DocteurPCB/SDAES/hardware/aes_connector.csv

# Connecteur de cartouche AES. Signaux d'après le wiki neogeodev (page « AES cartridge pinout »)
# numérotation officielle A/B recoupée avec les cartes AES de jwestfall69 (neogeo-diag-aes-prog
# neogeo-diag-aes-cha | fabriquées et testées ; domaine public) : face « dessus » = côté composants
# = contacts A1..A50 | face « dessous » = B1..B50 ; vu côté composants | contacts vers le bas | A1 et
# B1 sont à droite | l'un derrière l'autre (sérigraphie « A1 » des cartes SNK NEO-AEG).
# Signaux actifs à 0 sans le préfixe /.
carte | face | position | signal
PROG | dessus | 1 | GND
PROG | dessus | 2 | GND
PROG | dessus | 3 | D0
PROG | dessus | 4 | D1
PROG | dessus | 5 | D2
PROG | dessus | 6 | D3
PROG | dessus | 7 | D4
PROG | dessus | 8 | D5
PROG | dessus | 9 | D6
PROG | dessus | 10 | D7
PROG | dessus | 11 | D8
PROG | dessus | 12 | D9
PROG | dessus | 13 | D10
PROG | dessus | 14 | D11
PROG | dessus | 15 | D12
PROG | dessus | 16 | D13
PROG | dessus | 17 | D14
PROG | dessus | 18 | D15
PROG | dessus | 19 | R/W
PROG | dessus | 20 | AS
PROG | dessus | 21 | ROMOEU
PROG | dessus | 22 | ROMOEL
PROG | dessus | 23 | L_OUT
PROG | dessus | 24 | L_IN
PROG | dessus | 25 | VCC
PROG | dessus | 26 | VCC
PROG | dessus | 27 | VCC
PROG | dessus | 28 | PORTOEU
PROG | dessus | 29 | PORTOEL
PROG | dessus | 30 | PORTWEU
PROG | dessus | 31 | PORTWEL
PROG | dessus | 32 | 68KCLKB
PROG | dessus | 33 | RESET
PROG | dessus | 34 | SDPAD0
PROG | dessus | 35 | SDPAD1
PROG | dessus | 36 | SDPAD2
PROG | dessus | 37 | SDPAD3
PROG | dessus | 38 | SDPAD4
PROG | dessus | 39 | SDPAD5
PROG | dessus | 40 | SDPAD6
PROG | dessus | 41 | SDPAD7
PROG | dessus | 42 | SDPA8
PROG | dessus | 43 | SDPA9
PROG | dessus | 44 | SDPA10
PROG | dessus | 45 | SDPA11
PROG | dessus | 46 | SDPMPX
PROG | dessus | 47 | SDPOE
PROG | dessus | 48 | PORTADRS
PROG | dessus | 49 | GND
PROG | dessus | 50 | GND
PROG | dessous | 1 | GND
PROG | dessous | 2 | GND
PROG | dessous | 3 | A1
PROG | dessous | 4 | A2
PROG | dessous | 5 | A3
PROG | dessous | 6 | A4
PROG | dessous | 7 | A5
PROG | dessous | 8 | A6
PROG | dessous | 9 | A7
PROG | dessous | 10 | A8
PROG | dessous | 11 | A9
PROG | dessous | 12 | A10
PROG | dessous | 13 | A11
PROG | dessous | 14 | A12
PROG | dessous | 15 | A13
PROG | dessous | 16 | A14
PROG | dessous | 17 | A15
PROG | dessous | 18 | A16
PROG | dessous | 19 | A17
PROG | dessous | 20 | A18
PROG | dessous | 21 | A19
PROG | dessous | 22 | ROMOE
PROG | dessous | 23 | R_OUT
PROG | dessous | 24 | R_IN
PROG | dessous | 25 | VCC
PROG | dessous | 26 | VCC
PROG | dessous | 27 | VCC
PROG | dessous | 28 | ROMWAIT
PROG | dessous | 29 | PDTACK
PROG | dessous | 30 | PWAIT0
PROG | dessous | 31 | PWAIT1
PROG | dessous | 32 | SDRAD0
PROG | dessous | 33 | SDRAD1
PROG | dessous | 34 | SDRAD2
PROG | dessous | 35 | SDRAD3
PROG | dessous | 36 | SDRAD4
PROG | dessous | 37 | SDRAD5
PROG | dessous | 38 | SDRAD6
PROG | dessous | 39 | SDRAD7
PROG | dessous | 40 | SDRA8
PROG | dessous | 41 | SDRA9
PROG | dessous | 42 | SDRA20
PROG | dessous | 43 | SDRA21
PROG | dessous | 44 | SDRA22
PROG | dessous | 45 | SDRA23
PROG | dessous | 46 | SDRMPX
PROG | dessous | 47 | SDROE
PROG | dessous | 48 | 4MB
PROG | dessous | 49 | GND
PROG | dessous | 50 | GND
CHA | dessus | 1 | GND
CHA | dessus | 2 | GND
CHA | dessus | 3 | PCK1B
CHA | dessus | 4 | PCK2B
CHA | dessus | 5 | 12M
CHA | dessus | 6 | 2H1
CHA | dessus | 7 | EVEN
CHA | dessus | 8 | H
CHA | dessus | 9 | LOAD
CHA | dessus | 10 | CA4
CHA | dessus | 11 | P0
CHA | dessus | 12 | P2
CHA | dessus | 13 | P4
CHA | dessus | 14 | P6
CHA | dessus | 15 | P8
CHA | dessus | 16 | P10
CHA | dessus | 17 | P12
CHA | dessus | 18 | P14
CHA | dessus | 19 | P16
CHA | dessus | 20 | P18
CHA | dessus | 21 | P20
CHA | dessus | 22 | P22
CHA | dessus | 23 | L_OUT
CHA | dessus | 24 | L_IN
CHA | dessus | 25 | VCC
CHA | dessus | 26 | VCC
CHA | dessus | 27 | VCC
CHA | dessus | 28 | SDRD0
CHA | dessus | 29 | SDRD1
CHA | dessus | 30 | SDA0
CHA | dessus | 31 | SDA1
CHA | dessus | 32 | SDA2
CHA | dessus | 33 | SDA3
CHA | dessus | 34 | SDA4
CHA | dessus | 35 | SDA5
CHA | dessus | 36 | SDA6
CHA | dessus | 37 | SDA7
CHA | dessus | 38 | SDA8
CHA | dessus | 39 | SDA9
CHA | dessus | 40 | SDA10
CHA | dessus | 41 | SDA11
CHA | dessus | 42 | SDA12
CHA | dessus | 43 | SDA13
CHA | dessus | 44 | SDA14
CHA | dessus | 45 | SDA15
CHA | dessus | 46 | SDMRD
CHA | dessus | 47 | SDROM
CHA | dessus | 48 | 24M
CHA | dessus | 49 | GND
CHA | dessus | 50 | GND
CHA | dessous | 1 | GND
CHA | dessous | 2 | GND
CHA | dessous | 3 | FIXD0
CHA | dessous | 4 | FIXD1
CHA | dessous | 5 | FIXD2
CHA | dessous | 6 | FIXD3
CHA | dessous | 7 | FIXD4
CHA | dessous | 8 | FIXD5
CHA | dessous | 9 | FIXD6
CHA | dessous | 10 | FIXD7
CHA | dessous | 11 | P1
CHA | dessous | 12 | P3
CHA | dessous | 13 | P5
CHA | dessous | 14 | P7
CHA | dessous | 15 | P9
CHA | dessous | 16 | P11
CHA | dessous | 17 | P13
CHA | dessous | 18 | P15
CHA | dessous | 19 | P17
CHA | dessous | 20 | P19
CHA | dessous | 21 | P21
CHA | dessous | 22 | P23
CHA | dessous | 23 | R_OUT
CHA | dessous | 24 | R_IN
CHA | dessous | 25 | VCC
CHA | dessous | 26 | VCC
CHA | dessous | 27 | VCC
CHA | dessous | 28 | NC
CHA | dessous | 29 | NC
CHA | dessous | 30 | DOTA
CHA | dessous | 31 | DOTB
CHA | dessous | 32 | GAD0
CHA | dessous | 33 | GAD1
CHA | dessous | 34 | GAD2
CHA | dessous | 35 | GAD3
CHA | dessous | 36 | GBD0
CHA | dessous | 37 | GBD1
CHA | dessous | 38 | GBD2
CHA | dessous | 39 | GBD3
CHA | dessous | 40 | SDD0
CHA | dessous | 41 | SDD1
CHA | dessous | 42 | SDD2
CHA | dessous | 43 | SDD3
CHA | dessous | 44 | SDD4
CHA | dessous | 45 | SDD5
CHA | dessous | 46 | SDD6
CHA | dessous | 47 | SDD7
CHA | dessous | 48 | 8M
CHA | dessous | 49 | GND
CHA | dessous | 50 | GND
