DocteurPCB/SDAES/hardware/kicad/sdaes_cha.pdf

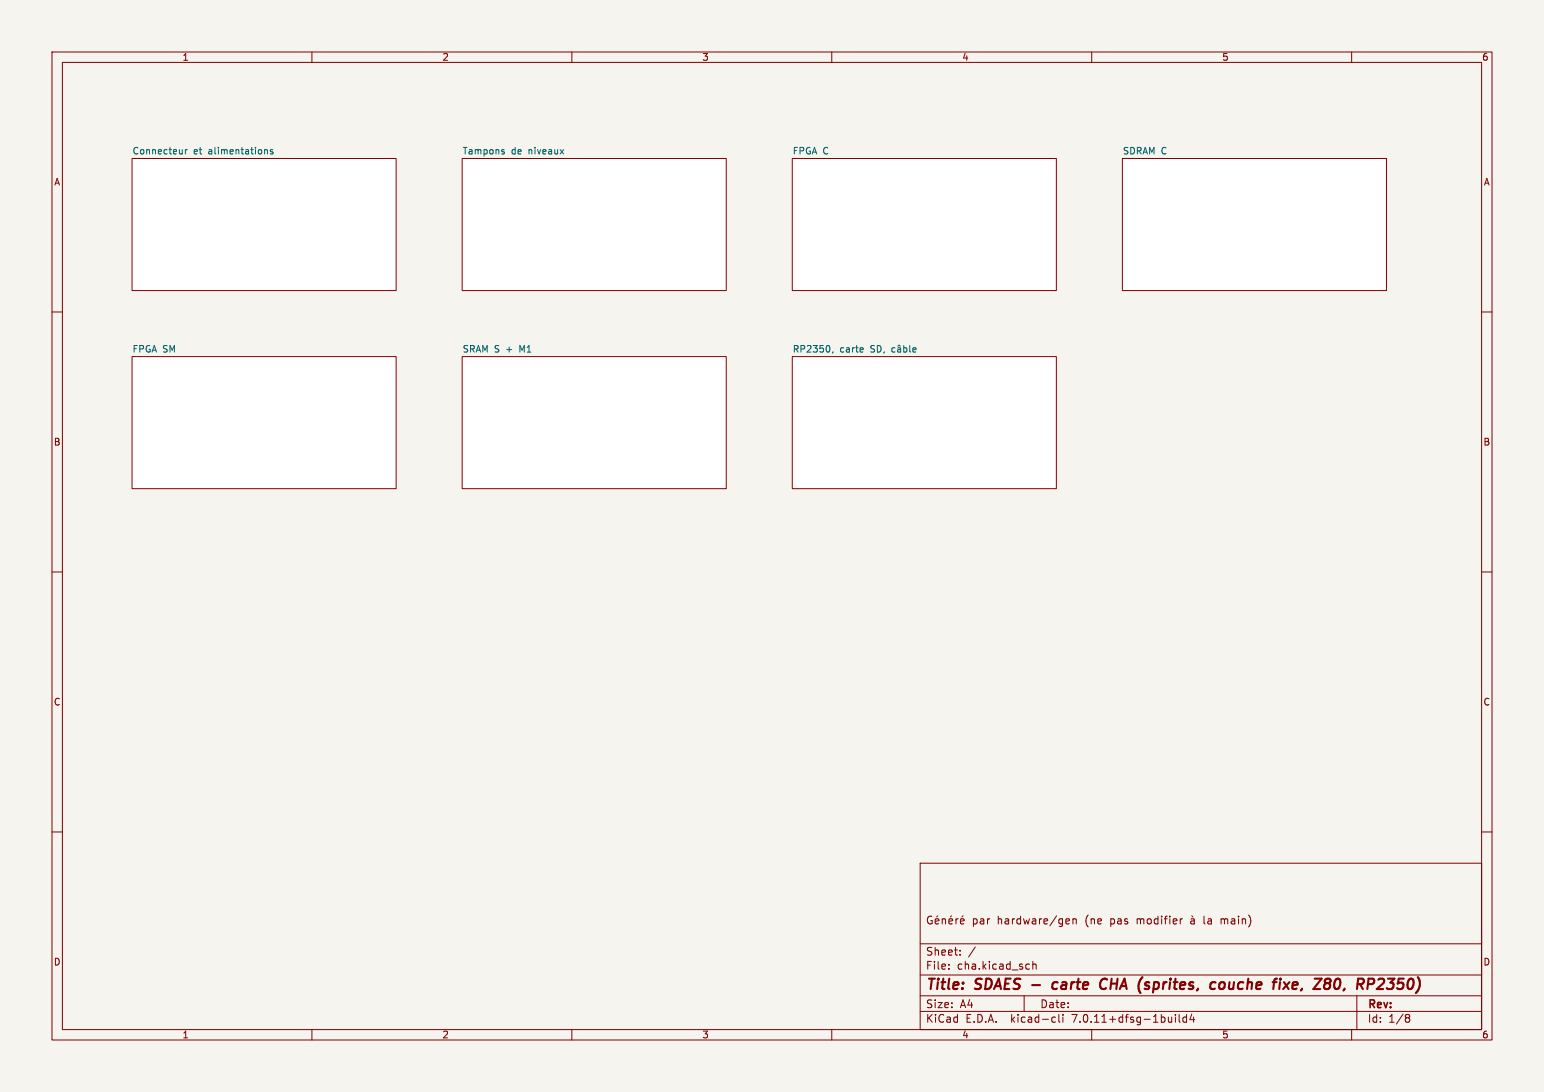
[picture p1: page 1]

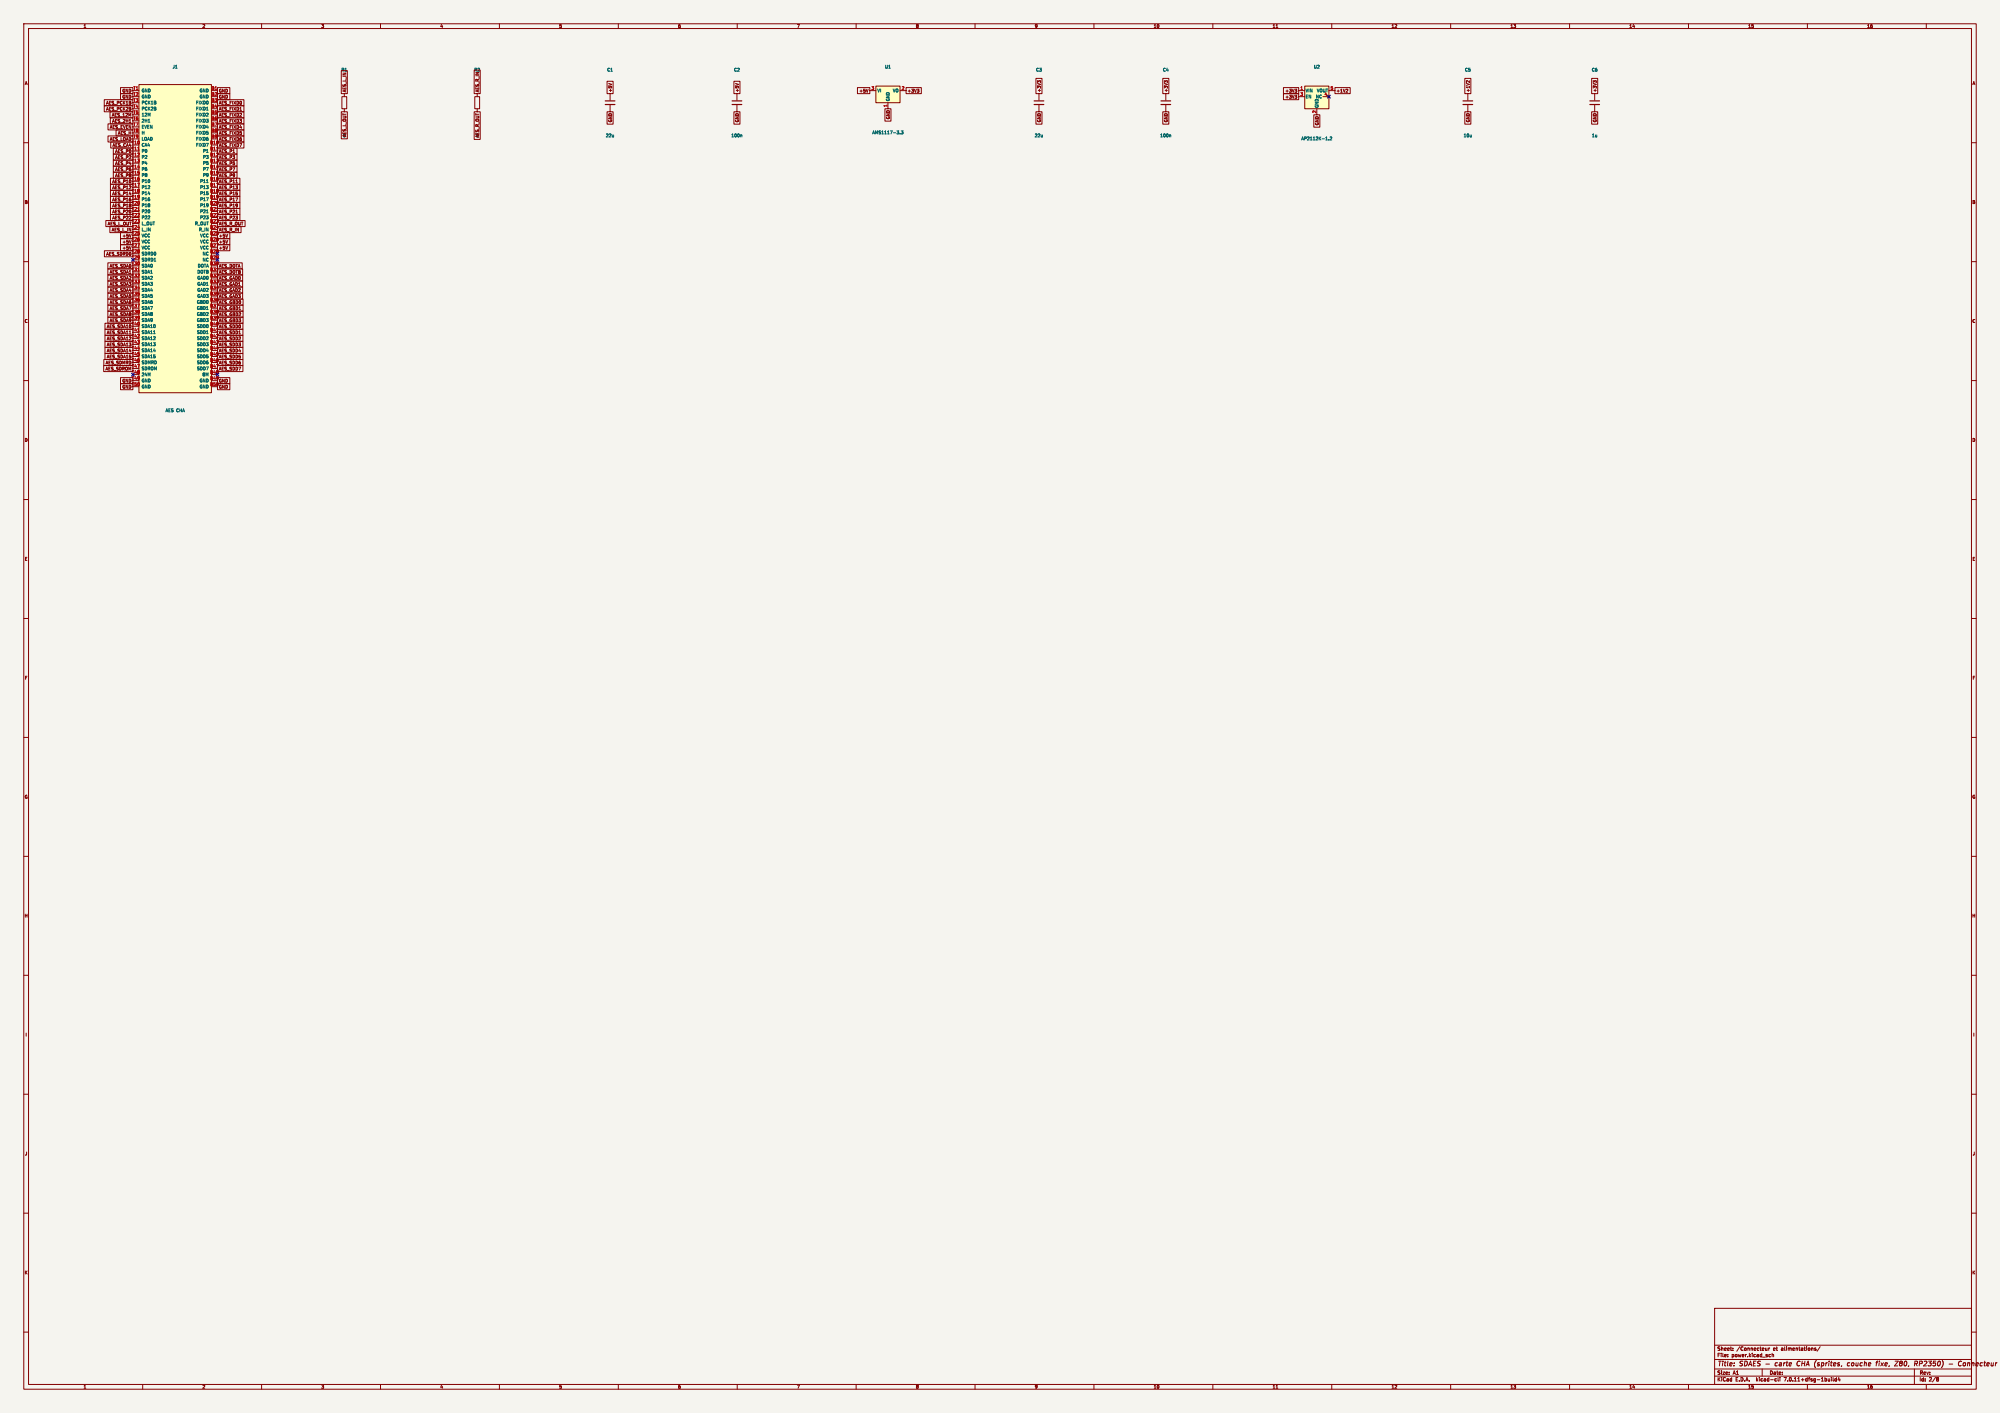
[picture p2: page 2]

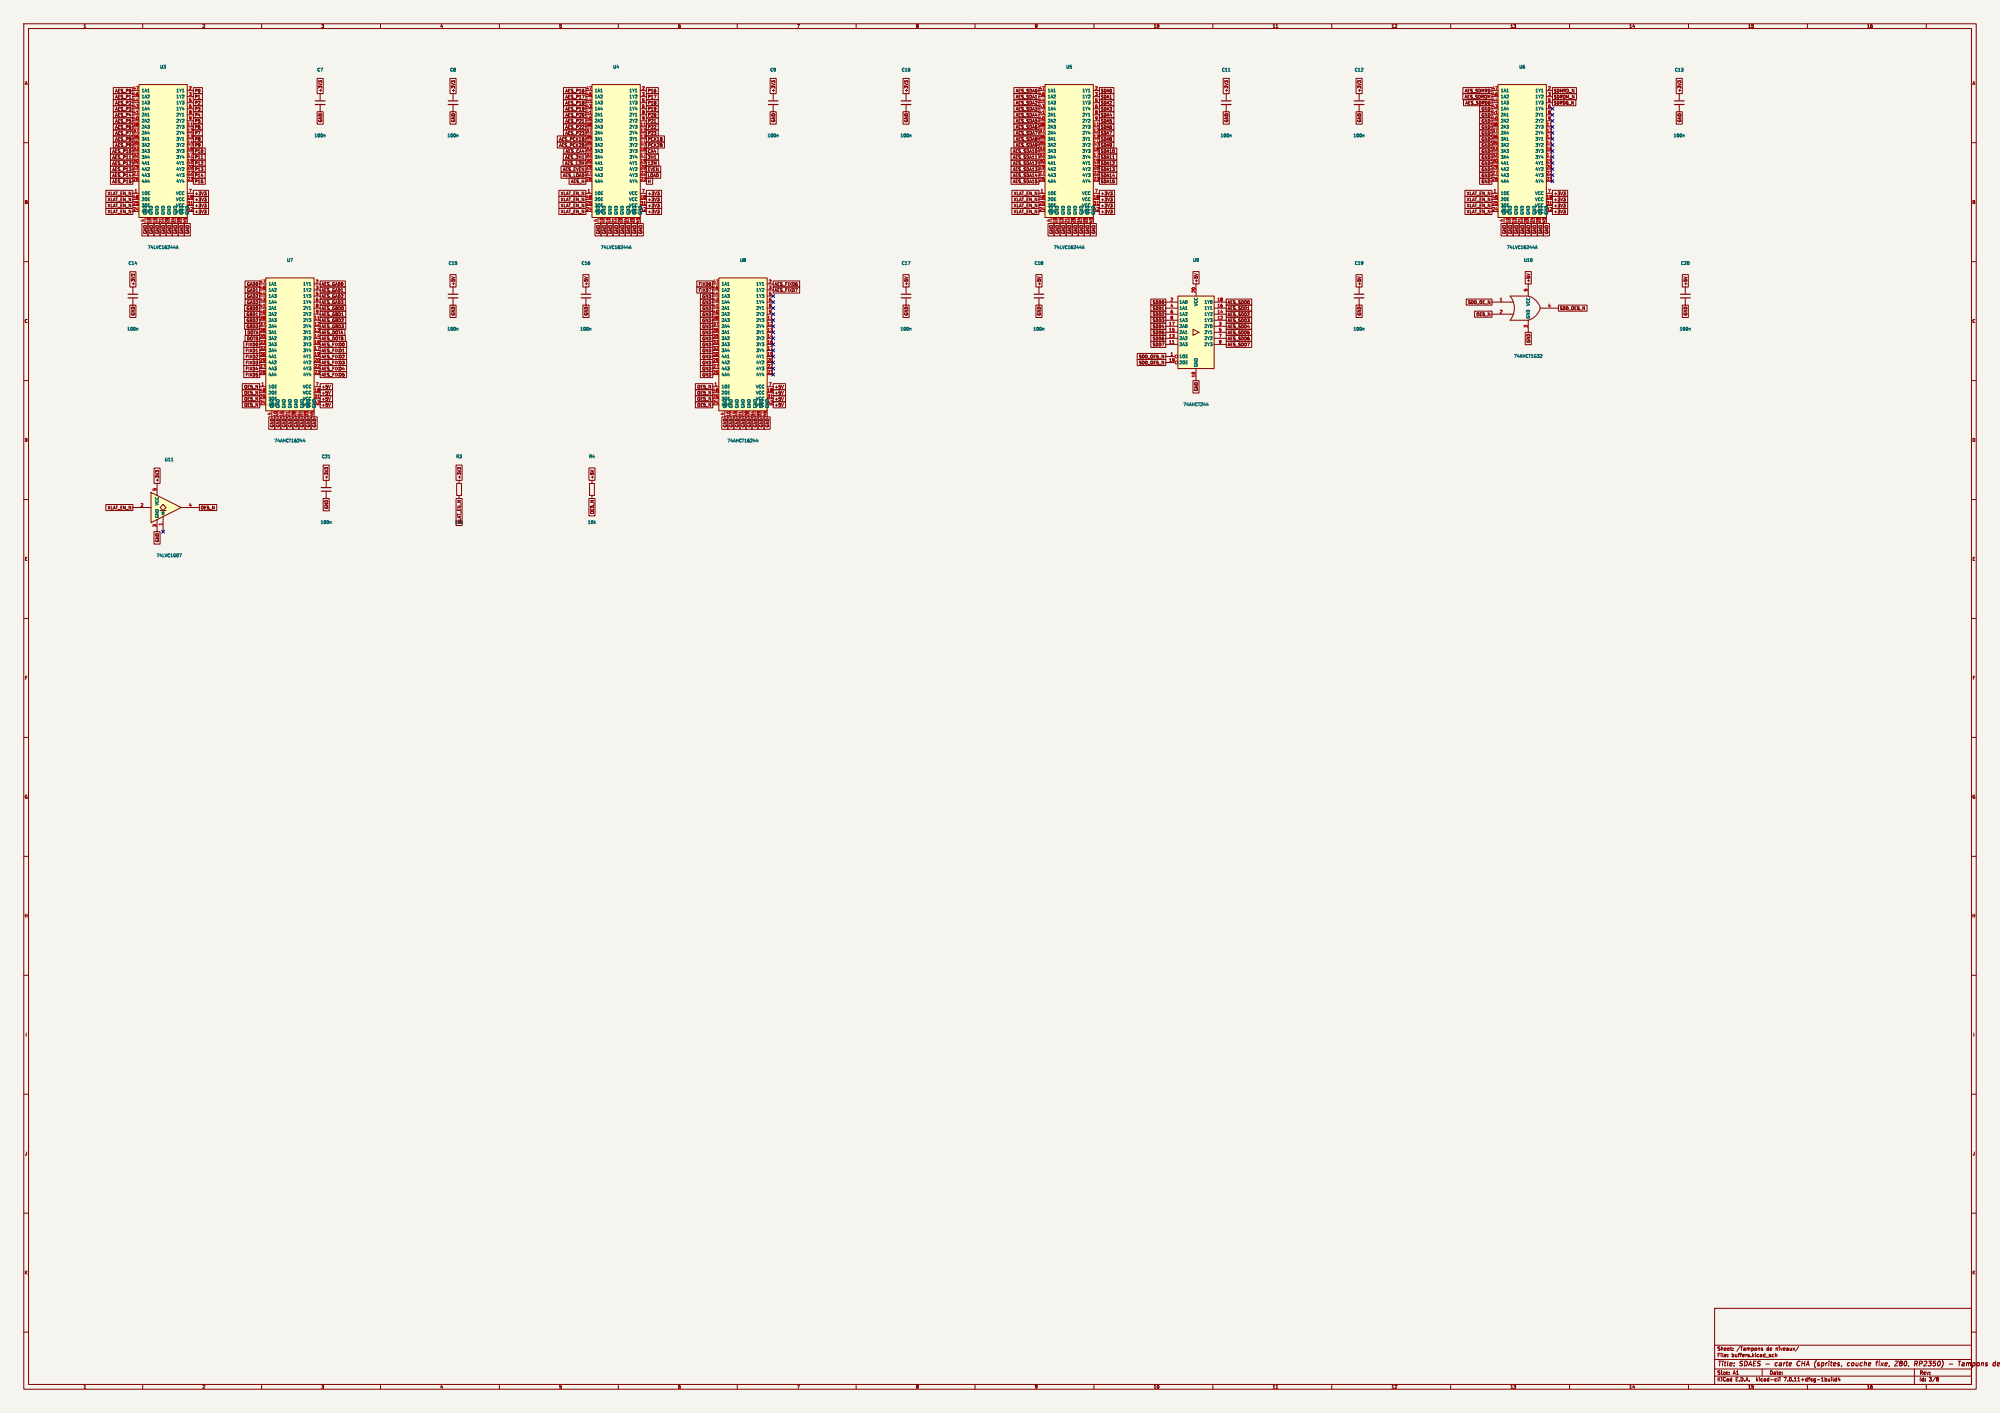
[picture p3: page 3]

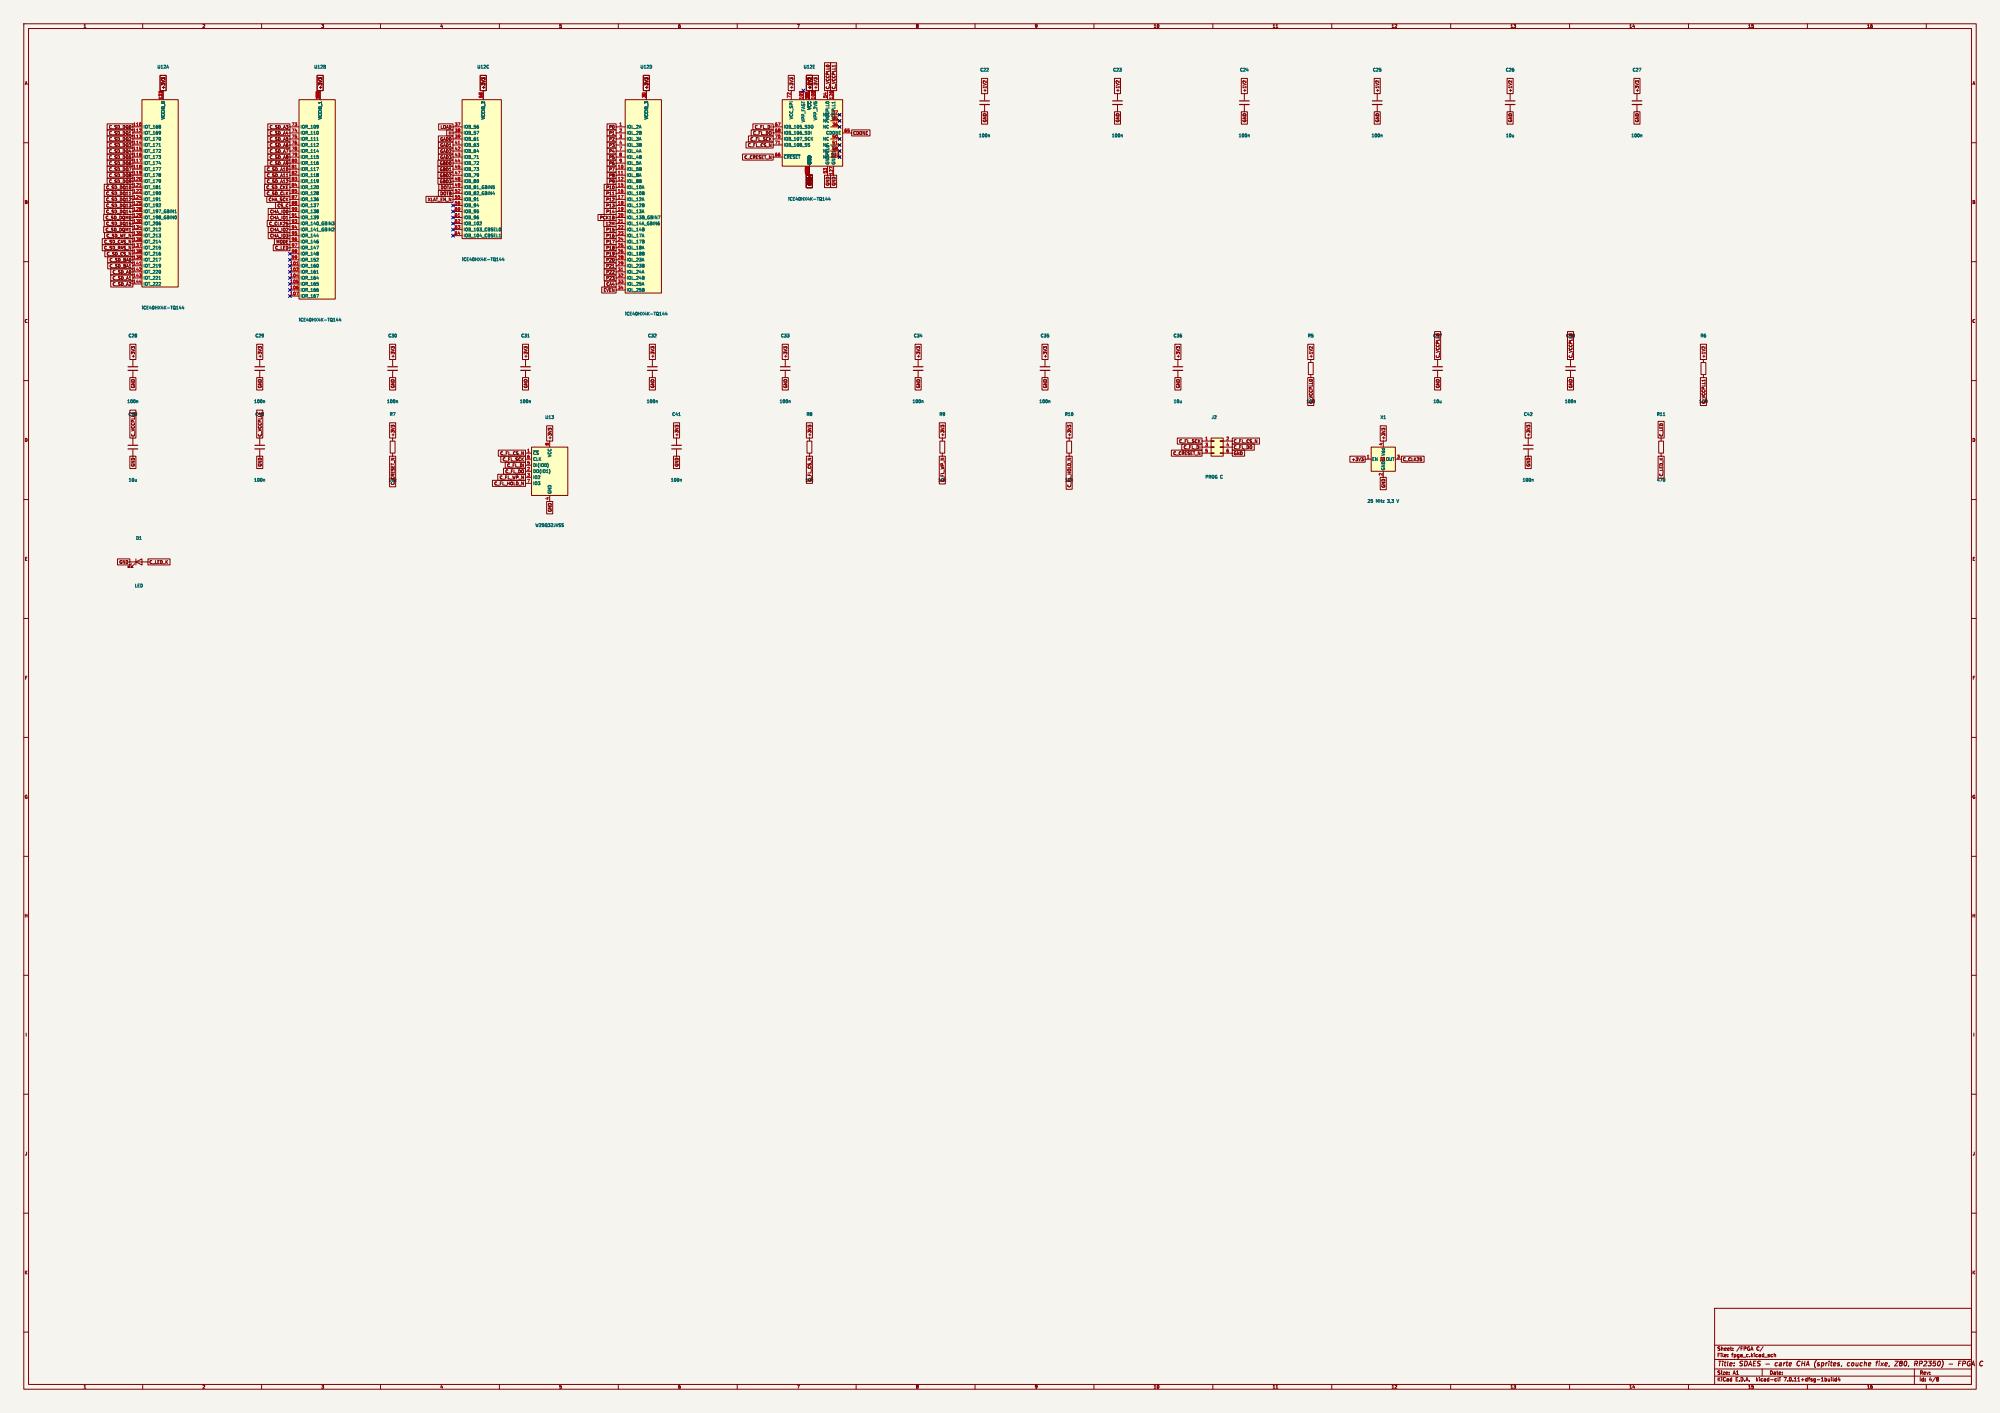
[picture p4: page 4]

8 U13 W25Q32JVSS GND 103 VPP_2V5 108 VPP_FAST 109 VCC 111 VCCPLL1 126 GNDPLL1 127 GND 13 132 NC 133 14 140 VCC 27 NC 35 NC 36 VCC 40 GND

5 NC 50 NC 51 GNDPLL0 53 VCCPLL0 54 NC 58 GND 59 CDONE

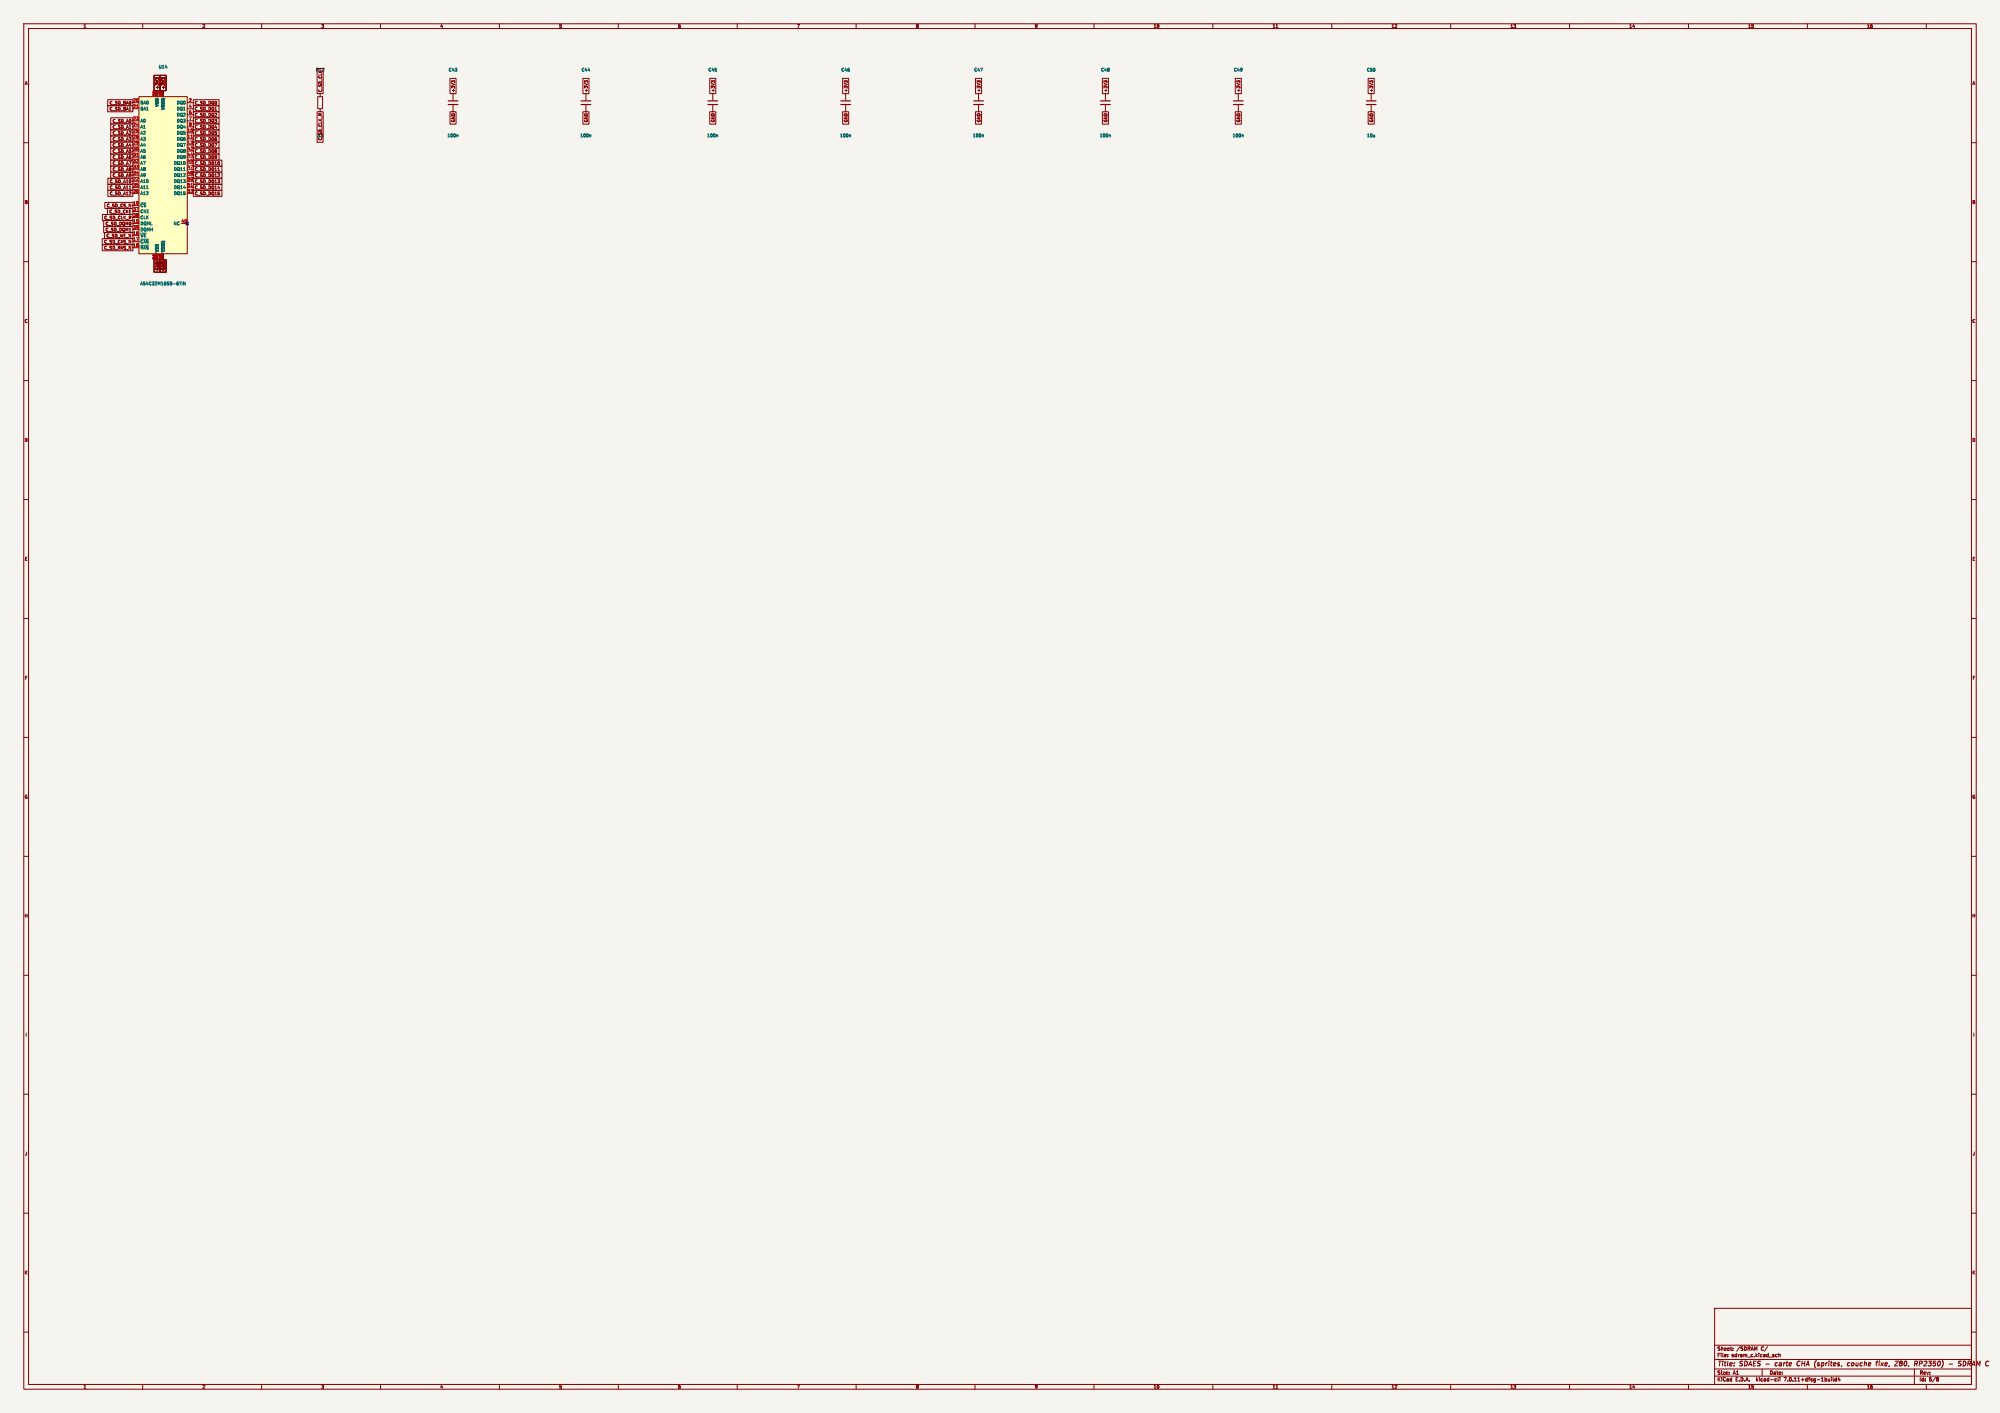
[picture p5: page 5]

1 DQ5 10 DQ6 11 VSSQ 12 DQ7 13 VDD 14 DQML 15 ~{WE} 16 ~{CAS} 17 ~{RAS} 18 ~{CS} 19 DQ0 2 BA0 20 BA1 21 A10 22 A0 23 A1 24 A2 25 A3 26 VDD 27 VSS 28 A4 29 VDDQ

3 A5 30 A6 31 A7 32 A8 33 A9 34 A11 35 A12 36 CKE 37 CLK 38 DQMH 39 DQ1 4 NC 40 VSS 41 DQ8 42 VDDQ 43 DQ9 44 DQ10 45 VSSQ 46 DQ11 47 DQ12 48 VDDQ 49 DQ2 5 DQ13 50 DQ14 51 VSSQ 52 DQ15 53 VSS 54 VSSQ

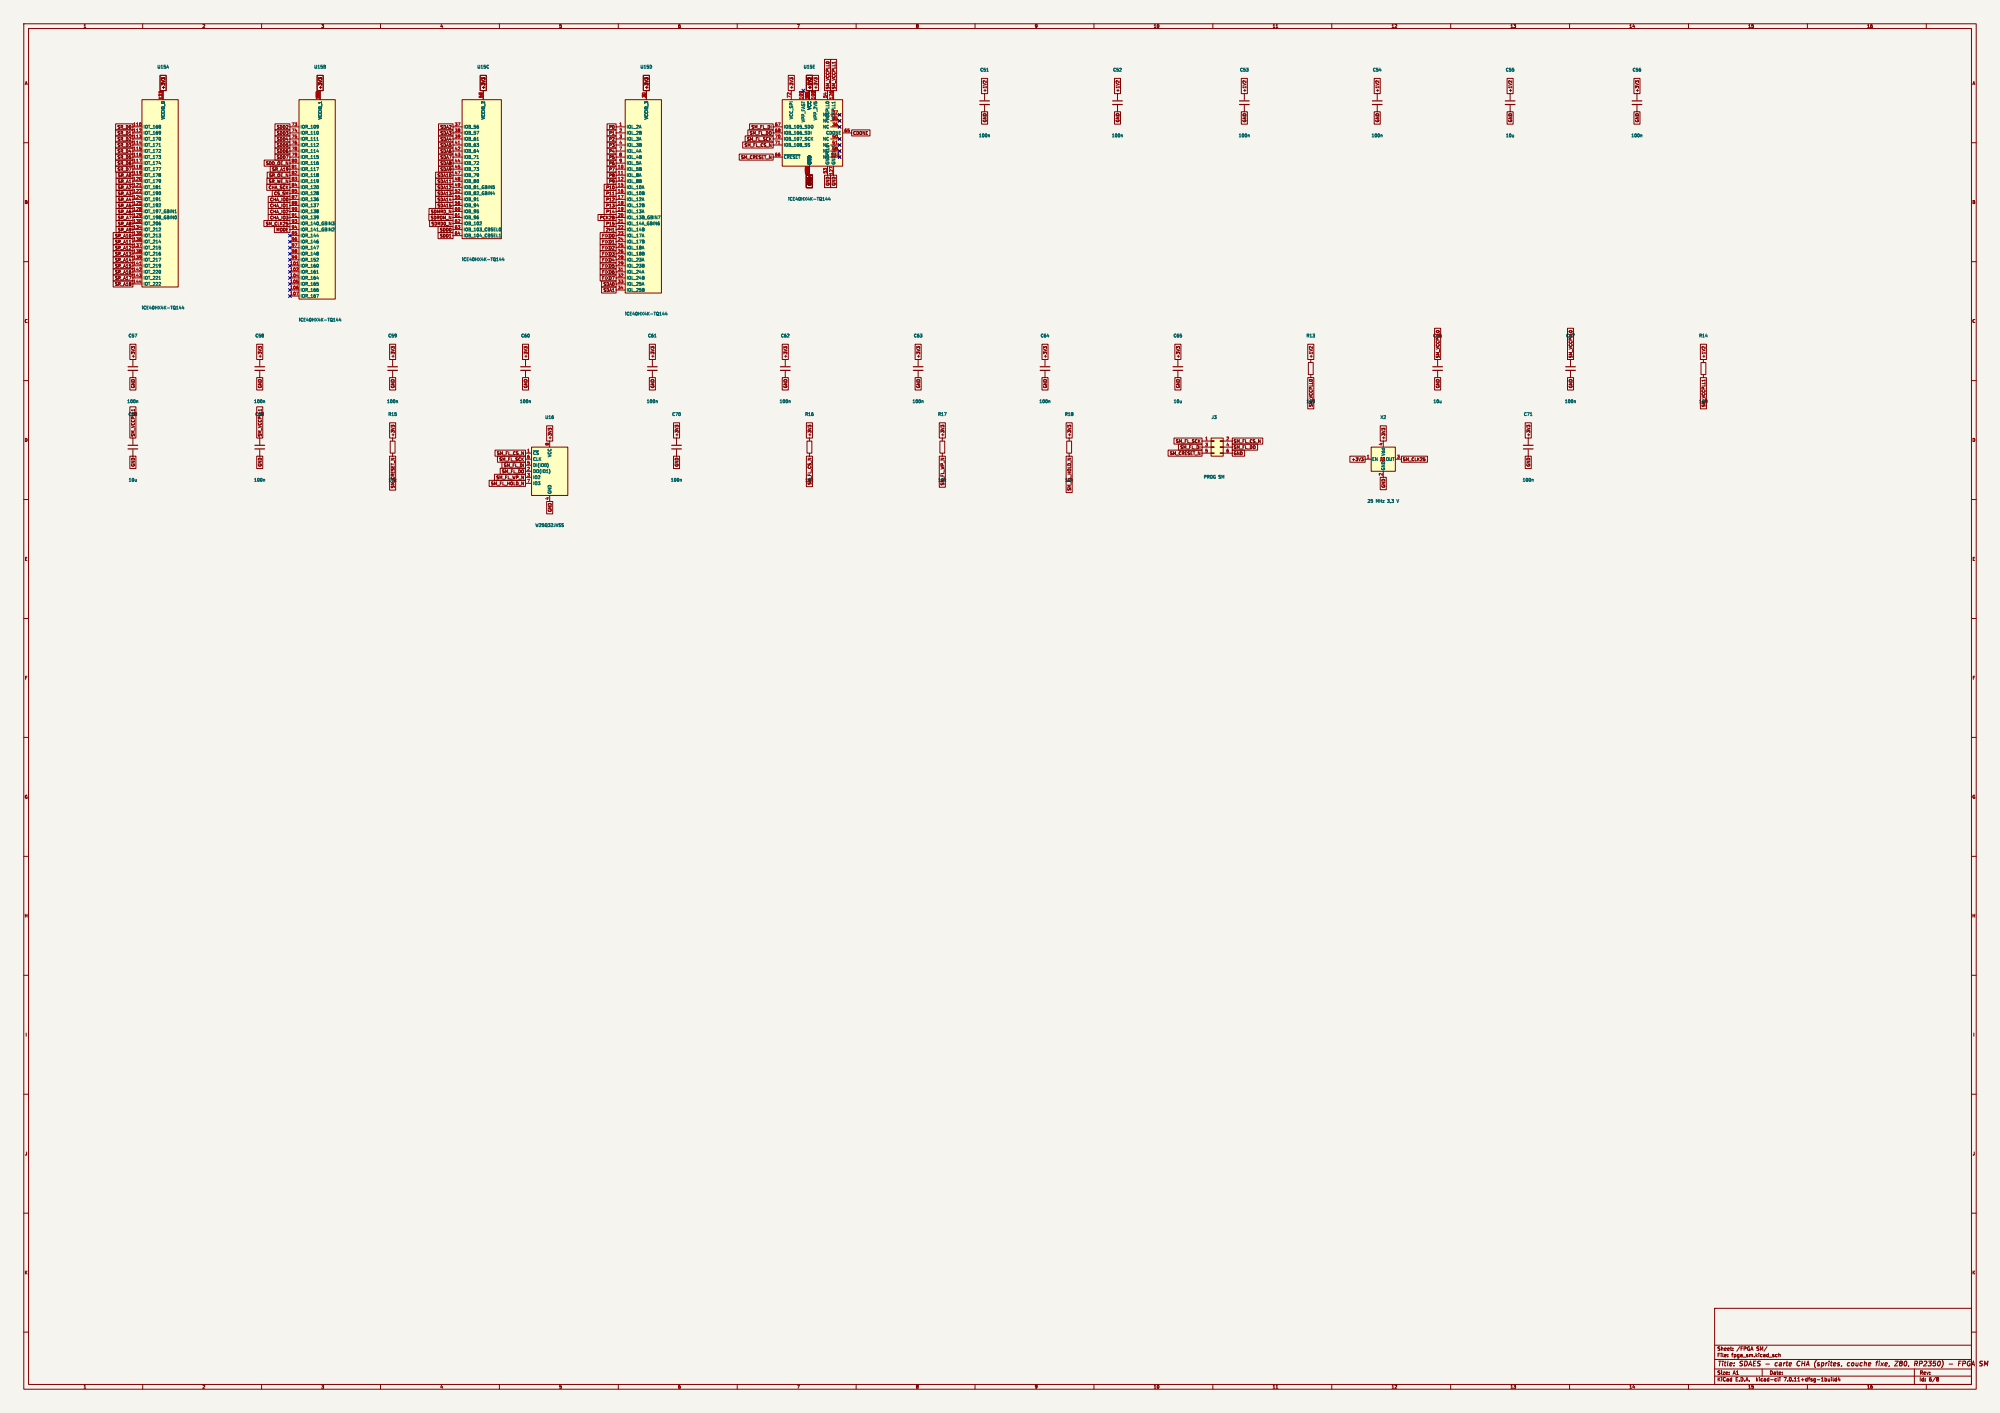
[picture p6: page 6]

5 NC 50 NC 51 GNDPLL0 53 VCCPLL0 54 NC 58 GND 59 CDONE

File: fpga_sm.kicad_sch Sheet: /FPGA SM/

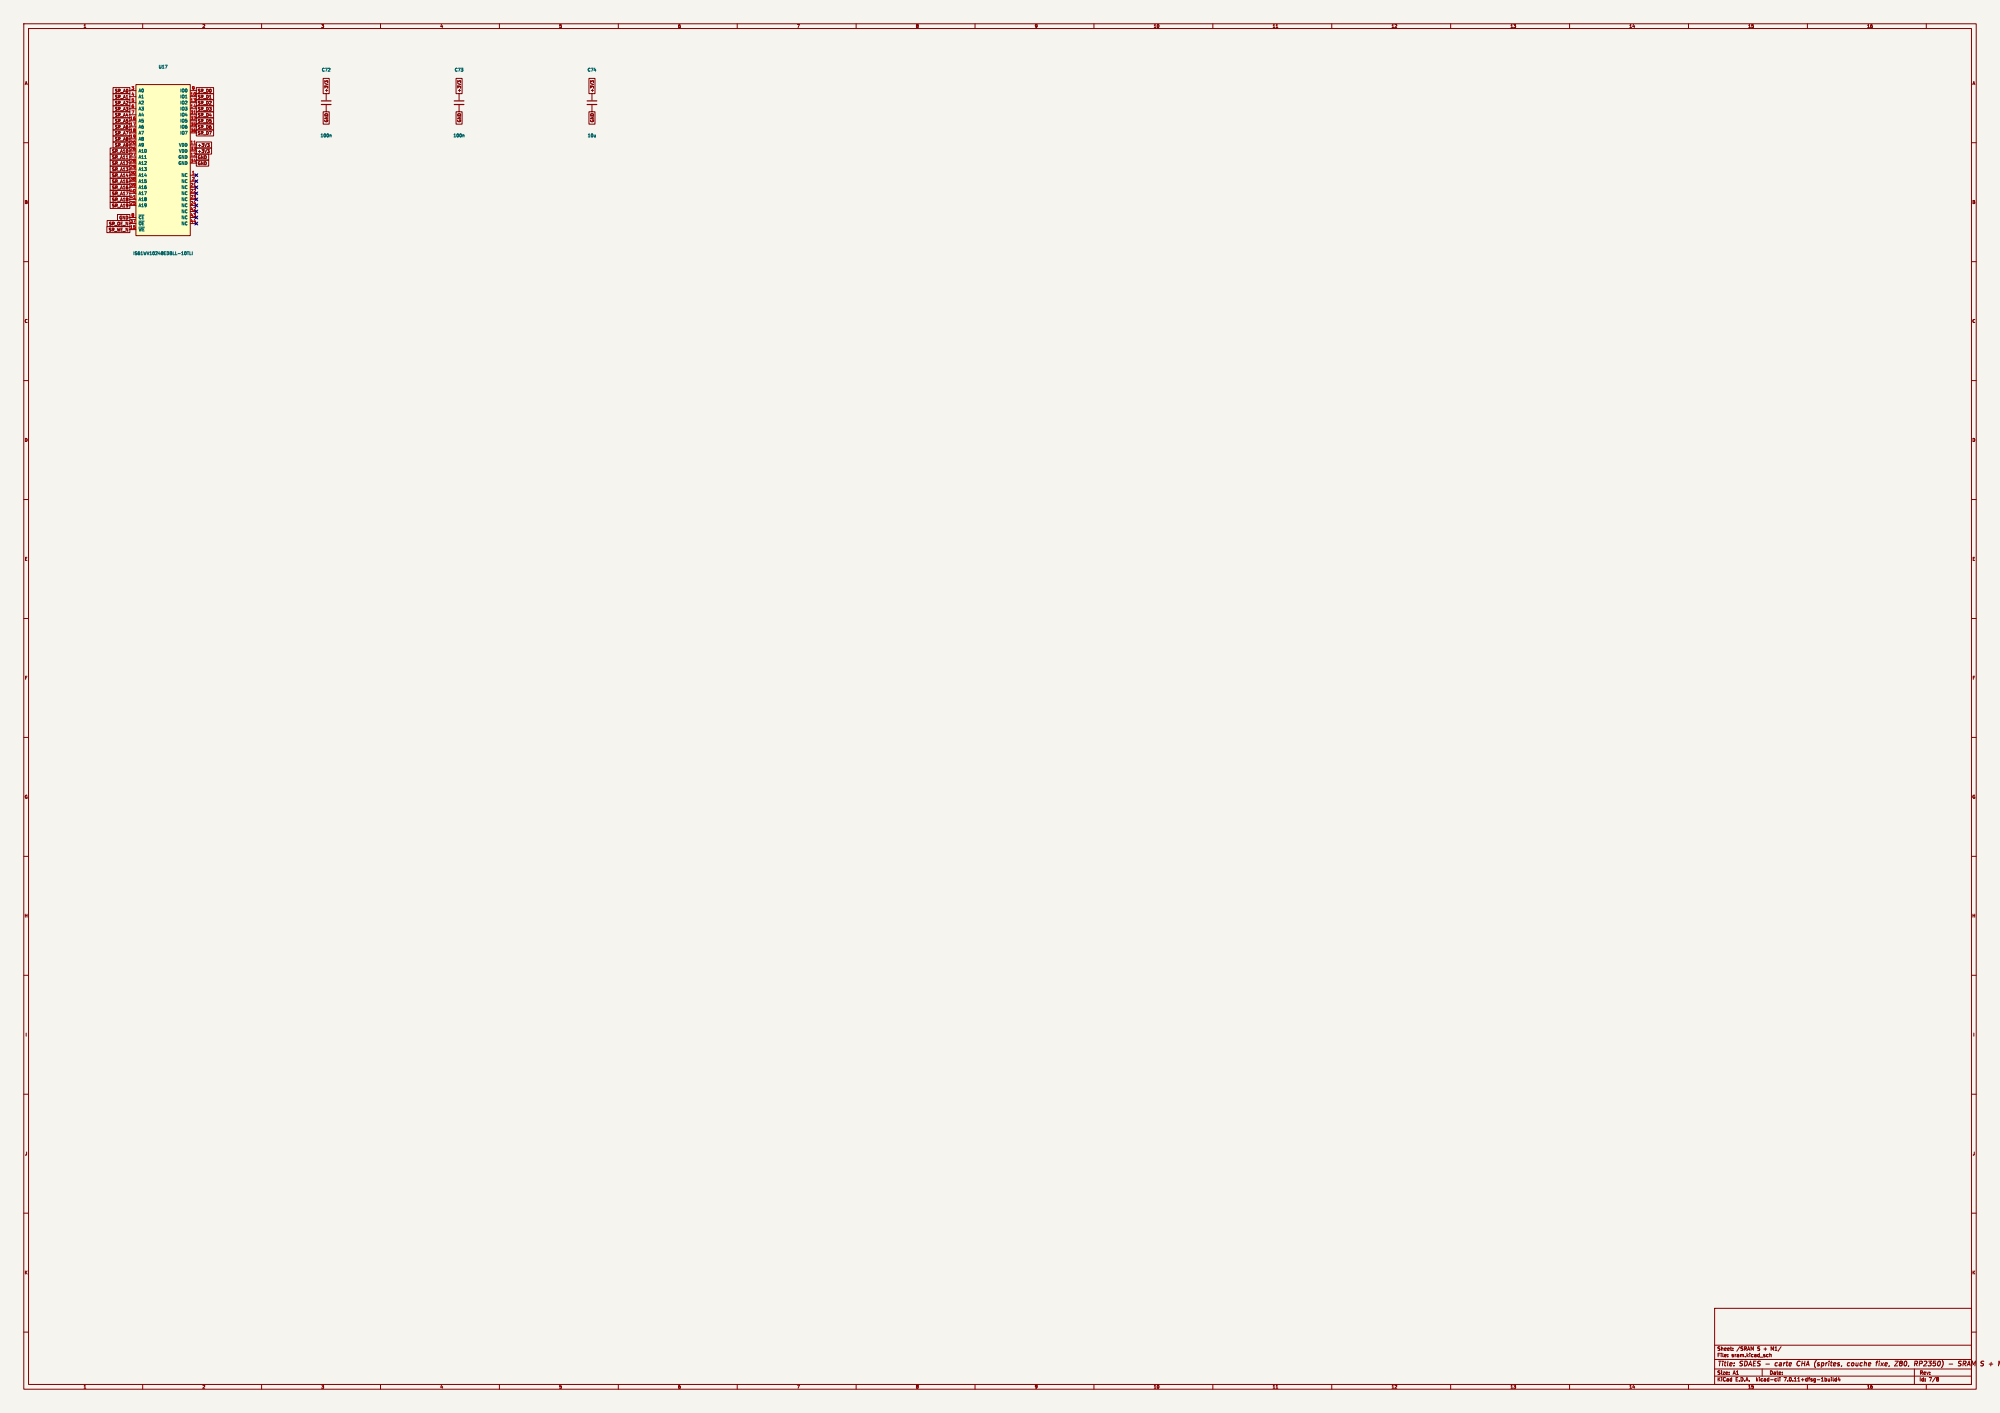
[picture p7: page 7]

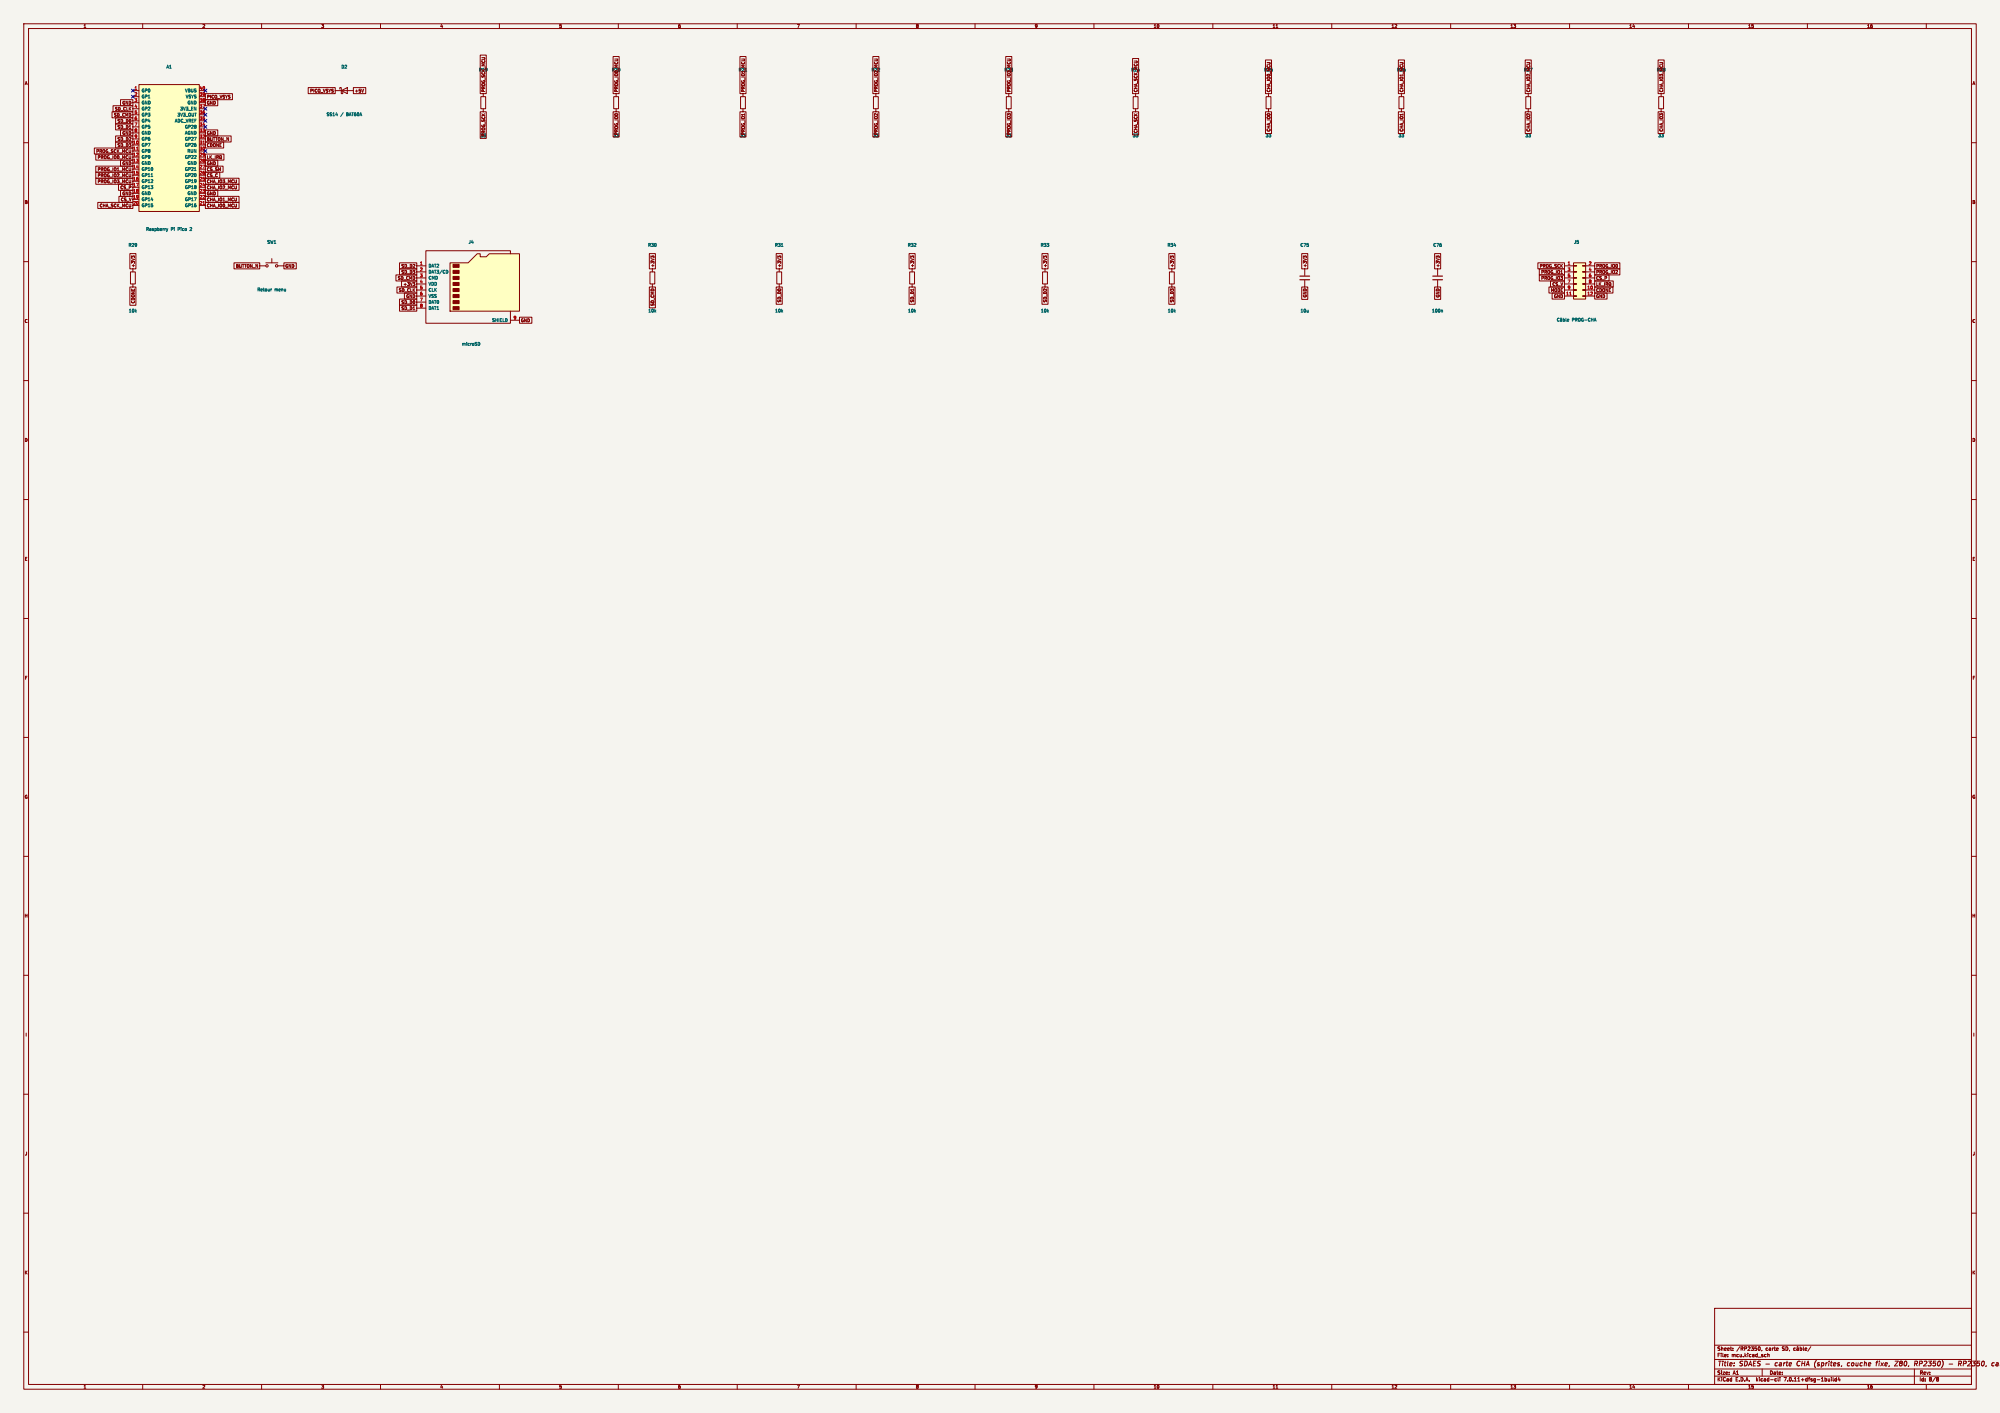
[picture p8: page 8]

SD_CLK GND GND GND GND
