DocteurPCB/SDAES/hardware/kicad/sdaes_prog.pdf

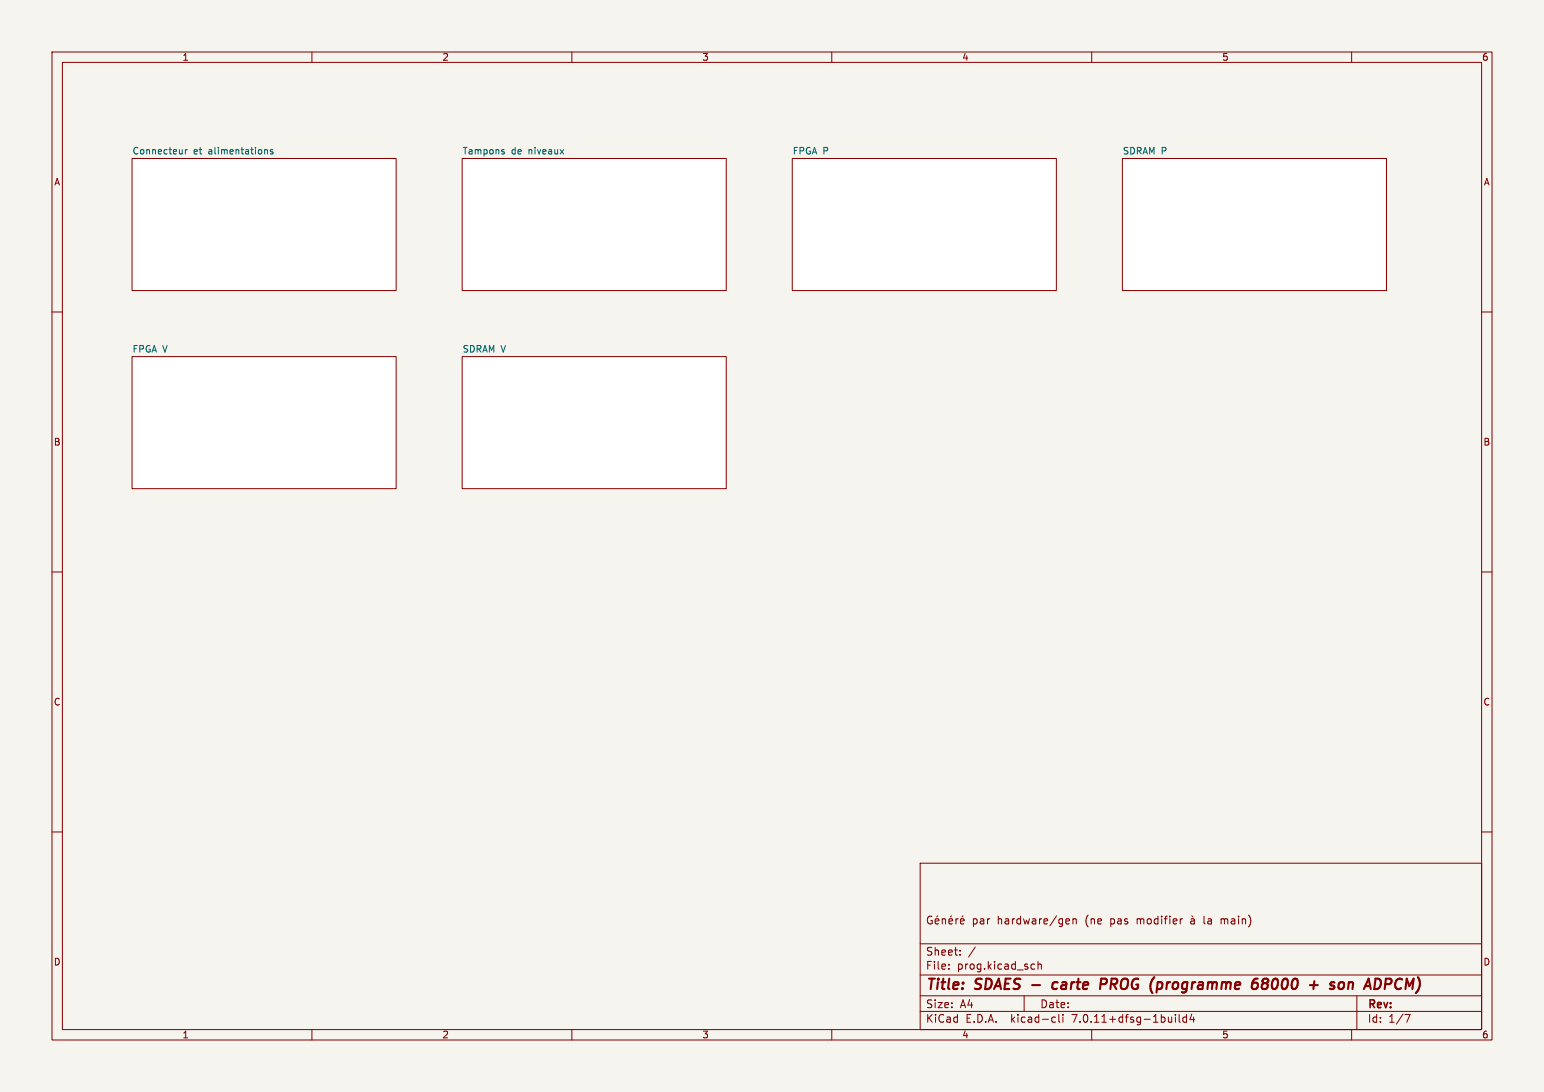
[picture p9: page 1]

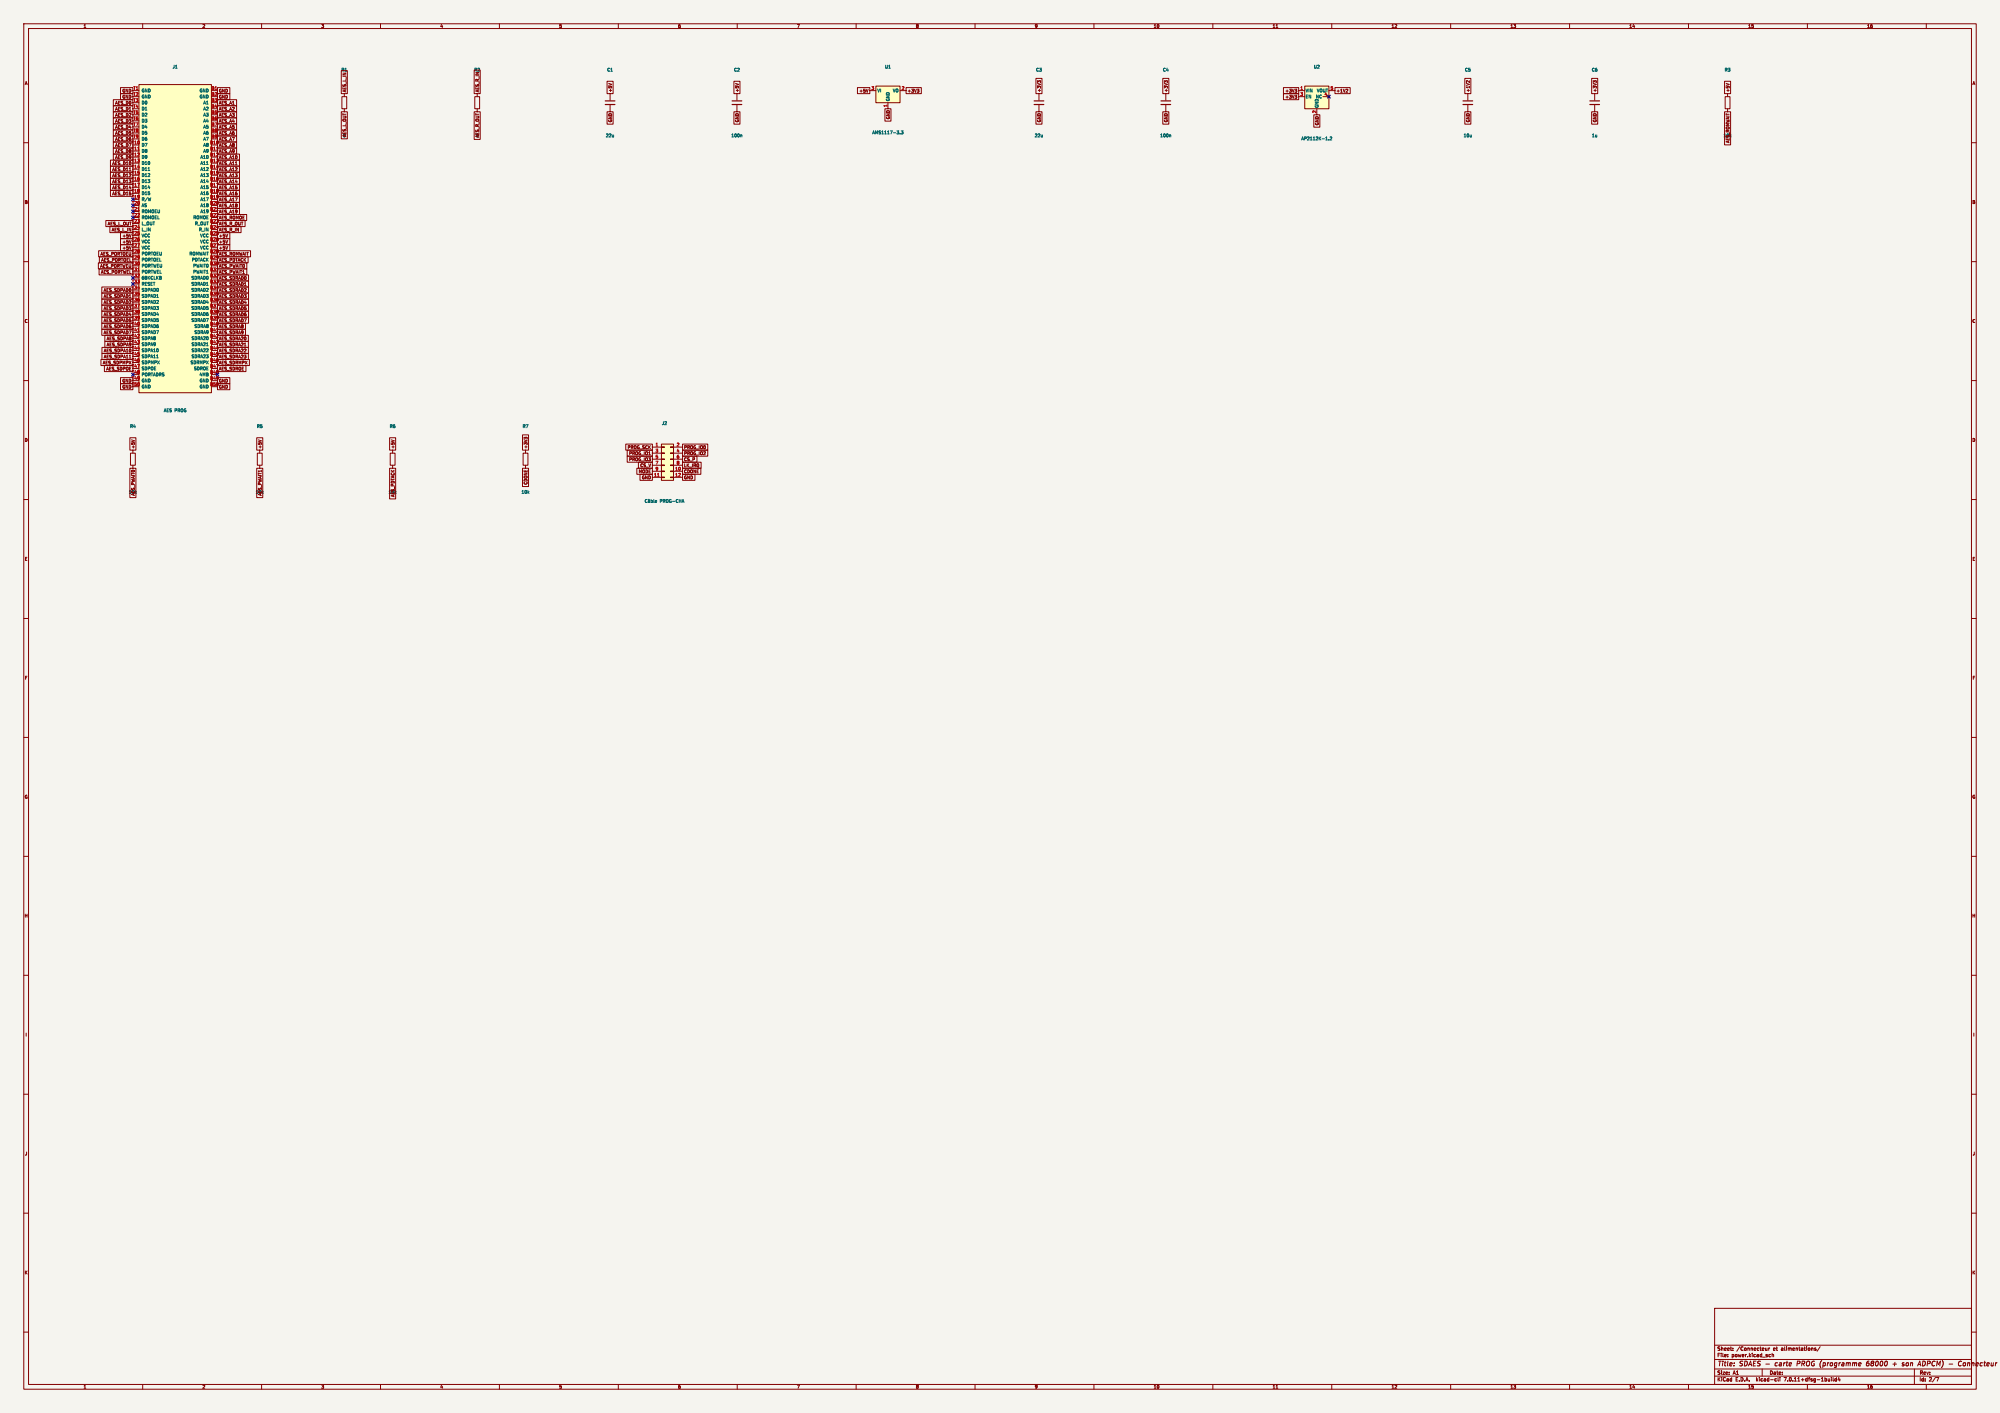
[picture p10: page 2]

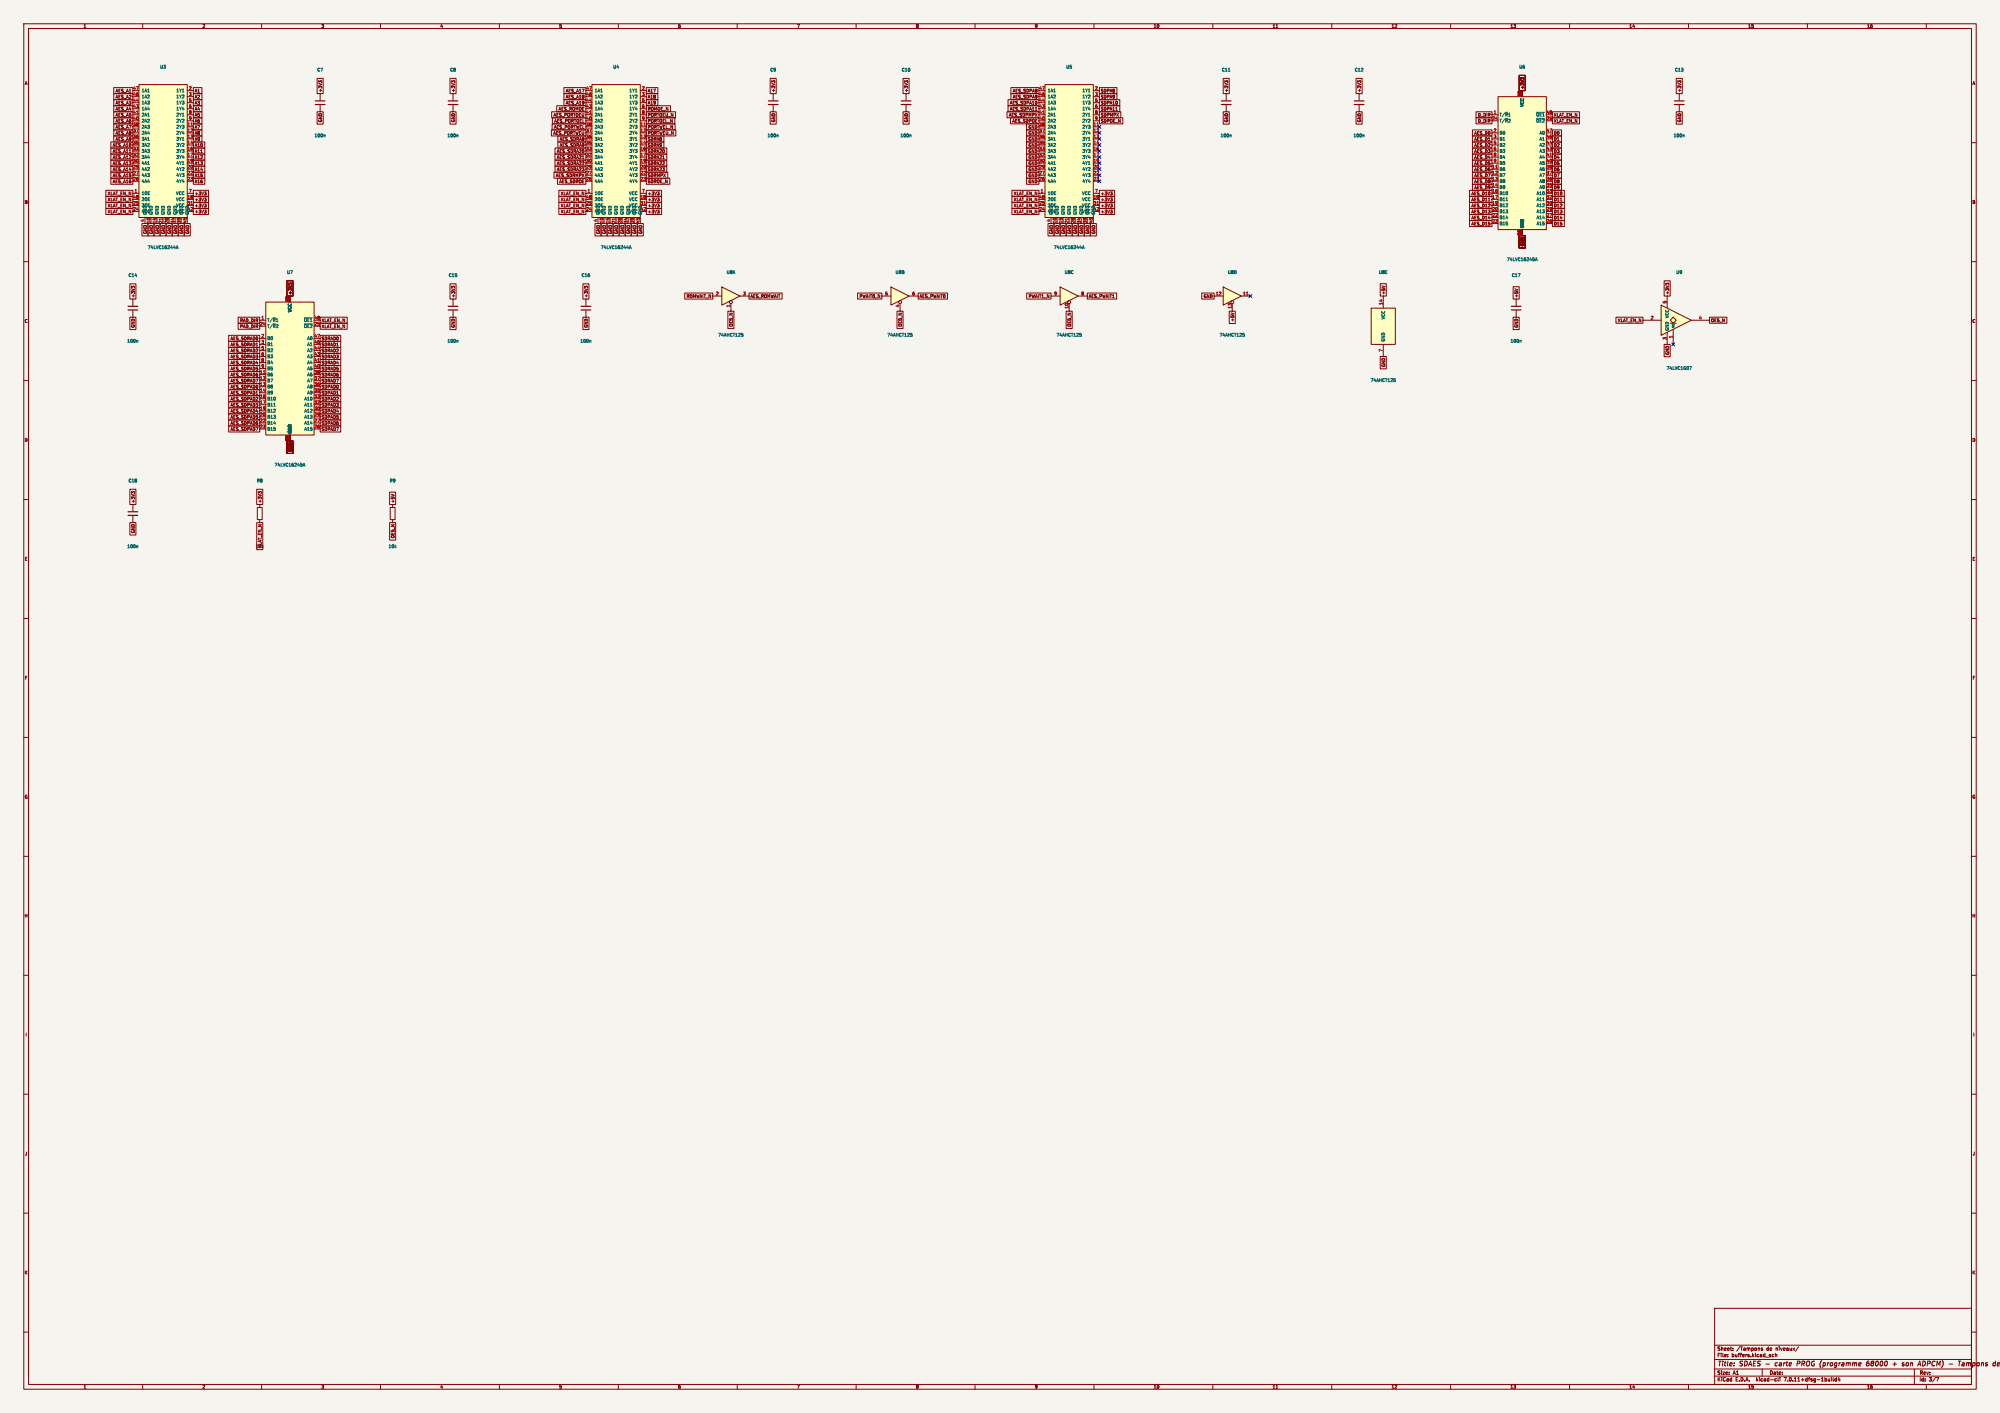
[picture p11: page 3]

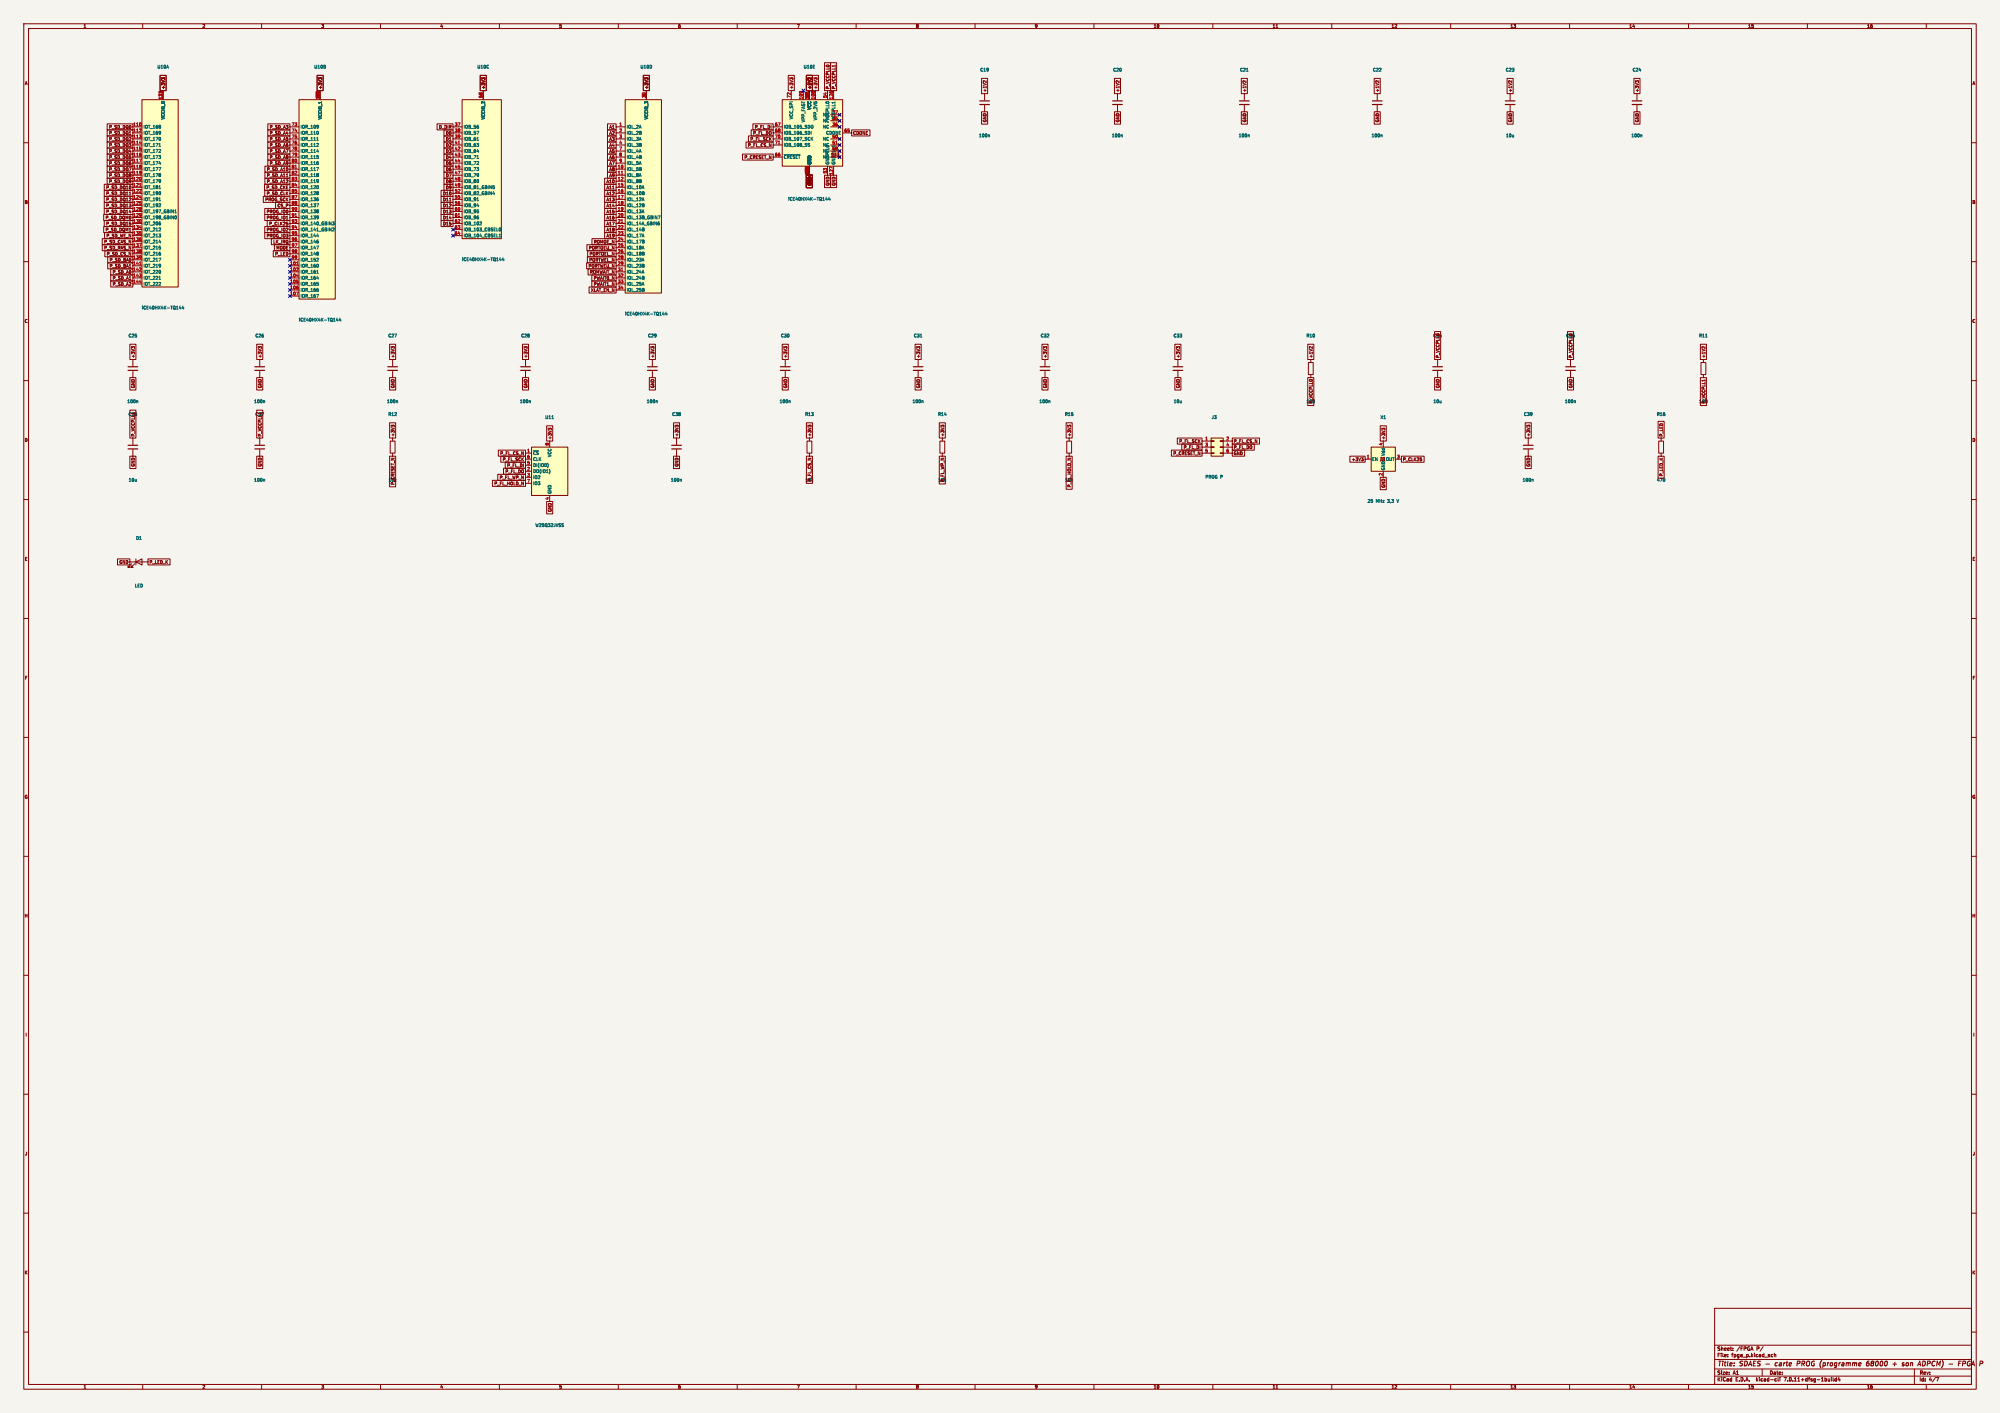
[picture p12: page 4]

5 NC 50 NC 51 GNDPLL0 53 VCCPLL0 54 NC 58 GND 59 CDONE

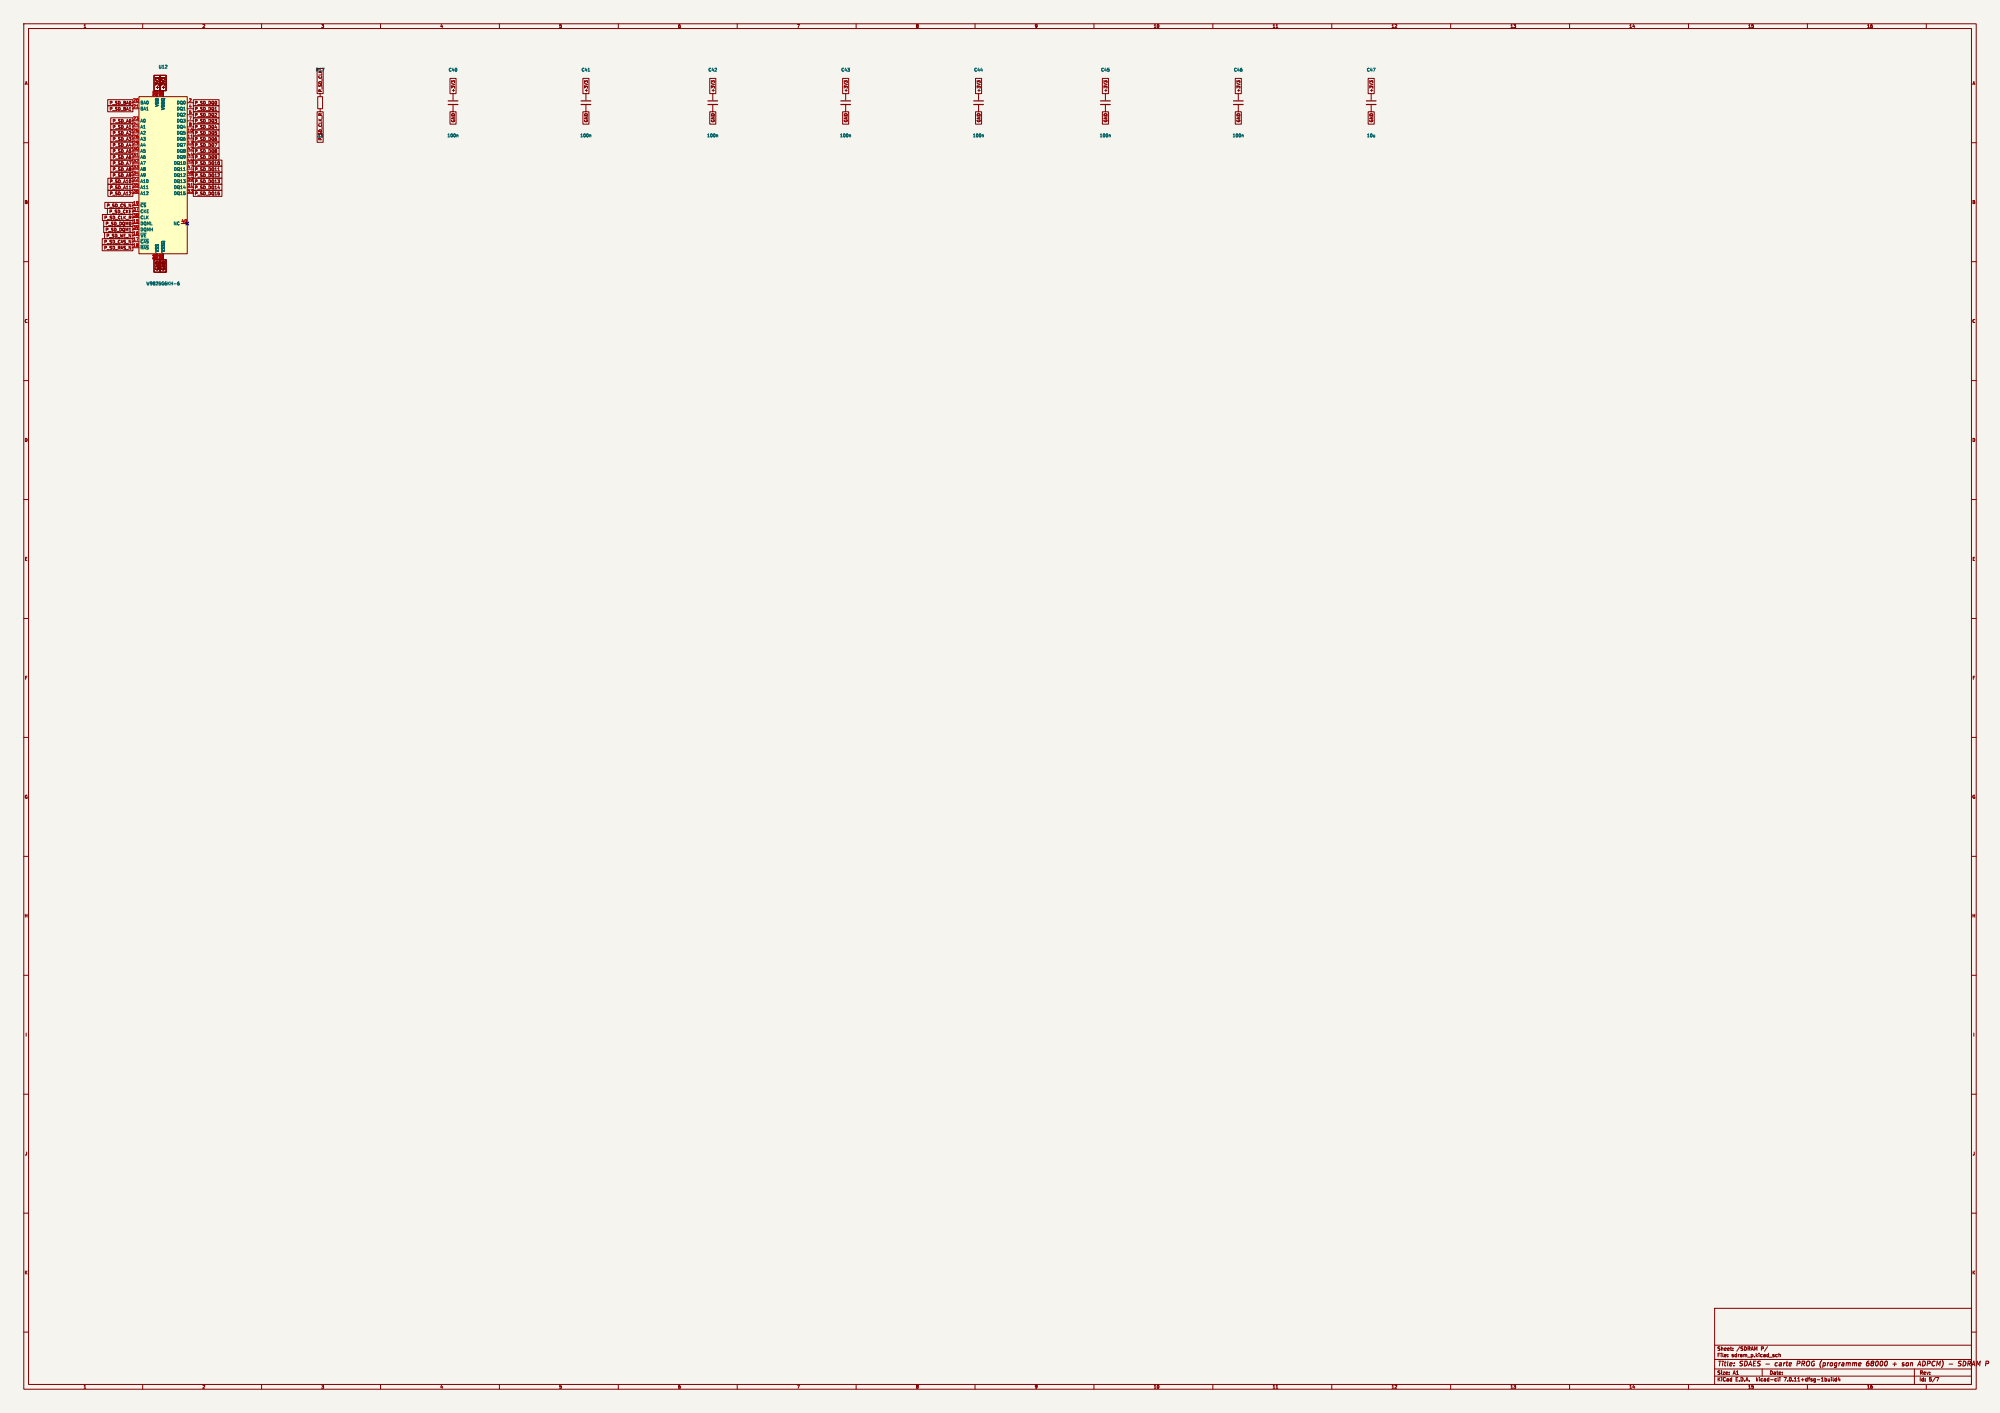
[picture p13: page 5]

1 DQ5 10 DQ6 11 VSSQ 12 DQ7 13 VDD 14 DQML 15 ~{WE} 16 ~{CAS} 17 ~{RAS} 18 ~{CS} 19 DQ0 2 BA0 20 BA1 21 A10 22 A0 23 A1 24 A2 25 A3 26 VDD 27 VSS 28 A4 29 VDDQ

3 A5 30 A6 31 A7 32 A8 33 A9 34 A11 35 A12 36 CKE 37 CLK 38 DQMH 39 DQ1 4 NC 40 VSS 41 DQ8 42 VDDQ 43 DQ9 44 DQ10 45 VSSQ 46 DQ11 47 DQ12 48 VDDQ 49 DQ2 5 DQ13 50 DQ14 51 VSSQ 52 DQ15 53 VSS 54 VSSQ

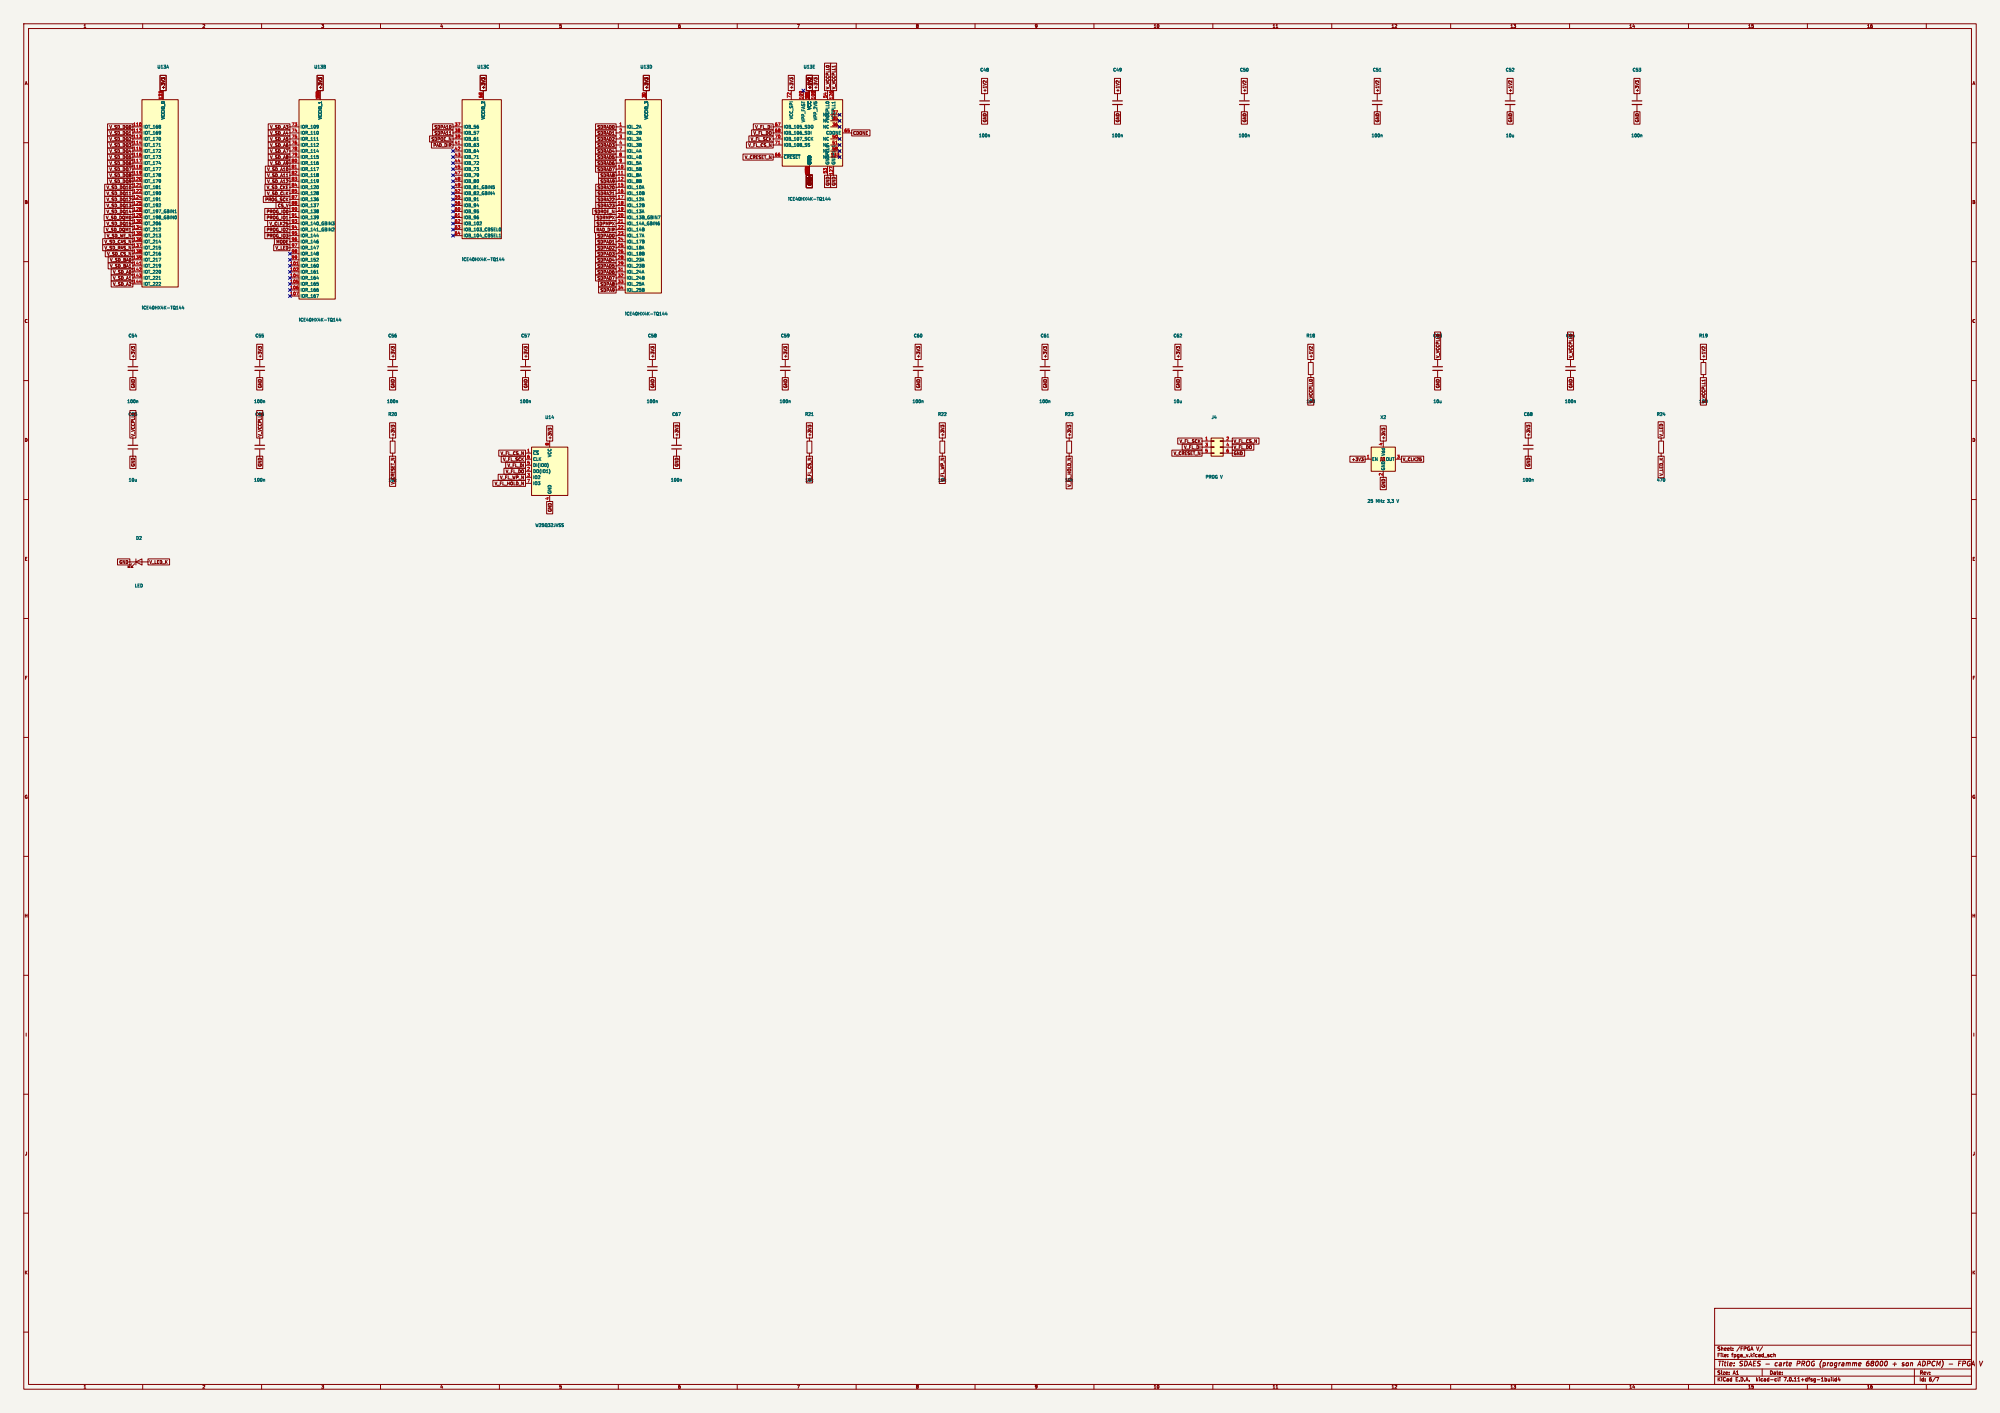
[picture p14: page 6]

5 NC 50 NC 51 GNDPLL0 53 VCCPLL0 54 NC 58 GND 59 CDONE

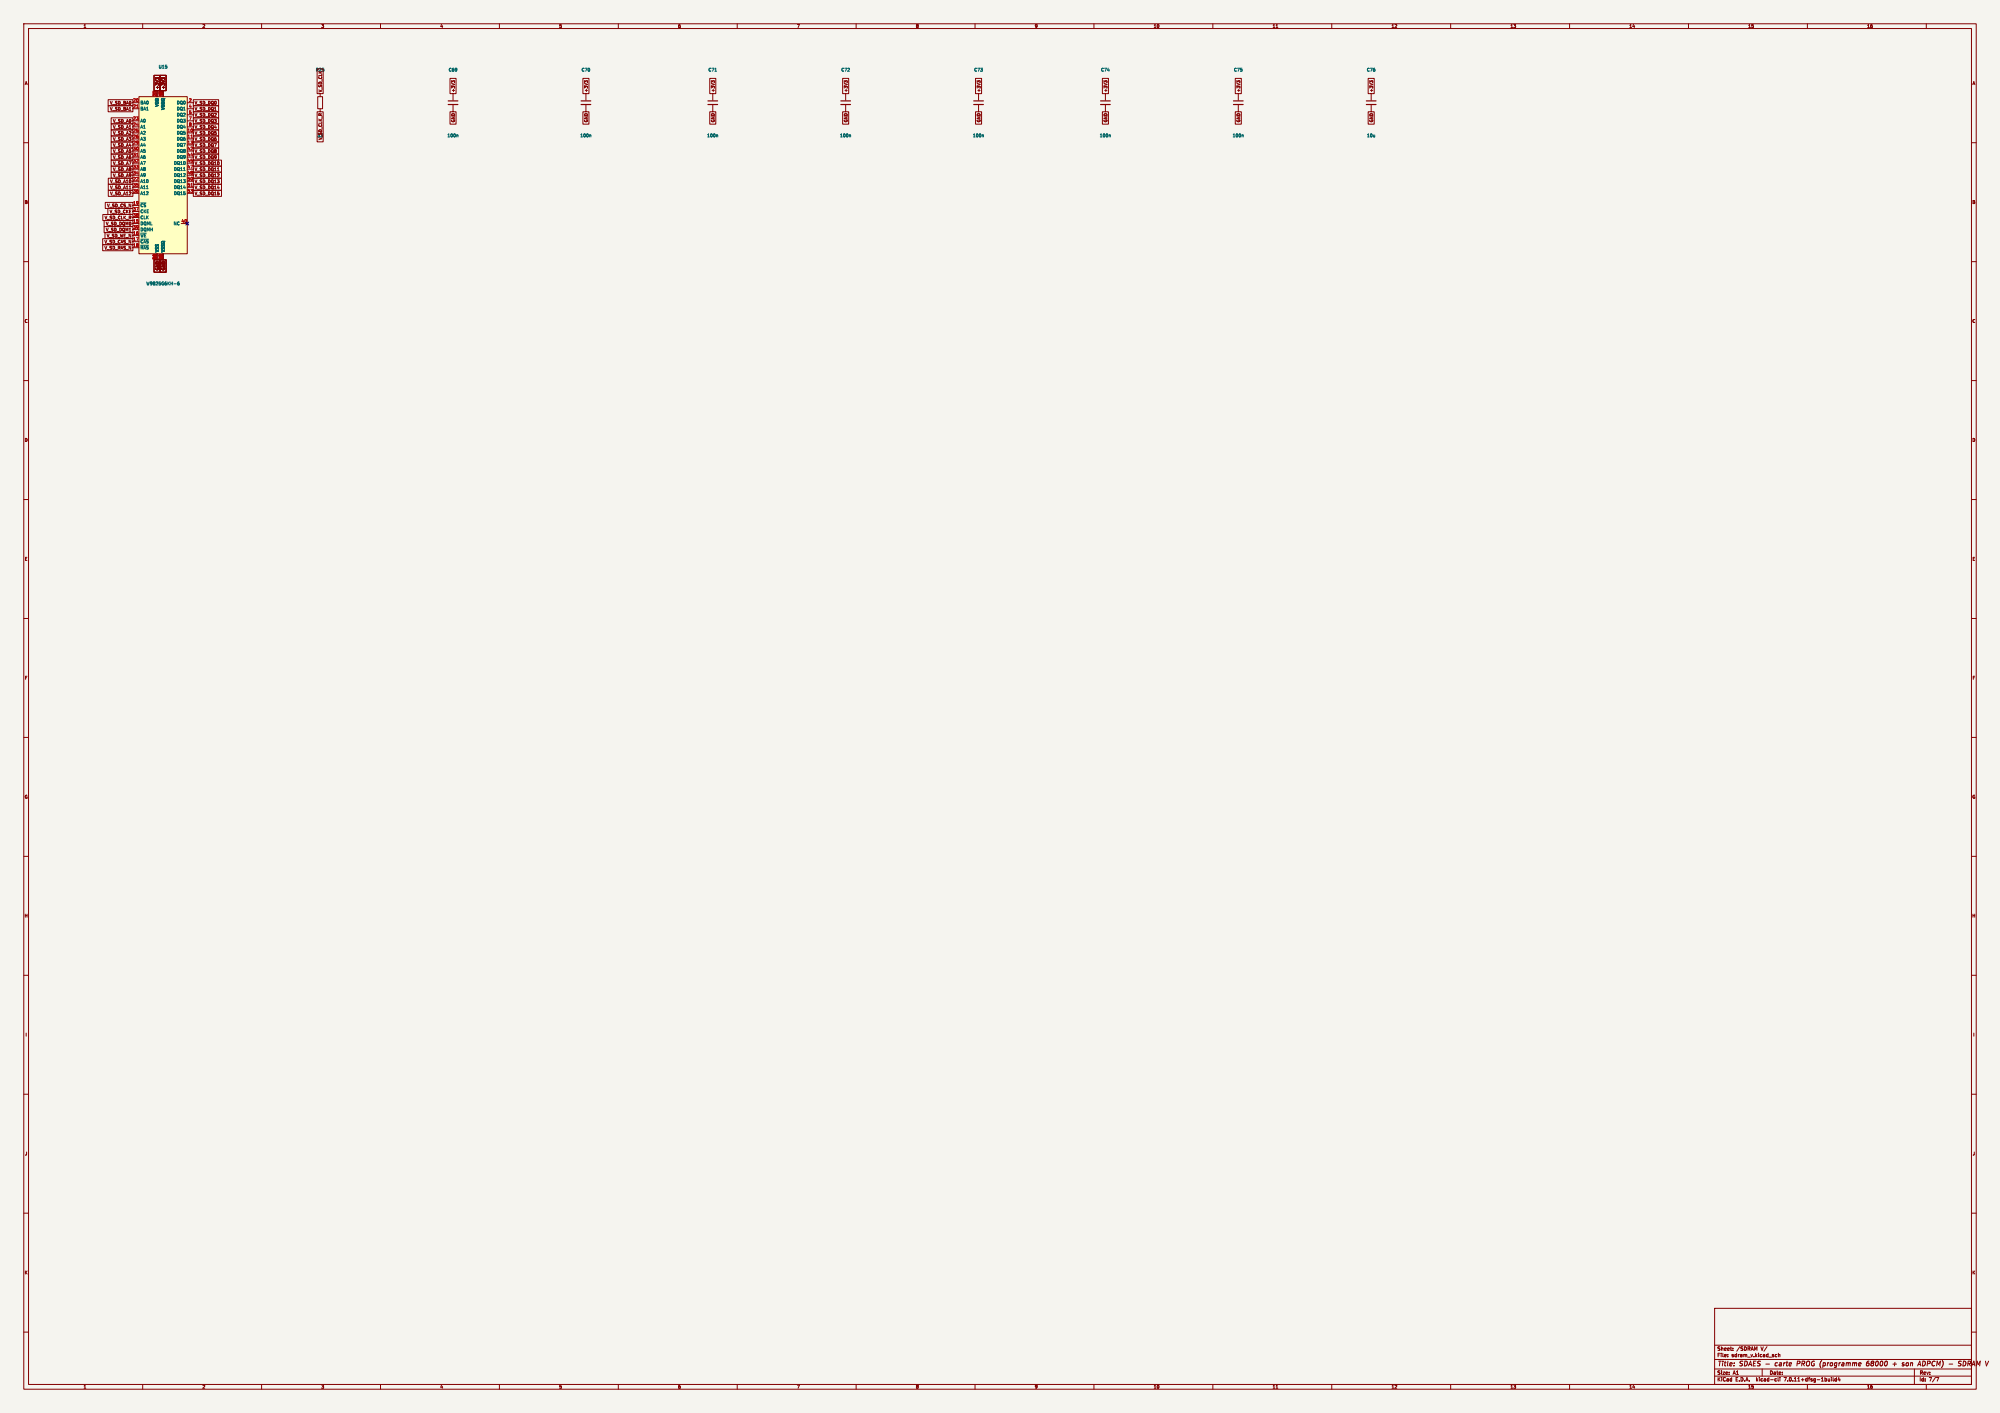
[picture p15: page 7]
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
