DocteurPCB/SDAES/hardware/kicad/cha/cha.kicad_pcb

## KiCad design hardware/kicad/cha/cha.kicad_pcb (2026-10-16)

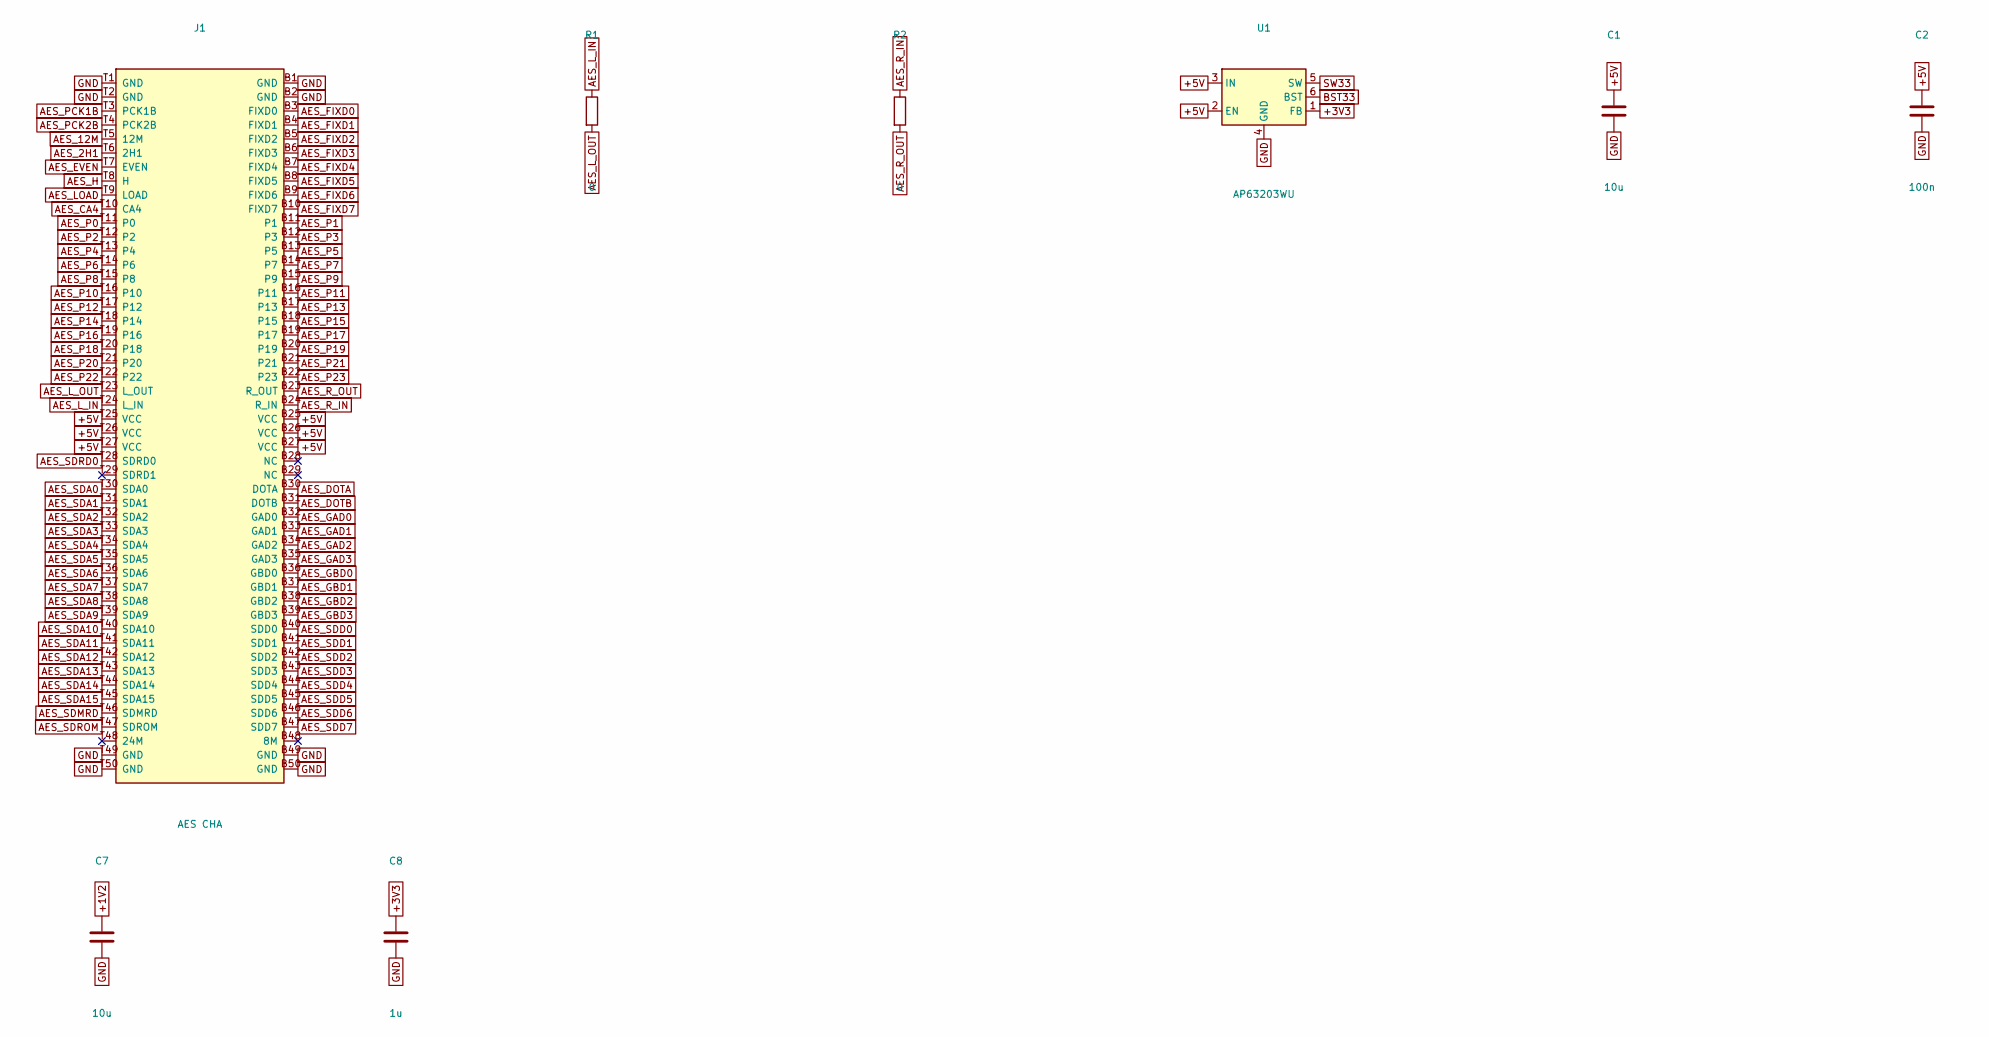
[picture p16: schematic power.kicad_sch, SDAES - carte CHA (sprites, couche fixe, Z80, RP2350) - Con…, part in row 1, column 1]

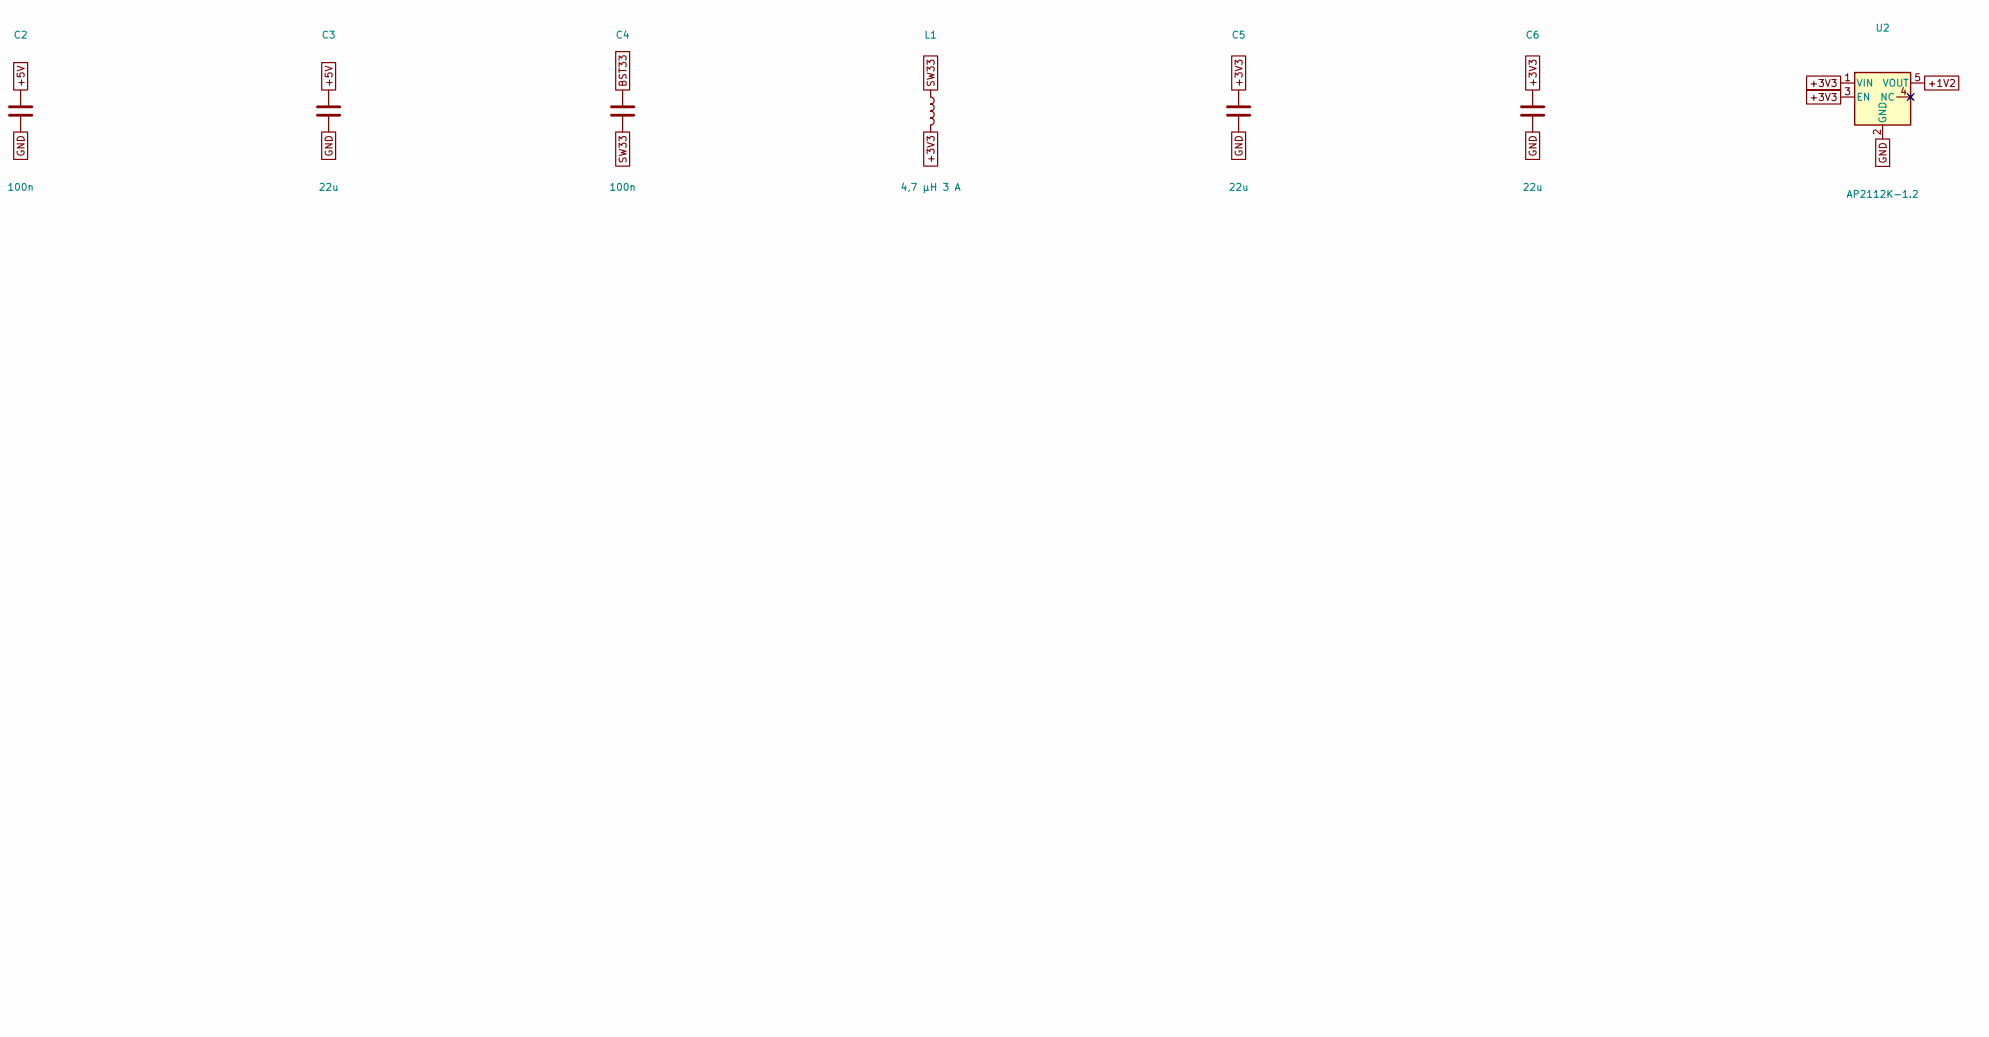
[picture p17: schematic power.kicad_sch, SDAES - carte CHA (sprites, couche fixe, Z80, RP2350) - Con…, part in row 1, column 2]

Parts:
C1, C7: 10u; C_0805_2012Metric
C2, C4: 100n; C_0603_1608Metric
C3, C5, C6: 22u; C_1206_3216Metric
C8: 1u; C_0603_1608Metric
J1: AES CHA; AES_Edge_2x50_P2.54mm
L1: 4,7 µH 3 A; L_Bourns_SRP5030T
R1, R2: 0; R_0603_1608Metric
U1: AP63203WU; TSOT-23-6
U2: AP2112K-1.2; SOT-23-5

Connections:
+1V2: C7.1, U2.5 (VOUT); also elsewhere on the board
+3V3: C5.1, C6.1, C8.1, L1.2, U1.1 (FB), U2.1 (VIN), U2.3 (EN); also elsewhere on the board
+5V: C1.1, C2.1, C3.1, J1.B25 (VCC), J1.B26 (VCC), J1.B27 (VCC), J1.T25 (VCC), J1.T26 (VCC), J1.T27 (VCC), U1.2 (EN), U1.3 (IN); also elsewhere on the board
AES_2H1: J1.T6 (2H1); also elsewhere on the board
AES_12M: J1.T5 (12M); also elsewhere on the board
AES_CA4: J1.T10 (CA4); also elsewhere on the board
AES_DOTA: J1.B30 (DOTA); also elsewhere on the board
AES_DOTB: J1.B31 (DOTB); also elsewhere on the board
AES_EVEN: J1.T7 (EVEN); also elsewhere on the board
AES_FIXD0: J1.B3 (FIXD0); also elsewhere on the board
AES_FIXD1: J1.B4 (FIXD1); also elsewhere on the board
AES_FIXD2: J1.B5 (FIXD2); also elsewhere on the board
AES_FIXD3: J1.B6 (FIXD3); also elsewhere on the board
AES_FIXD4: J1.B7 (FIXD4); also elsewhere on the board
AES_FIXD5: J1.B8 (FIXD5); also elsewhere on the board
AES_FIXD6: J1.B9 (FIXD6); also elsewhere on the board
AES_FIXD7: J1.B10 (FIXD7); also elsewhere on the board
AES_GAD0: J1.B32 (GAD0); also elsewhere on the board
AES_GAD1: J1.B33 (GAD1); also elsewhere on the board
AES_GAD2: J1.B34 (GAD2); also elsewhere on the board
AES_GAD3: J1.B35 (GAD3); also elsewhere on the board
AES_GBD0: J1.B36 (GBD0); also elsewhere on the board
AES_GBD1: J1.B37 (GBD1); also elsewhere on the board
AES_GBD2: J1.B38 (GBD2); also elsewhere on the board
AES_GBD3: J1.B39 (GBD3); also elsewhere on the board
AES_H: J1.T8 (H); also elsewhere on the board
AES_LOAD: J1.T9 (LOAD); also elsewhere on the board
AES_L_IN: J1.T24 (L_IN), R1.1
AES_L_OUT: J1.T23 (L_OUT), R1.2
AES_P0: J1.T11 (P0); also elsewhere on the board
AES_P1: J1.B11 (P1); also elsewhere on the board
AES_P2: J1.T12 (P2); also elsewhere on the board
AES_P3: J1.B12 (P3); also elsewhere on the board
AES_P4: J1.T13 (P4); also elsewhere on the board
AES_P5: J1.B13 (P5); also elsewhere on the board
AES_P6: J1.T14 (P6); also elsewhere on the board
AES_P7: J1.B14 (P7); also elsewhere on the board
AES_P8: J1.T15 (P8); also elsewhere on the board
AES_P9: J1.B15 (P9); also elsewhere on the board
AES_P10: J1.T16 (P10); also elsewhere on the board
AES_P11: J1.B16 (P11); also elsewhere on the board
AES_P12: J1.T17 (P12); also elsewhere on the board
AES_P13: J1.B17 (P13); also elsewhere on the board
AES_P14: J1.T18 (P14); also elsewhere on the board
AES_P15: J1.B18 (P15); also elsewhere on the board
AES_P16: J1.T19 (P16); also elsewhere on the board
AES_P17: J1.B19 (P17); also elsewhere on the board
AES_P18: J1.T20 (P18); also elsewhere on the board
AES_P19: J1.B20 (P19); also elsewhere on the board
AES_P20: J1.T21 (P20); also elsewhere on the board
AES_P21: J1.B21 (P21); also elsewhere on the board
AES_P22: J1.T22 (P22); also elsewhere on the board
AES_P23: J1.B22 (P23); also elsewhere on the board
AES_PCK1B: J1.T3 (PCK1B); also elsewhere on the board
AES_PCK2B: J1.T4 (PCK2B); also elsewhere on the board
AES_R_IN: J1.B24 (R_IN), R2.1
AES_R_OUT: J1.B23 (R_OUT), R2.2
AES_SDA0: J1.T30 (SDA0); also elsewhere on the board
AES_SDA1: J1.T31 (SDA1); also elsewhere on the board
AES_SDA2: J1.T32 (SDA2); also elsewhere on the board
AES_SDA3: J1.T33 (SDA3); also elsewhere on the board
AES_SDA4: J1.T34 (SDA4); also elsewhere on the board
AES_SDA5: J1.T35 (SDA5); also elsewhere on the board
AES_SDA6: J1.T36 (SDA6); also elsewhere on the board
AES_SDA7: J1.T37 (SDA7); also elsewhere on the board
AES_SDA8: J1.T38 (SDA8); also elsewhere on the board
AES_SDA9: J1.T39 (SDA9); also elsewhere on the board
AES_SDA10: J1.T40 (SDA10); also elsewhere on the board
AES_SDA11: J1.T41 (SDA11); also elsewhere on the board
AES_SDA12: J1.T42 (SDA12); also elsewhere on the board
AES_SDA13: J1.T43 (SDA13); also elsewhere on the board
AES_SDA14: J1.T44 (SDA14); also elsewhere on the board
AES_SDA15: J1.T45 (SDA15); also elsewhere on the board
AES_SDD0: J1.B40 (SDD0); also elsewhere on the board
AES_SDD1: J1.B41 (SDD1); also elsewhere on the board
AES_SDD2: J1.B42 (SDD2); also elsewhere on the board
AES_SDD3: J1.B43 (SDD3); also elsewhere on the board
AES_SDD4: J1.B44 (SDD4); also elsewhere on the board
AES_SDD5: J1.B45 (SDD5); also elsewhere on the board
AES_SDD6: J1.B46 (SDD6); also elsewhere on the board
AES_SDD7: J1.B47 (SDD7); also elsewhere on the board
AES_SDMRD: J1.T46 (SDMRD); also elsewhere on the board
AES_SDRD0: J1.T28 (SDRD0); also elsewhere on the board
AES_SDROM: J1.T47 (SDROM); also elsewhere on the board
BST33: C4.1, U1.6 (BST)
GND: C1.2, C2.2, C3.2, C5.2, C6.2, C7.2, C8.2, J1.B1 (GND), J1.B2 (GND), J1.B49 (GND), J1.B50 (GND), J1.T1 (GND), J1.T2 (GND), J1.T49 (GND), J1.T50 (GND), U1.4 (GND), U2.2 (GND); also elsewhere on the board
SW33: C4.2, L1.1, U1.5 (SW)

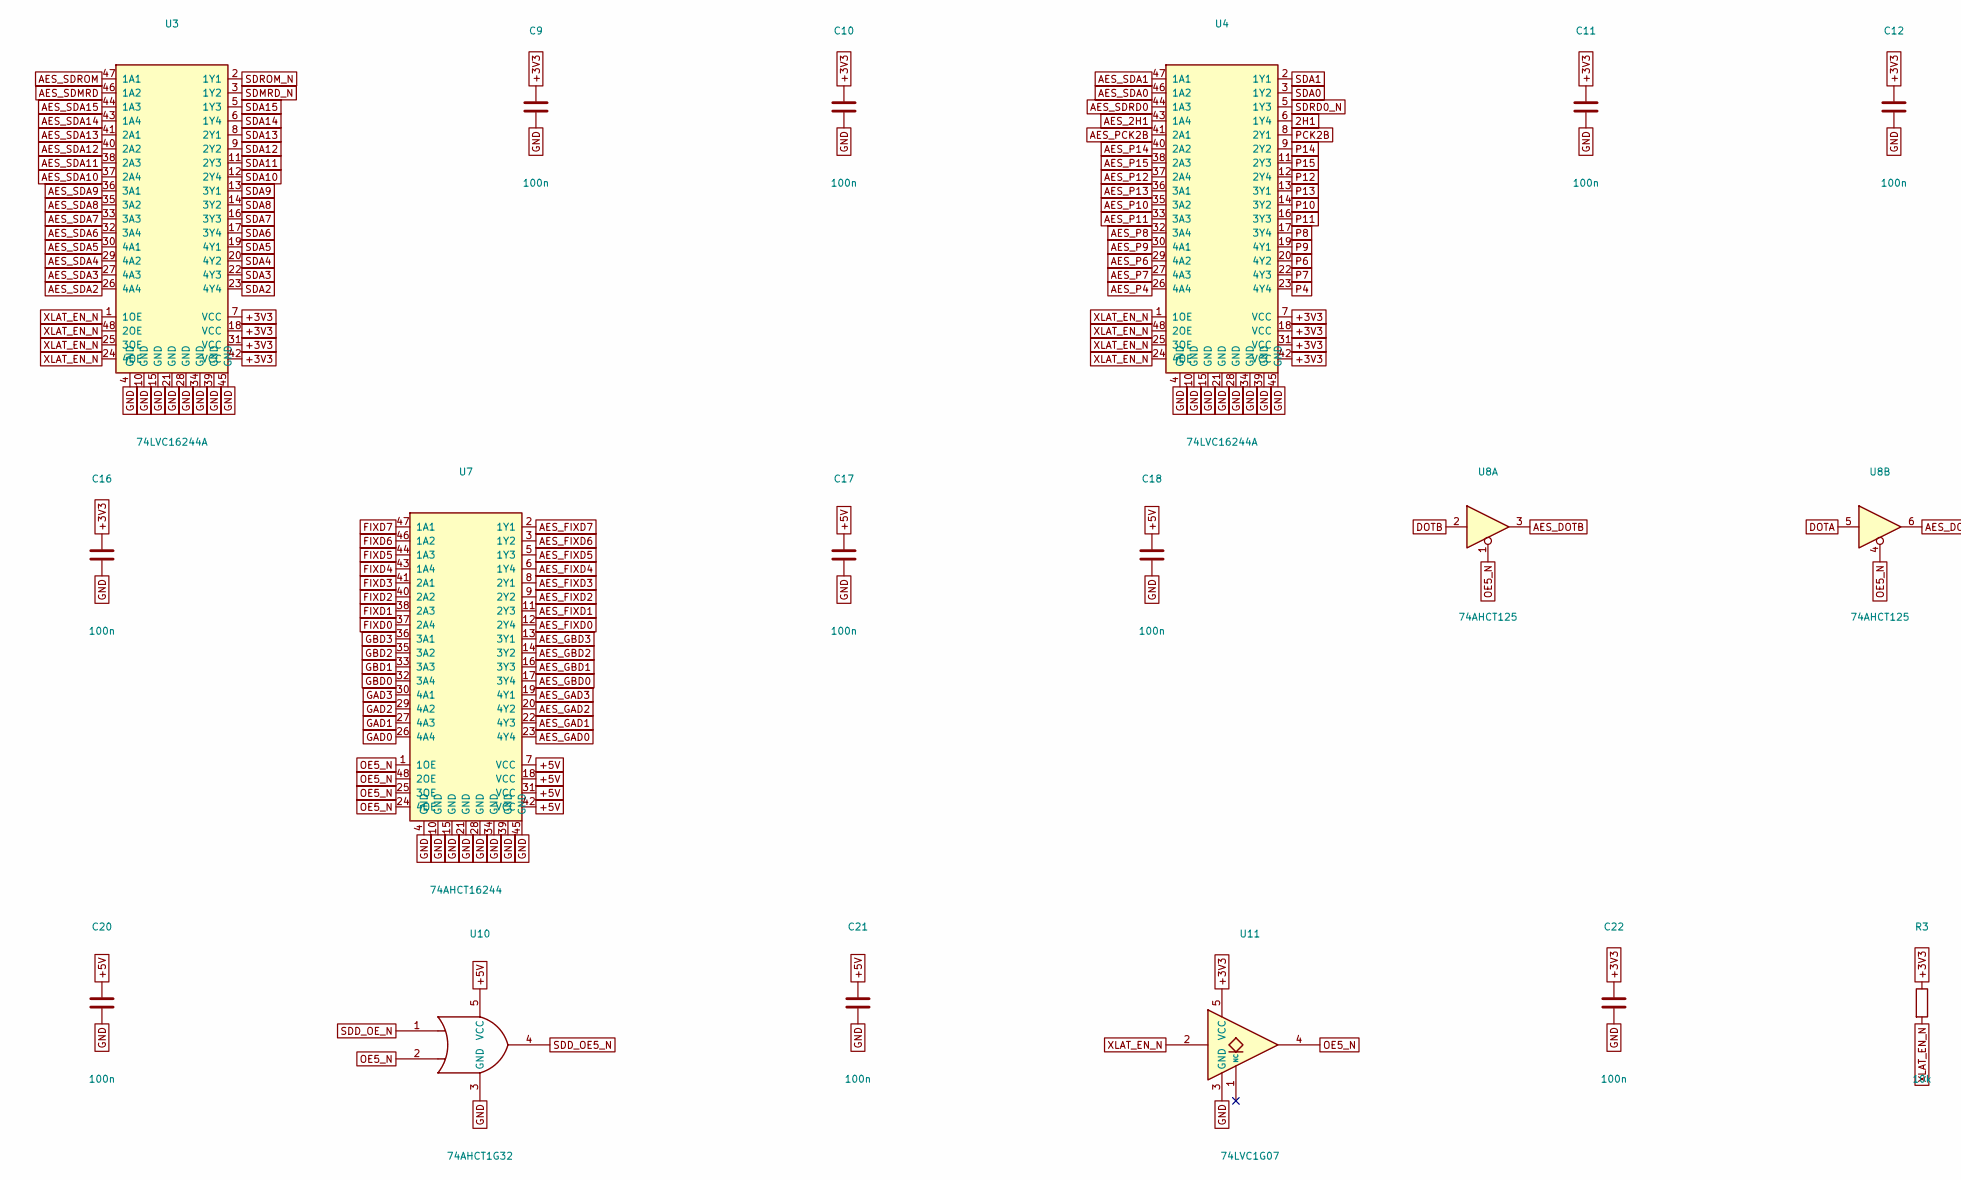
[picture p18: schematic buffers.kicad_sch, SDAES - carte CHA (sprites, couche fixe, Z80, RP2350) - Tam…, part in row 1, column 1]

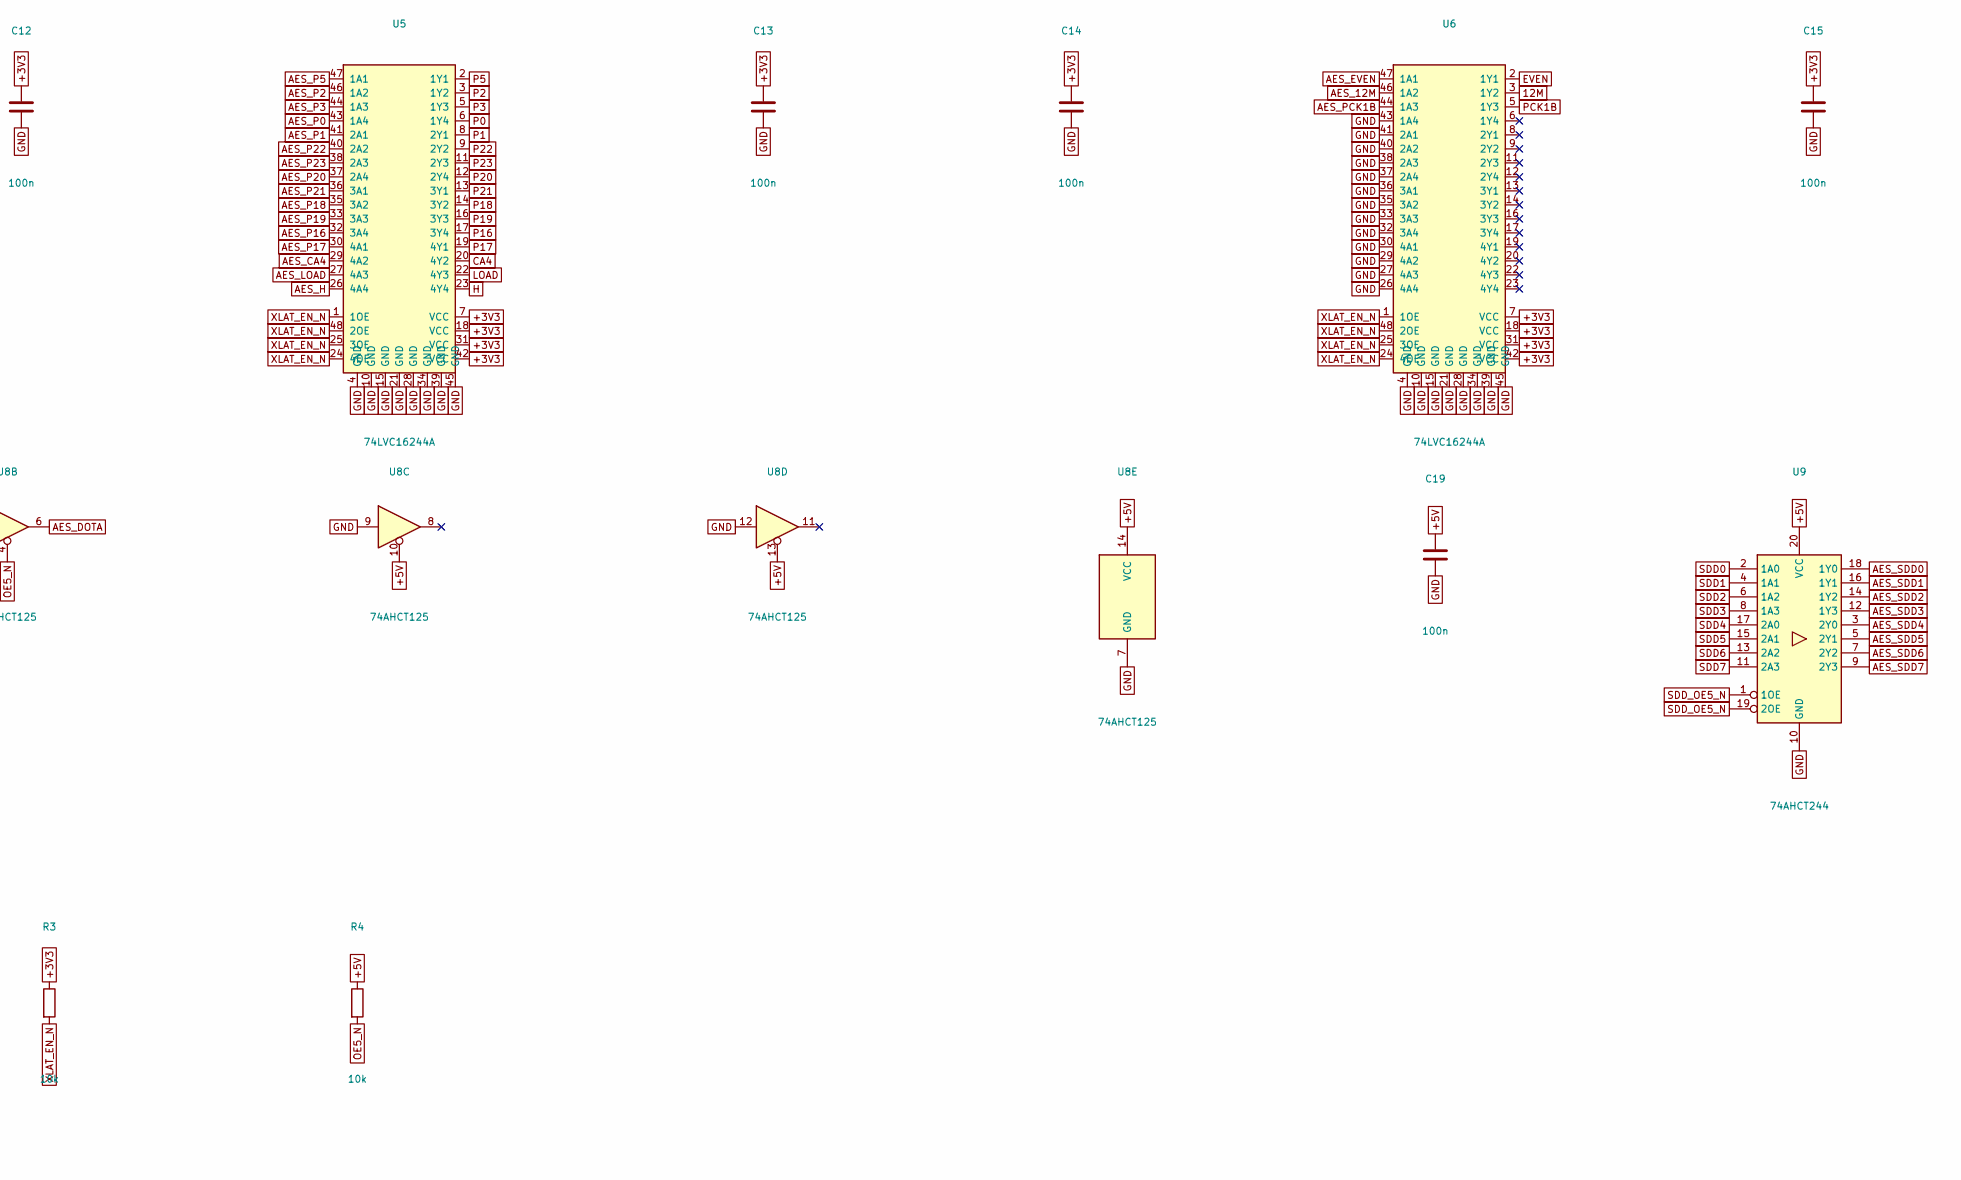
[picture p19: schematic buffers.kicad_sch, SDAES - carte CHA (sprites, couche fixe, Z80, RP2350) - Tam…, part in row 1, column 2]

Parts:
C9, C10, C11, C12, C13, C14, C15, C16, C17, C18, C19, C20, C21, C22: 100n; C_0603_1608Metric
R3, R4: 10k; R_0603_1608Metric
U3, U4, U5, U6: 74LVC16244A; TSSOP-48_6.1x12.5mm_P0.5mm
U7: 74AHCT16244; TSSOP-48_6.1x12.5mm_P0.5mm
U8: 74AHCT125; TSSOP-14_4.4x5mm_P0.65mm
U9: 74AHCT244; TSSOP-20_4.4x6.5mm_P0.65mm
U10: 74AHCT1G32; SOT-23-5
U11: 74LVC1G07; SOT-23-5

Connections:
2H1: U4.6 (1Y4); also elsewhere on the board
12M: U6.3 (1Y2); also elsewhere on the board
+3V3: C9.1, C10.1, C11.1, C12.1, C13.1, C14.1, C15.1, C16.1, C22.1, R3.1, U3.7 (VCC), U3.18 (VCC), U3.31 (VCC), U3.42 (VCC), U4.7 (VCC), U4.18 (VCC), U4.31 (VCC), U4.42 (VCC), U5.7 (VCC), U5.18 (VCC), U5.31 (VCC), U5.42 (VCC), U6.7 (VCC), U6.18 (VCC), U6.31 (VCC), U6.42 (VCC), U11.5 (VCC); also elsewhere on the board
+5V: C17.1, C18.1, C19.1, C20.1, C21.1, R4.1, U7.7 (VCC), U7.18 (VCC), U7.31 (VCC), U7.42 (VCC), U8.10, U8.13, U8.14 (VCC), U9.20 (VCC), U10.5 (VCC); also elsewhere on the board
AES_2H1: U4.43 (1A4); also elsewhere on the board
AES_12M: U6.46 (1A2); also elsewhere on the board
AES_CA4: U5.29 (4A2); also elsewhere on the board
AES_DOTA: U8.6; also elsewhere on the board
AES_DOTB: U8.3; also elsewhere on the board
AES_EVEN: U6.47 (1A1); also elsewhere on the board
AES_FIXD0: U7.12 (2Y4); also elsewhere on the board
AES_FIXD1: U7.11 (2Y3); also elsewhere on the board
AES_FIXD2: U7.9 (2Y2); also elsewhere on the board
AES_FIXD3: U7.8 (2Y1); also elsewhere on the board
AES_FIXD4: U7.6 (1Y4); also elsewhere on the board
AES_FIXD5: U7.5 (1Y3); also elsewhere on the board
AES_FIXD6: U7.3 (1Y2); also elsewhere on the board
AES_FIXD7: U7.2 (1Y1); also elsewhere on the board
AES_GAD0: U7.23 (4Y4); also elsewhere on the board
AES_GAD1: U7.22 (4Y3); also elsewhere on the board
AES_GAD2: U7.20 (4Y2); also elsewhere on the board
AES_GAD3: U7.19 (4Y1); also elsewhere on the board
AES_GBD0: U7.17 (3Y4); also elsewhere on the board
AES_GBD1: U7.16 (3Y3); also elsewhere on the board
AES_GBD2: U7.14 (3Y2); also elsewhere on the board
AES_GBD3: U7.13 (3Y1); also elsewhere on the board
AES_H: U5.26 (4A4); also elsewhere on the board
AES_LOAD: U5.27 (4A3); also elsewhere on the board
AES_P0: U5.43 (1A4); also elsewhere on the board
AES_P1: U5.41 (2A1); also elsewhere on the board
AES_P2: U5.46 (1A2); also elsewhere on the board
AES_P3: U5.44 (1A3); also elsewhere on the board
AES_P4: U4.26 (4A4); also elsewhere on the board
AES_P5: U5.47 (1A1); also elsewhere on the board
AES_P6: U4.29 (4A2); also elsewhere on the board
AES_P7: U4.27 (4A3); also elsewhere on the board
AES_P8: U4.32 (3A4); also elsewhere on the board
AES_P9: U4.30 (4A1); also elsewhere on the board
AES_P10: U4.35 (3A2); also elsewhere on the board
AES_P11: U4.33 (3A3); also elsewhere on the board
AES_P12: U4.37 (2A4); also elsewhere on the board
AES_P13: U4.36 (3A1); also elsewhere on the board
AES_P14: U4.40 (2A2); also elsewhere on the board
AES_P15: U4.38 (2A3); also elsewhere on the board
AES_P16: U5.32 (3A4); also elsewhere on the board
AES_P17: U5.30 (4A1); also elsewhere on the board
AES_P18: U5.35 (3A2); also elsewhere on the board
AES_P19: U5.33 (3A3); also elsewhere on the board
AES_P20: U5.37 (2A4); also elsewhere on the board
AES_P21: U5.36 (3A1); also elsewhere on the board
AES_P22: U5.40 (2A2); also elsewhere on the board
AES_P23: U5.38 (2A3); also elsewhere on the board
AES_PCK1B: U6.44 (1A3); also elsewhere on the board
AES_PCK2B: U4.41 (2A1); also elsewhere on the board
AES_SDA0: U4.46 (1A2); also elsewhere on the board
AES_SDA1: U4.47 (1A1); also elsewhere on the board
AES_SDA2: U3.26 (4A4); also elsewhere on the board
AES_SDA3: U3.27 (4A3); also elsewhere on the board
AES_SDA4: U3.29 (4A2); also elsewhere on the board
AES_SDA5: U3.30 (4A1); also elsewhere on the board
AES_SDA6: U3.32 (3A4); also elsewhere on the board
AES_SDA7: U3.33 (3A3); also elsewhere on the board
AES_SDA8: U3.35 (3A2); also elsewhere on the board
AES_SDA9: U3.36 (3A1); also elsewhere on the board
AES_SDA10: U3.37 (2A4); also elsewhere on the board
AES_SDA11: U3.38 (2A3); also elsewhere on the board
AES_SDA12: U3.40 (2A2); also elsewhere on the board
AES_SDA13: U3.41 (2A1); also elsewhere on the board
AES_SDA14: U3.43 (1A4); also elsewhere on the board
AES_SDA15: U3.44 (1A3); also elsewhere on the board
AES_SDD0: U9.18 (1Y0); also elsewhere on the board
AES_SDD1: U9.16 (1Y1); also elsewhere on the board
AES_SDD2: U9.14 (1Y2); also elsewhere on the board
AES_SDD3: U9.12 (1Y3); also elsewhere on the board
AES_SDD4: U9.3 (2Y0); also elsewhere on the board
AES_SDD5: U9.5 (2Y1); also elsewhere on the board
AES_SDD6: U9.7 (2Y2); also elsewhere on the board
AES_SDD7: U9.9 (2Y3); also elsewhere on the board
AES_SDMRD: U3.46 (1A2); also elsewhere on the board
AES_SDRD0: U4.44 (1A3); also elsewhere on the board
AES_SDROM: U3.47 (1A1); also elsewhere on the board
CA4: U5.20 (4Y2); also elsewhere on the board
DOTA: U8.5; also elsewhere on the board
DOTB: U8.2; also elsewhere on the board
EVEN: U6.2 (1Y1); also elsewhere on the board
FIXD0: U7.37 (2A4); also elsewhere on the board
FIXD1: U7.38 (2A3); also elsewhere on the board
FIXD2: U7.40 (2A2); also elsewhere on the board
FIXD3: U7.41 (2A1); also elsewhere on the board
FIXD4: U7.43 (1A4); also elsewhere on the board
FIXD5: U7.44 (1A3); also elsewhere on the board
FIXD6: U7.46 (1A2); also elsewhere on the board
FIXD7: U7.47 (1A1); also elsewhere on the board
GAD0: U7.26 (4A4); also elsewhere on the board
GAD1: U7.27 (4A3); also elsewhere on the board
GAD2: U7.29 (4A2); also elsewhere on the board
GAD3: U7.30 (4A1); also elsewhere on the board
GBD0: U7.32 (3A4); also elsewhere on the board
GBD1: U7.33 (3A3); also elsewhere on the board
GBD2: U7.35 (3A2); also elsewhere on the board
GBD3: U7.36 (3A1); also elsewhere on the board
GND: C9.2, C10.2, C11.2, C12.2, C13.2, C14.2, C15.2, C16.2, C17.2, C18.2, C19.2, C20.2, C21.2, C22.2, U3.4 (GND), U3.10 (GND), U3.15 (GND), U3.21 (GND), U3.28 (GND), U3.34 (GND), U3.39 (GND), U3.45 (GND), U4.4 (GND), U4.10 (GND), U4.15 (GND), U4.21 (GND), U4.28 (GND), U4.34 (GND), U4.39 (GND), U4.45 (GND), U5.4 (GND), U5.10 (GND), U5.15 (GND), U5.21 (GND), U5.28 (GND), U5.34 (GND), U5.39 (GND), U5.45 (GND), U6.4 (GND), U6.10 (GND), U6.15 (GND), U6.21 (GND), U6.26 (4A4), U6.27 (4A3), U6.28 (GND), U6.29 (4A2), U6.30 (4A1), U6.32 (3A4), U6.33 (3A3), U6.34 (GND), U6.35 (3A2), U6.36 (3A1), U6.37 (2A4), U6.38 (2A3), U6.39 (GND), U6.40 (2A2), U6.41 (2A1), U6.43 (1A4), U6.45 (GND), U7.4 (GND), U7.10 (GND), U7.15 (GND), U7.21 (GND), U7.28 (GND), U7.34 (GND), U7.39 (GND), U7.45 (GND), U8.7 (GND), U8.9, U8.12, U9.10 (GND), U10.3 (GND), U11.3 (GND); also elsewhere on the board
H: U5.23 (4Y4); also elsewhere on the board
LOAD: U5.22 (4Y3); also elsewhere on the board
OE5_N: R4.2, U7.1 (1OE), U7.24 (4OE), U7.25 (3OE), U7.48 (2OE), U8.1, U8.4, U10.2, U11.4
P0: U5.6 (1Y4); also elsewhere on the board
P1: U5.8 (2Y1); also elsewhere on the board
P2: U5.3 (1Y2); also elsewhere on the board
P3: U5.5 (1Y3); also elsewhere on the board
P4: U4.23 (4Y4); also elsewhere on the board
P5: U5.2 (1Y1); also elsewhere on the board
P6: U4.20 (4Y2); also elsewhere on the board
P7: U4.22 (4Y3); also elsewhere on the board
P8: U4.17 (3Y4); also elsewhere on the board
P9: U4.19 (4Y1); also elsewhere on the board
P10: U4.14 (3Y2); also elsewhere on the board
P11: U4.16 (3Y3); also elsewhere on the board
P12: U4.12 (2Y4); also elsewhere on the board
P13: U4.13 (3Y1); also elsewhere on the board
P14: U4.9 (2Y2); also elsewhere on the board
P15: U4.11 (2Y3); also elsewhere on the board
P16: U5.17 (3Y4); also elsewhere on the board
P17: U5.19 (4Y1); also elsewhere on the board
P18: U5.14 (3Y2); also elsewhere on the board
P19: U5.16 (3Y3); also elsewhere on the board
P20: U5.12 (2Y4); also elsewhere on the board
P21: U5.13 (3Y1); also elsewhere on the board
P22: U5.9 (2Y2); also elsewhere on the board
P23: U5.11 (2Y3); also elsewhere on the board
PCK1B: U6.5 (1Y3); also elsewhere on the board
PCK2B: U4.8 (2Y1); also elsewhere on the board
SDA0: U4.3 (1Y2); also elsewhere on the board
SDA1: U4.2 (1Y1); also elsewhere on the board
SDA2: U3.23 (4Y4); also elsewhere on the board
SDA3: U3.22 (4Y3); also elsewhere on the board
SDA4: U3.20 (4Y2); also elsewhere on the board
SDA5: U3.19 (4Y1); also elsewhere on the board
SDA6: U3.17 (3Y4); also elsewhere on the board
SDA7: U3.16 (3Y3); also elsewhere on the board
SDA8: U3.14 (3Y2); also elsewhere on the board
SDA9: U3.13 (3Y1); also elsewhere on the board
SDA10: U3.12 (2Y4); also elsewhere on the board
SDA11: U3.11 (2Y3); also elsewhere on the board
SDA12: U3.9 (2Y2); also elsewhere on the board
SDA13: U3.8 (2Y1); also elsewhere on the board
SDA14: U3.6 (1Y4); also elsewhere on the board
SDA15: U3.5 (1Y3); also elsewhere on the board
SDD0: U9.2 (1A0); also elsewhere on the board
SDD1: U9.4 (1A1); also elsewhere on the board
SDD2: U9.6 (1A2); also elsewhere on the board
SDD3: U9.8 (1A3); also elsewhere on the board
SDD4: U9.17 (2A0); also elsewhere on the board
SDD5: U9.15 (2A1); also elsewhere on the board
SDD6: U9.13 (2A2); also elsewhere on the board
SDD7: U9.11 (2A3); also elsewhere on the board
SDD_OE5_N: U9.1 (1OE), U9.19 (2OE), U10.4
SDD_OE_N: U10.1; also elsewhere on the board
SDMRD_N: U3.3 (1Y2); also elsewhere on the board
SDRD0_N: U4.5 (1Y3); also elsewhere on the board
SDROM_N: U3.2 (1Y1); also elsewhere on the board
XLAT_EN_N: R3.2, U3.1 (1OE), U3.24 (4OE), U3.25 (3OE), U3.48 (2OE), U4.1 (1OE), U4.24 (4OE), U4.25 (3OE), U4.48 (2OE), U5.1 (1OE), U5.24 (4OE), U5.25 (3OE), U5.48 (2OE), U6.1 (1OE), U6.24 (4OE), U6.25 (3OE), U6.48 (2OE), U11.2; also elsewhere on the board
