DocteurPCB/SDAES/hardware/kicad/cha/cha.kicad_pcb

## KiCad design hardware/kicad/cha/cha.kicad_pcb (continued)

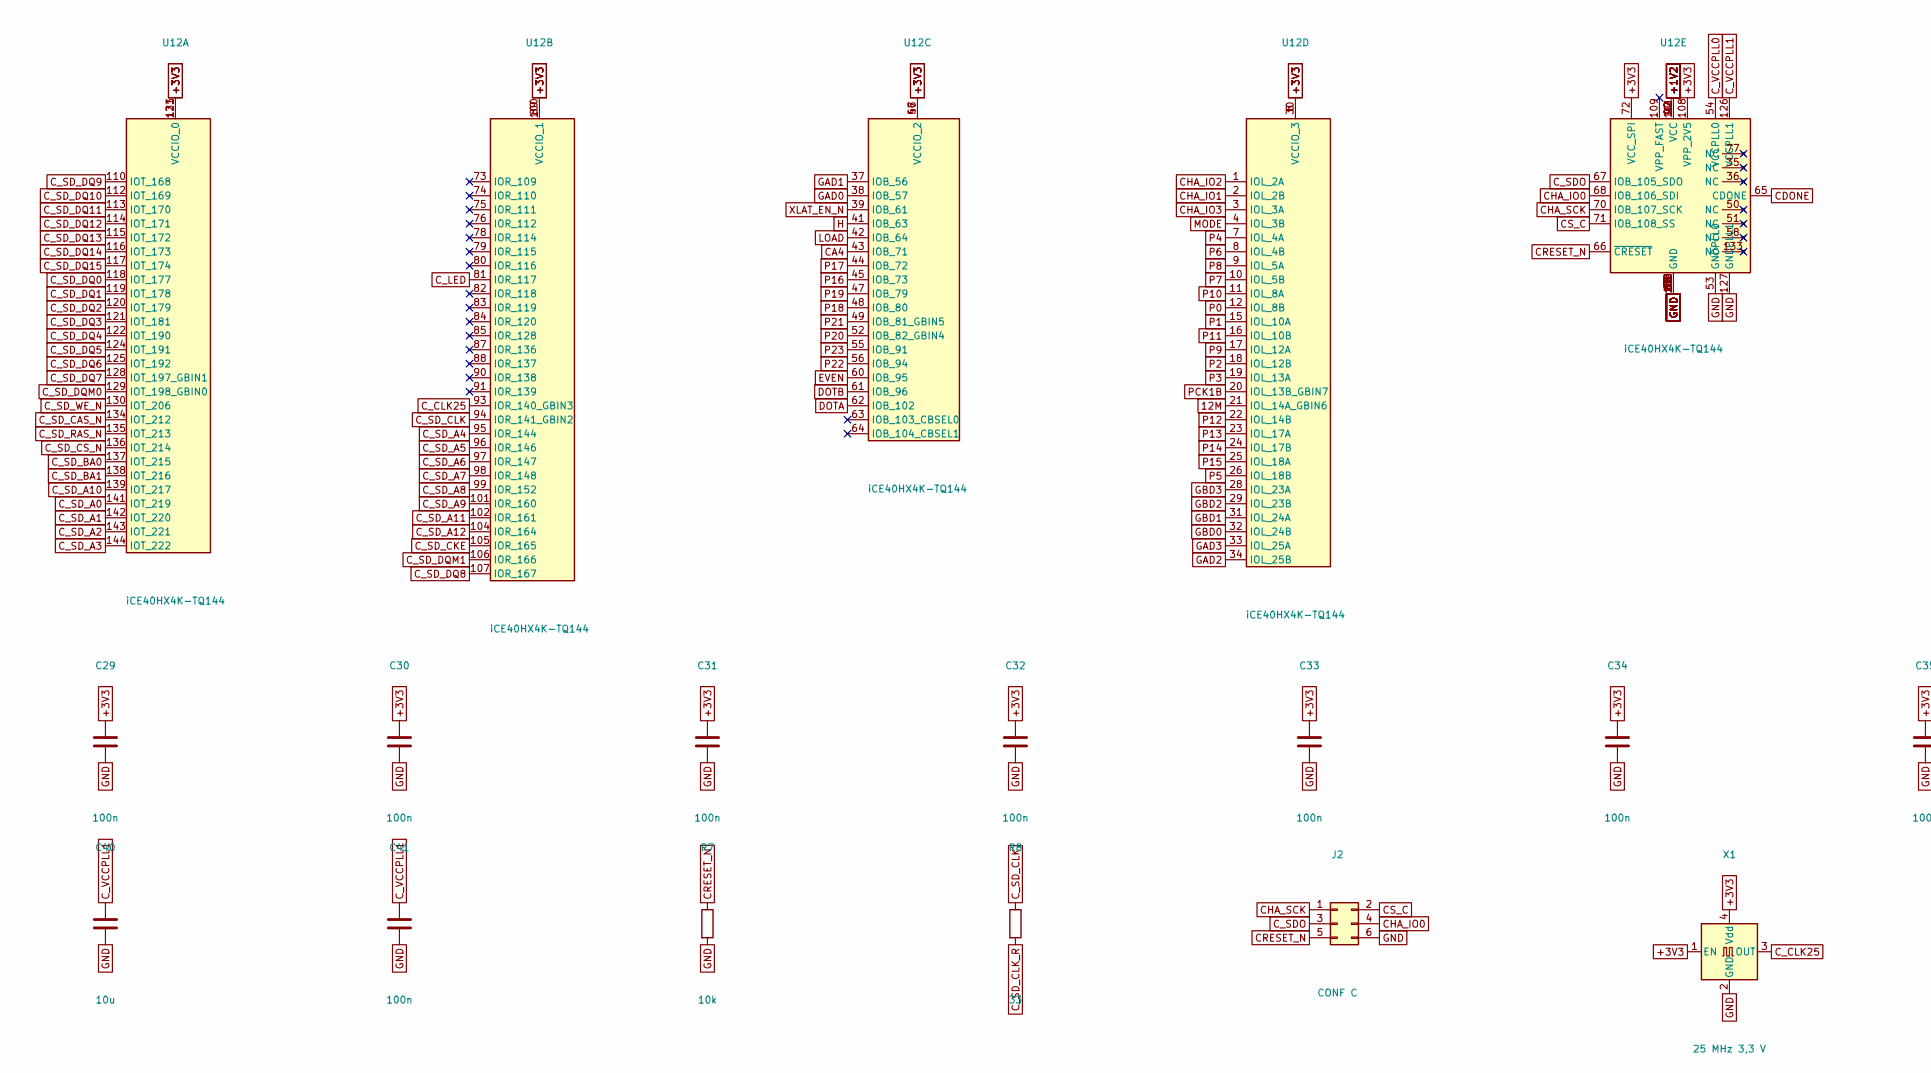
[picture p20: schematic fpga_c.kicad_sch, SDAES - carte CHA (sprites, couche fixe, Z80, RP2350) - FPG…, part in row 1, column 1]

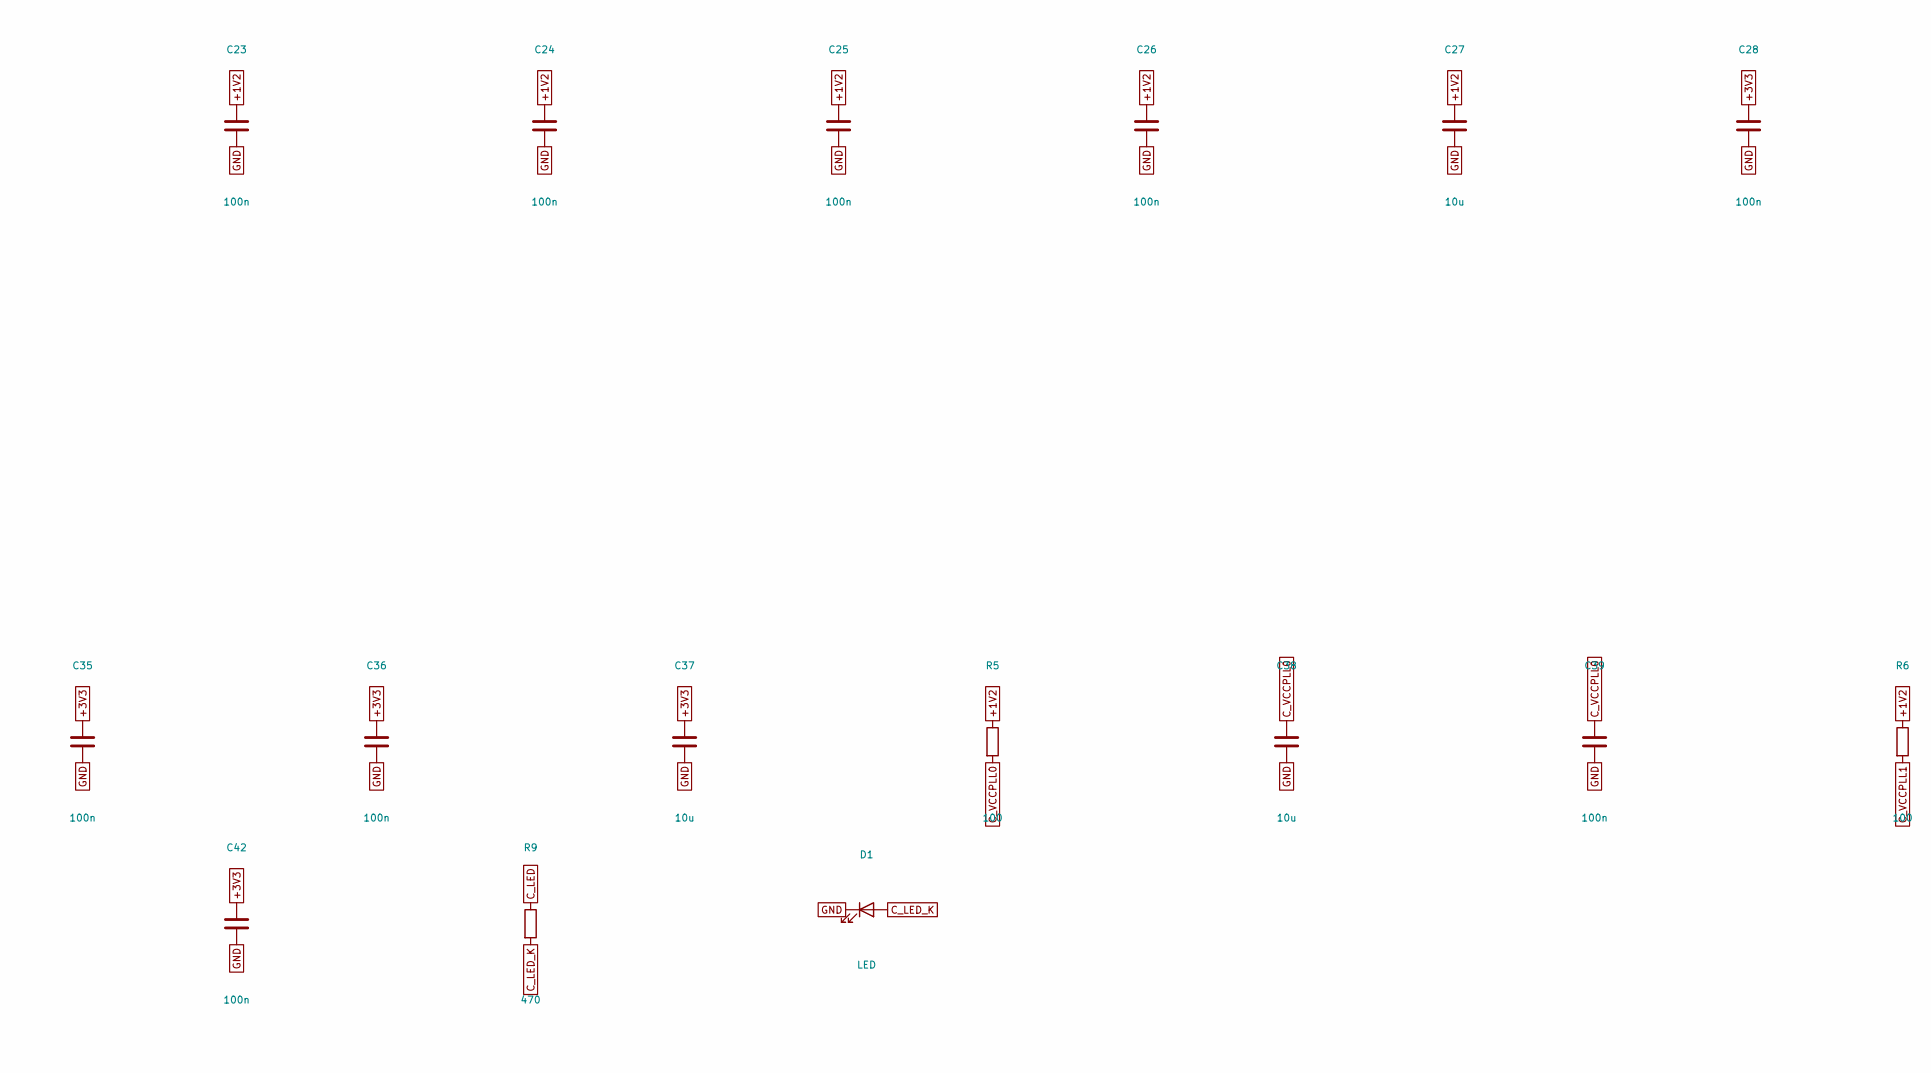
[picture p21: schematic fpga_c.kicad_sch, SDAES - carte CHA (sprites, couche fixe, Z80, RP2350) - FPG…, part in row 1, column 2]

Parts:
C23, C24, C25, C26, C28, C29, C30, C31, C32, C33, C34, C35, C36, C39, C41, C42: 100n; C_0603_1608Metric
C27, C37, C38, C40: 10u; C_0805_2012Metric
D1: LED; LED_0603_1608Metric
J2: CONF C; PinHeader_2x03_P2.54mm_Vertical
R5, R6: 100; R_0603_1608Metric
R7: 10k; R_0603_1608Metric
R8: 33; R_0603_1608Metric
R9: 470; R_0603_1608Metric
U12: iCE40HX4K-TQ144; TQFP-144_20x20mm_P0.5mm
X1: 25 MHz 3,3 V; Oscillator_SMD_Abracon_ASE-4Pin_3.2x2.5mm_HandSoldering

Connections:
12M: U12.21 (IOL_14A_GBIN6); also elsewhere on the board
+1V2: C23.1, C24.1, C25.1, C26.1, C27.1, R5.1, R6.1, U12.27 (VCC), U12.40 (VCC), U12.92 (VCC), U12.111 (VCC); also elsewhere on the board
+3V3: C28.1, C29.1, C30.1, C31.1, C32.1, C33.1, C34.1, C35.1, C36.1, C37.1, C42.1, U12.6 (VCCIO_3), U12.30 (VCCIO_3), U12.46 (VCCIO_2), U12.57 (VCCIO_2), U12.72 (VCC_SPI), U12.89 (VCCIO_1), U12.100 (VCCIO_1), U12.108 (VPP_2V5), U12.123 (VCCIO_0), U12.131 (VCCIO_0), X1.1 (EN), X1.4 (Vdd); also elsewhere on the board
CA4: U12.43 (IOB_71); also elsewhere on the board
CDONE: U12.65 (CDONE); also elsewhere on the board
CHA_IO0: J2.4, U12.68 (IOB_106_SDI); also elsewhere on the board
CHA_IO1: U12.2 (IOL_2B); also elsewhere on the board
CHA_IO2: U12.1 (IOL_2A); also elsewhere on the board
CHA_IO3: U12.3 (IOL_3A); also elsewhere on the board
CHA_SCK: J2.1, U12.70 (IOB_107_SCK); also elsewhere on the board
CRESET_N: J2.5, R7.1, U12.66 (~CRESET); also elsewhere on the board
CS_C: J2.2, U12.71 (IOB_108_SS); also elsewhere on the board
C_CLK25: U12.93 (IOR_140_GBIN3), X1.3 (OUT)
C_LED: R9.1, U12.81 (IOR_117)
C_LED_K: D1.2 (A), R9.2
C_SDO: J2.3, U12.67 (IOB_105_SDO)
C_SD_A0: U12.141 (IOT_219); also elsewhere on the board
C_SD_A1: U12.142 (IOT_220); also elsewhere on the board
C_SD_A2: U12.143 (IOT_221); also elsewhere on the board
C_SD_A3: U12.144 (IOT_222); also elsewhere on the board
C_SD_A4: U12.95 (IOR_144); also elsewhere on the board
C_SD_A5: U12.96 (IOR_146); also elsewhere on the board
C_SD_A6: U12.97 (IOR_147); also elsewhere on the board
C_SD_A7: U12.98 (IOR_148); also elsewhere on the board
C_SD_A8: U12.99 (IOR_152); also elsewhere on the board
C_SD_A9: U12.101 (IOR_160); also elsewhere on the board
C_SD_A10: U12.139 (IOT_217); also elsewhere on the board
C_SD_A11: U12.102 (IOR_161); also elsewhere on the board
C_SD_A12: U12.104 (IOR_164); also elsewhere on the board
C_SD_BA0: U12.137 (IOT_215); also elsewhere on the board
C_SD_BA1: U12.138 (IOT_216); also elsewhere on the board
C_SD_CAS_N: U12.134 (IOT_212); also elsewhere on the board
C_SD_CKE: U12.105 (IOR_165); also elsewhere on the board
C_SD_CLK: R8.1, U12.94 (IOR_141_GBIN2)
C_SD_CLK_R: R8.2; also elsewhere on the board
C_SD_CS_N: U12.136 (IOT_214); also elsewhere on the board
C_SD_DQ0: U12.118 (IOT_177); also elsewhere on the board
C_SD_DQ1: U12.119 (IOT_178); also elsewhere on the board
C_SD_DQ2: U12.120 (IOT_179); also elsewhere on the board
C_SD_DQ3: U12.121 (IOT_181); also elsewhere on the board
C_SD_DQ4: U12.122 (IOT_190); also elsewhere on the board
C_SD_DQ5: U12.124 (IOT_191); also elsewhere on the board
C_SD_DQ6: U12.125 (IOT_192); also elsewhere on the board
C_SD_DQ7: U12.128 (IOT_197_GBIN1); also elsewhere on the board
C_SD_DQ8: U12.107 (IOR_167); also elsewhere on the board
C_SD_DQ9: U12.110 (IOT_168); also elsewhere on the board
C_SD_DQ10: U12.112 (IOT_169); also elsewhere on the board
C_SD_DQ11: U12.113 (IOT_170); also elsewhere on the board
C_SD_DQ12: U12.114 (IOT_171); also elsewhere on the board
C_SD_DQ13: U12.115 (IOT_172); also elsewhere on the board
C_SD_DQ14: U12.116 (IOT_173); also elsewhere on the board
C_SD_DQ15: U12.117 (IOT_174); also elsewhere on the board
C_SD_DQM0: U12.129 (IOT_198_GBIN0); also elsewhere on the board
C_SD_DQM1: U12.106 (IOR_166); also elsewhere on the board
C_SD_RAS_N: U12.135 (IOT_213); also elsewhere on the board
C_SD_WE_N: U12.130 (IOT_206); also elsewhere on the board
C_VCCPLL0: C38.1, C39.1, R5.2, U12.54 (VCCPLL0)
C_VCCPLL1: C40.1, C41.1, R6.2, U12.126 (VCCPLL1)
DOTA: U12.62 (IOB_102); also elsewhere on the board
DOTB: U12.61 (IOB_96); also elsewhere on the board
EVEN: U12.60 (IOB_95); also elsewhere on the board
GAD0: U12.38 (IOB_57); also elsewhere on the board
GAD1: U12.37 (IOB_56); also elsewhere on the board
GAD2: U12.34 (IOL_25B); also elsewhere on the board
GAD3: U12.33 (IOL_25A); also elsewhere on the board
GBD0: U12.32 (IOL_24B); also elsewhere on the board
GBD1: U12.31 (IOL_24A); also elsewhere on the board
GBD2: U12.29 (IOL_23B); also elsewhere on the board
GBD3: U12.28 (IOL_23A); also elsewhere on the board
GND: C23.2, C24.2, C25.2, C26.2, C27.2, C28.2, C29.2, C30.2, C31.2, C32.2, C33.2, C34.2, C35.2, C36.2, C37.2, C38.2, C39.2, C40.2, C41.2, C42.2, D1.1 (K), J2.6, R7.2, U12.5 (GND), U12.13 (GND), U12.14 (GND), U12.53 (GNDPLL0), U12.59 (GND), U12.69 (GND), U12.86 (GND), U12.103 (GND), U12.127 (GNDPLL1), U12.132 (GND), U12.140 (GND), X1.2 (GND); also elsewhere on the board
H: U12.41 (IOB_63); also elsewhere on the board
LOAD: U12.42 (IOB_64); also elsewhere on the board
MODE: U12.4 (IOL_3B); also elsewhere on the board
P0: U12.12 (IOL_8B); also elsewhere on the board
P1: U12.15 (IOL_10A); also elsewhere on the board
P2: U12.18 (IOL_12B); also elsewhere on the board
P3: U12.19 (IOL_13A); also elsewhere on the board
P4: U12.7 (IOL_4A); also elsewhere on the board
P5: U12.26 (IOL_18B); also elsewhere on the board
P6: U12.8 (IOL_4B); also elsewhere on the board
P7: U12.10 (IOL_5B); also elsewhere on the board
P8: U12.9 (IOL_5A); also elsewhere on the board
P9: U12.17 (IOL_12A); also elsewhere on the board
P10: U12.11 (IOL_8A); also elsewhere on the board
P11: U12.16 (IOL_10B); also elsewhere on the board
P12: U12.22 (IOL_14B); also elsewhere on the board
P13: U12.23 (IOL_17A); also elsewhere on the board
P14: U12.24 (IOL_17B); also elsewhere on the board
P15: U12.25 (IOL_18A); also elsewhere on the board
P16: U12.45 (IOB_73); also elsewhere on the board
P17: U12.44 (IOB_72); also elsewhere on the board
P18: U12.48 (IOB_80); also elsewhere on the board
P19: U12.47 (IOB_79); also elsewhere on the board
P20: U12.52 (IOB_82_GBIN4); also elsewhere on the board
P21: U12.49 (IOB_81_GBIN5); also elsewhere on the board
P22: U12.56 (IOB_94); also elsewhere on the board
P23: U12.55 (IOB_91); also elsewhere on the board
PCK1B: U12.20 (IOL_13B_GBIN7); also elsewhere on the board
XLAT_EN_N: U12.39 (IOB_61); also elsewhere on the board

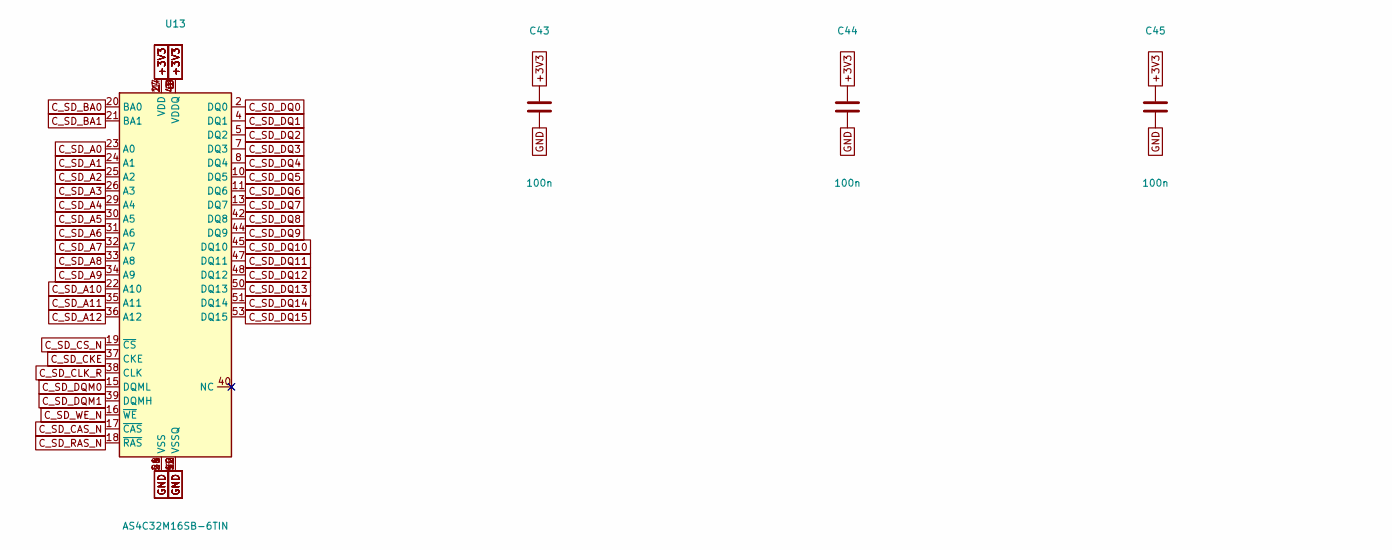
[picture p22: schematic sdram_c.kicad_sch, SDAES - carte CHA (sprites, couche fixe, Z80, RP2350) - SDR…, part in row 1, column 1]

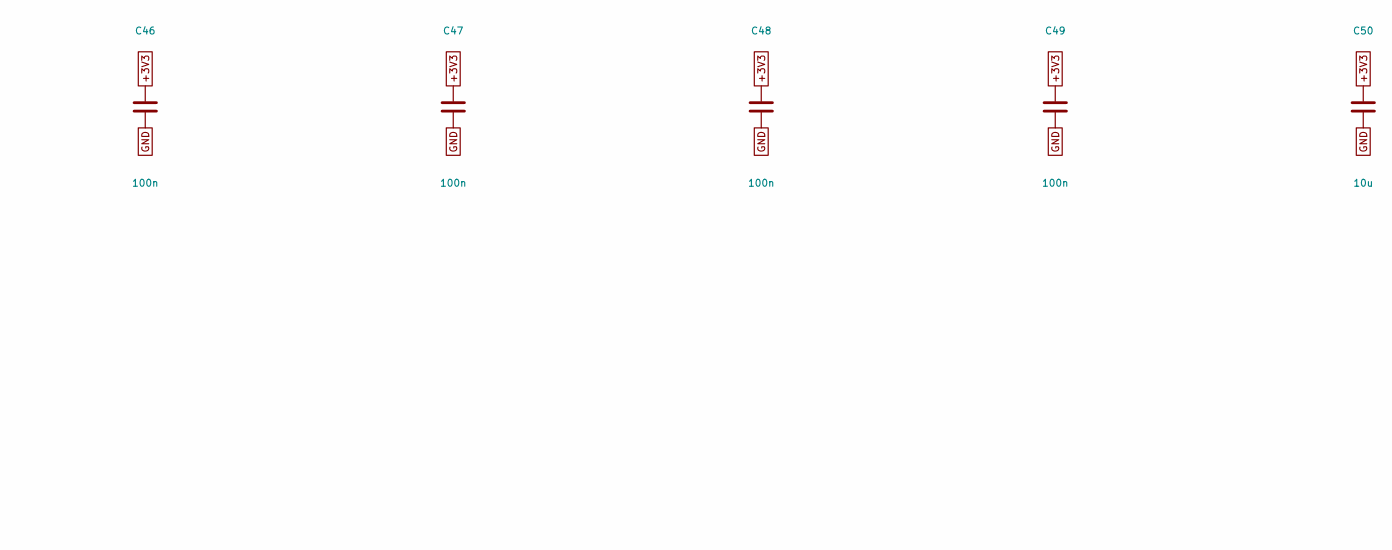
[picture p23: schematic sdram_c.kicad_sch, SDAES - carte CHA (sprites, couche fixe, Z80, RP2350) - SDR…, part in row 1, column 2]

Parts:
C43, C44, C45, C46, C47, C48, C49: 100n; C_0603_1608Metric
C50: 10u; C_0805_2012Metric
U13: AS4C32M16SB-6TIN; TSOP-II-54_22.2x10.16mm_P0.8mm

Connections:
+3V3: C43.1, C44.1, C45.1, C46.1, C47.1, C48.1, C49.1, C50.1, U13.1 (VDD), U13.3 (VDDQ), U13.9 (VDDQ), U13.14 (VDD), U13.27 (VDD), U13.43 (VDDQ), U13.49 (VDDQ); also elsewhere on the board
C_SD_A0: U13.23 (A0); also elsewhere on the board
C_SD_A1: U13.24 (A1); also elsewhere on the board
C_SD_A2: U13.25 (A2); also elsewhere on the board
C_SD_A3: U13.26 (A3); also elsewhere on the board
C_SD_A4: U13.29 (A4); also elsewhere on the board
C_SD_A5: U13.30 (A5); also elsewhere on the board
C_SD_A6: U13.31 (A6); also elsewhere on the board
C_SD_A7: U13.32 (A7); also elsewhere on the board
C_SD_A8: U13.33 (A8); also elsewhere on the board
C_SD_A9: U13.34 (A9); also elsewhere on the board
C_SD_A10: U13.22 (A10); also elsewhere on the board
C_SD_A11: U13.35 (A11); also elsewhere on the board
C_SD_A12: U13.36 (A12); also elsewhere on the board
C_SD_BA0: U13.20 (BA0); also elsewhere on the board
C_SD_BA1: U13.21 (BA1); also elsewhere on the board
C_SD_CAS_N: U13.17 (~CAS); also elsewhere on the board
C_SD_CKE: U13.37 (CKE); also elsewhere on the board
C_SD_CLK_R: U13.38 (CLK); also elsewhere on the board
C_SD_CS_N: U13.19 (~CS); also elsewhere on the board
C_SD_DQ0: U13.2 (DQ0); also elsewhere on the board
C_SD_DQ1: U13.4 (DQ1); also elsewhere on the board
C_SD_DQ2: U13.5 (DQ2); also elsewhere on the board
C_SD_DQ3: U13.7 (DQ3); also elsewhere on the board
C_SD_DQ4: U13.8 (DQ4); also elsewhere on the board
C_SD_DQ5: U13.10 (DQ5); also elsewhere on the board
C_SD_DQ6: U13.11 (DQ6); also elsewhere on the board
C_SD_DQ7: U13.13 (DQ7); also elsewhere on the board
C_SD_DQ8: U13.42 (DQ8); also elsewhere on the board
C_SD_DQ9: U13.44 (DQ9); also elsewhere on the board
C_SD_DQ10: U13.45 (DQ10); also elsewhere on the board
C_SD_DQ11: U13.47 (DQ11); also elsewhere on the board
C_SD_DQ12: U13.48 (DQ12); also elsewhere on the board
C_SD_DQ13: U13.50 (DQ13); also elsewhere on the board
C_SD_DQ14: U13.51 (DQ14); also elsewhere on the board
C_SD_DQ15: U13.53 (DQ15); also elsewhere on the board
C_SD_DQM0: U13.15 (DQML); also elsewhere on the board
C_SD_DQM1: U13.39 (DQMH); also elsewhere on the board
C_SD_RAS_N: U13.18 (~RAS); also elsewhere on the board
C_SD_WE_N: U13.16 (~WE); also elsewhere on the board
GND: C43.2, C44.2, C45.2, C46.2, C47.2, C48.2, C49.2, C50.2, U13.6 (VSSQ), U13.12 (VSSQ), U13.28 (VSS), U13.41 (VSS), U13.46 (VSSQ), U13.52 (VSSQ), U13.54 (VSS); also elsewhere on the board

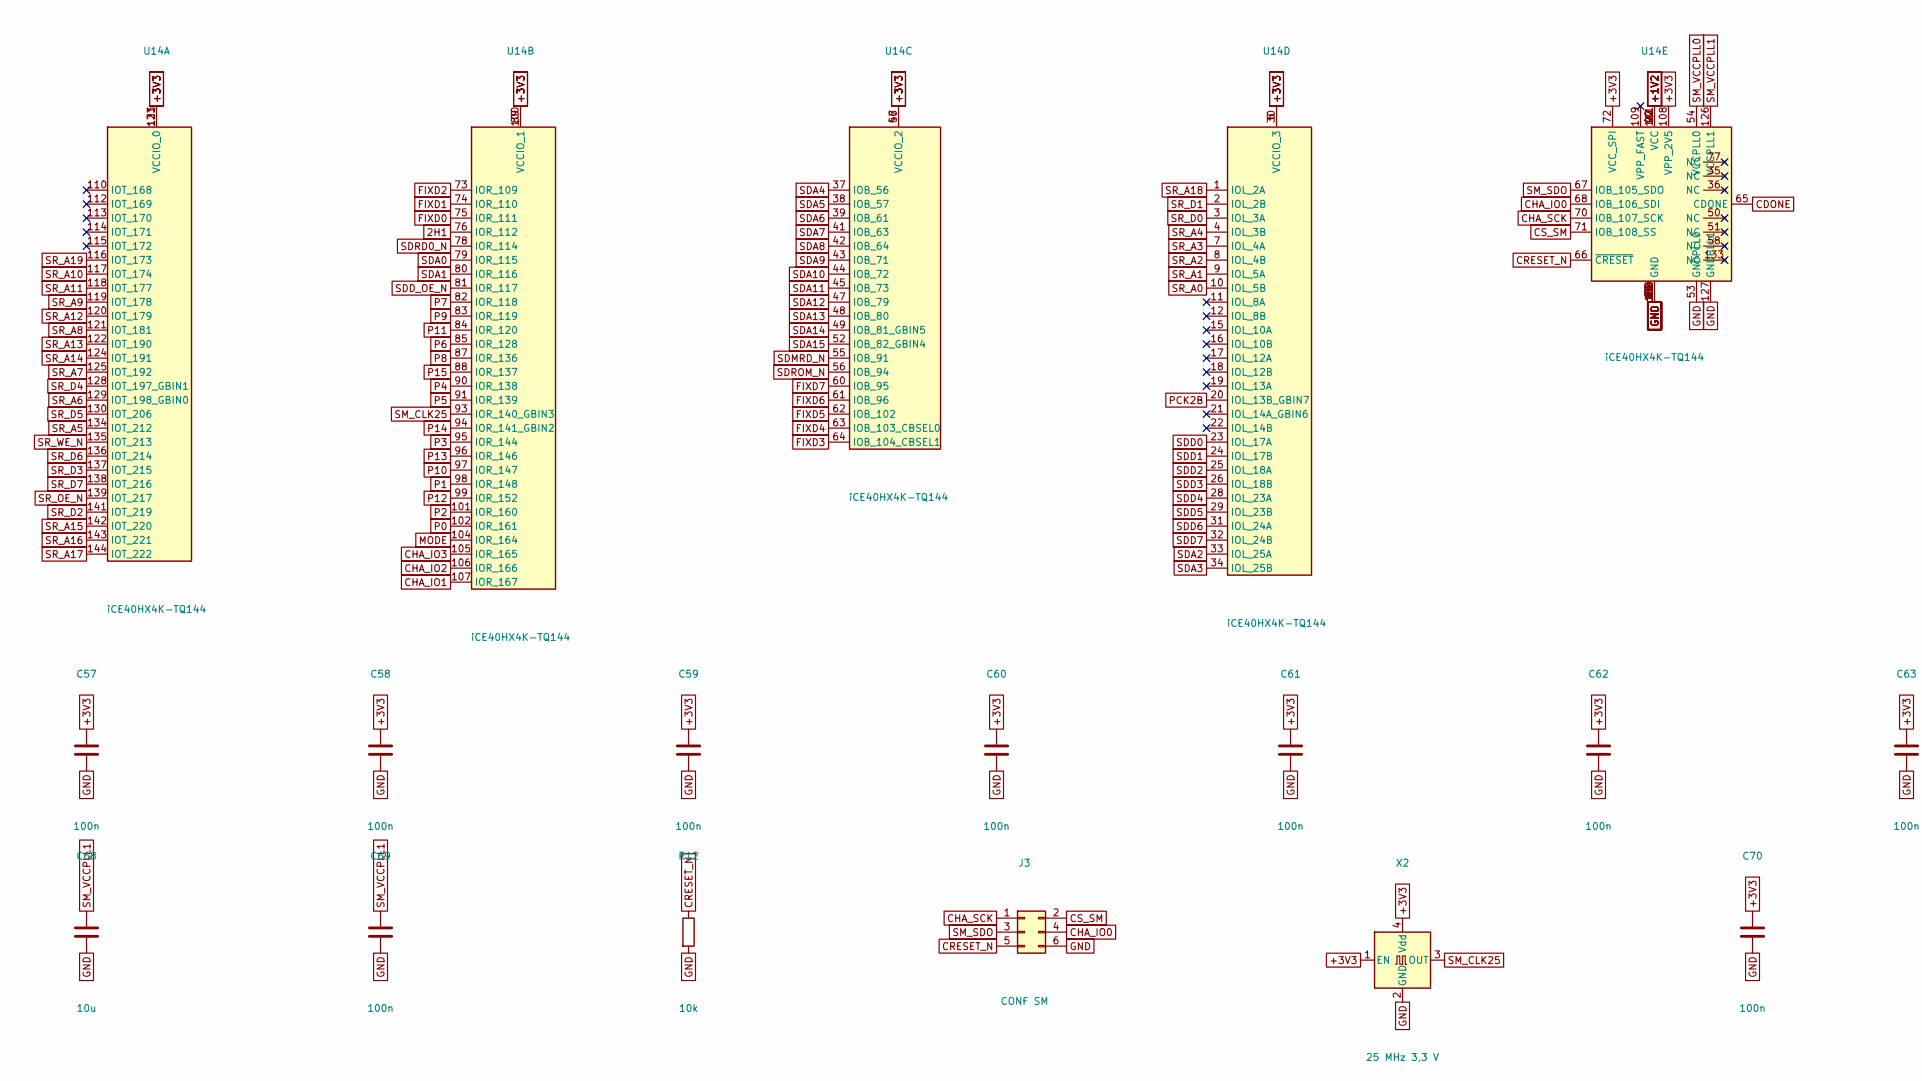
[picture p24: schematic fpga_sm.kicad_sch, SDAES - carte CHA (sprites, couche fixe, Z80, RP2350) - FPG…, part in row 1, column 1]

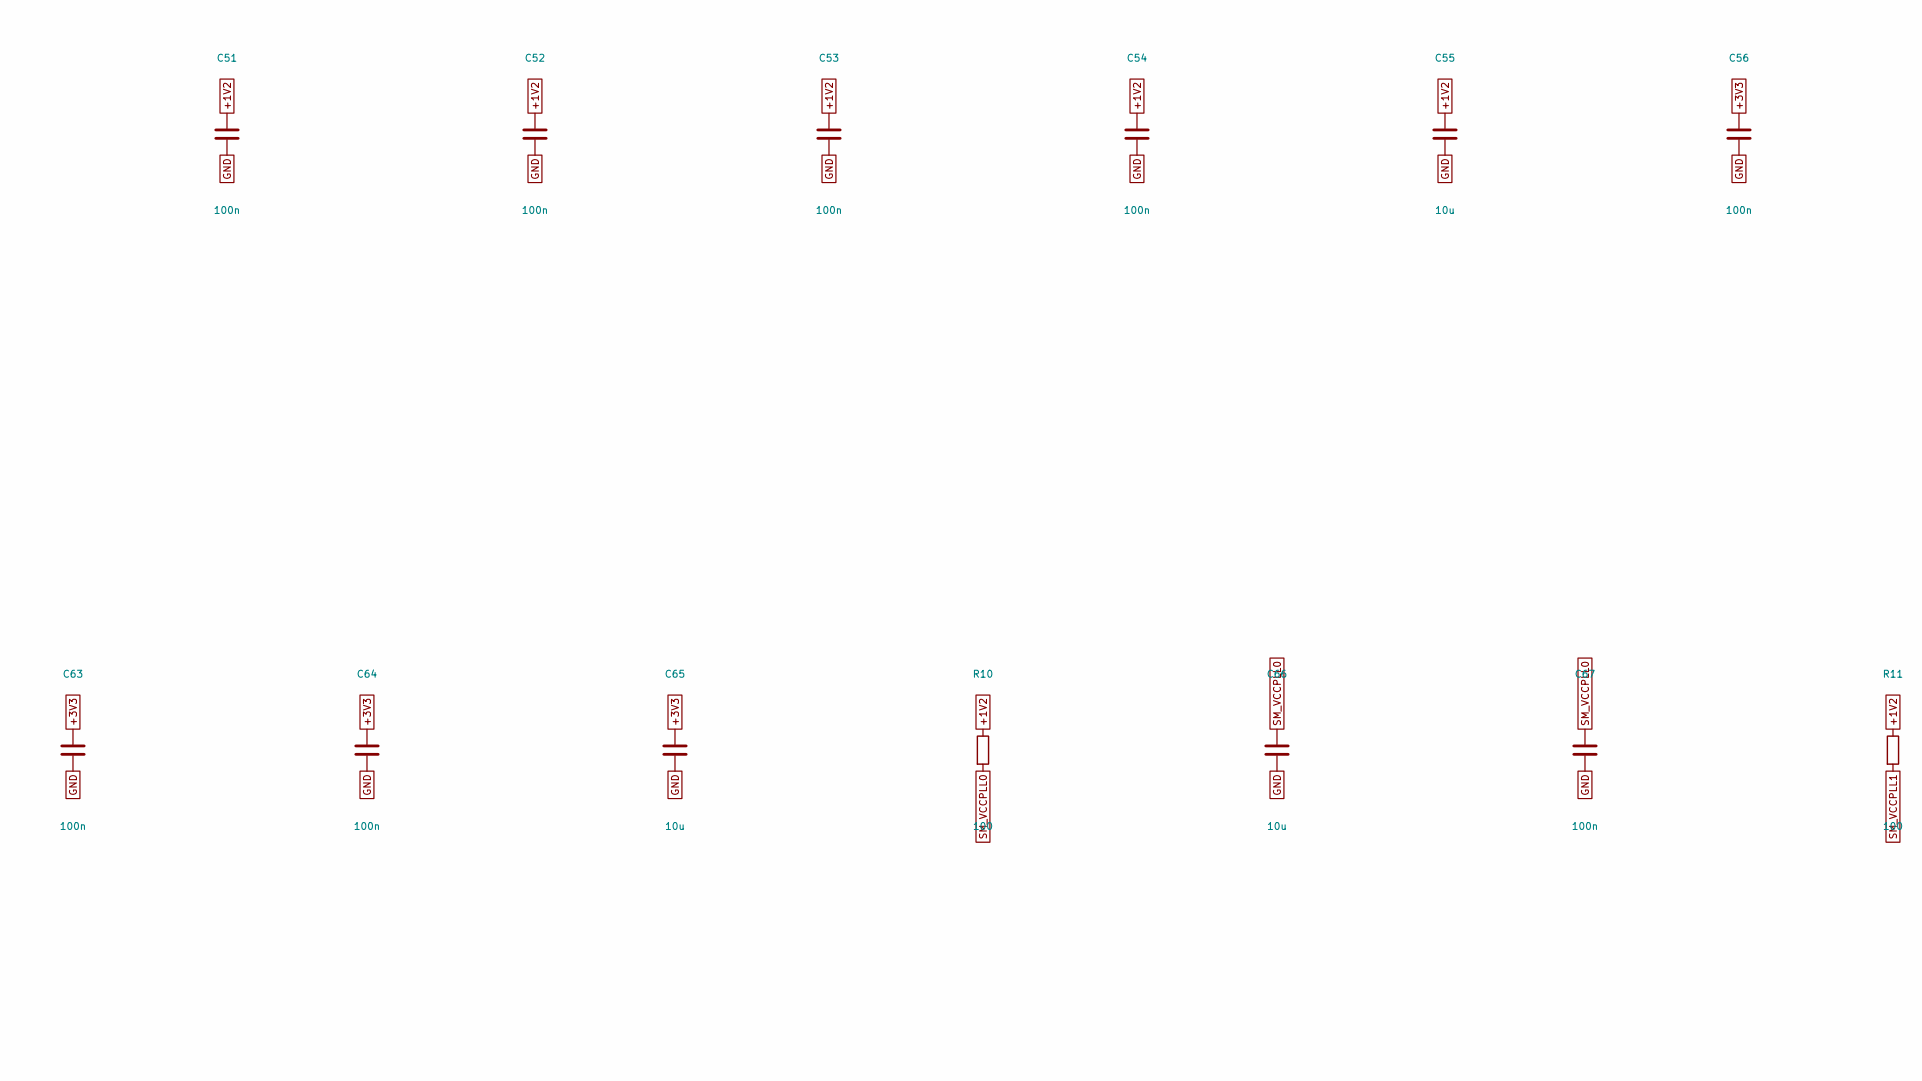
[picture p25: schematic fpga_sm.kicad_sch, SDAES - carte CHA (sprites, couche fixe, Z80, RP2350) - FPG…, part in row 1, column 2]

Parts:
C51, C52, C53, C54, C56, C57, C58, C59, C60, C61, C62, C63, C64, C67, C69, C70: 100n; C_0603_1608Metric
C55, C65, C66, C68: 10u; C_0805_2012Metric
J3: CONF SM; PinHeader_2x03_P2.54mm_Vertical
R10, R11: 100; R_0603_1608Metric
R12: 10k; R_0603_1608Metric
U14: iCE40HX4K-TQ144; TQFP-144_20x20mm_P0.5mm
X2: 25 MHz 3,3 V; Oscillator_SMD_Abracon_ASE-4Pin_3.2x2.5mm_HandSoldering

Connections:
2H1: U14.76 (IOR_112); also elsewhere on the board
+1V2: C51.1, C52.1, C53.1, C54.1, C55.1, R10.1, R11.1, U14.27 (VCC), U14.40 (VCC), U14.92 (VCC), U14.111 (VCC); also elsewhere on the board
+3V3: C56.1, C57.1, C58.1, C59.1, C60.1, C61.1, C62.1, C63.1, C64.1, C65.1, C70.1, U14.6 (VCCIO_3), U14.30 (VCCIO_3), U14.46 (VCCIO_2), U14.57 (VCCIO_2), U14.72 (VCC_SPI), U14.89 (VCCIO_1), U14.100 (VCCIO_1), U14.108 (VPP_2V5), U14.123 (VCCIO_0), U14.131 (VCCIO_0), X2.1 (EN), X2.4 (Vdd); also elsewhere on the board
CDONE: U14.65 (CDONE); also elsewhere on the board
CHA_IO0: J3.4, U14.68 (IOB_106_SDI); also elsewhere on the board
CHA_IO1: U14.107 (IOR_167); also elsewhere on the board
CHA_IO2: U14.106 (IOR_166); also elsewhere on the board
CHA_IO3: U14.105 (IOR_165); also elsewhere on the board
CHA_SCK: J3.1, U14.70 (IOB_107_SCK); also elsewhere on the board
CRESET_N: J3.5, R12.1, U14.66 (~CRESET); also elsewhere on the board
CS_SM: J3.2, U14.71 (IOB_108_SS); also elsewhere on the board
FIXD0: U14.75 (IOR_111); also elsewhere on the board
FIXD1: U14.74 (IOR_110); also elsewhere on the board
FIXD2: U14.73 (IOR_109); also elsewhere on the board
FIXD3: U14.64 (IOB_104_CBSEL1); also elsewhere on the board
FIXD4: U14.63 (IOB_103_CBSEL0); also elsewhere on the board
FIXD5: U14.62 (IOB_102); also elsewhere on the board
FIXD6: U14.61 (IOB_96); also elsewhere on the board
FIXD7: U14.60 (IOB_95); also elsewhere on the board
GND: C51.2, C52.2, C53.2, C54.2, C55.2, C56.2, C57.2, C58.2, C59.2, C60.2, C61.2, C62.2, C63.2, C64.2, C65.2, C66.2, C67.2, C68.2, C69.2, C70.2, J3.6, R12.2, U14.5 (GND), U14.13 (GND), U14.14 (GND), U14.53 (GNDPLL0), U14.59 (GND), U14.69 (GND), U14.86 (GND), U14.103 (GND), U14.127 (GNDPLL1), U14.132 (GND), U14.140 (GND), X2.2 (GND); also elsewhere on the board
MODE: U14.104 (IOR_164); also elsewhere on the board
P0: U14.102 (IOR_161); also elsewhere on the board
P1: U14.98 (IOR_148); also elsewhere on the board
P2: U14.101 (IOR_160); also elsewhere on the board
P3: U14.95 (IOR_144); also elsewhere on the board
P4: U14.90 (IOR_138); also elsewhere on the board
P5: U14.91 (IOR_139); also elsewhere on the board
P6: U14.85 (IOR_128); also elsewhere on the board
P7: U14.82 (IOR_118); also elsewhere on the board
P8: U14.87 (IOR_136); also elsewhere on the board
P9: U14.83 (IOR_119); also elsewhere on the board
P10: U14.97 (IOR_147); also elsewhere on the board
P11: U14.84 (IOR_120); also elsewhere on the board
P12: U14.99 (IOR_152); also elsewhere on the board
P13: U14.96 (IOR_146); also elsewhere on the board
P14: U14.94 (IOR_141_GBIN2); also elsewhere on the board
P15: U14.88 (IOR_137); also elsewhere on the board
PCK2B: U14.20 (IOL_13B_GBIN7); also elsewhere on the board
SDA0: U14.79 (IOR_115); also elsewhere on the board
SDA1: U14.80 (IOR_116); also elsewhere on the board
SDA2: U14.33 (IOL_25A); also elsewhere on the board
SDA3: U14.34 (IOL_25B); also elsewhere on the board
SDA4: U14.37 (IOB_56); also elsewhere on the board
SDA5: U14.38 (IOB_57); also elsewhere on the board
SDA6: U14.39 (IOB_61); also elsewhere on the board
SDA7: U14.41 (IOB_63); also elsewhere on the board
SDA8: U14.42 (IOB_64); also elsewhere on the board
SDA9: U14.43 (IOB_71); also elsewhere on the board
SDA10: U14.44 (IOB_72); also elsewhere on the board
SDA11: U14.45 (IOB_73); also elsewhere on the board
SDA12: U14.47 (IOB_79); also elsewhere on the board
SDA13: U14.48 (IOB_80); also elsewhere on the board
SDA14: U14.49 (IOB_81_GBIN5); also elsewhere on the board
SDA15: U14.52 (IOB_82_GBIN4); also elsewhere on the board
SDD0: U14.23 (IOL_17A); also elsewhere on the board
SDD1: U14.24 (IOL_17B); also elsewhere on the board
SDD2: U14.25 (IOL_18A); also elsewhere on the board
SDD3: U14.26 (IOL_18B); also elsewhere on the board
SDD4: U14.28 (IOL_23A); also elsewhere on the board
SDD5: U14.29 (IOL_23B); also elsewhere on the board
SDD6: U14.31 (IOL_24A); also elsewhere on the board
SDD7: U14.32 (IOL_24B); also elsewhere on the board
SDD_OE_N: U14.81 (IOR_117); also elsewhere on the board
SDMRD_N: U14.55 (IOB_91); also elsewhere on the board
SDRD0_N: U14.78 (IOR_114); also elsewhere on the board
SDROM_N: U14.56 (IOB_94); also elsewhere on the board
SM_CLK25: U14.93 (IOR_140_GBIN3), X2.3 (OUT)
SM_SDO: J3.3, U14.67 (IOB_105_SDO)
SM_VCCPLL0: C66.1, C67.1, R10.2, U14.54 (VCCPLL0)
SM_VCCPLL1: C68.1, C69.1, R11.2, U14.126 (VCCPLL1)
SR_A0: U14.10 (IOL_5B); also elsewhere on the board
SR_A1: U14.9 (IOL_5A); also elsewhere on the board
SR_A2: U14.8 (IOL_4B); also elsewhere on the board
SR_A3: U14.7 (IOL_4A); also elsewhere on the board
SR_A4: U14.4 (IOL_3B); also elsewhere on the board
SR_A5: U14.134 (IOT_212); also elsewhere on the board
SR_A6: U14.129 (IOT_198_GBIN0); also elsewhere on the board
SR_A7: U14.125 (IOT_192); also elsewhere on the board
SR_A8: U14.121 (IOT_181); also elsewhere on the board
SR_A9: U14.119 (IOT_178); also elsewhere on the board
SR_A10: U14.117 (IOT_174); also elsewhere on the board
SR_A11: U14.118 (IOT_177); also elsewhere on the board
SR_A12: U14.120 (IOT_179); also elsewhere on the board
SR_A13: U14.122 (IOT_190); also elsewhere on the board
SR_A14: U14.124 (IOT_191); also elsewhere on the board
SR_A15: U14.142 (IOT_220); also elsewhere on the board
SR_A16: U14.143 (IOT_221); also elsewhere on the board
SR_A17: U14.144 (IOT_222); also elsewhere on the board
SR_A18: U14.1 (IOL_2A); also elsewhere on the board
SR_A19: U14.116 (IOT_173); also elsewhere on the board
SR_D0: U14.3 (IOL_3A); also elsewhere on the board
SR_D1: U14.2 (IOL_2B); also elsewhere on the board
SR_D2: U14.141 (IOT_219); also elsewhere on the board
SR_D3: U14.137 (IOT_215); also elsewhere on the board
SR_D4: U14.128 (IOT_197_GBIN1); also elsewhere on the board
SR_D5: U14.130 (IOT_206); also elsewhere on the board
SR_D6: U14.136 (IOT_214); also elsewhere on the board
SR_D7: U14.138 (IOT_216); also elsewhere on the board
SR_OE_N: U14.139 (IOT_217); also elsewhere on the board
SR_WE_N: U14.135 (IOT_213); also elsewhere on the board

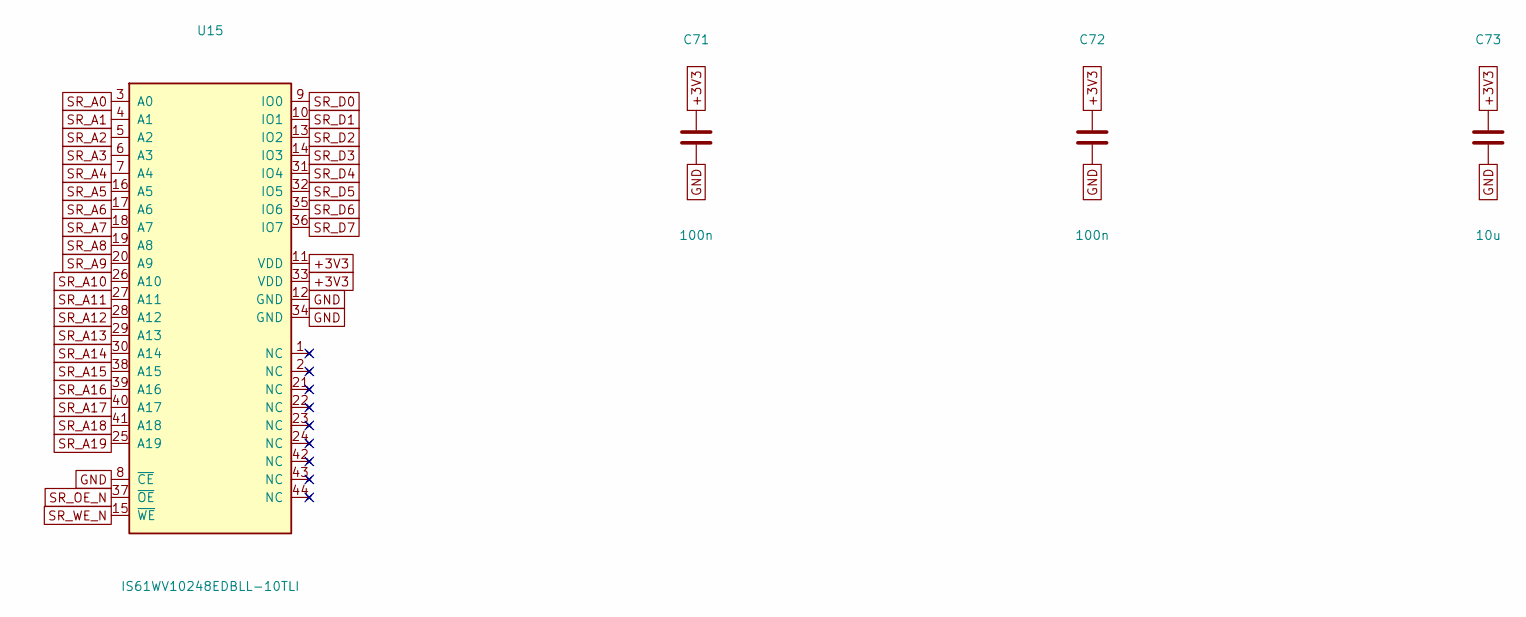
[picture p26: schematic sram.kicad_sch, SDAES - carte CHA (sprites, couche fixe, Z80, RP2350) - SRA…]

Parts:
C71, C72: 100n; C_0603_1608Metric
C73: 10u; C_0805_2012Metric
U15: IS61WV10248EDBLL-10TLI; TSOP-II-44_10.16x18.41mm_P0.8mm

Connections:
+3V3: C71.1, C72.1, C73.1, U15.11 (VDD), U15.33 (VDD); also elsewhere on the board
GND: C71.2, C72.2, C73.2, U15.8 (~CE), U15.12 (GND), U15.34 (GND); also elsewhere on the board
SR_A0: U15.3 (A0); also elsewhere on the board
SR_A1: U15.4 (A1); also elsewhere on the board
SR_A2: U15.5 (A2); also elsewhere on the board
SR_A3: U15.6 (A3); also elsewhere on the board
SR_A4: U15.7 (A4); also elsewhere on the board
SR_A5: U15.16 (A5); also elsewhere on the board
SR_A6: U15.17 (A6); also elsewhere on the board
SR_A7: U15.18 (A7); also elsewhere on the board
SR_A8: U15.19 (A8); also elsewhere on the board
SR_A9: U15.20 (A9); also elsewhere on the board
SR_A10: U15.26 (A10); also elsewhere on the board
SR_A11: U15.27 (A11); also elsewhere on the board
SR_A12: U15.28 (A12); also elsewhere on the board
SR_A13: U15.29 (A13); also elsewhere on the board
SR_A14: U15.30 (A14); also elsewhere on the board
SR_A15: U15.38 (A15); also elsewhere on the board
SR_A16: U15.39 (A16); also elsewhere on the board
SR_A17: U15.40 (A17); also elsewhere on the board
SR_A18: U15.41 (A18); also elsewhere on the board
SR_A19: U15.25 (A19); also elsewhere on the board
SR_D0: U15.9 (IO0); also elsewhere on the board
SR_D1: U15.10 (IO1); also elsewhere on the board
SR_D2: U15.13 (IO2); also elsewhere on the board
SR_D3: U15.14 (IO3); also elsewhere on the board
SR_D4: U15.31 (IO4); also elsewhere on the board
SR_D5: U15.32 (IO5); also elsewhere on the board
SR_D6: U15.35 (IO6); also elsewhere on the board
SR_D7: U15.36 (IO7); also elsewhere on the board
SR_OE_N: U15.37 (~OE); also elsewhere on the board
SR_WE_N: U15.15 (~WE); also elsewhere on the board

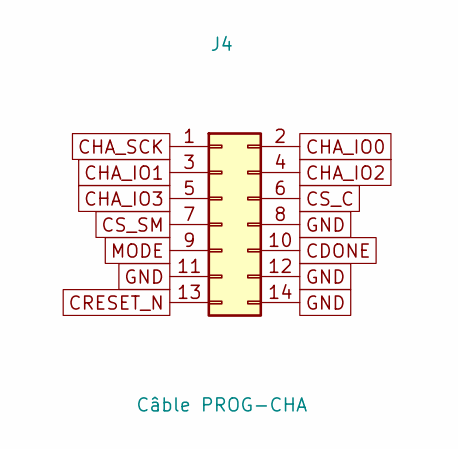
[picture p27: schematic power2.kicad_sch, SDAES - carte CHA (sprites, couche fixe, Z80, RP2350) - Con…]

Parts:
J4: Câble PROG-CHA; PinHeader_2x07_P2.54mm_Vertical

Connections:
CDONE: J4.10; also elsewhere on the board
CHA_IO0: J4.2; also elsewhere on the board
CHA_IO1: J4.3; also elsewhere on the board
CHA_IO2: J4.4; also elsewhere on the board
CHA_IO3: J4.5; also elsewhere on the board
CHA_SCK: J4.1; also elsewhere on the board
CRESET_N: J4.13; also elsewhere on the board
CS_C: J4.6; also elsewhere on the board
CS_SM: J4.7; also elsewhere on the board
GND: J4.8, J4.11, J4.12, J4.14; also elsewhere on the board
MODE: J4.9; also elsewhere on the board
