DocteurPCB/SDAES/hardware/kicad/cha/cha.kicad_pcb

## KiCad design hardware/kicad/cha/cha.kicad_pcb (continued)

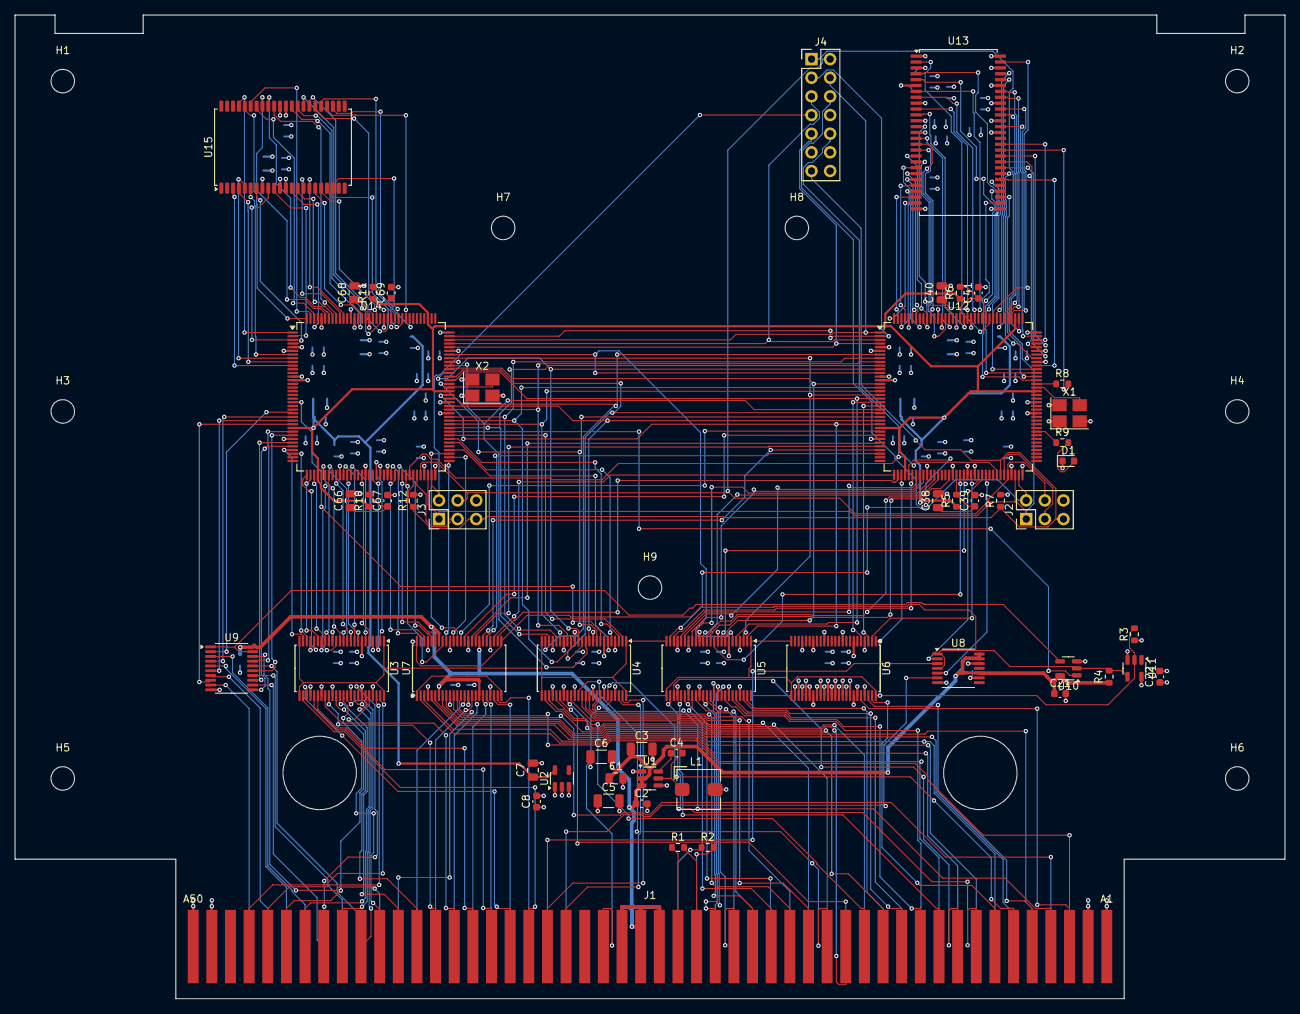
[picture p28: board cha.kicad_pcb from above]

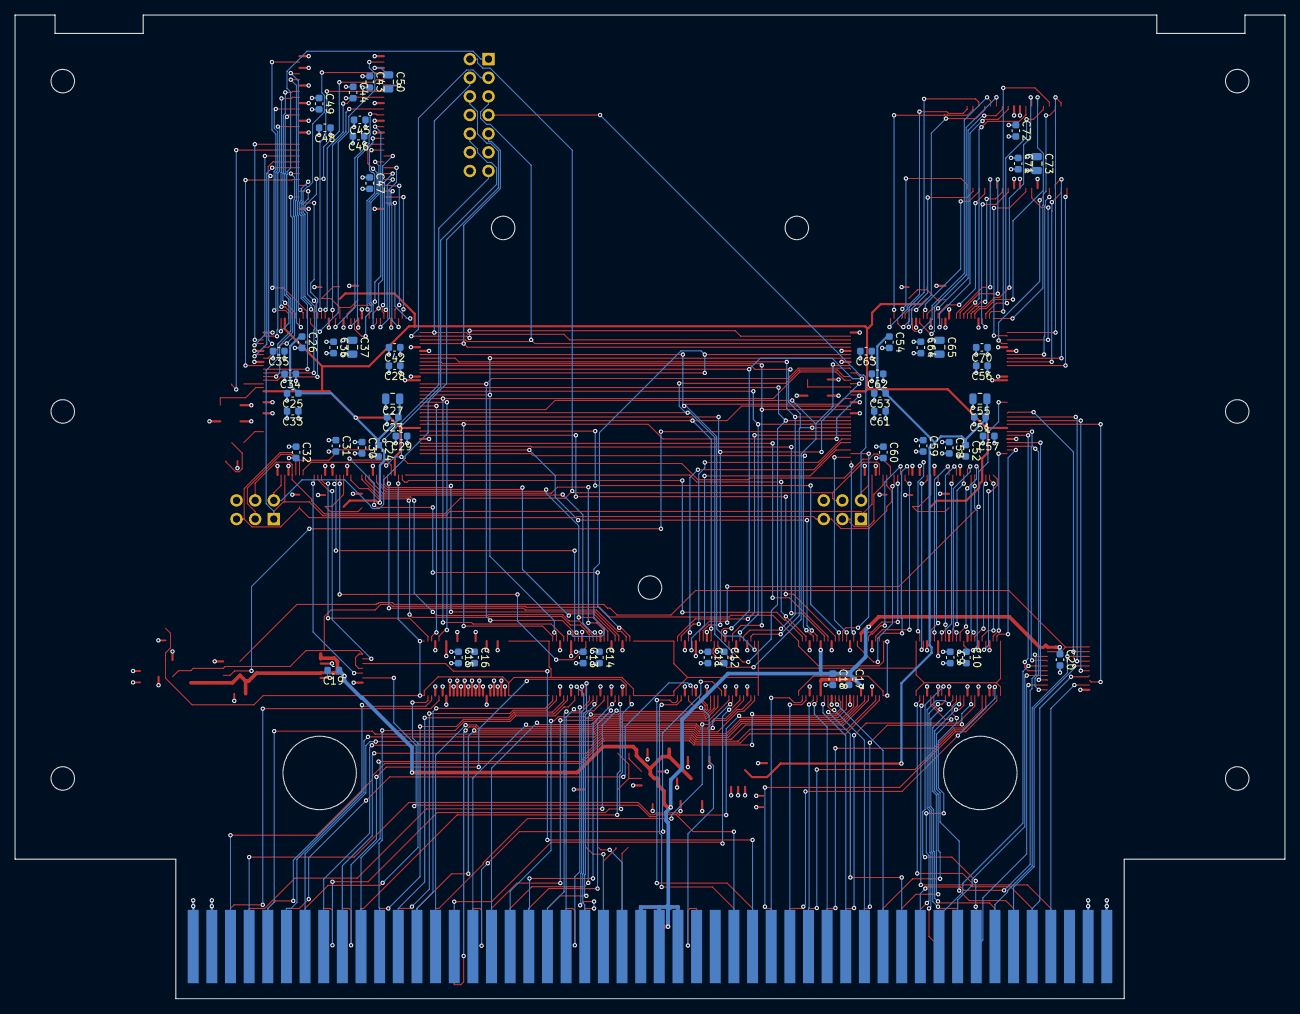
[picture p29: board cha.kicad_pcb from below]

Board: 4 copper layers, 173.0 x 134.0 mm, 117 parts (55 on the bottom side), 258 nets.

Other parts of the board:
H1, H2, H3, H4, H5, H6, H7, H8, H9: Entretoise M3; MountingHole_3.2mm_M3
