DocteurPCB/SDAES/hardware/kicad/prog/prog.kicad_pcb

## KiCad design hardware/kicad/prog/prog.kicad_pcb (2026-10-15)

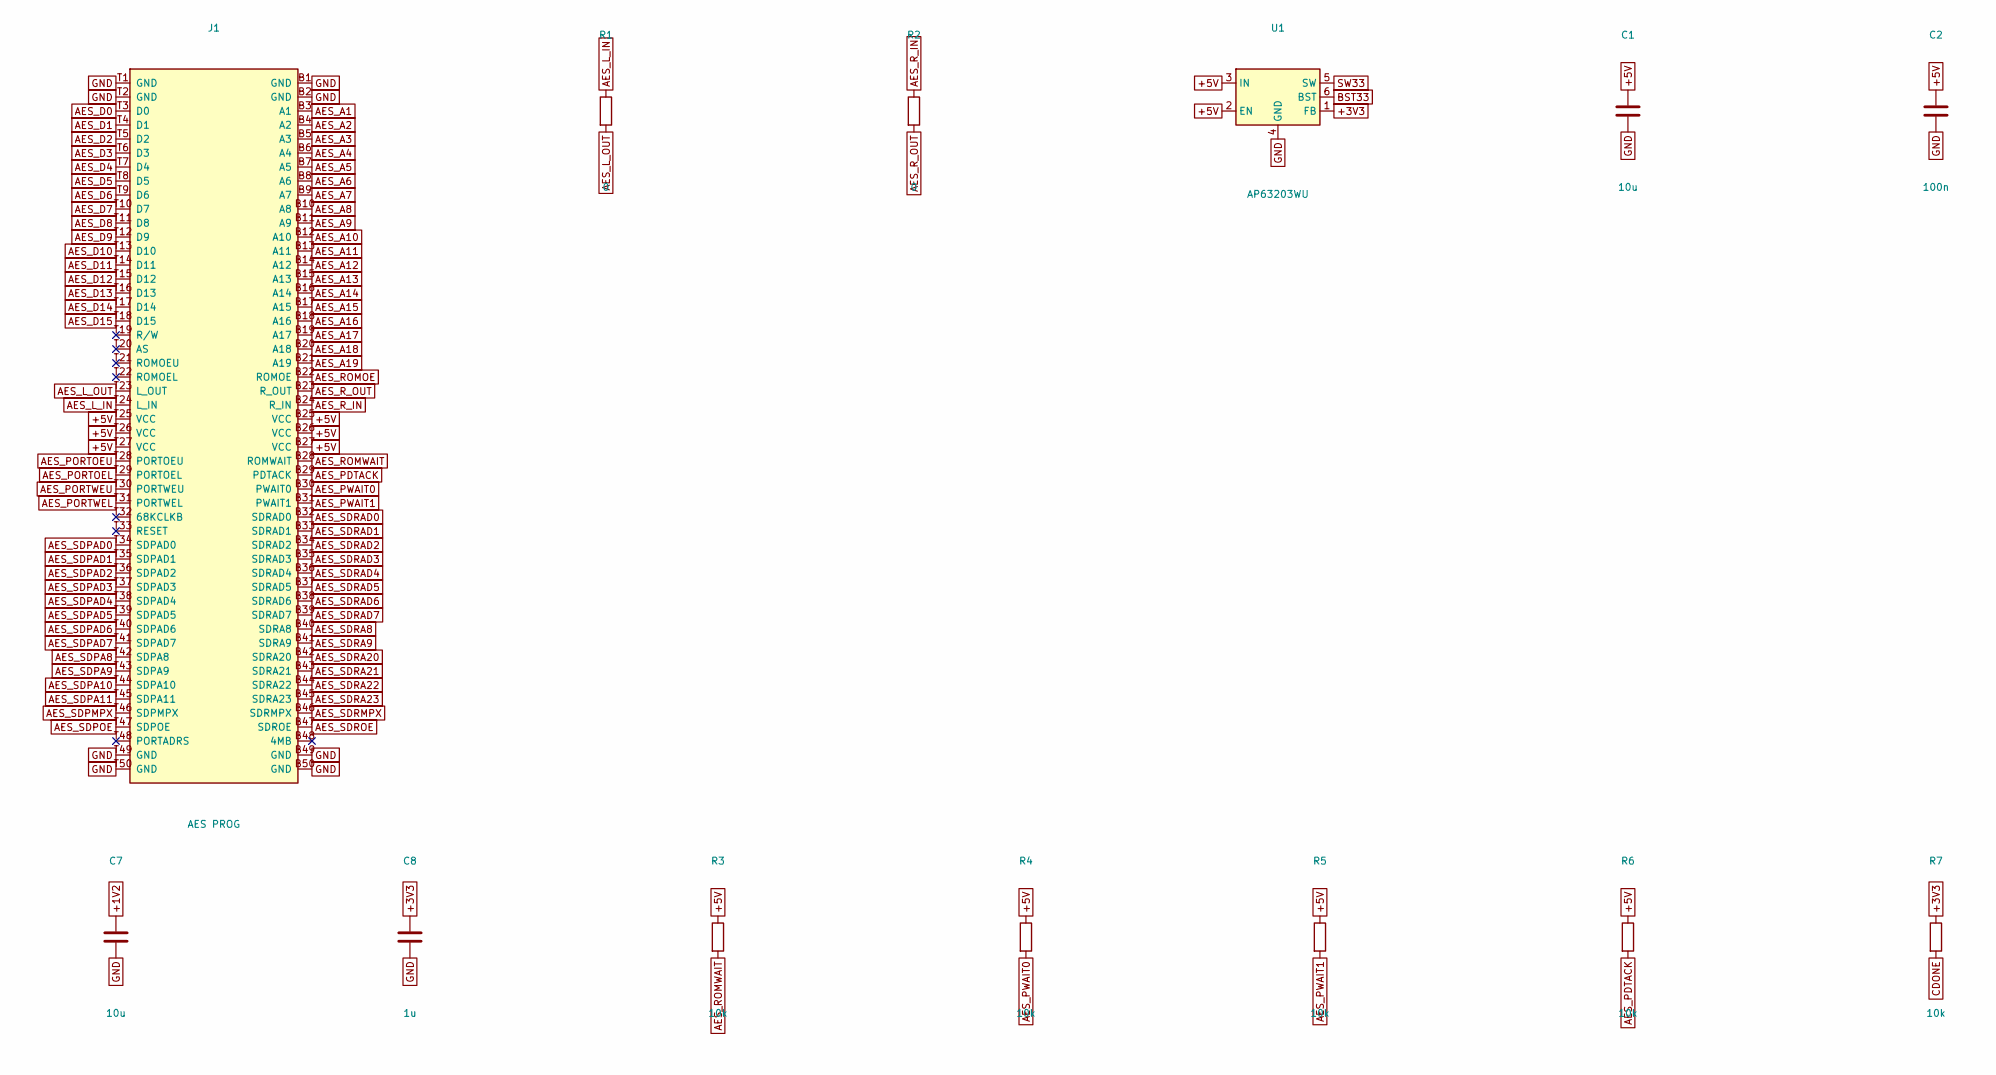
[picture p30: schematic power.kicad_sch, SDAES - carte PROG (programme 68000 + son ADPCM) - Connecte…, part in row 1, column 1]

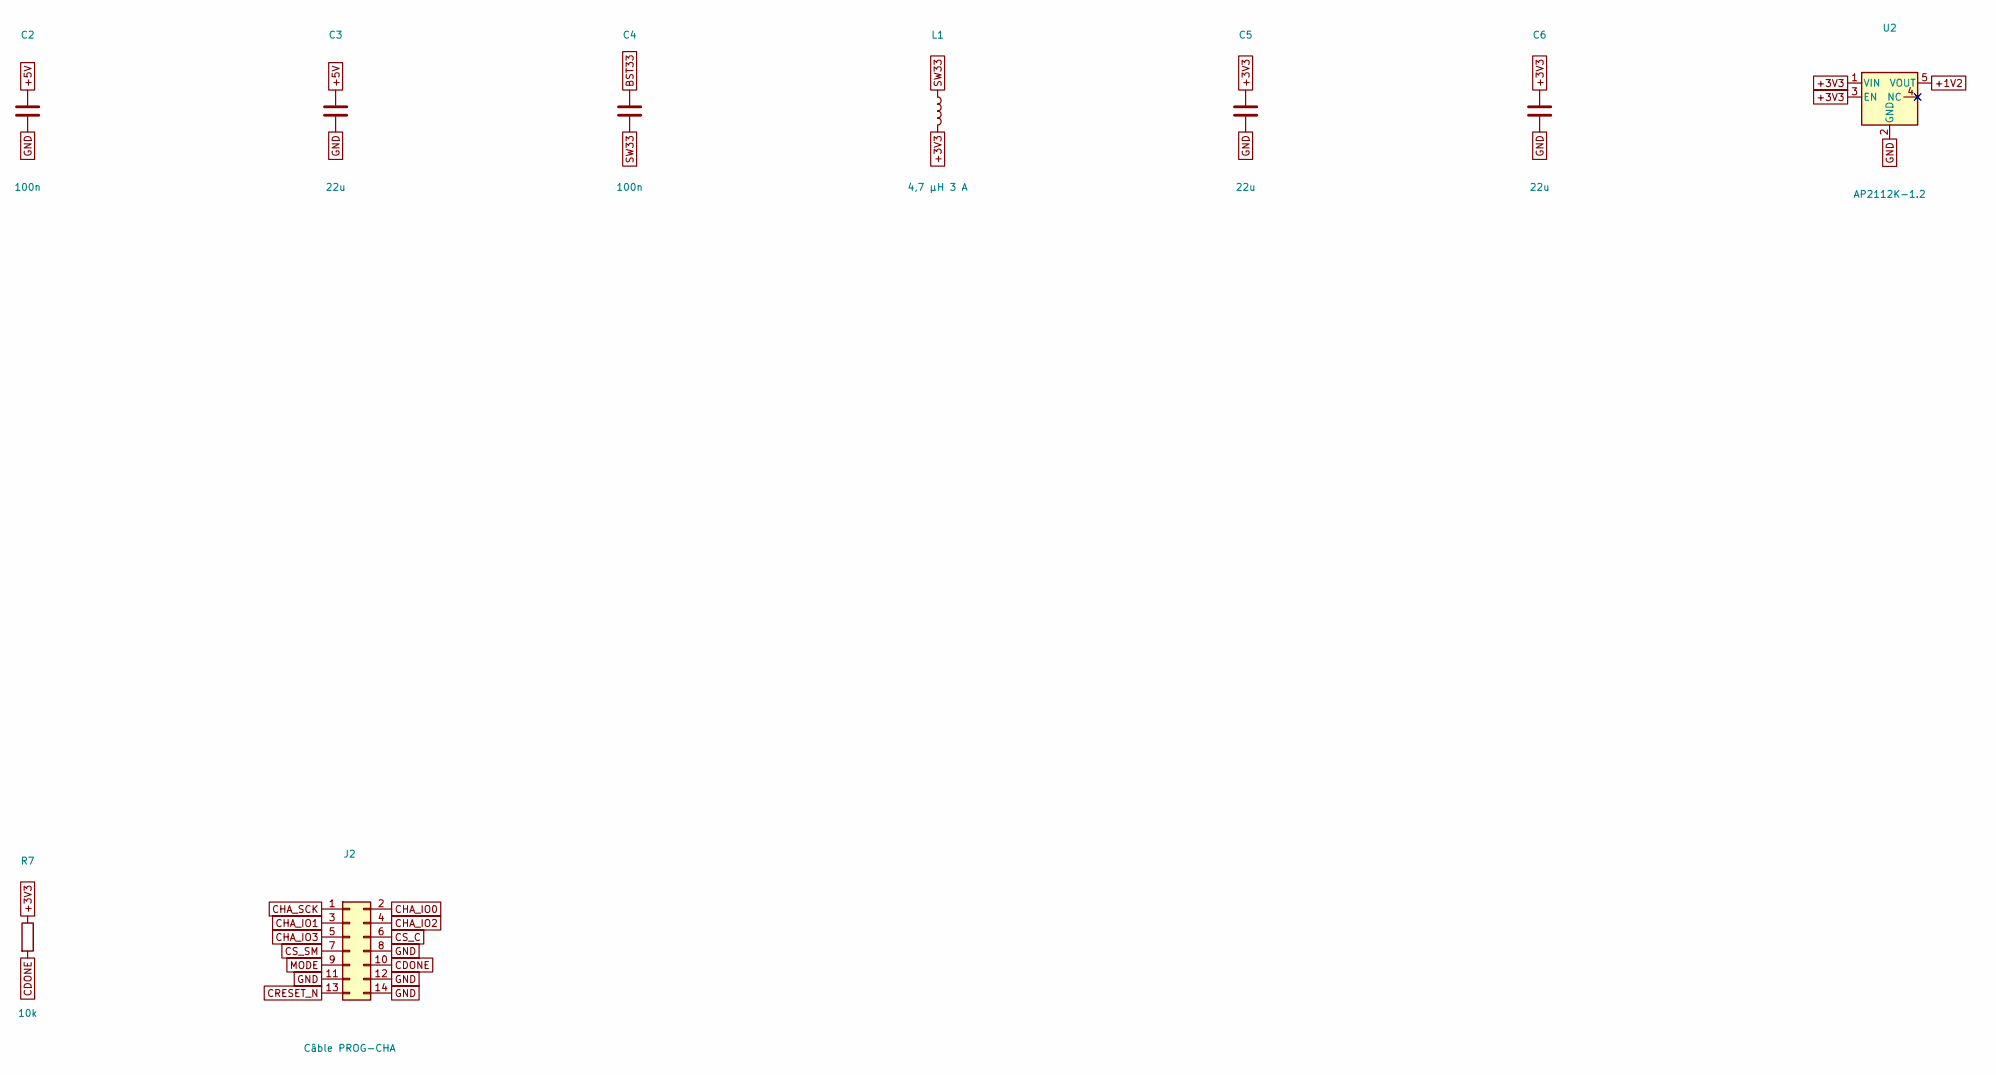
[picture p31: schematic power.kicad_sch, SDAES - carte PROG (programme 68000 + son ADPCM) - Connecte…, part in row 1, column 2]

Parts:
C1, C7: 10u; C_0805_2012Metric
C2, C4: 100n; C_0603_1608Metric
C3, C5, C6: 22u; C_1206_3216Metric
C8: 1u; C_0603_1608Metric
J1: AES PROG; AES_Edge_2x50_P2.54mm
J2: Câble PROG-CHA; PinHeader_2x07_P2.54mm_Vertical
L1: 4,7 µH 3 A; L_Bourns_SRP5030T
R1, R2: 0; R_0603_1608Metric
R3, R4, R5, R6, R7: 10k; R_0603_1608Metric
U1: AP63203WU; TSOT-23-6
U2: AP2112K-1.2; SOT-23-5

Connections:
+1V2: C7.1, U2.5 (VOUT); also elsewhere on the board
+3V3: C5.1, C6.1, C8.1, L1.2, R7.1, U1.1 (FB), U2.1 (VIN), U2.3 (EN); also elsewhere on the board
+5V: C1.1, C2.1, C3.1, J1.B25 (VCC), J1.B26 (VCC), J1.B27 (VCC), J1.T25 (VCC), J1.T26 (VCC), J1.T27 (VCC), R3.1, R4.1, R5.1, R6.1, U1.2 (EN), U1.3 (IN); also elsewhere on the board
AES_A1: J1.B3 (A1); also elsewhere on the board
AES_A2: J1.B4 (A2); also elsewhere on the board
AES_A3: J1.B5 (A3); also elsewhere on the board
AES_A4: J1.B6 (A4); also elsewhere on the board
AES_A5: J1.B7 (A5); also elsewhere on the board
AES_A6: J1.B8 (A6); also elsewhere on the board
AES_A7: J1.B9 (A7); also elsewhere on the board
AES_A8: J1.B10 (A8); also elsewhere on the board
AES_A9: J1.B11 (A9); also elsewhere on the board
AES_A10: J1.B12 (A10); also elsewhere on the board
AES_A11: J1.B13 (A11); also elsewhere on the board
AES_A12: J1.B14 (A12); also elsewhere on the board
AES_A13: J1.B15 (A13); also elsewhere on the board
AES_A14: J1.B16 (A14); also elsewhere on the board
AES_A15: J1.B17 (A15); also elsewhere on the board
AES_A16: J1.B18 (A16); also elsewhere on the board
AES_A17: J1.B19 (A17); also elsewhere on the board
AES_A18: J1.B20 (A18); also elsewhere on the board
AES_A19: J1.B21 (A19); also elsewhere on the board
AES_D0: J1.T3 (D0); also elsewhere on the board
AES_D1: J1.T4 (D1); also elsewhere on the board
AES_D2: J1.T5 (D2); also elsewhere on the board
AES_D3: J1.T6 (D3); also elsewhere on the board
AES_D4: J1.T7 (D4); also elsewhere on the board
AES_D5: J1.T8 (D5); also elsewhere on the board
AES_D6: J1.T9 (D6); also elsewhere on the board
AES_D7: J1.T10 (D7); also elsewhere on the board
AES_D8: J1.T11 (D8); also elsewhere on the board
AES_D9: J1.T12 (D9); also elsewhere on the board
AES_D10: J1.T13 (D10); also elsewhere on the board
AES_D11: J1.T14 (D11); also elsewhere on the board
AES_D12: J1.T15 (D12); also elsewhere on the board
AES_D13: J1.T16 (D13); also elsewhere on the board
AES_D14: J1.T17 (D14); also elsewhere on the board
AES_D15: J1.T18 (D15); also elsewhere on the board
AES_L_IN: J1.T24 (L_IN), R1.1
AES_L_OUT: J1.T23 (L_OUT), R1.2
AES_PDTACK: J1.B29 (PDTACK), R6.2
AES_PORTOEL: J1.T29 (PORTOEL); also elsewhere on the board
AES_PORTOEU: J1.T28 (PORTOEU); also elsewhere on the board
AES_PORTWEL: J1.T31 (PORTWEL); also elsewhere on the board
AES_PORTWEU: J1.T30 (PORTWEU); also elsewhere on the board
AES_PWAIT0: J1.B30 (PWAIT0), R4.2; also elsewhere on the board
AES_PWAIT1: J1.B31 (PWAIT1), R5.2; also elsewhere on the board
AES_ROMOE: J1.B22 (ROMOE); also elsewhere on the board
AES_ROMWAIT: J1.B28 (ROMWAIT), R3.2; also elsewhere on the board
AES_R_IN: J1.B24 (R_IN), R2.1
AES_R_OUT: J1.B23 (R_OUT), R2.2
AES_SDPA8: J1.T42 (SDPA8); also elsewhere on the board
AES_SDPA9: J1.T43 (SDPA9); also elsewhere on the board
AES_SDPA10: J1.T44 (SDPA10); also elsewhere on the board
AES_SDPA11: J1.T45 (SDPA11); also elsewhere on the board
AES_SDPAD0: J1.T34 (SDPAD0); also elsewhere on the board
AES_SDPAD1: J1.T35 (SDPAD1); also elsewhere on the board
AES_SDPAD2: J1.T36 (SDPAD2); also elsewhere on the board
AES_SDPAD3: J1.T37 (SDPAD3); also elsewhere on the board
AES_SDPAD4: J1.T38 (SDPAD4); also elsewhere on the board
AES_SDPAD5: J1.T39 (SDPAD5); also elsewhere on the board
AES_SDPAD6: J1.T40 (SDPAD6); also elsewhere on the board
AES_SDPAD7: J1.T41 (SDPAD7); also elsewhere on the board
AES_SDPMPX: J1.T46 (SDPMPX); also elsewhere on the board
AES_SDPOE: J1.T47 (SDPOE); also elsewhere on the board
AES_SDRA8: J1.B40 (SDRA8); also elsewhere on the board
AES_SDRA9: J1.B41 (SDRA9); also elsewhere on the board
AES_SDRA20: J1.B42 (SDRA20); also elsewhere on the board
AES_SDRA21: J1.B43 (SDRA21); also elsewhere on the board
AES_SDRA22: J1.B44 (SDRA22); also elsewhere on the board
AES_SDRA23: J1.B45 (SDRA23); also elsewhere on the board
AES_SDRAD0: J1.B32 (SDRAD0); also elsewhere on the board
AES_SDRAD1: J1.B33 (SDRAD1); also elsewhere on the board
AES_SDRAD2: J1.B34 (SDRAD2); also elsewhere on the board
AES_SDRAD3: J1.B35 (SDRAD3); also elsewhere on the board
AES_SDRAD4: J1.B36 (SDRAD4); also elsewhere on the board
AES_SDRAD5: J1.B37 (SDRAD5); also elsewhere on the board
AES_SDRAD6: J1.B38 (SDRAD6); also elsewhere on the board
AES_SDRAD7: J1.B39 (SDRAD7); also elsewhere on the board
AES_SDRMPX: J1.B46 (SDRMPX); also elsewhere on the board
AES_SDROE: J1.B47 (SDROE); also elsewhere on the board
BST33: C4.1, U1.6 (BST)
CDONE: J2.10, R7.2; also elsewhere on the board
CHA_IO0: J2.2; also elsewhere on the board
CHA_IO1: J2.3; also elsewhere on the board
CHA_IO2: J2.4; also elsewhere on the board
CHA_IO3: J2.5; also elsewhere on the board
CHA_SCK: J2.1; also elsewhere on the board
CRESET_N: J2.13; also elsewhere on the board
CS_C: J2.6; also elsewhere on the board
CS_SM: J2.7; also elsewhere on the board
GND: C1.2, C2.2, C3.2, C5.2, C6.2, C7.2, C8.2, J1.B1 (GND), J1.B2 (GND), J1.B49 (GND), J1.B50 (GND), J1.T1 (GND), J1.T2 (GND), J1.T49 (GND), J1.T50 (GND), J2.8, J2.11, J2.12, J2.14, U1.4 (GND), U2.2 (GND); also elsewhere on the board
MODE: J2.9; also elsewhere on the board
SW33: C4.2, L1.1, U1.5 (SW)

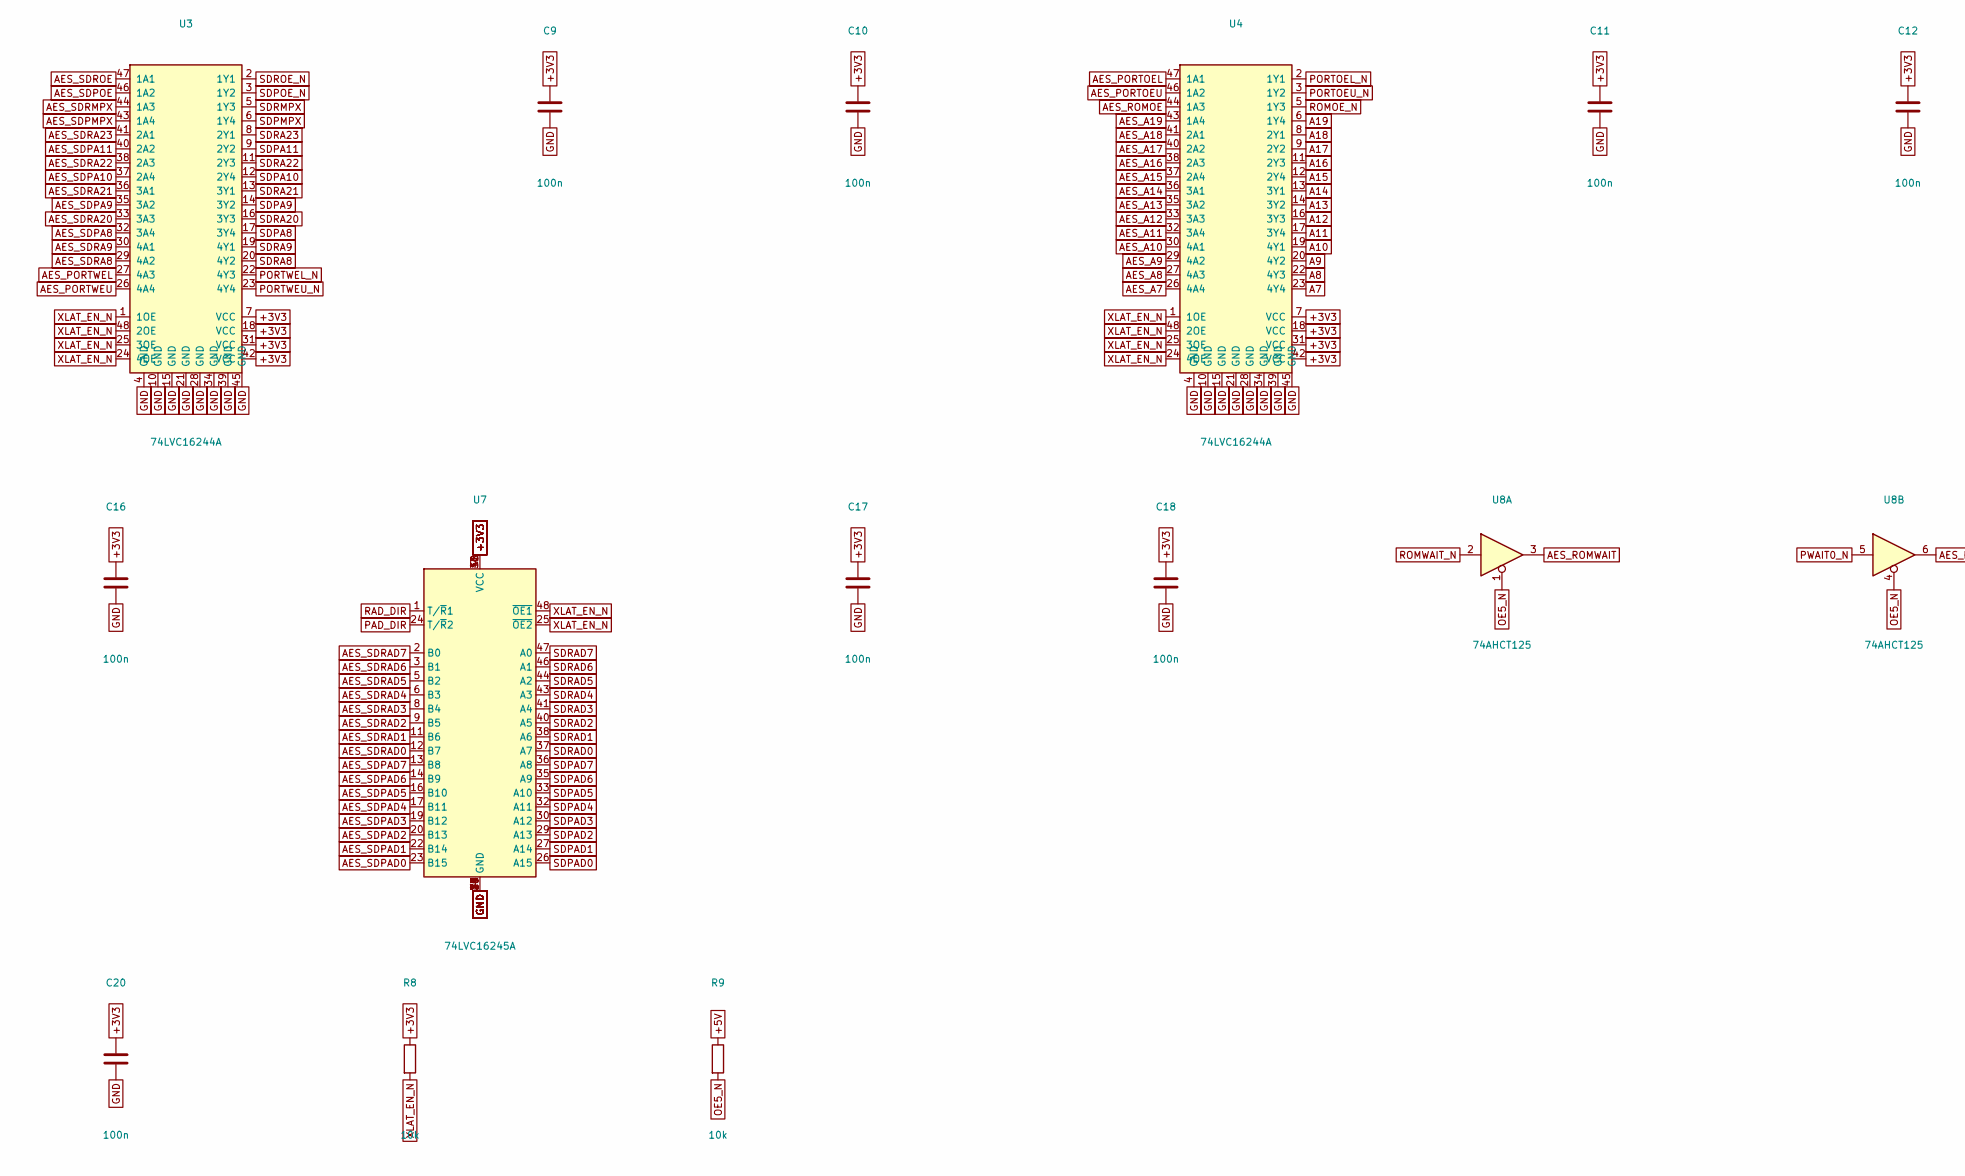
[picture p32: schematic buffers.kicad_sch, SDAES - carte PROG (programme 68000 + son ADPCM) - Tampons …, part in row 1, column 1]

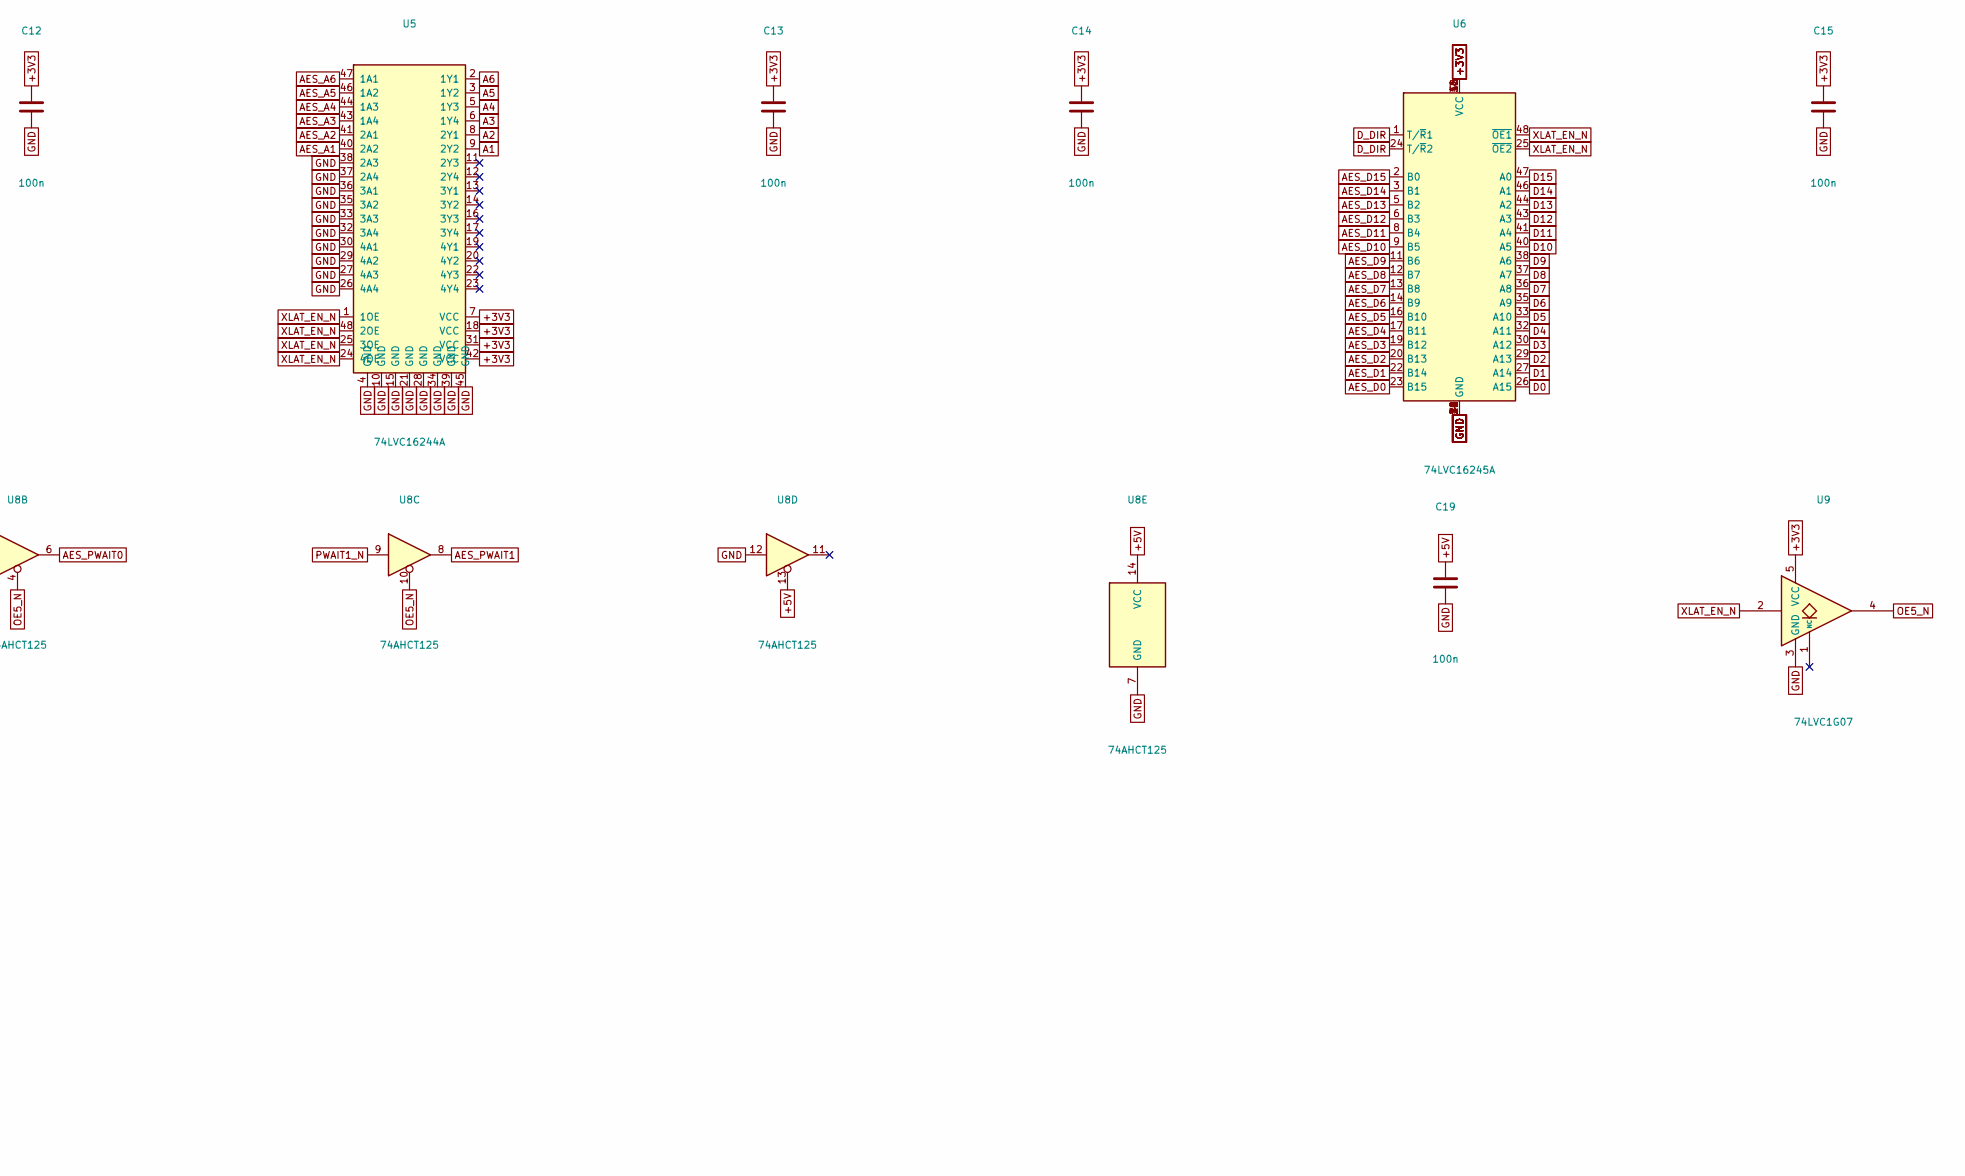
[picture p33: schematic buffers.kicad_sch, SDAES - carte PROG (programme 68000 + son ADPCM) - Tampons …, part in row 1, column 2]

Parts:
C9, C10, C11, C12, C13, C14, C15, C16, C17, C18, C19, C20: 100n; C_0603_1608Metric
R8, R9: 10k; R_0603_1608Metric
U3, U4, U5: 74LVC16244A; TSSOP-48_6.1x12.5mm_P0.5mm
U6, U7: 74LVC16245A; TSSOP-48_6.1x12.5mm_P0.5mm
U8: 74AHCT125; TSSOP-14_4.4x5mm_P0.65mm
U9: 74LVC1G07; SOT-23-5

Connections:
+3V3: C9.1, C10.1, C11.1, C12.1, C13.1, C14.1, C15.1, C16.1, C17.1, C18.1, C20.1, R8.1, U3.7 (VCC), U3.18 (VCC), U3.31 (VCC), U3.42 (VCC), U4.7 (VCC), U4.18 (VCC), U4.31 (VCC), U4.42 (VCC), U5.7 (VCC), U5.18 (VCC), U5.31 (VCC), U5.42 (VCC), U6.7 (VCC), U6.18 (VCC), U6.31 (VCC), U6.42 (VCC), U7.7 (VCC), U7.18 (VCC), U7.31 (VCC), U7.42 (VCC), U9.5 (VCC); also elsewhere on the board
+5V: C19.1, R9.1, U8.13, U8.14 (VCC); also elsewhere on the board
A1: U5.9 (2Y2); also elsewhere on the board
A2: U5.8 (2Y1); also elsewhere on the board
A3: U5.6 (1Y4); also elsewhere on the board
A4: U5.5 (1Y3); also elsewhere on the board
A5: U5.3 (1Y2); also elsewhere on the board
A6: U5.2 (1Y1); also elsewhere on the board
A7: U4.23 (4Y4); also elsewhere on the board
A8: U4.22 (4Y3); also elsewhere on the board
A9: U4.20 (4Y2); also elsewhere on the board
A10: U4.19 (4Y1); also elsewhere on the board
A11: U4.17 (3Y4); also elsewhere on the board
A12: U4.16 (3Y3); also elsewhere on the board
A13: U4.14 (3Y2); also elsewhere on the board
A14: U4.13 (3Y1); also elsewhere on the board
A15: U4.12 (2Y4); also elsewhere on the board
A16: U4.11 (2Y3); also elsewhere on the board
A17: U4.9 (2Y2); also elsewhere on the board
A18: U4.8 (2Y1); also elsewhere on the board
A19: U4.6 (1Y4); also elsewhere on the board
AES_A1: U5.40 (2A2); also elsewhere on the board
AES_A2: U5.41 (2A1); also elsewhere on the board
AES_A3: U5.43 (1A4); also elsewhere on the board
AES_A4: U5.44 (1A3); also elsewhere on the board
AES_A5: U5.46 (1A2); also elsewhere on the board
AES_A6: U5.47 (1A1); also elsewhere on the board
AES_A7: U4.26 (4A4); also elsewhere on the board
AES_A8: U4.27 (4A3); also elsewhere on the board
AES_A9: U4.29 (4A2); also elsewhere on the board
AES_A10: U4.30 (4A1); also elsewhere on the board
AES_A11: U4.32 (3A4); also elsewhere on the board
AES_A12: U4.33 (3A3); also elsewhere on the board
AES_A13: U4.35 (3A2); also elsewhere on the board
AES_A14: U4.36 (3A1); also elsewhere on the board
AES_A15: U4.37 (2A4); also elsewhere on the board
AES_A16: U4.38 (2A3); also elsewhere on the board
AES_A17: U4.40 (2A2); also elsewhere on the board
AES_A18: U4.41 (2A1); also elsewhere on the board
AES_A19: U4.43 (1A4); also elsewhere on the board
AES_D0: U6.23 (B15); also elsewhere on the board
AES_D1: U6.22 (B14); also elsewhere on the board
AES_D2: U6.20 (B13); also elsewhere on the board
AES_D3: U6.19 (B12); also elsewhere on the board
AES_D4: U6.17 (B11); also elsewhere on the board
AES_D5: U6.16 (B10); also elsewhere on the board
AES_D6: U6.14 (B9); also elsewhere on the board
AES_D7: U6.13 (B8); also elsewhere on the board
AES_D8: U6.12 (B7); also elsewhere on the board
AES_D9: U6.11 (B6); also elsewhere on the board
AES_D10: U6.9 (B5); also elsewhere on the board
AES_D11: U6.8 (B4); also elsewhere on the board
AES_D12: U6.6 (B3); also elsewhere on the board
AES_D13: U6.5 (B2); also elsewhere on the board
AES_D14: U6.3 (B1); also elsewhere on the board
AES_D15: U6.2 (B0); also elsewhere on the board
AES_PORTOEL: U4.47 (1A1); also elsewhere on the board
AES_PORTOEU: U4.46 (1A2); also elsewhere on the board
AES_PORTWEL: U3.27 (4A3); also elsewhere on the board
AES_PORTWEU: U3.26 (4A4); also elsewhere on the board
AES_PWAIT0: U8.6; also elsewhere on the board
AES_PWAIT1: U8.8; also elsewhere on the board
AES_ROMOE: U4.44 (1A3); also elsewhere on the board
AES_ROMWAIT: U8.3; also elsewhere on the board
AES_SDPA8: U3.32 (3A4); also elsewhere on the board
AES_SDPA9: U3.35 (3A2); also elsewhere on the board
AES_SDPA10: U3.37 (2A4); also elsewhere on the board
AES_SDPA11: U3.40 (2A2); also elsewhere on the board
AES_SDPAD0: U7.23 (B15); also elsewhere on the board
AES_SDPAD1: U7.22 (B14); also elsewhere on the board
AES_SDPAD2: U7.20 (B13); also elsewhere on the board
AES_SDPAD3: U7.19 (B12); also elsewhere on the board
AES_SDPAD4: U7.17 (B11); also elsewhere on the board
AES_SDPAD5: U7.16 (B10); also elsewhere on the board
AES_SDPAD6: U7.14 (B9); also elsewhere on the board
AES_SDPAD7: U7.13 (B8); also elsewhere on the board
AES_SDPMPX: U3.43 (1A4); also elsewhere on the board
AES_SDPOE: U3.46 (1A2); also elsewhere on the board
AES_SDRA8: U3.29 (4A2); also elsewhere on the board
AES_SDRA9: U3.30 (4A1); also elsewhere on the board
AES_SDRA20: U3.33 (3A3); also elsewhere on the board
AES_SDRA21: U3.36 (3A1); also elsewhere on the board
AES_SDRA22: U3.38 (2A3); also elsewhere on the board
AES_SDRA23: U3.41 (2A1); also elsewhere on the board
AES_SDRAD0: U7.12 (B7); also elsewhere on the board
AES_SDRAD1: U7.11 (B6); also elsewhere on the board
AES_SDRAD2: U7.9 (B5); also elsewhere on the board
AES_SDRAD3: U7.8 (B4); also elsewhere on the board
AES_SDRAD4: U7.6 (B3); also elsewhere on the board
AES_SDRAD5: U7.5 (B2); also elsewhere on the board
AES_SDRAD6: U7.3 (B1); also elsewhere on the board
AES_SDRAD7: U7.2 (B0); also elsewhere on the board
AES_SDRMPX: U3.44 (1A3); also elsewhere on the board
AES_SDROE: U3.47 (1A1); also elsewhere on the board
D0: U6.26 (A15); also elsewhere on the board
D1: U6.27 (A14); also elsewhere on the board
D2: U6.29 (A13); also elsewhere on the board
D3: U6.30 (A12); also elsewhere on the board
D4: U6.32 (A11); also elsewhere on the board
D5: U6.33 (A10); also elsewhere on the board
D6: U6.35 (A9); also elsewhere on the board
D7: U6.36 (A8); also elsewhere on the board
D8: U6.37 (A7); also elsewhere on the board
D9: U6.38 (A6); also elsewhere on the board
D10: U6.40 (A5); also elsewhere on the board
D11: U6.41 (A4); also elsewhere on the board
D12: U6.43 (A3); also elsewhere on the board
D13: U6.44 (A2); also elsewhere on the board
D14: U6.46 (A1); also elsewhere on the board
D15: U6.47 (A0); also elsewhere on the board
D_DIR: U6.1 (T/~R1), U6.24 (T/~R2); also elsewhere on the board
GND: C9.2, C10.2, C11.2, C12.2, C13.2, C14.2, C15.2, C16.2, C17.2, C18.2, C19.2, C20.2, U3.4 (GND), U3.10 (GND), U3.15 (GND), U3.21 (GND), U3.28 (GND), U3.34 (GND), U3.39 (GND), U3.45 (GND), U4.4 (GND), U4.10 (GND), U4.15 (GND), U4.21 (GND), U4.28 (GND), U4.34 (GND), U4.39 (GND), U4.45 (GND), U5.4 (GND), U5.10 (GND), U5.15 (GND), U5.21 (GND), U5.26 (4A4), U5.27 (4A3), U5.28 (GND), U5.29 (4A2), U5.30 (4A1), U5.32 (3A4), U5.33 (3A3), U5.34 (GND), U5.35 (3A2), U5.36 (3A1), U5.37 (2A4), U5.38 (2A3), U5.39 (GND), U5.45 (GND), U6.4 (GND), U6.10 (GND), U6.15 (GND), U6.21 (GND), U6.28 (GND), U6.34 (GND), U6.39 (GND), U6.45 (GND), U7.4 (GND), U7.10 (GND), U7.15 (GND), U7.21 (GND), U7.28 (GND), U7.34 (GND), U7.39 (GND), U7.45 (GND), U8.7 (GND), U8.12, U9.3 (GND); also elsewhere on the board
OE5_N: R9.2, U8.1, U8.4, U8.10, U9.4
PAD_DIR: U7.24 (T/~R2); also elsewhere on the board
PORTOEL_N: U4.2 (1Y1); also elsewhere on the board
PORTOEU_N: U4.3 (1Y2); also elsewhere on the board
PORTWEL_N: U3.22 (4Y3); also elsewhere on the board
PORTWEU_N: U3.23 (4Y4); also elsewhere on the board
PWAIT0_N: U8.5; also elsewhere on the board
PWAIT1_N: U8.9; also elsewhere on the board
RAD_DIR: U7.1 (T/~R1); also elsewhere on the board
ROMOE_N: U4.5 (1Y3); also elsewhere on the board
ROMWAIT_N: U8.2; also elsewhere on the board
SDPA8: U3.17 (3Y4); also elsewhere on the board
SDPA9: U3.14 (3Y2); also elsewhere on the board
SDPA10: U3.12 (2Y4); also elsewhere on the board
SDPA11: U3.9 (2Y2); also elsewhere on the board
SDPAD0: U7.26 (A15); also elsewhere on the board
SDPAD1: U7.27 (A14); also elsewhere on the board
SDPAD2: U7.29 (A13); also elsewhere on the board
SDPAD3: U7.30 (A12); also elsewhere on the board
SDPAD4: U7.32 (A11); also elsewhere on the board
SDPAD5: U7.33 (A10); also elsewhere on the board
SDPAD6: U7.35 (A9); also elsewhere on the board
SDPAD7: U7.36 (A8); also elsewhere on the board
SDPMPX: U3.6 (1Y4); also elsewhere on the board
SDPOE_N: U3.3 (1Y2); also elsewhere on the board
SDRA8: U3.20 (4Y2); also elsewhere on the board
SDRA9: U3.19 (4Y1); also elsewhere on the board
SDRA20: U3.16 (3Y3); also elsewhere on the board
SDRA21: U3.13 (3Y1); also elsewhere on the board
SDRA22: U3.11 (2Y3); also elsewhere on the board
SDRA23: U3.8 (2Y1); also elsewhere on the board
SDRAD0: U7.37 (A7); also elsewhere on the board
SDRAD1: U7.38 (A6); also elsewhere on the board
SDRAD2: U7.40 (A5); also elsewhere on the board
SDRAD3: U7.41 (A4); also elsewhere on the board
SDRAD4: U7.43 (A3); also elsewhere on the board
SDRAD5: U7.44 (A2); also elsewhere on the board
SDRAD6: U7.46 (A1); also elsewhere on the board
SDRAD7: U7.47 (A0); also elsewhere on the board
SDRMPX: U3.5 (1Y3); also elsewhere on the board
SDROE_N: U3.2 (1Y1); also elsewhere on the board
XLAT_EN_N: R8.2, U3.1 (1OE), U3.24 (4OE), U3.25 (3OE), U3.48 (2OE), U4.1 (1OE), U4.24 (4OE), U4.25 (3OE), U4.48 (2OE), U5.1 (1OE), U5.24 (4OE), U5.25 (3OE), U5.48 (2OE), U6.25 (~OE2), U6.48 (~OE1), U7.25 (~OE2), U7.48 (~OE1), U9.2; also elsewhere on the board
