DocteurPCB/SDAES/hardware/kicad/prog/prog.kicad_pcb

## KiCad design hardware/kicad/prog/prog.kicad_pcb (continued)

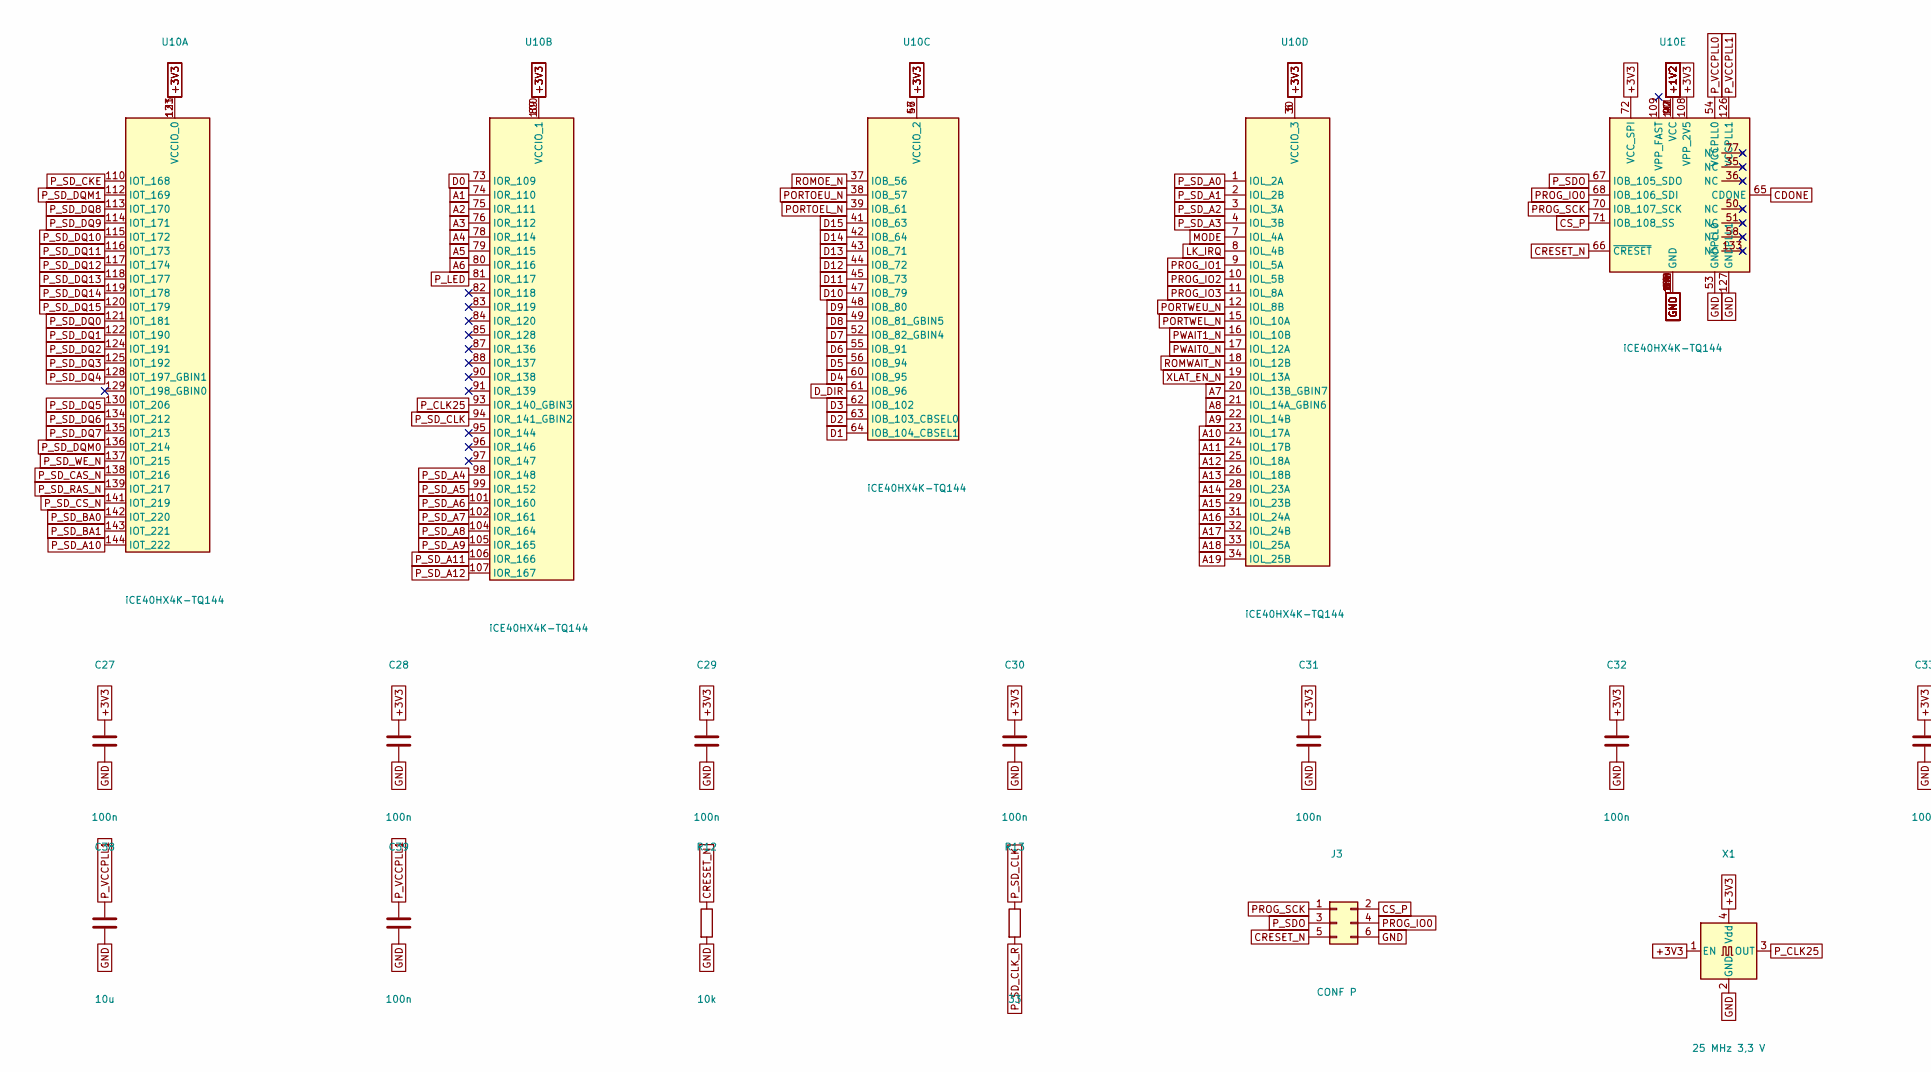
[picture p34: schematic fpga_p.kicad_sch, SDAES - carte PROG (programme 68000 + son ADPCM) - FPGA P, part in row 1, column 1]

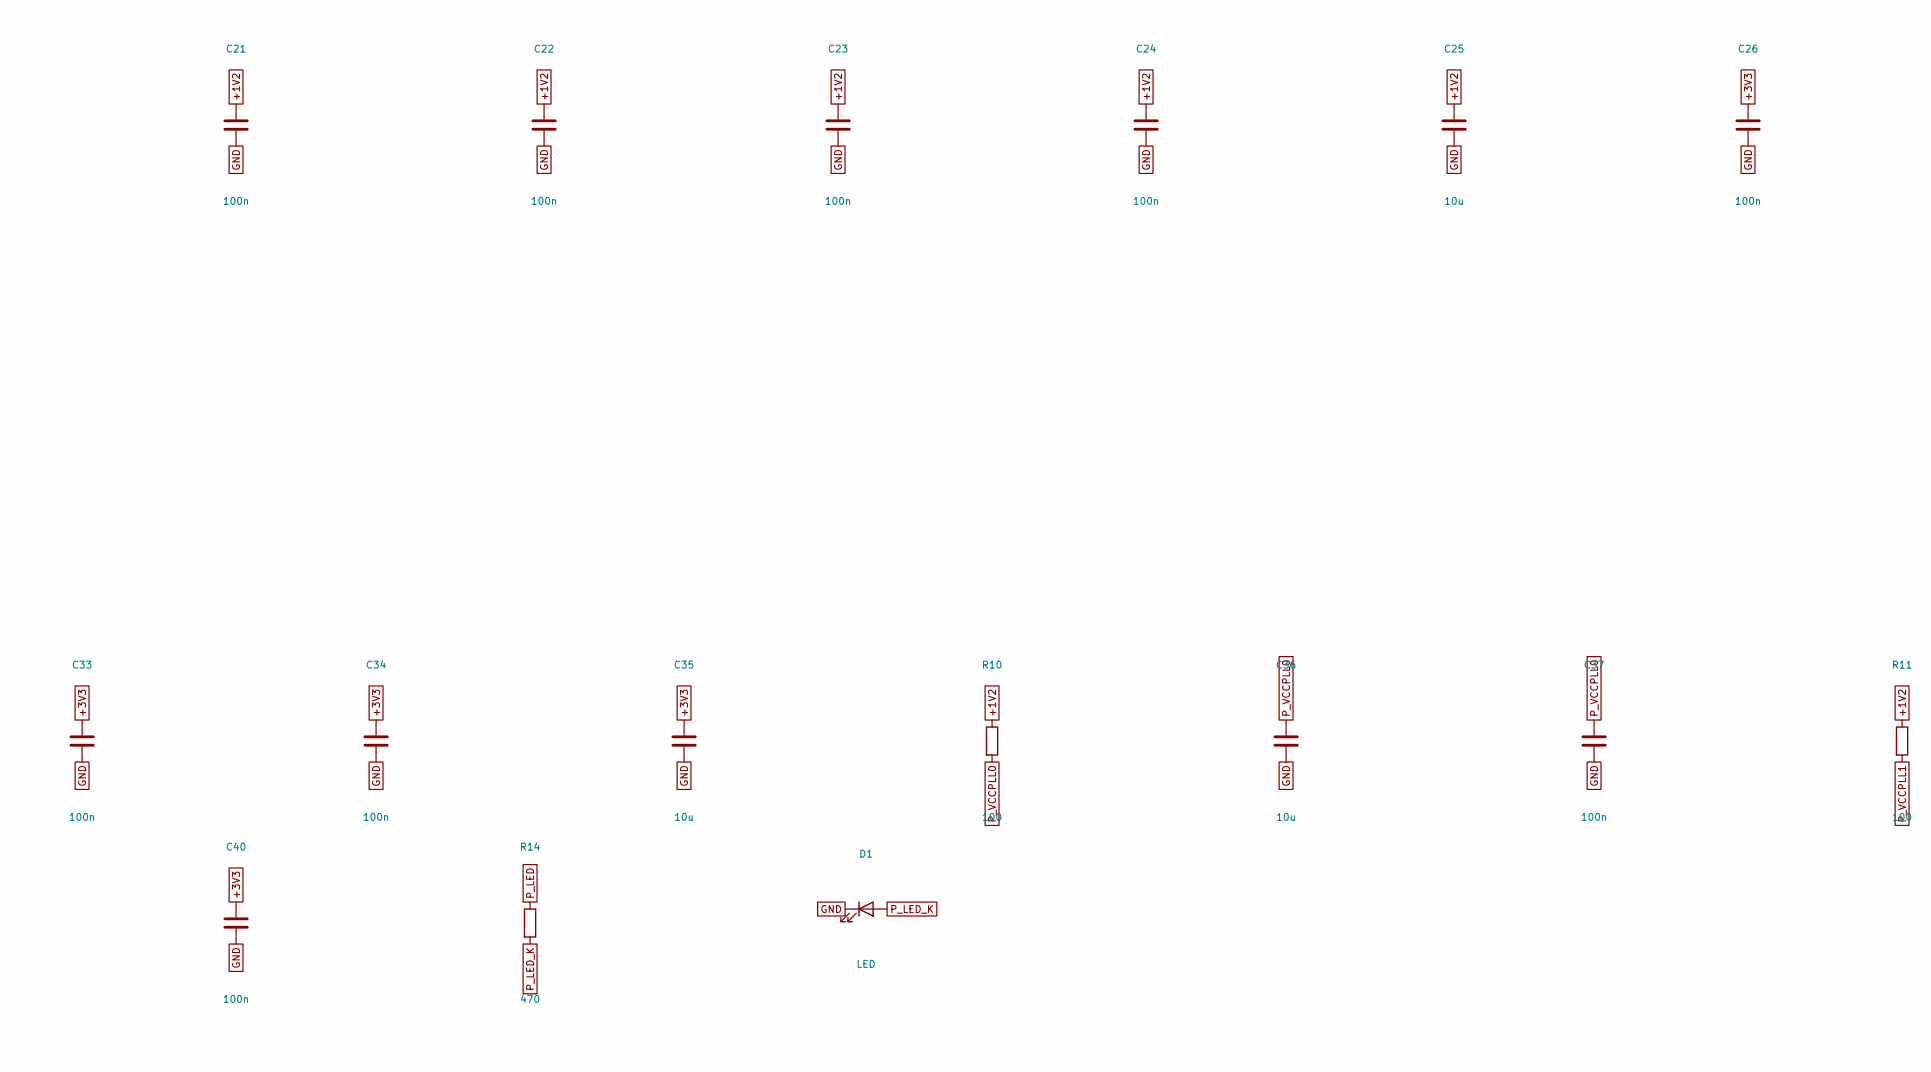
[picture p35: schematic fpga_p.kicad_sch, SDAES - carte PROG (programme 68000 + son ADPCM) - FPGA P, part in row 1, column 2]

Parts:
C21, C22, C23, C24, C26, C27, C28, C29, C30, C31, C32, C33, C34, C37, C39, C40: 100n; C_0603_1608Metric
C25, C35, C36, C38: 10u; C_0805_2012Metric
D1: LED; LED_0603_1608Metric
J3: CONF P; PinHeader_2x03_P2.54mm_Vertical
R10, R11: 100; R_0603_1608Metric
R12: 10k; R_0603_1608Metric
R13: 33; R_0603_1608Metric
R14: 470; R_0603_1608Metric
U10: iCE40HX4K-TQ144; TQFP-144_20x20mm_P0.5mm
X1: 25 MHz 3,3 V; Oscillator_SMD_Abracon_ASE-4Pin_3.2x2.5mm_HandSoldering

Connections:
+1V2: C21.1, C22.1, C23.1, C24.1, C25.1, R10.1, R11.1, U10.27 (VCC), U10.40 (VCC), U10.92 (VCC), U10.111 (VCC); also elsewhere on the board
+3V3: C26.1, C27.1, C28.1, C29.1, C30.1, C31.1, C32.1, C33.1, C34.1, C35.1, C40.1, U10.6 (VCCIO_3), U10.30 (VCCIO_3), U10.46 (VCCIO_2), U10.57 (VCCIO_2), U10.72 (VCC_SPI), U10.89 (VCCIO_1), U10.100 (VCCIO_1), U10.108 (VPP_2V5), U10.123 (VCCIO_0), U10.131 (VCCIO_0), X1.1 (EN), X1.4 (Vdd); also elsewhere on the board
A1: U10.74 (IOR_110); also elsewhere on the board
A2: U10.75 (IOR_111); also elsewhere on the board
A3: U10.76 (IOR_112); also elsewhere on the board
A4: U10.78 (IOR_114); also elsewhere on the board
A5: U10.79 (IOR_115); also elsewhere on the board
A6: U10.80 (IOR_116); also elsewhere on the board
A7: U10.20 (IOL_13B_GBIN7); also elsewhere on the board
A8: U10.21 (IOL_14A_GBIN6); also elsewhere on the board
A9: U10.22 (IOL_14B); also elsewhere on the board
A10: U10.23 (IOL_17A); also elsewhere on the board
A11: U10.24 (IOL_17B); also elsewhere on the board
A12: U10.25 (IOL_18A); also elsewhere on the board
A13: U10.26 (IOL_18B); also elsewhere on the board
A14: U10.28 (IOL_23A); also elsewhere on the board
A15: U10.29 (IOL_23B); also elsewhere on the board
A16: U10.31 (IOL_24A); also elsewhere on the board
A17: U10.32 (IOL_24B); also elsewhere on the board
A18: U10.33 (IOL_25A); also elsewhere on the board
A19: U10.34 (IOL_25B); also elsewhere on the board
CDONE: U10.65 (CDONE); also elsewhere on the board
CRESET_N: J3.5, R12.1, U10.66 (~CRESET); also elsewhere on the board
CS_P: J3.2, U10.71 (IOB_108_SS); also elsewhere on the board
D0: U10.73 (IOR_109); also elsewhere on the board
D1: U10.64 (IOB_104_CBSEL1); also elsewhere on the board
D2: U10.63 (IOB_103_CBSEL0); also elsewhere on the board
D3: U10.62 (IOB_102); also elsewhere on the board
D4: U10.60 (IOB_95); also elsewhere on the board
D5: U10.56 (IOB_94); also elsewhere on the board
D6: U10.55 (IOB_91); also elsewhere on the board
D7: U10.52 (IOB_82_GBIN4); also elsewhere on the board
D8: U10.49 (IOB_81_GBIN5); also elsewhere on the board
D9: U10.48 (IOB_80); also elsewhere on the board
D10: U10.47 (IOB_79); also elsewhere on the board
D11: U10.45 (IOB_73); also elsewhere on the board
D12: U10.44 (IOB_72); also elsewhere on the board
D13: U10.43 (IOB_71); also elsewhere on the board
D14: U10.42 (IOB_64); also elsewhere on the board
D15: U10.41 (IOB_63); also elsewhere on the board
D_DIR: U10.61 (IOB_96); also elsewhere on the board
GND: C21.2, C22.2, C23.2, C24.2, C25.2, C26.2, C27.2, C28.2, C29.2, C30.2, C31.2, C32.2, C33.2, C34.2, C35.2, C36.2, C37.2, C38.2, C39.2, C40.2, D1.1 (K), J3.6, R12.2, U10.5 (GND), U10.13 (GND), U10.14 (GND), U10.53 (GNDPLL0), U10.59 (GND), U10.69 (GND), U10.86 (GND), U10.103 (GND), U10.127 (GNDPLL1), U10.132 (GND), U10.140 (GND), X1.2 (GND); also elsewhere on the board
LK_IRQ: U10.8 (IOL_4B); also elsewhere on the board
MODE: U10.7 (IOL_4A); also elsewhere on the board
PORTOEL_N: U10.39 (IOB_61); also elsewhere on the board
PORTOEU_N: U10.38 (IOB_57); also elsewhere on the board
PORTWEL_N: U10.15 (IOL_10A); also elsewhere on the board
PORTWEU_N: U10.12 (IOL_8B); also elsewhere on the board
PROG_IO0: J3.4, U10.68 (IOB_106_SDI); also elsewhere on the board
PROG_IO1: U10.9 (IOL_5A); also elsewhere on the board
PROG_IO2: U10.10 (IOL_5B); also elsewhere on the board
PROG_IO3: U10.11 (IOL_8A); also elsewhere on the board
PROG_SCK: J3.1, U10.70 (IOB_107_SCK); also elsewhere on the board
PWAIT0_N: U10.17 (IOL_12A); also elsewhere on the board
PWAIT1_N: U10.16 (IOL_10B); also elsewhere on the board
P_CLK25: U10.93 (IOR_140_GBIN3), X1.3 (OUT)
P_LED: R14.1, U10.81 (IOR_117)
P_LED_K: D1.2 (A), R14.2
P_SDO: J3.3, U10.67 (IOB_105_SDO)
P_SD_A0: U10.1 (IOL_2A); also elsewhere on the board
P_SD_A1: U10.2 (IOL_2B); also elsewhere on the board
P_SD_A2: U10.3 (IOL_3A); also elsewhere on the board
P_SD_A3: U10.4 (IOL_3B); also elsewhere on the board
P_SD_A4: U10.98 (IOR_148); also elsewhere on the board
P_SD_A5: U10.99 (IOR_152); also elsewhere on the board
P_SD_A6: U10.101 (IOR_160); also elsewhere on the board
P_SD_A7: U10.102 (IOR_161); also elsewhere on the board
P_SD_A8: U10.104 (IOR_164); also elsewhere on the board
P_SD_A9: U10.105 (IOR_165); also elsewhere on the board
P_SD_A10: U10.144 (IOT_222); also elsewhere on the board
P_SD_A11: U10.106 (IOR_166); also elsewhere on the board
P_SD_A12: U10.107 (IOR_167); also elsewhere on the board
P_SD_BA0: U10.142 (IOT_220); also elsewhere on the board
P_SD_BA1: U10.143 (IOT_221); also elsewhere on the board
P_SD_CAS_N: U10.138 (IOT_216); also elsewhere on the board
P_SD_CKE: U10.110 (IOT_168); also elsewhere on the board
P_SD_CLK: R13.1, U10.94 (IOR_141_GBIN2)
P_SD_CLK_R: R13.2; also elsewhere on the board
P_SD_CS_N: U10.141 (IOT_219); also elsewhere on the board
P_SD_DQ0: U10.121 (IOT_181); also elsewhere on the board
P_SD_DQ1: U10.122 (IOT_190); also elsewhere on the board
P_SD_DQ2: U10.124 (IOT_191); also elsewhere on the board
P_SD_DQ3: U10.125 (IOT_192); also elsewhere on the board
P_SD_DQ4: U10.128 (IOT_197_GBIN1); also elsewhere on the board
P_SD_DQ5: U10.130 (IOT_206); also elsewhere on the board
P_SD_DQ6: U10.134 (IOT_212); also elsewhere on the board
P_SD_DQ7: U10.135 (IOT_213); also elsewhere on the board
P_SD_DQ8: U10.113 (IOT_170); also elsewhere on the board
P_SD_DQ9: U10.114 (IOT_171); also elsewhere on the board
P_SD_DQ10: U10.115 (IOT_172); also elsewhere on the board
P_SD_DQ11: U10.116 (IOT_173); also elsewhere on the board
P_SD_DQ12: U10.117 (IOT_174); also elsewhere on the board
P_SD_DQ13: U10.118 (IOT_177); also elsewhere on the board
P_SD_DQ14: U10.119 (IOT_178); also elsewhere on the board
P_SD_DQ15: U10.120 (IOT_179); also elsewhere on the board
P_SD_DQM0: U10.136 (IOT_214); also elsewhere on the board
P_SD_DQM1: U10.112 (IOT_169); also elsewhere on the board
P_SD_RAS_N: U10.139 (IOT_217); also elsewhere on the board
P_SD_WE_N: U10.137 (IOT_215); also elsewhere on the board
P_VCCPLL0: C36.1, C37.1, R10.2, U10.54 (VCCPLL0)
P_VCCPLL1: C38.1, C39.1, R11.2, U10.126 (VCCPLL1)
ROMOE_N: U10.37 (IOB_56); also elsewhere on the board
ROMWAIT_N: U10.18 (IOL_12B); also elsewhere on the board
XLAT_EN_N: U10.19 (IOL_13A); also elsewhere on the board

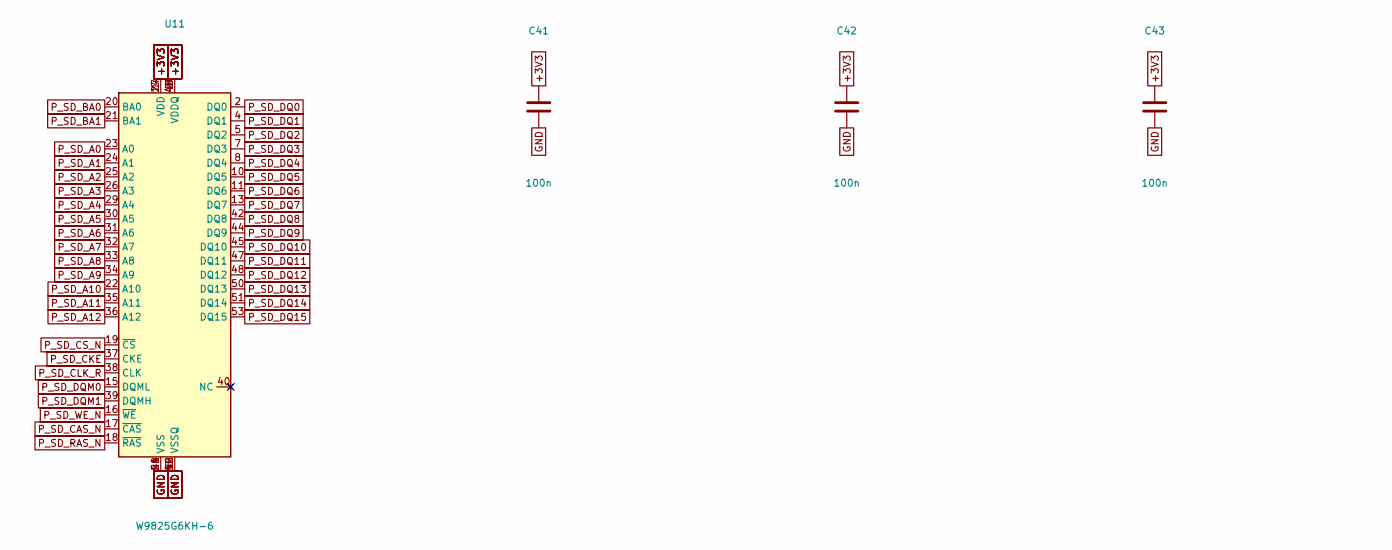
[picture p36: schematic sdram_p.kicad_sch, SDAES - carte PROG (programme 68000 + son ADPCM) - SDRAM P, part in row 1, column 1]

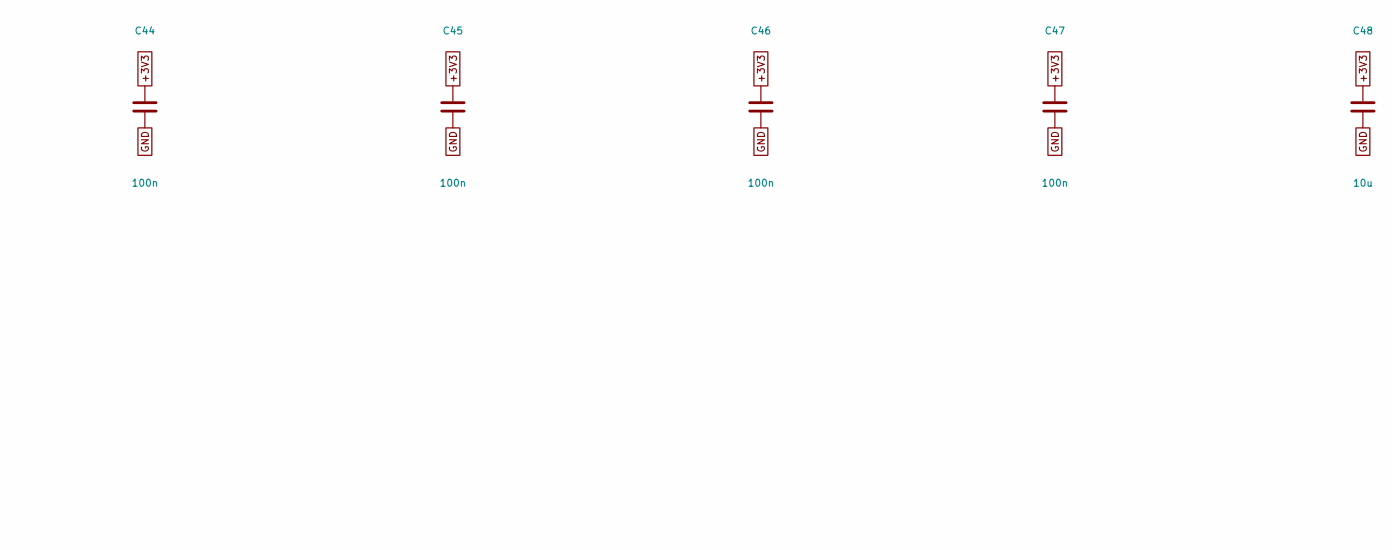
[picture p37: schematic sdram_p.kicad_sch, SDAES - carte PROG (programme 68000 + son ADPCM) - SDRAM P, part in row 1, column 2]

Parts:
C41, C42, C43, C44, C45, C46, C47: 100n; C_0603_1608Metric
C48: 10u; C_0805_2012Metric
U11: W9825G6KH-6; TSOP-II-54_22.2x10.16mm_P0.8mm

Connections:
+3V3: C41.1, C42.1, C43.1, C44.1, C45.1, C46.1, C47.1, C48.1, U11.1 (VDD), U11.3 (VDDQ), U11.9 (VDDQ), U11.14 (VDD), U11.27 (VDD), U11.43 (VDDQ), U11.49 (VDDQ); also elsewhere on the board
GND: C41.2, C42.2, C43.2, C44.2, C45.2, C46.2, C47.2, C48.2, U11.6 (VSSQ), U11.12 (VSSQ), U11.28 (VSS), U11.41 (VSS), U11.46 (VSSQ), U11.52 (VSSQ), U11.54 (VSS); also elsewhere on the board
P_SD_A0: U11.23 (A0); also elsewhere on the board
P_SD_A1: U11.24 (A1); also elsewhere on the board
P_SD_A2: U11.25 (A2); also elsewhere on the board
P_SD_A3: U11.26 (A3); also elsewhere on the board
P_SD_A4: U11.29 (A4); also elsewhere on the board
P_SD_A5: U11.30 (A5); also elsewhere on the board
P_SD_A6: U11.31 (A6); also elsewhere on the board
P_SD_A7: U11.32 (A7); also elsewhere on the board
P_SD_A8: U11.33 (A8); also elsewhere on the board
P_SD_A9: U11.34 (A9); also elsewhere on the board
P_SD_A10: U11.22 (A10); also elsewhere on the board
P_SD_A11: U11.35 (A11); also elsewhere on the board
P_SD_A12: U11.36 (A12); also elsewhere on the board
P_SD_BA0: U11.20 (BA0); also elsewhere on the board
P_SD_BA1: U11.21 (BA1); also elsewhere on the board
P_SD_CAS_N: U11.17 (~CAS); also elsewhere on the board
P_SD_CKE: U11.37 (CKE); also elsewhere on the board
P_SD_CLK_R: U11.38 (CLK); also elsewhere on the board
P_SD_CS_N: U11.19 (~CS); also elsewhere on the board
P_SD_DQ0: U11.2 (DQ0); also elsewhere on the board
P_SD_DQ1: U11.4 (DQ1); also elsewhere on the board
P_SD_DQ2: U11.5 (DQ2); also elsewhere on the board
P_SD_DQ3: U11.7 (DQ3); also elsewhere on the board
P_SD_DQ4: U11.8 (DQ4); also elsewhere on the board
P_SD_DQ5: U11.10 (DQ5); also elsewhere on the board
P_SD_DQ6: U11.11 (DQ6); also elsewhere on the board
P_SD_DQ7: U11.13 (DQ7); also elsewhere on the board
P_SD_DQ8: U11.42 (DQ8); also elsewhere on the board
P_SD_DQ9: U11.44 (DQ9); also elsewhere on the board
P_SD_DQ10: U11.45 (DQ10); also elsewhere on the board
P_SD_DQ11: U11.47 (DQ11); also elsewhere on the board
P_SD_DQ12: U11.48 (DQ12); also elsewhere on the board
P_SD_DQ13: U11.50 (DQ13); also elsewhere on the board
P_SD_DQ14: U11.51 (DQ14); also elsewhere on the board
P_SD_DQ15: U11.53 (DQ15); also elsewhere on the board
P_SD_DQM0: U11.15 (DQML); also elsewhere on the board
P_SD_DQM1: U11.39 (DQMH); also elsewhere on the board
P_SD_RAS_N: U11.18 (~RAS); also elsewhere on the board
P_SD_WE_N: U11.16 (~WE); also elsewhere on the board

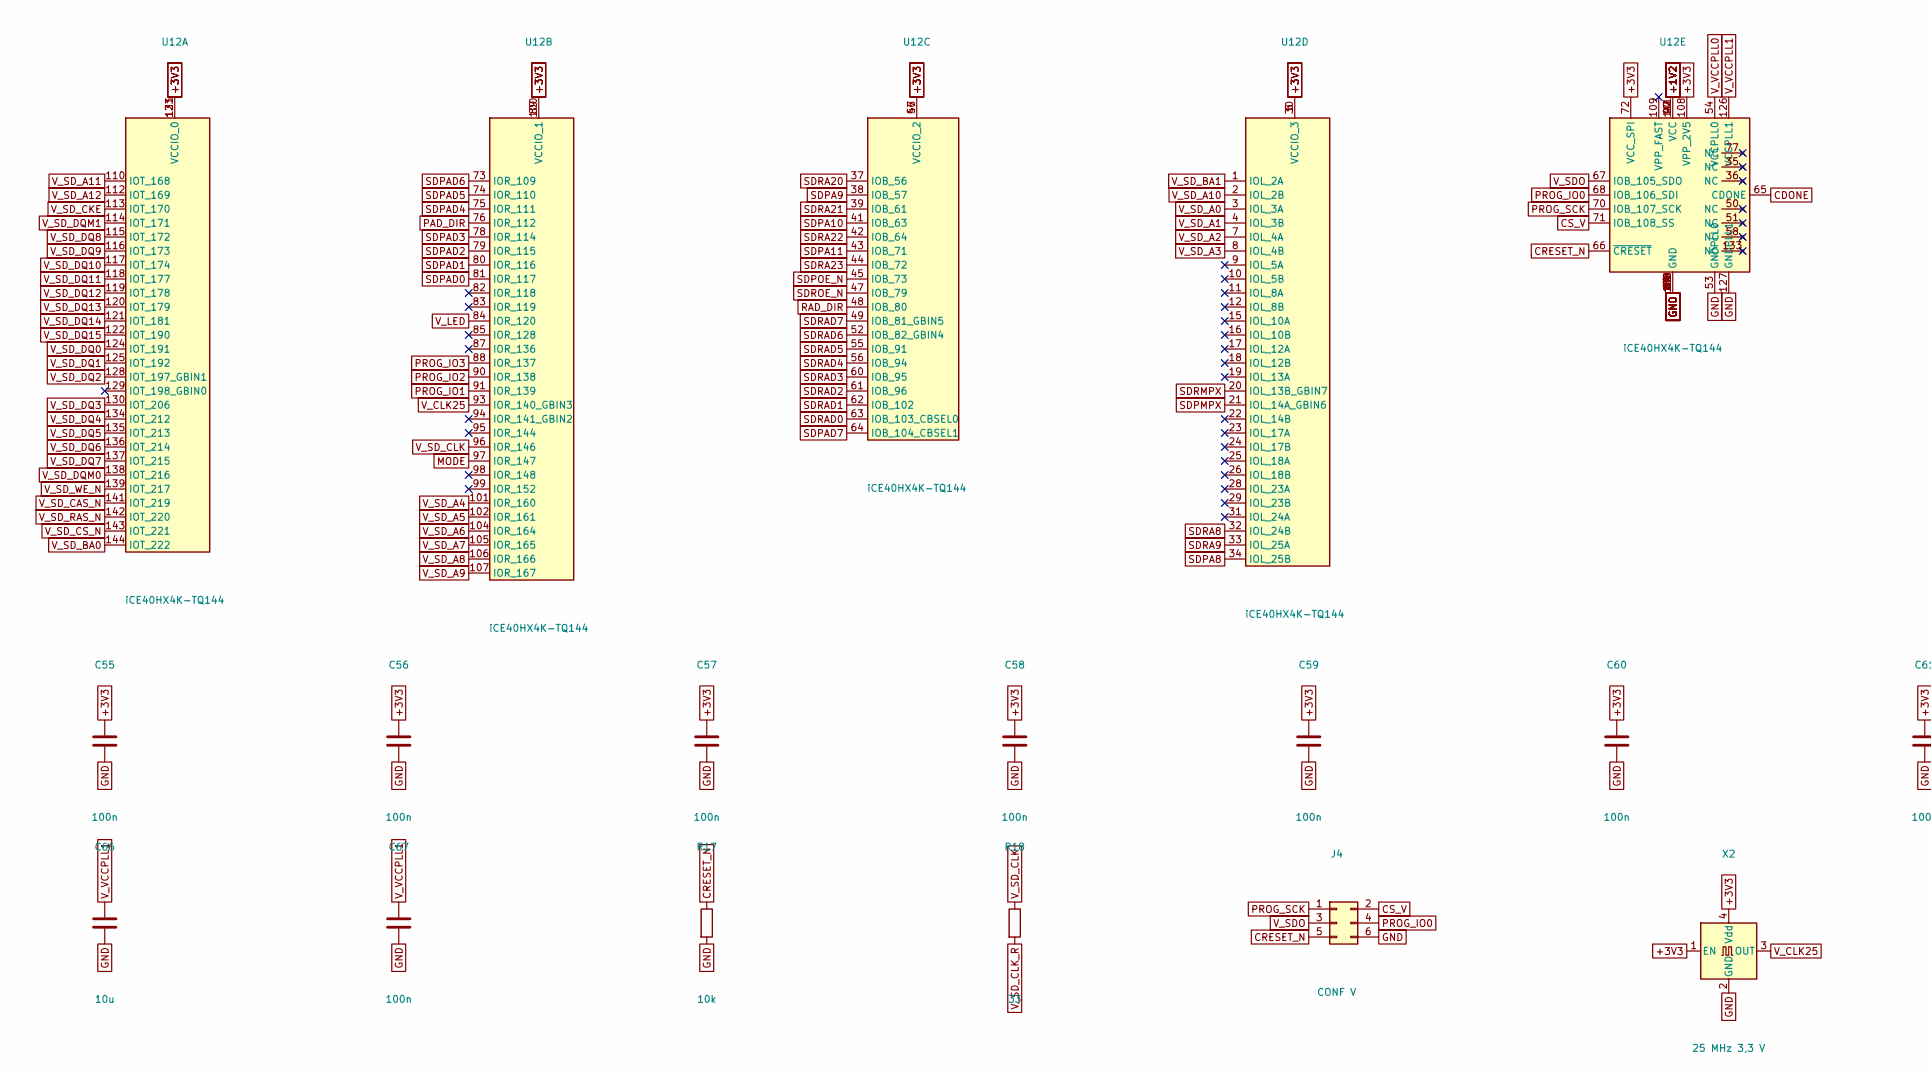
[picture p38: schematic fpga_v.kicad_sch, SDAES - carte PROG (programme 68000 + son ADPCM) - FPGA V, part in row 1, column 1]

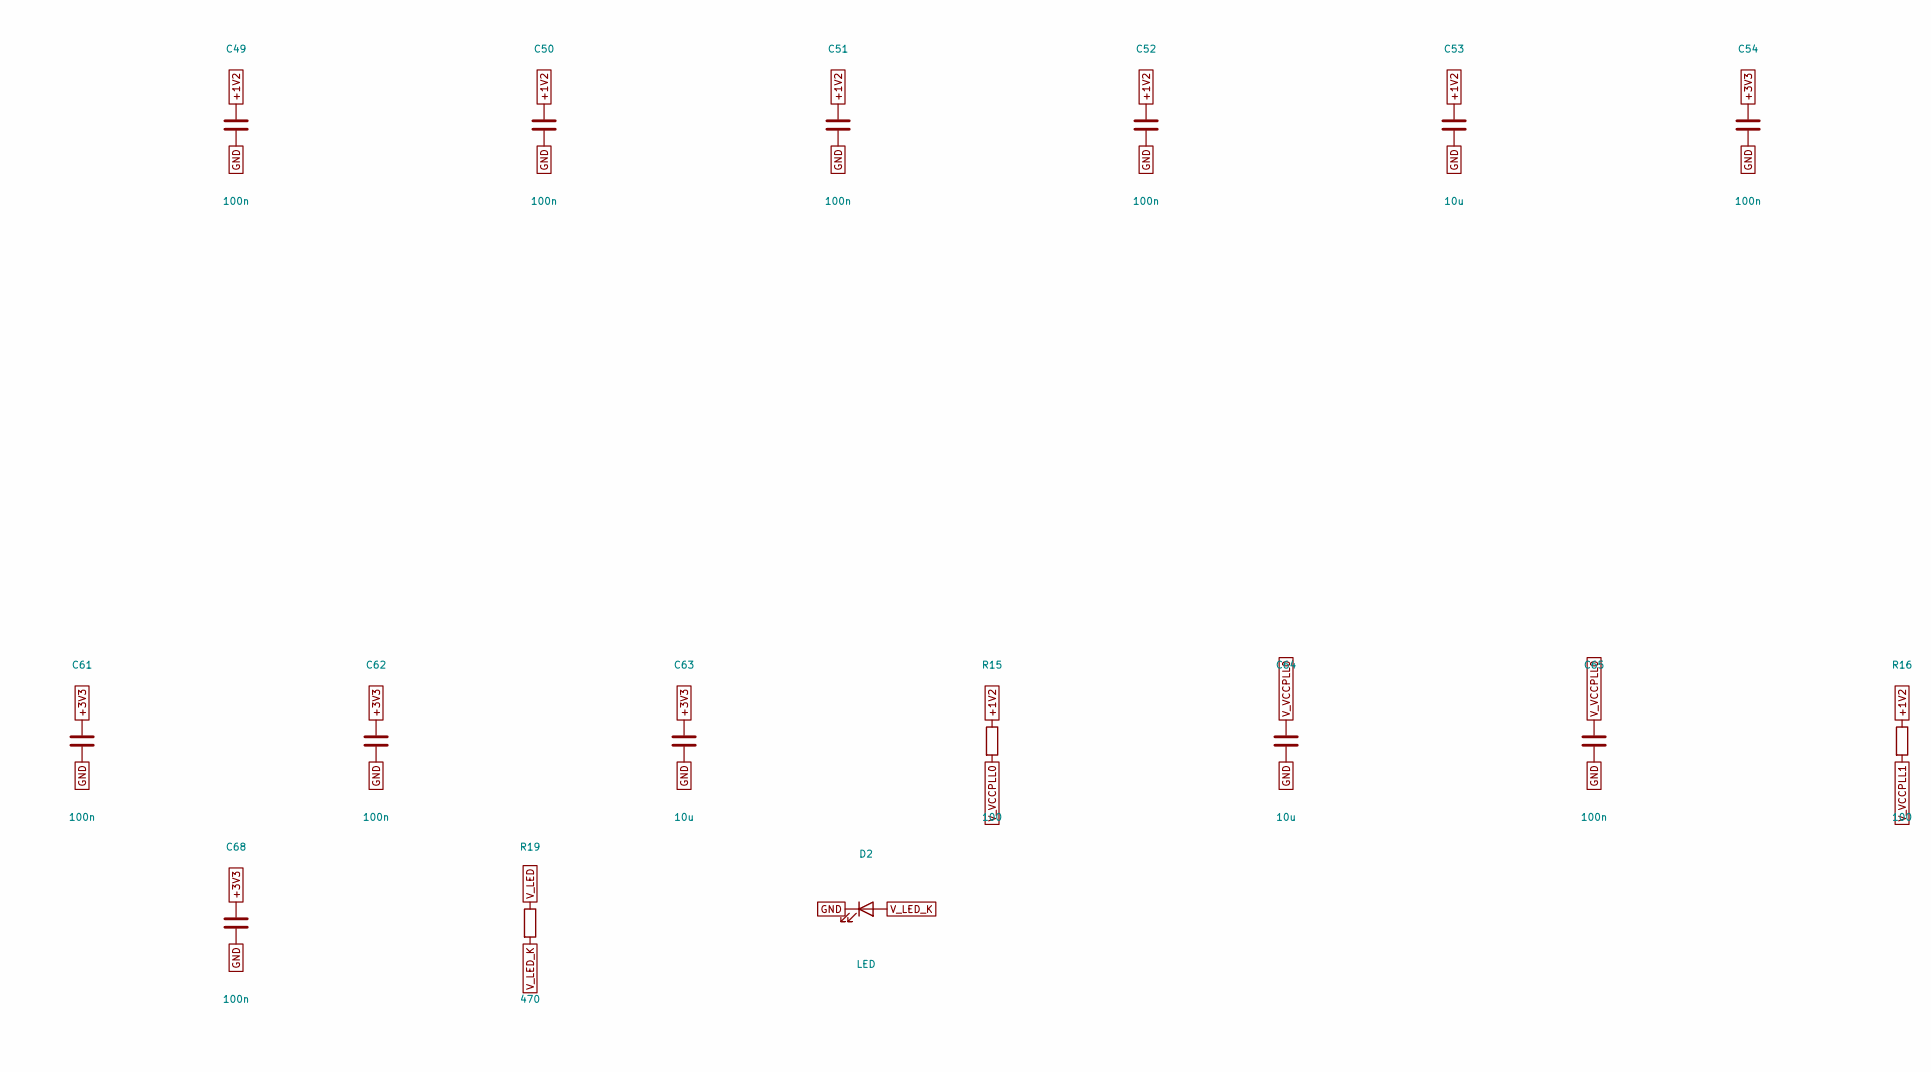
[picture p39: schematic fpga_v.kicad_sch, SDAES - carte PROG (programme 68000 + son ADPCM) - FPGA V, part in row 1, column 2]

Parts:
C49, C50, C51, C52, C54, C55, C56, C57, C58, C59, C60, C61, C62, C65, C67, C68: 100n; C_0603_1608Metric
C53, C63, C64, C66: 10u; C_0805_2012Metric
D2: LED; LED_0603_1608Metric
J4: CONF V; PinHeader_2x03_P2.54mm_Vertical
R15, R16: 100; R_0603_1608Metric
R17: 10k; R_0603_1608Metric
R18: 33; R_0603_1608Metric
R19: 470; R_0603_1608Metric
U12: iCE40HX4K-TQ144; TQFP-144_20x20mm_P0.5mm
X2: 25 MHz 3,3 V; Oscillator_SMD_Abracon_ASE-4Pin_3.2x2.5mm_HandSoldering

Connections:
+1V2: C49.1, C50.1, C51.1, C52.1, C53.1, R15.1, R16.1, U12.27 (VCC), U12.40 (VCC), U12.92 (VCC), U12.111 (VCC); also elsewhere on the board
+3V3: C54.1, C55.1, C56.1, C57.1, C58.1, C59.1, C60.1, C61.1, C62.1, C63.1, C68.1, U12.6 (VCCIO_3), U12.30 (VCCIO_3), U12.46 (VCCIO_2), U12.57 (VCCIO_2), U12.72 (VCC_SPI), U12.89 (VCCIO_1), U12.100 (VCCIO_1), U12.108 (VPP_2V5), U12.123 (VCCIO_0), U12.131 (VCCIO_0), X2.1 (EN), X2.4 (Vdd); also elsewhere on the board
CDONE: U12.65 (CDONE); also elsewhere on the board
CRESET_N: J4.5, R17.1, U12.66 (~CRESET); also elsewhere on the board
CS_V: J4.2, U12.71 (IOB_108_SS); also elsewhere on the board
GND: C49.2, C50.2, C51.2, C52.2, C53.2, C54.2, C55.2, C56.2, C57.2, C58.2, C59.2, C60.2, C61.2, C62.2, C63.2, C64.2, C65.2, C66.2, C67.2, C68.2, D2.1 (K), J4.6, R17.2, U12.5 (GND), U12.13 (GND), U12.14 (GND), U12.53 (GNDPLL0), U12.59 (GND), U12.69 (GND), U12.86 (GND), U12.103 (GND), U12.127 (GNDPLL1), U12.132 (GND), U12.140 (GND), X2.2 (GND); also elsewhere on the board
MODE: U12.97 (IOR_147); also elsewhere on the board
PAD_DIR: U12.76 (IOR_112); also elsewhere on the board
PROG_IO0: J4.4, U12.68 (IOB_106_SDI); also elsewhere on the board
PROG_IO1: U12.91 (IOR_139); also elsewhere on the board
PROG_IO2: U12.90 (IOR_138); also elsewhere on the board
PROG_IO3: U12.88 (IOR_137); also elsewhere on the board
PROG_SCK: J4.1, U12.70 (IOB_107_SCK); also elsewhere on the board
RAD_DIR: U12.48 (IOB_80); also elsewhere on the board
SDPA8: U12.34 (IOL_25B); also elsewhere on the board
SDPA9: U12.38 (IOB_57); also elsewhere on the board
SDPA10: U12.41 (IOB_63); also elsewhere on the board
SDPA11: U12.43 (IOB_71); also elsewhere on the board
SDPAD0: U12.81 (IOR_117); also elsewhere on the board
SDPAD1: U12.80 (IOR_116); also elsewhere on the board
SDPAD2: U12.79 (IOR_115); also elsewhere on the board
SDPAD3: U12.78 (IOR_114); also elsewhere on the board
SDPAD4: U12.75 (IOR_111); also elsewhere on the board
SDPAD5: U12.74 (IOR_110); also elsewhere on the board
SDPAD6: U12.73 (IOR_109); also elsewhere on the board
SDPAD7: U12.64 (IOB_104_CBSEL1); also elsewhere on the board
SDPMPX: U12.21 (IOL_14A_GBIN6); also elsewhere on the board
SDPOE_N: U12.45 (IOB_73); also elsewhere on the board
SDRA8: U12.32 (IOL_24B); also elsewhere on the board
SDRA9: U12.33 (IOL_25A); also elsewhere on the board
SDRA20: U12.37 (IOB_56); also elsewhere on the board
SDRA21: U12.39 (IOB_61); also elsewhere on the board
SDRA22: U12.42 (IOB_64); also elsewhere on the board
SDRA23: U12.44 (IOB_72); also elsewhere on the board
SDRAD0: U12.63 (IOB_103_CBSEL0); also elsewhere on the board
SDRAD1: U12.62 (IOB_102); also elsewhere on the board
SDRAD2: U12.61 (IOB_96); also elsewhere on the board
SDRAD3: U12.60 (IOB_95); also elsewhere on the board
SDRAD4: U12.56 (IOB_94); also elsewhere on the board
SDRAD5: U12.55 (IOB_91); also elsewhere on the board
SDRAD6: U12.52 (IOB_82_GBIN4); also elsewhere on the board
SDRAD7: U12.49 (IOB_81_GBIN5); also elsewhere on the board
SDRMPX: U12.20 (IOL_13B_GBIN7); also elsewhere on the board
SDROE_N: U12.47 (IOB_79); also elsewhere on the board
V_CLK25: U12.93 (IOR_140_GBIN3), X2.3 (OUT)
V_LED: R19.1, U12.84 (IOR_120)
V_LED_K: D2.2 (A), R19.2
V_SDO: J4.3, U12.67 (IOB_105_SDO)
V_SD_A0: U12.3 (IOL_3A); also elsewhere on the board
V_SD_A1: U12.4 (IOL_3B); also elsewhere on the board
V_SD_A2: U12.7 (IOL_4A); also elsewhere on the board
V_SD_A3: U12.8 (IOL_4B); also elsewhere on the board
V_SD_A4: U12.101 (IOR_160); also elsewhere on the board
V_SD_A5: U12.102 (IOR_161); also elsewhere on the board
V_SD_A6: U12.104 (IOR_164); also elsewhere on the board
V_SD_A7: U12.105 (IOR_165); also elsewhere on the board
V_SD_A8: U12.106 (IOR_166); also elsewhere on the board
V_SD_A9: U12.107 (IOR_167); also elsewhere on the board
V_SD_A10: U12.2 (IOL_2B); also elsewhere on the board
V_SD_A11: U12.110 (IOT_168); also elsewhere on the board
V_SD_A12: U12.112 (IOT_169); also elsewhere on the board
V_SD_BA0: U12.144 (IOT_222); also elsewhere on the board
V_SD_BA1: U12.1 (IOL_2A); also elsewhere on the board
V_SD_CAS_N: U12.141 (IOT_219); also elsewhere on the board
V_SD_CKE: U12.113 (IOT_170); also elsewhere on the board
V_SD_CLK: R18.1, U12.96 (IOR_146)
V_SD_CLK_R: R18.2; also elsewhere on the board
V_SD_CS_N: U12.143 (IOT_221); also elsewhere on the board
V_SD_DQ0: U12.124 (IOT_191); also elsewhere on the board
V_SD_DQ1: U12.125 (IOT_192); also elsewhere on the board
V_SD_DQ2: U12.128 (IOT_197_GBIN1); also elsewhere on the board
V_SD_DQ3: U12.130 (IOT_206); also elsewhere on the board
V_SD_DQ4: U12.134 (IOT_212); also elsewhere on the board
V_SD_DQ5: U12.135 (IOT_213); also elsewhere on the board
V_SD_DQ6: U12.136 (IOT_214); also elsewhere on the board
V_SD_DQ7: U12.137 (IOT_215); also elsewhere on the board
V_SD_DQ8: U12.115 (IOT_172); also elsewhere on the board
V_SD_DQ9: U12.116 (IOT_173); also elsewhere on the board
V_SD_DQ10: U12.117 (IOT_174); also elsewhere on the board
V_SD_DQ11: U12.118 (IOT_177); also elsewhere on the board
V_SD_DQ12: U12.119 (IOT_178); also elsewhere on the board
V_SD_DQ13: U12.120 (IOT_179); also elsewhere on the board
V_SD_DQ14: U12.121 (IOT_181); also elsewhere on the board
V_SD_DQ15: U12.122 (IOT_190); also elsewhere on the board
V_SD_DQM0: U12.138 (IOT_216); also elsewhere on the board
V_SD_DQM1: U12.114 (IOT_171); also elsewhere on the board
V_SD_RAS_N: U12.142 (IOT_220); also elsewhere on the board
V_SD_WE_N: U12.139 (IOT_217); also elsewhere on the board
V_VCCPLL0: C64.1, C65.1, R15.2, U12.54 (VCCPLL0)
V_VCCPLL1: C66.1, C67.1, R16.2, U12.126 (VCCPLL1)

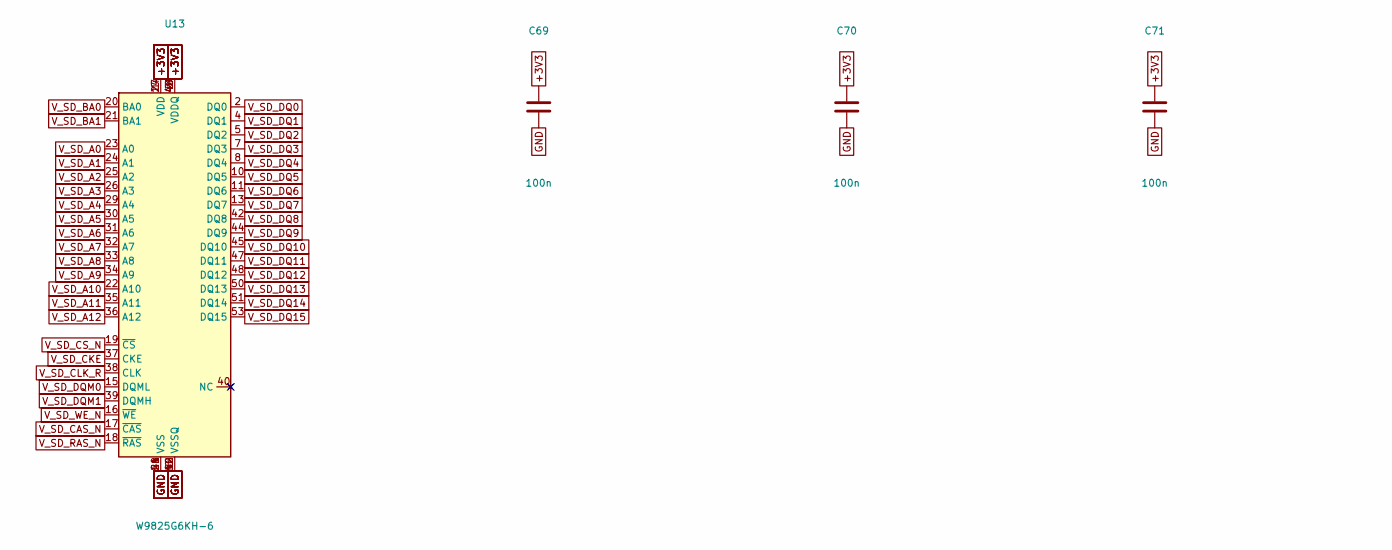
[picture p40: schematic sdram_v.kicad_sch, SDAES - carte PROG (programme 68000 + son ADPCM) - SDRAM V, part in row 1, column 1]

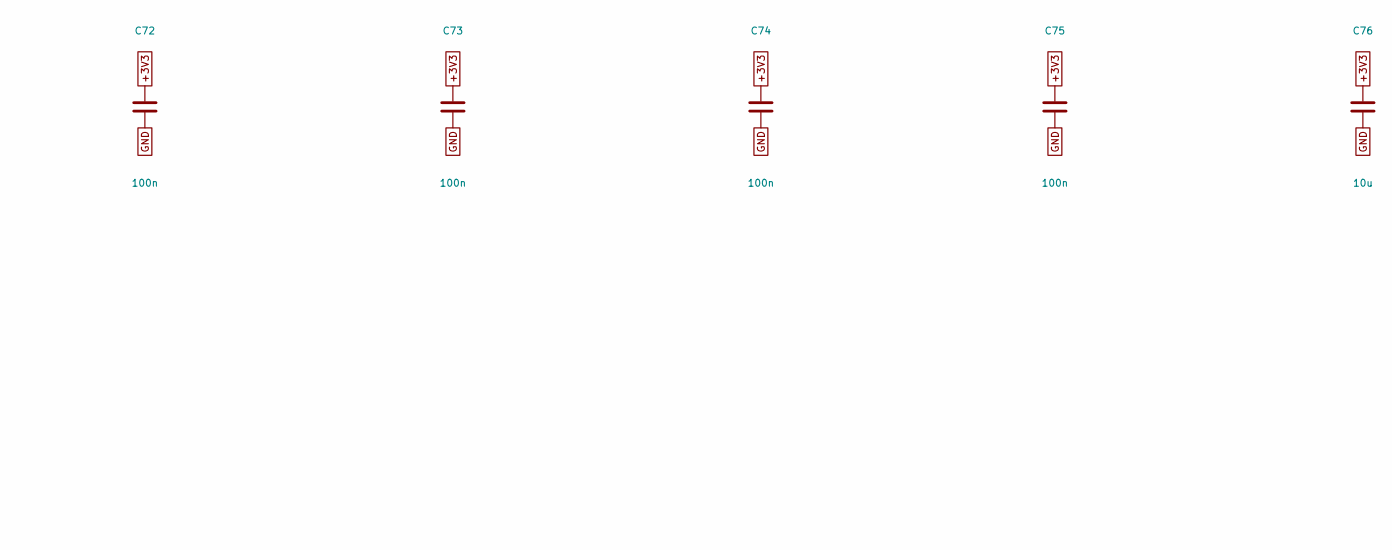
[picture p41: schematic sdram_v.kicad_sch, SDAES - carte PROG (programme 68000 + son ADPCM) - SDRAM V, part in row 1, column 2]

Parts:
C69, C70, C71, C72, C73, C74, C75: 100n; C_0603_1608Metric
C76: 10u; C_0805_2012Metric
U13: W9825G6KH-6; TSOP-II-54_22.2x10.16mm_P0.8mm

Connections:
+3V3: C69.1, C70.1, C71.1, C72.1, C73.1, C74.1, C75.1, C76.1, U13.1 (VDD), U13.3 (VDDQ), U13.9 (VDDQ), U13.14 (VDD), U13.27 (VDD), U13.43 (VDDQ), U13.49 (VDDQ); also elsewhere on the board
GND: C69.2, C70.2, C71.2, C72.2, C73.2, C74.2, C75.2, C76.2, U13.6 (VSSQ), U13.12 (VSSQ), U13.28 (VSS), U13.41 (VSS), U13.46 (VSSQ), U13.52 (VSSQ), U13.54 (VSS); also elsewhere on the board
V_SD_A0: U13.23 (A0); also elsewhere on the board
V_SD_A1: U13.24 (A1); also elsewhere on the board
V_SD_A2: U13.25 (A2); also elsewhere on the board
V_SD_A3: U13.26 (A3); also elsewhere on the board
V_SD_A4: U13.29 (A4); also elsewhere on the board
V_SD_A5: U13.30 (A5); also elsewhere on the board
V_SD_A6: U13.31 (A6); also elsewhere on the board
V_SD_A7: U13.32 (A7); also elsewhere on the board
V_SD_A8: U13.33 (A8); also elsewhere on the board
V_SD_A9: U13.34 (A9); also elsewhere on the board
V_SD_A10: U13.22 (A10); also elsewhere on the board
V_SD_A11: U13.35 (A11); also elsewhere on the board
V_SD_A12: U13.36 (A12); also elsewhere on the board
V_SD_BA0: U13.20 (BA0); also elsewhere on the board
V_SD_BA1: U13.21 (BA1); also elsewhere on the board
V_SD_CAS_N: U13.17 (~CAS); also elsewhere on the board
V_SD_CKE: U13.37 (CKE); also elsewhere on the board
V_SD_CLK_R: U13.38 (CLK); also elsewhere on the board
V_SD_CS_N: U13.19 (~CS); also elsewhere on the board
V_SD_DQ0: U13.2 (DQ0); also elsewhere on the board
V_SD_DQ1: U13.4 (DQ1); also elsewhere on the board
V_SD_DQ2: U13.5 (DQ2); also elsewhere on the board
V_SD_DQ3: U13.7 (DQ3); also elsewhere on the board
V_SD_DQ4: U13.8 (DQ4); also elsewhere on the board
V_SD_DQ5: U13.10 (DQ5); also elsewhere on the board
V_SD_DQ6: U13.11 (DQ6); also elsewhere on the board
V_SD_DQ7: U13.13 (DQ7); also elsewhere on the board
V_SD_DQ8: U13.42 (DQ8); also elsewhere on the board
V_SD_DQ9: U13.44 (DQ9); also elsewhere on the board
V_SD_DQ10: U13.45 (DQ10); also elsewhere on the board
V_SD_DQ11: U13.47 (DQ11); also elsewhere on the board
V_SD_DQ12: U13.48 (DQ12); also elsewhere on the board
V_SD_DQ13: U13.50 (DQ13); also elsewhere on the board
V_SD_DQ14: U13.51 (DQ14); also elsewhere on the board
V_SD_DQ15: U13.53 (DQ15); also elsewhere on the board
V_SD_DQM0: U13.15 (DQML); also elsewhere on the board
V_SD_DQM1: U13.39 (DQMH); also elsewhere on the board
V_SD_RAS_N: U13.18 (~RAS); also elsewhere on the board
V_SD_WE_N: U13.16 (~WE); also elsewhere on the board
