DocteurPCB/SDAES/hardware/kicad/prog/prog.kicad_pcb

## KiCad design hardware/kicad/prog/prog.kicad_pcb (continued)

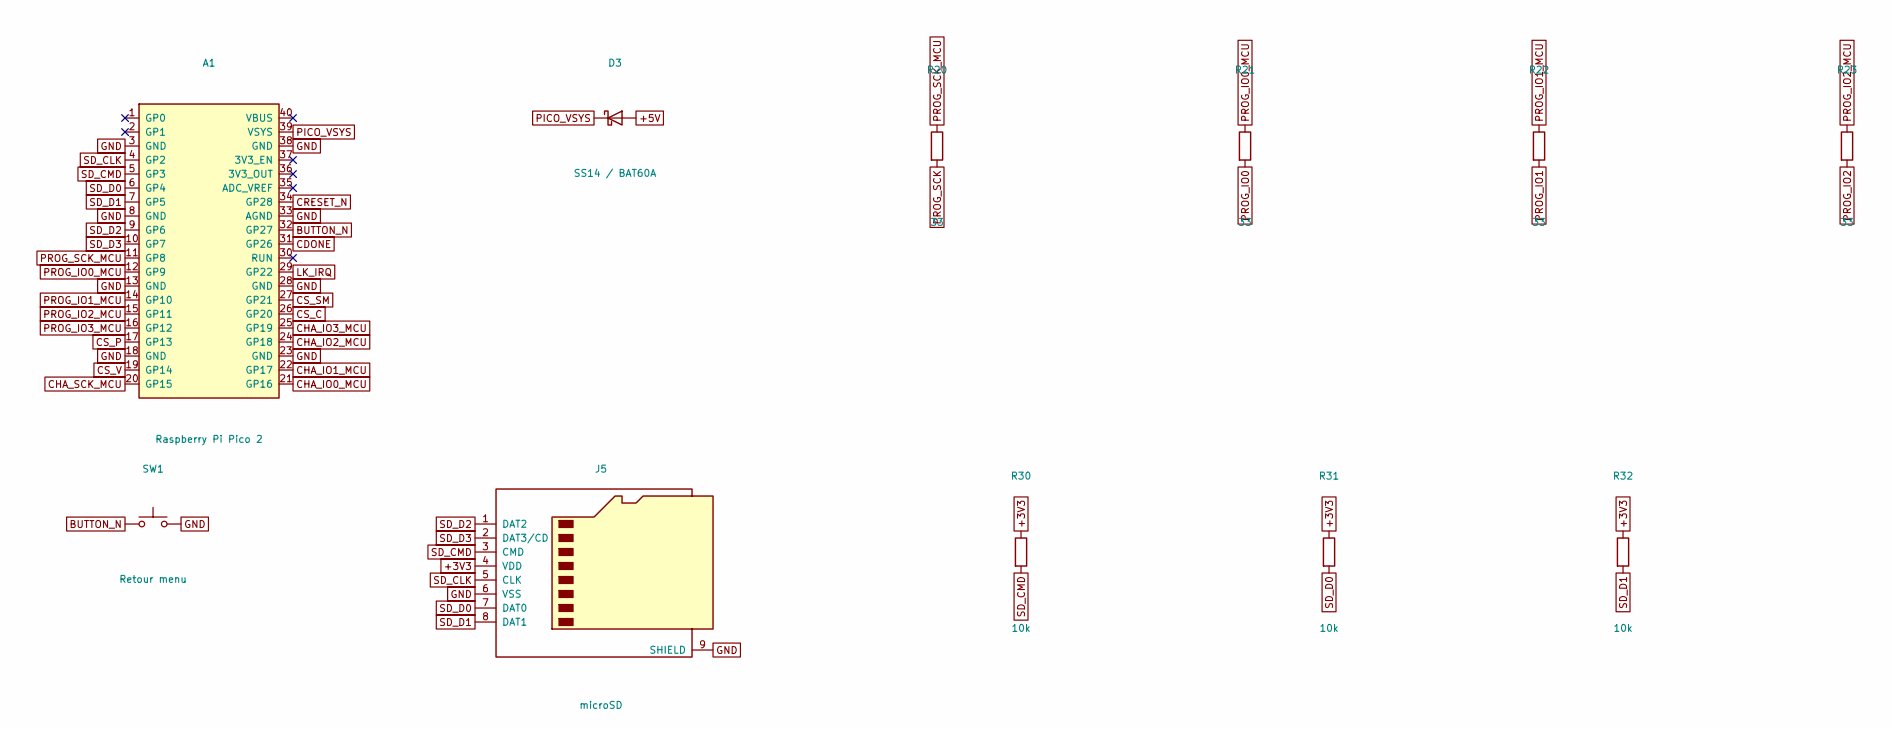
[picture p42: schematic mcu.kicad_sch, SDAES - carte PROG (programme 68000 + son ADPCM) - RP2350, …, part in row 1, column 1]

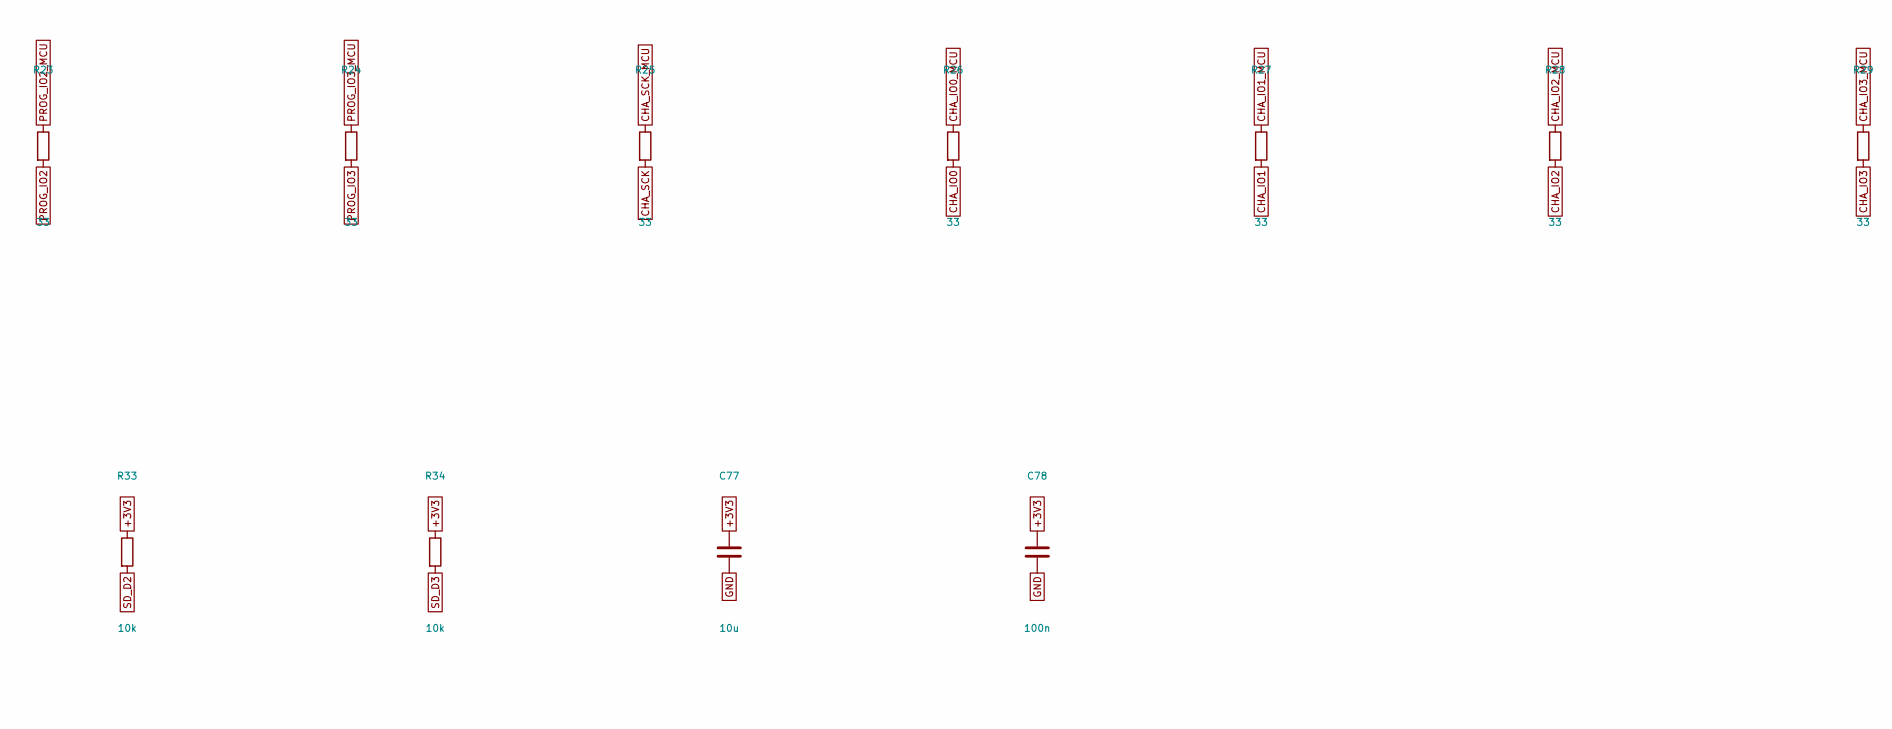
[picture p43: schematic mcu.kicad_sch, SDAES - carte PROG (programme 68000 + son ADPCM) - RP2350, …, part in row 1, column 2]

Parts:
A1: Raspberry Pi Pico 2; RaspberryPi_Pico2_SMD
C77: 10u; C_0805_2012Metric
C78: 100n; C_0603_1608Metric
D3: SS14 / BAT60A; D_SOD-123
J5: microSD; microSD_HC_Wuerth_693072010801
R20, R21, R22, R23, R24, R25, R26, R27, R28, R29: 33; R_0603_1608Metric
R30, R31, R32, R33, R34: 10k; R_0603_1608Metric
SW1: Retour menu; SW_SPST_TL3342

Connections:
+3V3: C77.1, C78.1, J5.4 (VDD), R30.1, R31.1, R32.1, R33.1, R34.1; also elsewhere on the board
+5V: D3.2 (A); also elsewhere on the board
BUTTON_N: A1.32 (GP27), SW1.1
CDONE: A1.31 (GP26); also elsewhere on the board
CHA_IO0: R26.2; also elsewhere on the board
CHA_IO0_MCU: A1.21 (GP16), R26.1
CHA_IO1: R27.2; also elsewhere on the board
CHA_IO1_MCU: A1.22 (GP17), R27.1
CHA_IO2: R28.2; also elsewhere on the board
CHA_IO2_MCU: A1.24 (GP18), R28.1
CHA_IO3: R29.2; also elsewhere on the board
CHA_IO3_MCU: A1.25 (GP19), R29.1
CHA_SCK: R25.2; also elsewhere on the board
CHA_SCK_MCU: A1.20 (GP15), R25.1
CRESET_N: A1.34 (GP28); also elsewhere on the board
CS_C: A1.26 (GP20); also elsewhere on the board
CS_P: A1.17 (GP13); also elsewhere on the board
CS_SM: A1.27 (GP21); also elsewhere on the board
CS_V: A1.19 (GP14); also elsewhere on the board
GND: A1.3 (GND), A1.8 (GND), A1.13 (GND), A1.18 (GND), A1.23 (GND), A1.28 (GND), A1.33 (AGND), A1.38 (GND), C77.2, C78.2, J5.6 (VSS), J5.9 (SHIELD), SW1.2; also elsewhere on the board
LK_IRQ: A1.29 (GP22); also elsewhere on the board
PICO_VSYS: A1.39 (VSYS), D3.1 (K)
PROG_IO0: R21.2; also elsewhere on the board
PROG_IO0_MCU: A1.12 (GP9), R21.1
PROG_IO1: R22.2; also elsewhere on the board
PROG_IO1_MCU: A1.14 (GP10), R22.1
PROG_IO2: R23.2; also elsewhere on the board
PROG_IO2_MCU: A1.15 (GP11), R23.1
PROG_IO3: R24.2; also elsewhere on the board
PROG_IO3_MCU: A1.16 (GP12), R24.1
PROG_SCK: R20.2; also elsewhere on the board
PROG_SCK_MCU: A1.11 (GP8), R20.1
SD_CLK: A1.4 (GP2), J5.5 (CLK)
SD_CMD: A1.5 (GP3), J5.3 (CMD), R30.2
SD_D0: A1.6 (GP4), J5.7 (DAT0), R31.2
SD_D1: A1.7 (GP5), J5.8 (DAT1), R32.2
SD_D2: A1.9 (GP6), J5.1 (DAT2), R33.2
SD_D3: A1.10 (GP7), J5.2 (DAT3/CD), R34.2

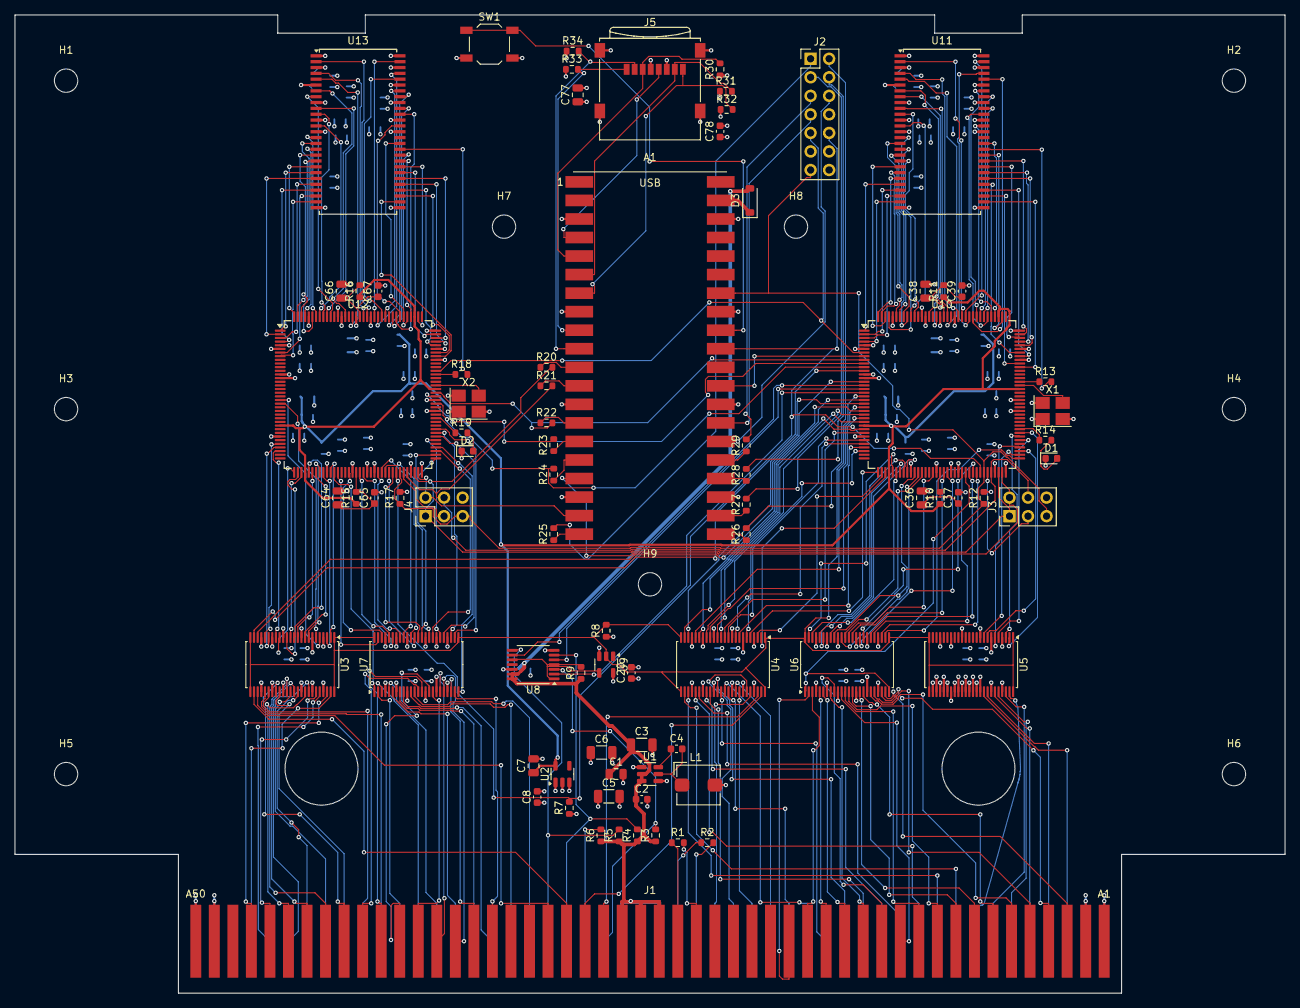
[picture p44: board prog.kicad_pcb from above]

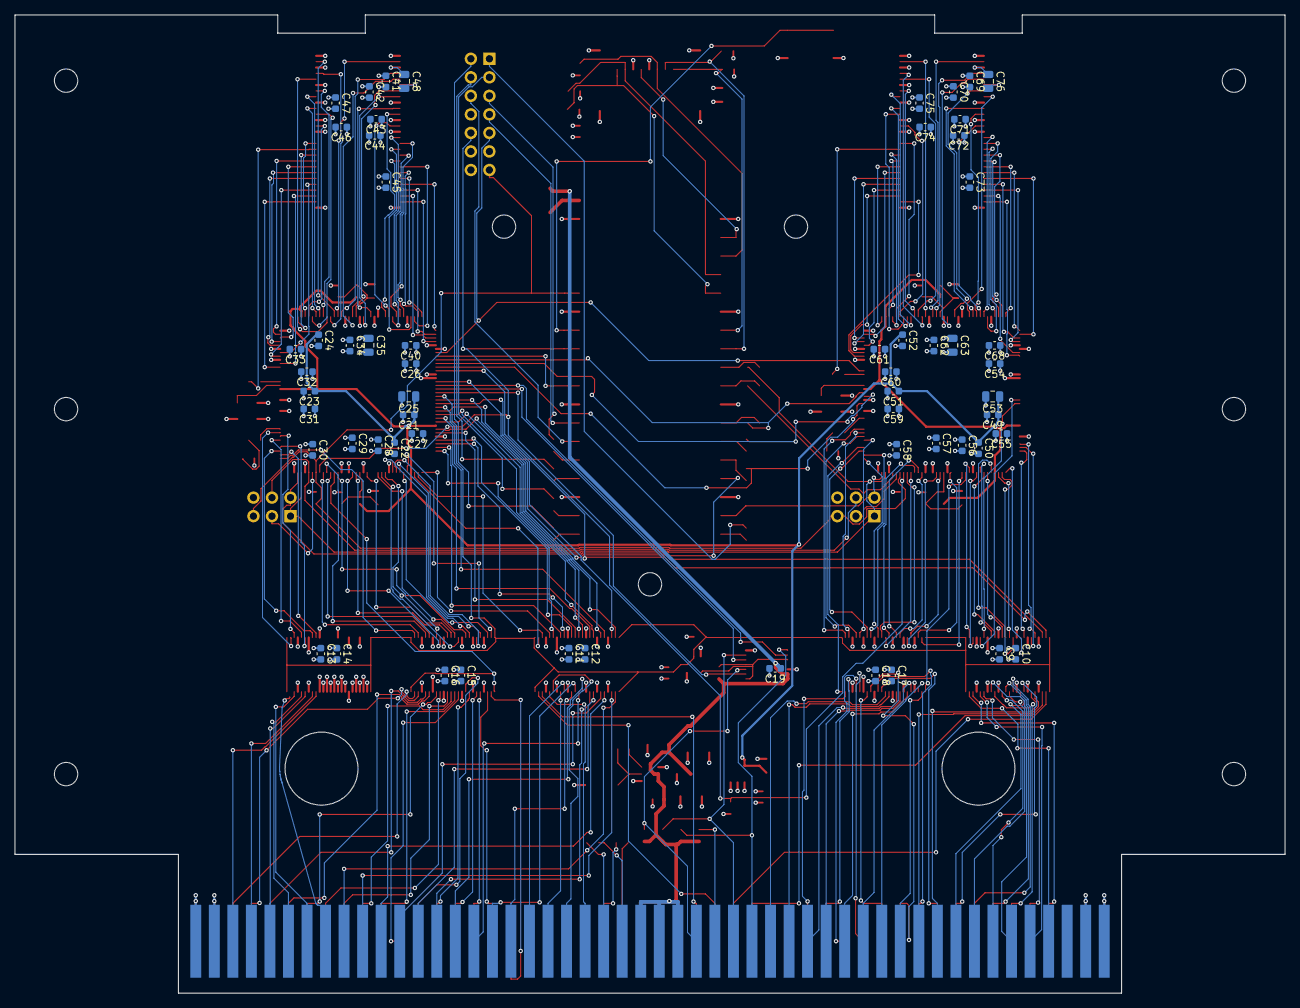
[picture p45: board prog.kicad_pcb from below]

Board: 4 copper layers, 174.0 x 134.0 mm, 147 parts (59 on the bottom side), 290 nets.

Other parts of the board:
H1, H2, H3, H4, H5, H6, H7, H8, H9: Entretoise M3; MountingHole_3.2mm_M3
