DocteurPCB/SDAES/hardware/cha_c.pcf

# Contraintes cha_c_top - iCE40HX4K-TQ144 (puce HX8K, outils libres)
# Généré par hardware/gen/fpga_pins.py (ne pas modifier à la main).
# « AES ... » = contact du connecteur de cartouche relié à ce port à
# travers un tampon de niveaux (hardware/aes_connector.csv).
set_io CLK25 93    # input, banc 1, GBIN3
set_io P[0] 12    # input, banc 3, AES CHA dessus 11
set_io P[1] 15    # input, banc 3, AES CHA dessous 11
set_io P[2] 18    # input, banc 3, AES CHA dessus 12
set_io P[3] 19    # input, banc 3, AES CHA dessous 12
set_io P[4] 7    # input, banc 3, AES CHA dessus 13
set_io P[5] 26    # input, banc 3, AES CHA dessous 13
set_io P[6] 8    # input, banc 3, AES CHA dessus 14
set_io P[7] 10    # input, banc 3, AES CHA dessous 14
set_io P[8] 9    # input, banc 3, AES CHA dessus 15
set_io P[9] 17    # input, banc 3, AES CHA dessous 15
set_io P[10] 11    # input, banc 3, AES CHA dessus 16
set_io P[11] 16    # input, banc 3, AES CHA dessous 16
set_io P[12] 22    # input, banc 3, AES CHA dessus 17
set_io P[13] 23    # input, banc 3, AES CHA dessous 17
set_io P[14] 24    # input, banc 3, AES CHA dessus 18
set_io P[15] 25    # input, banc 3, AES CHA dessous 18
set_io P[16] 45    # input, banc 2, AES CHA dessus 19
set_io P[17] 44    # input, banc 2, AES CHA dessous 19
set_io P[18] 48    # input, banc 2, AES CHA dessus 20
set_io P[19] 47    # input, banc 2, AES CHA dessous 20
set_io P[20] 52    # input, banc 2, GBIN4, AES CHA dessus 21
set_io P[21] 49    # input, banc 2, GBIN5, AES CHA dessous 21
set_io P[22] 56    # input, banc 2, AES CHA dessus 22
set_io P[23] 55    # input, banc 2, AES CHA dessous 22
set_io PCK1B 20    # input, banc 3, GBIN7, AES CHA dessus 3
set_io CA4 43    # input, banc 2, AES CHA dessus 10
set_io CLK_12M 21    # input, banc 3, GBIN6, AES CHA dessus 5
set_io EVEN 60    # input, banc 2, AES CHA dessus 7
set_io LOAD 42    # input, banc 2, AES CHA dessus 9
set_io H 41    # input, banc 2, AES CHA dessus 8
set_io GAD[0] 38    # output, banc 2, AES CHA dessous 32
set_io GAD[1] 37    # output, banc 2, AES CHA dessous 33
set_io GAD[2] 34    # output, banc 3, AES CHA dessous 34
set_io GAD[3] 33    # output, banc 3, AES CHA dessous 35
set_io GBD[0] 32    # output, banc 3, AES CHA dessous 36
set_io GBD[1] 31    # output, banc 3, AES CHA dessous 37
set_io GBD[2] 29    # output, banc 3, AES CHA dessous 38
set_io GBD[3] 28    # output, banc 3, AES CHA dessous 39
set_io DOTA 62    # output, banc 2, AES CHA dessous 30
set_io DOTB 61    # output, banc 2, AES CHA dessous 31
set_io XLAT_EN_N 39    # output, banc 2
set_io LK_SCK 70    # input, configuration SPI
set_io LK_CS_N 71    # input, configuration SPI
set_io LK_IO[0] 68    # inout, configuration SPI
set_io LK_IO[1] 2    # inout, banc 3
set_io LK_IO[2] 1    # inout, banc 3
set_io LK_IO[3] 3    # inout, banc 3
set_io MODE 4    # input, banc 3
set_io SD_CLK 94    # output, banc 1, GBIN2
set_io SD_CKE 105    # output, banc 1
set_io SD_CS_N 136    # output, banc 0
set_io SD_RAS_N 135    # output, banc 0
set_io SD_CAS_N 134    # output, banc 0
set_io SD_WE_N 130    # output, banc 0
set_io SD_BA[0] 137    # output, banc 0
set_io SD_BA[1] 138    # output, banc 0
set_io SD_A[0] 141    # output, banc 0
set_io SD_A[1] 142    # output, banc 0
set_io SD_A[2] 143    # output, banc 0
set_io SD_A[3] 144    # output, banc 0
set_io SD_A[4] 95    # output, banc 1
set_io SD_A[5] 96    # output, banc 1
set_io SD_A[6] 97    # output, banc 1
set_io SD_A[7] 98    # output, banc 1
set_io SD_A[8] 99    # output, banc 1
set_io SD_A[9] 101    # output, banc 1
set_io SD_A[10] 139    # output, banc 0
set_io SD_A[11] 102    # output, banc 1
set_io SD_A[12] 104    # output, banc 1
set_io SD_DQM[0] 129    # output, banc 0, GBIN0
set_io SD_DQM[1] 106    # output, banc 1
set_io SD_DQ[0] 118    # inout, banc 0
set_io SD_DQ[1] 119    # inout, banc 0
set_io SD_DQ[2] 120    # inout, banc 0
set_io SD_DQ[3] 121    # inout, banc 0
set_io SD_DQ[4] 122    # inout, banc 0
set_io SD_DQ[5] 124    # inout, banc 0
set_io SD_DQ[6] 125    # inout, banc 0
set_io SD_DQ[7] 128    # inout, banc 0, GBIN1
set_io SD_DQ[8] 107    # inout, banc 1
set_io SD_DQ[9] 110    # inout, banc 0
set_io SD_DQ[10] 112    # inout, banc 0
set_io SD_DQ[11] 113    # inout, banc 0
set_io SD_DQ[12] 114    # inout, banc 0
set_io SD_DQ[13] 115    # inout, banc 0
set_io SD_DQ[14] 116    # inout, banc 0
set_io SD_DQ[15] 117    # inout, banc 0
set_io LED 81    # output, banc 1
