DocteurPCB/SDAES/hardware/prog_v.pcf

# Contraintes prog_v_top - iCE40HX4K-TQ144 (puce HX8K, outils libres)
# Généré par hardware/gen/fpga_pins.py (ne pas modifier à la main).
# « AES ... » = contact du connecteur de cartouche relié à ce port à
# travers un tampon de niveaux (hardware/aes_connector.csv).
set_io CLK25 93    # input, banc 1, GBIN3
set_io SDRAD[0] 63    # inout, banc 2, AES PROG dessous 32
set_io SDRAD[1] 62    # inout, banc 2, AES PROG dessous 33
set_io SDRAD[2] 61    # inout, banc 2, AES PROG dessous 34
set_io SDRAD[3] 60    # inout, banc 2, AES PROG dessous 35
set_io SDRAD[4] 56    # inout, banc 2, AES PROG dessous 36
set_io SDRAD[5] 55    # inout, banc 2, AES PROG dessous 37
set_io SDRAD[6] 52    # inout, banc 2, GBIN4, AES PROG dessous 38
set_io SDRAD[7] 49    # inout, banc 2, GBIN5, AES PROG dessous 39
set_io SDRA_L[8] 32    # input, banc 3, AES PROG dessous 40
set_io SDRA_L[9] 33    # input, banc 3, AES PROG dessous 41
set_io SDRA_U[20] 37    # input, banc 2, AES PROG dessous 42
set_io SDRA_U[21] 39    # input, banc 2, AES PROG dessous 43
set_io SDRA_U[22] 42    # input, banc 2, AES PROG dessous 44
set_io SDRA_U[23] 44    # input, banc 2, AES PROG dessous 45
set_io SDRMPX 20    # input, banc 3, GBIN7, AES PROG dessous 46
set_io SDROE_N 47    # input, banc 2, AES PROG dessous 47
set_io SDPAD[0] 81    # inout, banc 1, AES PROG dessus 34
set_io SDPAD[1] 80    # inout, banc 1, AES PROG dessus 35
set_io SDPAD[2] 79    # inout, banc 1, AES PROG dessus 36
set_io SDPAD[3] 78    # inout, banc 1, AES PROG dessus 37
set_io SDPAD[4] 75    # inout, banc 1, AES PROG dessus 38
set_io SDPAD[5] 74    # inout, banc 1, AES PROG dessus 39
set_io SDPAD[6] 73    # inout, banc 1, AES PROG dessus 40
set_io SDPAD[7] 64    # inout, banc 2, AES PROG dessus 41
set_io SDPA[8] 34    # input, banc 3, AES PROG dessus 42
set_io SDPA[9] 38    # input, banc 2, AES PROG dessus 43
set_io SDPA[10] 41    # input, banc 2, AES PROG dessus 44
set_io SDPA[11] 43    # input, banc 2, AES PROG dessus 45
set_io SDPMPX 21    # input, banc 3, GBIN6, AES PROG dessus 46
set_io SDPOE_N 45    # input, banc 2, AES PROG dessus 47
set_io RAD_DIR 48    # output, banc 2
set_io PAD_DIR 76    # output, banc 1
set_io LK_SCK 70    # input, configuration SPI
set_io LK_CS_N 71    # input, configuration SPI
set_io LK_IO[0] 68    # inout, configuration SPI
set_io LK_IO[1] 91    # inout, banc 1
set_io LK_IO[2] 90    # inout, banc 1
set_io LK_IO[3] 88    # inout, banc 1
set_io MODE 97    # input, banc 1
set_io SD_CLK 96    # output, banc 1
set_io SD_CKE 113    # output, banc 0
set_io SD_CS_N 143    # output, banc 0
set_io SD_RAS_N 142    # output, banc 0
set_io SD_CAS_N 141    # output, banc 0
set_io SD_WE_N 139    # output, banc 0
set_io SD_BA[0] 144    # output, banc 0
set_io SD_BA[1] 1    # output, banc 3
set_io SD_A[0] 3    # output, banc 3
set_io SD_A[1] 4    # output, banc 3
set_io SD_A[2] 7    # output, banc 3
set_io SD_A[3] 8    # output, banc 3
set_io SD_A[4] 101    # output, banc 1
set_io SD_A[5] 102    # output, banc 1
set_io SD_A[6] 104    # output, banc 1
set_io SD_A[7] 105    # output, banc 1
set_io SD_A[8] 106    # output, banc 1
set_io SD_A[9] 107    # output, banc 1
set_io SD_A[10] 2    # output, banc 3
set_io SD_A[11] 110    # output, banc 0
set_io SD_A[12] 112    # output, banc 0
set_io SD_DQM[0] 138    # output, banc 0
set_io SD_DQM[1] 114    # output, banc 0
set_io SD_DQ[0] 124    # inout, banc 0
set_io SD_DQ[1] 125    # inout, banc 0
set_io SD_DQ[2] 128    # inout, banc 0, GBIN1
set_io SD_DQ[3] 130    # inout, banc 0
set_io SD_DQ[4] 134    # inout, banc 0
set_io SD_DQ[5] 135    # inout, banc 0
set_io SD_DQ[6] 136    # inout, banc 0
set_io SD_DQ[7] 137    # inout, banc 0
set_io SD_DQ[8] 115    # inout, banc 0
set_io SD_DQ[9] 116    # inout, banc 0
set_io SD_DQ[10] 117    # inout, banc 0
set_io SD_DQ[11] 118    # inout, banc 0
set_io SD_DQ[12] 119    # inout, banc 0
set_io SD_DQ[13] 120    # inout, banc 0
set_io SD_DQ[14] 121    # inout, banc 0
set_io SD_DQ[15] 122    # inout, banc 0
set_io LED 84    # output, banc 1
