DocteurPCB/SDAES/hdl/common/sync2.v

// Synchroniseur 2 bascules pour signaux asynchrones venant de la console.
module sync2 #(
    parameter W = 1,
    parameter [W-1:0] INIT = {W{1'b0}}
) (
    input  wire         clk,
    input  wire [W-1:0] d,
    output wire [W-1:0] q
);
    reg [W-1:0] s1 = INIT;
    reg [W-1:0] s2 = INIT;
    always @(posedge clk) begin
        s1 <= d;
        s2 <= s1;
    end
    assign q = s2;
endmodule
