DocteurPCB/SDAES/(commit log)

2026-10-13 SDAES : cartouche SD pour Neo Geo AES (conception, HDL, menu, firmware)
    Architecture : deux FPGA ECP5 (cartes PROG et CHA) servent les bus de la
    console depuis des SDRAM/SRAM ; un Raspberry Pi Pico 2 (RP2350) lit la
    carte SD et charge les fichiers .neo par une liaison 4 bits.
    - hdl/ : cœurs PROG (ROM P + banques, boîte aux lettres du menu, NEO-PCM2)
    et CHA (NEO-273, NEO-ZMC2, M1 + banques Z80), contrôleur SDRAM, liaison,
    bancs de test Icarus et cible de synthèse Yosys ECP5
    - menu/ : menu 68000 (C + crt0) et pilote Z80 minimal
    - firmware/rp2350/ : chargement .neo, navigation SD, protocole du menu,
    harnais de test sur PC
    - tools/neotool.py : format .neo, police du menu, fichiers BRA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
2026-10-13 Passage à 4 FPGA iCE40 en TQFP-144 : cartouche soudable à la main
    Les ECP5 en BGA sont remplacés par quatre iCE40 (puce HX8K, boîtier
    TQFP-144), un par bus de la console : P (programme 68000, menu, boîte aux
    lettres), V (ADPCM), C (sprites + ZMC2), SM (couche fixe + Z80). Mémoires
    en TSOP : SDRAM 32 Mo pour P et V, SDRAM 64 Mo x16 pour C, SRAM 1 Mo.
    - contrôleur SDRAM x16 à 100 MHz/CL2 : rafale de 4 lectures (sprites) et
    lecture sur deux banques en parallèle
    - FPGA P : P1 et zone banquée dans des banques SDRAM distinctes, lecture
    anticipée des deux candidats dès que l'adresse 68000 change
    - étages de registre sur les chemins critiques ; placement-routage
    nextpnr des 4 FPG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
    [board.h, bram_dp.v, browser.c, cha_c.pcf, cha_c_core.v, cha_c_top.v, cha_sm_core.v]
2026-10-13 Cartouches protégées : SMA, PVC et superposition KOF 98
    - hdl/prog/p_mapper.v : fenêtre P2 à décalage libre ; SMA (registre de
    banque brouillé + table de 64 décalages, lecture de protection,
    générateur LFSR) ; PVC (RAM de protection 8 Ko en SDRAM, registres
    0xFF0-0xFF9, (dé)compactage de couleurs, banques) ; superposition KOF 98
    - FPGA P : lectures servies par le mapper, écritures du jeu en SDRAM,
    anticipation invalidée à chaque écriture
    - firmware : descriptions .map / SDAES/MAPPERS.TXT, PVC reconnu par NGH,
    refus explicite d'un jeu SMA sans table
    - neotool : commandes mapper et sma-from-mame (extraction des tables SMA
    depuis le source MAME)
    - tests : banc de test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
2026-10-13 Docs : résultats de placement-routage avec les protections
    Claude-Session: https://claude.ai/code/session_01WKfXP1YJ8otGxZ5dsY6Agh
2026-10-13 Corrections d'après le wiki neogeodev : ZMC2 au front montant de 12M, connecteur AES 2 x 50 contacts
    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
    [zmc2_dot.v]
2026-10-14 Brochage AES relevé sur le wiki neogeodev et corrections associées
    - hardware/aes_connector.csv : les 200 contacts (PROG/CHA, dessus/dessous)
    d'après la page « AES cartridge pinout » ; tableau dans docs/02 ; les
    gabarits .pcf indiquent le contact AES de chaque port FPGA.
    - ZMC2 : retour au front descendant de 12M (page NEO-ZMC2 : LOAD et pixels
    au front descendant), la correction précédente était erronée.
    - Adresse S corrigée : A16..A5 = P11..P0, A4 = P15, A3 = 2H1,
    A2..A0 = P14..P12 (pages NEO-273 et P bus). Adresse C confirmée.
    - FPGA P : /PORTOEU et /PORTOEL au lieu d'un /PORTOE inexistant sur le
    connecteur ; sorties /ROMWAIT, /PWAIT0, /PWAIT1 pilotées par le registr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
    [aes_connector.csv]
2026-10-14 Docs : résultats de placement-routage après les corrections du brochage AES
    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
2026-10-14 Banques de couche fixe NEO-CMC, recoupées avec SNKVerilog et le cœur MiSTer
    - hdl/cha/cmc_fix.v : le FPGA SM retrouve la colonne de chaque PCK2B
    (séquence LSPC : colonne 63 puis 0..46, changement de P[14:12] à la
    colonne 63, d'après le LSPC du cœur MiSTer NeoGeo) et capture les mots
    de banque des colonnes cachées 40-46.
    Type 2 (KOF 2000, SVC, KOF 2003) complet ; type 1 (Garou, MS3/MS4) :
    banque constante, approché pour Garou (pas de repère de trame sur le
    connecteur). Adresse S sur 19 bits, registre SM 0x06.
    - Firmware : type choisi d'après le NGH ou la clé fix_bank ; neotool idem.
    - Bancs de test : séquence LSPC complète, types 1 et 2 ; tests firmware.
    - Docs : reco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
    [cha_sm_core.v, cmc_fix.v, mapper.c, mapper.h, neo_loader.c, qlink.h, tb_cha.v]
2026-10-14 Protection PRO-CT0 (Fatal Fury 2, Super Sidekicks)
    Le PRO-CT0 est le sérialiseur de pixels repris dans le NEO-ZMC2 ; sur ces
    deux jeux il est câblé sur le bus 68000 de la carte PROG. Mode 3 du
    p_mapper, d'après MAME (prot_fatfury2.cpp, alpha_8921.cpp) : écriture en
    0x2xxxxx = front d'horloge (LOAD = A1, EVEN = A2, H = A3, C = A19..A4 et
    D15..D0 permutés), lecture = GAD/GBD sur D7..D0.
    - Banc de test : lectures comparées à un modèle transcrit de MAME.
    - Firmware : mode « ct0 », reconnu par le NGH (047, 052) ; correction d'un
    débordement de la table des noms de modes, trouvé en compilant le test
    du firmware avec AddressSanitizer/UBSan (désormais actifs).
    - Docs : PRO-CT0, é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
    [mapper.c, mapper.h, neo_loader.c, p_mapper.v, tb_prog.v, test_firmware.py]
2026-10-14 Metal Slug X : contrôles de protection neutralisés dans P1 au chargement
    Comme la réparation du wiki neogeodev (« Repairing Metal Slug X » : ROM P1
    modifiée sur une carte à banques standard), le firmware applique pendant
    le chargement les modifications de MAME 0.145 (mslugx_install_protection) :
    le bne qui suit chaque andi.w #$1,D3 dans P1 et huit mots fixes
    deviennent des NOP. Recherche faite au fil du transfert (séquences à
    cheval sur deux blocs comprises), écriture des NOP ensuite en SDRAM ;
    le .neo n'est pas modifié.
    - Reconnu par le NGH 250, clé « patch = mslugx » sinon (firmware, neotool).
    - Test firmware : faux Metal Slug X, séquence à cheval sur deux blocs.
    - Docs mi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
    [mapper.c, mapper.h, neo_loader.c, test_firmware.py, test_neotool.py]
2026-10-14 Versions sans SMA (prototype de Garou, MS3 h, KOF 2000 n) reconnues
    Ces versions partagent le NGH du jeu SMA. Dans MAME, les versions SMA ont
    une zone P de 9 Mo, les autres 5 Mo au plus : le firmware ne refuse plus
    ces jeux et n'applique plus une section SMA de MAPPERS.TXT trouvée
    seulement par le NGH quand P fait 5 Mo au plus. Le prototype de Garou,
    sans SMA ni banques de couche fixe, fonctionne donc entièrement.
    Tests firmware : en-tête SMA de 9 Mo refusé, prototype accepté en mode
    standard. Docs mises à jour.
    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
    [mapper.c, mapper.h, neo_loader.c, test_firmware.py]
2026-10-14 Metal Slug 5 Plus et bootleg de Metal Slug 5
    - FPGA P : mode 4 (MS5P) d'après MAME (write_bankprot_ms5p,
    mslug5p_prot_r) : lecture 0x00A0 en 0x2FFFF0-0x2FFFFF, fenêtre P2 à
    l'octet 0xA0 ou à (donnée >> 4) Mo ; champ de mode sur 3 bits.
    - Firmware : NGH 268 départagé après la lecture de P : 8 Mo -> PVC,
    5 Mo et CRC32 du premier Mo = ms5-p1p.bin (0x106B276F) -> MS5P, sinon
    banques standard (bootleg). CRC calculé au fil du transfert ; la
    recherche Metal Slug X est limitée au flux P.
    - neotool build : --descramble mslug5b|ms5plus (sx/vx/cx de MAME),
    --c-align (paires C alignées comme la région de MAME), --from JEU.NEO
    (régions reprises d'un .neo existant).
    - Tests : ba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
2026-10-14 Bootlegs de SVC Chaos et KOF 2003 ; correction de la PVC
    - FPGA P : modes 5/6 (K3B, K3P) d'après MAME prot_kof2k3bl.cpp : RAM de
    8 Ko en 0x2FE000, banque sur écriture de 0xFF8/0xFF9, mot lu en
    0x058196 (K3B).
    - Correction PVC (MAME pvc_prot_device::get_bank_base) : après un
    changement de banque, 0xA0 va dans l'octet bas de 0xFF8 et c'est le
    bit 15 de 0xFF9 qui est effacé (SDAES inversait les octets) ; les
    écritures en 0xFFA-0xFFF changent aussi la banque, comme dans MAME.
    - Timing : conditions d'écriture des registres PVC décodées un cycle plus
    tôt, nouvelle base P2 appliquée au cycle suivant (101,4 MHz).
    - Firmware : versions départagées par le NGH et la taille de P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
    [mapper.c, mapper.h, neo_loader.c, p_mapper.v, tb_prog.v, test_firmware.py]
2026-10-14 Niveaux 5 V : tampons choisis selon le sens et seuils TTL
    Le 74LVC16T245 alimenté en 5 V côté console ne reconnaît un 1 qu'au-dessus
    de 3,5 V, trop haut pour des sorties TTL de la console (PCK1B/PCK2B
    viennent de 74AS04). Nouveau schéma de niveaux :
    - console -> cartouche : 74LVC16244A/16245A en 3,3 V (entrées tolérantes
    au 5 V, seuil TTL 2,0 V) ;
    - cartouche -> puces vidéo SNK, attentes, Z80 : 74AHCT en 5 V ;
    - bus bidirectionnels D et SDRAD/SDPAD : 74LVC16245A en 3,3 V.
    Mise sous tension : /OE des 74AHCT tiré au 5 V et commandé par un
    74LVC1G07 à drain ouvert (sinon actifs pendant la montée du 3,3 V) ; /OE
    du bus SDD = SDD_OE_N OU OE5_N (74AHCT1G32) pour rester rapide.
    Docs 0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
2026-10-14 Broches réelles des 4 FPGA, validées par nextpnr
    - hardware/gen/fpga_pins.py : affectation des broches iCE40HX4K-TQ144
    (connecteur sur les bancs 3/2, mémoire et liaison sur les bancs 0/1,
    horloges sur GBIN, broche 129 réservée à une sortie à cause de la PLL,
    broches SPI réservées) -> hardware/*.pcf avec les vrais numéros.
    - hdl/Makefile : le placement-routage utilise désormais ces contraintes ;
    bitstreams par icepack.
    - Résultats avec les broches réelles : P 103,3 MHz, V 102,2 MHz,
    C 107,6 MHz, SM 108,8 MHz.
    - tools/gen_pcf.py devient une bibliothèque (ports des tops, contacts AES).
    Claude-Session: https://claud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
2026-10-14 Schémas KiCad des cartes PROG et CHA, générés et vérifiés
    - hardware/gen/kicad.py : écriture de schémas KiCad 7 (une étiquette
    globale par broche), symboles de la bibliothèque officielle ou maison,
    relecture de la netlist exportée par kicad-cli.
    - hardware/gen/boards.py : description des deux cartes (alimentations,
    4 FPGA avec flash, oscillateur, filtres PLL et connecteur de
    programmation, SDRAM, SRAM, tampons de niveaux canal par canal,
    Pico 2, microSD, câble inter-cartes). Brochages hors bibliothèque
    relevés dans les fiches TI, ISSI et Raspberry Pi.
    - hardware/gen/footprints.py : empreintes du connecteur de bord AES
    (provisoire) et du Pico 2, symboles du projet,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
    [buffers.kicad_sch, cha.kicad_sch, fpga_c.kicad_sch, fpga_p.kicad_sch, fpga_sm.kicad_sch, fpga_v.kicad_sch, mcu.kicad_sch, power.kicad_sch]
2026-10-14 FPGA C : changement de demi-tuile C au front montant de 12M
    Simulation du LSPC de Furrtek (cœur MiSTer) : CA4 bascule au même
    instant que le front descendant de 12M où le ZMC2 prend la donnée
    (LOAD). Une vraie ROM C, lente, présente encore la moitié de l'ancien
    CA4 ; la sélection combinatoire de SDAES pouvait prendre la nouvelle.
    La moitié choisie ne change désormais qu'au front montant de 12M
    (41 ns après chaque prise), ce qui tolère +-30 ns de décalage entre
    CA4 (LSPC) et 12M (NEO-D0). Test ajouté (tb_cha : CA4 basculant avec
    LOAD).
    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
2026-10-14 Banque P standard sur 3 bits ; timings LSPC dans la doc
    Le registre de banque standard (0x2FFFF0) ne garde que les bits 2-0
    de la donnée écrite, comme write_banksel de MAME (data & 7). Test
    ajouté dans tb_prog. Documentation : marges PCK1B->LOAD et
    PCK2B->FIXD mesurées sur le LSPC de Furrtek, course CA4/LOAD,
    bilan du recoupement avec SNKVerilog, NeoChips et MiSTer.
    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
    [p_mapper.v, tb_prog.v]
2026-10-14 FPGA P : décision de banque précalculée, 105,7 MHz
    Le changement de base P2 (banques standard sur 3 bits, Metal Slug 5
    Plus) faisait passer le FPGA P sous 100 MHz (94,8 MHz, 8 graines) :
    comparaisons sur a et d en série avec wr_go. Le candidat et la
    condition sont désormais registrés à chaque cycle (a, d et wr_be sont
    stables avant wr_go) ; wr_go ne fait plus que valider. Simulations
    inchangées, placement-routage à 105,7 MHz.
    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
2026-10-14 Connecteur AES : numérotation officielle, empreinte et contours des cartes
    Recoupement avec les cartes AES de jwestfall69 (neogeo-diag-aes-prog et
    neogeo-diag-aes-cha, fabriquées et testées, domaine public) :
    - la face « dessus » (contacts A, côté composants) était numérotée à
    l'envers : position n -> 51 - n. A1 et B1 sont à droite vus côté
    composants, l'un derrière l'autre (sérigraphie A1 des cartes NEO-AEG) ;
    face B inchangée. Les 200 contacts concordent désormais.
    - empreinte : contacts 1,5 x 10 mm, centre à 7,1 mm du bord, T1 à droite.
    - hardware/gen/outline.py : contours PROG (174 x 115 mm) et CHA
    (173 x 115 mm), languette 129,2 x 19 mm, encoches, trous de 10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
    [aes_connector.csv, buffers.kicad_sch, cha.kicad_pcb, cha.kicad_sch, fpga_c.kicad_sch, fpga_p.kicad_sch, fpga_sm.kicad_sch, fpga_v.kicad_sch]
2026-10-14 Doc : cartes jwestfall69 = référence mécanique seulement
    Ce sont des cartes de test du Z80 : leurs choix électriques (contacts
    d'attente reliés au +5 V, etc.) ne valent pas pour une cartouche de jeu.
    Retrait de la remarque sur B28-B31 ; seules la position des contacts et
    les cotes sont reprises.
    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
2026-10-14 Circuits imprimés 2 couches : placement et affectation des broches FPGA
    - hardware/gen/pcb.py : empreintes et réseaux depuis boards.py, contour
    depuis outline.py ; ancres placées (contacts, rangée de tampons, FPGA,
    mémoires ; CHA : Pico au centre, microSD et bouton en haut), passifs
    au plus près de leur broche, masse coulée sur les deux faces.
    - --pins : signaux des FPGA affectés aux broches tournées vers leur
    cible en conservant l'ordre circulaire (pins_opt.json, repris par
    fpga_pins.py) ; stable en trois passes.
    - boards.py : canaux des tampons triés selon la position des contacts.
    - hardware/gen/route.py : export Specctra, Freerouting, relecture de la
    session, DRC.
    P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
    [buffers.kicad_sch, cha.kicad_pcb, cha.kicad_sch, fpga_c.kicad_sch, fpga_p.kicad_sch, fpga_sm.kicad_sch, fpga_v.kicad_sch, mcu.kicad_sch]
2026-10-14 Circuits imprimés en 4 couches
    Empilement F.Cu signaux / In1 masse / In2 +3V3 / B.Cu signaux : chemin
    de retour continu pour la SDRAM à 100 MHz et découplage des FPGA.
    route.py déclare les couches internes « power » pour Freerouting.
    Doc : fréquences des FPGA avec les broches du circuit imprimé (P à
    100,2 MHz, limite).
    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
    [cha.kicad_pcb, prog.kicad_pcb]
2026-10-14 PCB : découplage sous les boîtiers, en face arrière
    Les condensateurs de découplage des FPGA, mémoires et tampons, placés
    devant les rangées de broches, bloquaient leur sortie (premier essai
    de routage : 52 % des broches sorties, 116 liaisons non routées). Ils
    sont désormais sous le boîtier, face arrière, reliés aux plans par
    des vias courts.
    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
    [cha.kicad_pcb, prog.kicad_pcb]
2026-10-14 PCB : pistes et isolements de 0,127 mm
    Premier routage 4 couches bloqué à 76 liaisons sur la carte PROG avec
    0,15 mm ; 0,127 mm (5 mil) reste dans les capacités courantes des
    fabricants en 4 couches.
    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
    [prog.kicad_pcb]
2026-10-14 PCB CHA : ouverture du lecteur microSD tournée vers le bord supérieur
    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
    [cha.kicad_pcb]
2026-10-14 PCB : 9 trous d'entretoise, vias vers les plans, zones interdites
    - 9 trous M3 aux mêmes coordonnées sur PROG et CHA (H1-H9) pour relier
    les deux cartes par des entretoises ; 3,5 mm sans composant ni cuivre
    autour.
    - Vias de raccordement aux plans (masse, +3V3) posés avant le routage
    pour chaque pastille CMS : au premier routage complet de la carte
    PROG, tous les signaux étaient routés et les 85 liaisons manquantes
    étaient toutes des raccordements aux plans.
    - Zones interdites aux pistes autour des trous de la coque et des
    entretoises ; rétrécissement à 0,09 mm admis à l'entrée des broches.
    - route.py : DRC par le module pcbnew (kicad-cli 7 n'en a pas), lecture
    de se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
    [cha.kicad_pcb, prog.kicad_pcb]
2026-10-14 Routage : vias vers les plans verrouillés, Freerouting sans sortie des broches ni optimisation
    L'import de la session effaçait aussi les vias vers les plans posés par
    pcb.py (82 des 85 liaisons manquantes de la carte PROG) : ils sont
    désormais verrouillés et conservés. Freerouting ne refait plus la
    sortie des broches (près d'une heure perdue sur la carte CHA) ni
    l'optimisation finale. Zones interdites limitées aux 4 couches
    utilisées ; remplissage et DRC dans un processus à part (second
    LoadBoard inutilisable dans le même processus).
    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
    [cha.kicad_pcb, prog.kicad_pcb]
2026-10-14 FPGA configurés par le RP2350 depuis la carte SD (plus de flash)
    - Matériel : flash SPI retirées (4 W25Q32, 12 résistances, 4
    condensateurs). Le bus de liaison arrive sur les broches de
    configuration des iCE40 (LK_SCK -> 70 SCK, LK_IO[0] -> 68 SDI,
    LK_CS_N -> 71 SS), qui redeviennent ces entrées après le démarrage.
    CRESET_N commun aux 4 FPGA, tiré à la masse, piloté par le RP2350
    (GP28) ; câble PROG-CHA en 2 x 7 (CRESET_N + masse). Connecteur 2 x 3
    de secours par FPGA (iceprog -S).
    - Firmware : fpga_boot.c (reset commun en mode SPI esclave, envoi des
    SDAES/fpga_*.bin l'un après l'autre, contrôle de CDONE) ; testé sur
    PC (bitstreams reçus à l'identique, FPGA la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
    [buffers.kicad_sch, cha.kicad_pcb, cha.kicad_sch, fpga_c.kicad_sch, fpga_p.kicad_sch, fpga_sm.kicad_sch, fpga_v.kicad_sch, mcu.kicad_sch]
2026-10-14 Doc : fréquences des FPGA avec le bus de liaison sur les broches de configuration
    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
2026-10-14 Versions des FPGA dans le menu, codes d'erreur sur la LED du Pico
    - Registre 0x0F (version du bitstream) dans les 4 FPGA, fixé à la
    synthèse (make -C hdl VERSION=, par défaut le nombre de commits).
    - Firmware : versions lues au démarrage et déposées dans la boîte aux
    lettres (MB_RSP_FPGAVER) ; le menu les affiche sous le titre.
    - Échec au démarrage : la LED du Pico répète le code d'erreur puis le
    numéro du FPGA concerné (fichier absent, taille, lecture, CDONE,
    FPGA muet, pas de carte SD).
    - Tests : bancs HDL (registre de version), firmware sur PC.
    Claude-Session: https://claude.ai/code/session_01WKfXP1YJ8otGxZ5dsY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
    [browser.c, browser.h, cha_c_core.v, cha_sm_core.v, fpga_boot.c, fpga_boot.h, main.c]
2026-10-14 Feuille de route : écran d'accueil personnalisable (plus tard)
    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
2026-10-14 PCB : vias vers les plans réglementaires et hors des couloirs de sortie
    Le routage précédent (171 liaisons non routées, 40 violations dès le
    départ) était faussé par les vias vers les plans : posés vers
    l'extérieur des boîtiers, ils bloquaient la sortie des signaux, et leur
    piste de raccordement pouvait frôler les pastilles voisines.
    - direction suivant l'axe de la pastille (et non le centre du
    composant, faux près des coins et sur le connecteur de bord) ;
    - QFP et SO : via sous le boîtier d'abord ; jamais sous le Pico ;
    - via et piste vérifiés à 0,127 mm de tout autre réseau ;
    - plans prolongés dans la languette (vias des contacts de masse).
    DRC des cartes préparées :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
    [cha.kicad_pcb, prog.kicad_pcb]
2026-10-14 PCB : vias vers les plans écartés de toutes les pastilles CMS
    Freerouting refuse un via sur une pastille, même de son réseau.
    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
    [cha.kicad_pcb, prog.kicad_pcb]
2026-10-14 À faire : connecteur carte à carte à la place de la nappe PROG-CHA
    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
2026-10-14 Carte PROG routée (4 couches) : 3 raccordements aux plans restant à la main
    Routage Freerouting en 12 passes, import, raccordements aux plans
    complétés après routage (route.py --patch : via par pastille de masse
    ou +3V3 restée seule, en évitant les pistes routées ; piste sur la face
    de la pastille, ce qui corrige les contacts de masse côté B).
    DRC KiCad : aucune violation d'isolement ni court-circuit ; 3 pastilles
    à relier à la main (X2.2 GND, U12.100 +3V3, C46.1 +3V3) ; le reste =
    sérigraphie et bibliothèque non déclarée dans l'environnement.
    pcb.py : recherche de position des vias élargie (diagonales, 3 mm),
    fonction plane_vias réutilisable.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
    [prog.kicad_pcb]
2026-10-14 Carte CHA routée (4 couches) : 6 signaux et 2 raccordements restants
    Routage Freerouting en 12 passes, raccordements aux plans complétés
    après routage. DRC KiCad : aucune violation d'isolement ni
    court-circuit ; restent 6 lignes du bus P côté droit du FPGA SM (U14)
    et 2 raccordements aux plans (X2.2, U14.100), dans le couloir étroit
    entre le FPGA SM, son oscillateur et l'entretoise H7.
    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
    [cha.kicad_pcb]
2026-10-14 PCB : entretoises H7 et H8 remontées à y = 75 mm
    En (130, 100) et (170, 100), elles bouchaient le couloir de sortie du
    côté droit du FPGA V / SM (6 lignes du bus P et 2 raccordements non
    routés sur la carte CHA). Cartes régénérées, contrôle Freerouting sans
    violation ; nouveau routage en cours.
    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
    [cha.kicad_pcb, prog.kicad_pcb]
2026-10-14 Carte PROG routée : une seule pastille à relier à la main (C46.1)
    Après le déplacement des entretoises H7/H8 : tous les signaux et
    raccordements aux plans routés sauf le +3V3 de C46 (découplage de la
    SDRAM P). DRC : aucune violation d'isolement ni court-circuit.
    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
    [prog.kicad_pcb]
2026-10-15 Carte CHA routée : 3 liaisons restantes (DOTA, GAD0, P4)
    Après le déplacement des entretoises H7/H8 : raccordements aux plans
    complets ; restent DOTA et GAD0 (FPGA C -> 74AHCT16244 U7) et une
    broche P4 du FPGA SM. DRC : aucune violation d'isolement ni
    court-circuit. route.py --continue : reprise d'un routage existant.
    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
    [cha.kicad_pcb]
2026-10-15 route.py : retrait de --continue (Freerouting ne reprend pas un routage importé)
    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
2026-10-15 finish.py : routeur de finition (A* sur grille, arrachage et reroutage)
    Termine les liaisons laissées par Freerouting : grille de 0,1 mm, pistes
    de 0,127 mm à 45° sur les faces externes, vias, obstacles = cuivre des
    autres réseaux gonflé de l'isolement. Une liaison bloquée fait arracher
    les réseaux à deux pastilles qui l'entourent, rerouter ensuite ; un
    tour par processus, DRC entre chaque tour.
    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
2026-10-15 finish.py : premier tour sans arrachage, on garde la meilleure carte
    L'arrachage systématique pouvait dégrader la carte (3 -> 16 liaisons
    restantes sur CHA). Chaque tour n'est conservé que s'il améliore le
    meilleur résultat obtenu.
    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
2026-10-15 PCB : carte PROG entièrement routée ; CHA à 2 liaisons (DOTA, GAD0)
    Routeur de finition : PROG -> dernier raccordement (+3V3 de C46) fait,
    plus aucune liaison manquante ; CHA -> P4 routé (et réseaux voisins
    rerouttés), restent DOTA et GAD0 dont les broches d'entrée du tampon U7
    sont enfermées par les pistes FIXD qui longent sa rangée. DRC des deux
    cartes : aucune violation d'isolement ni court-circuit (restent
    sérigraphie et bibliothèque non déclarée dans l'environnement).
    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
    [cha.kicad_pcb, prog.kicad_pcb]
2026-10-15 CHA : canaux du tampon de sortie U7 groupés par FPGA source
    Couche fixe (FPGA SM) puis sprites (FPGA C), chaque groupe dans l'ordre
    des contacts : les deux groupes ne se croisent plus le long de la
    rangée d'entrée du tampon, où les pistes FIXD enfermaient DOTA et GAD0.
    Broches des FPGA C et SM réoptimisées, carte CHA régénérée (contrôle
    Freerouting sans violation) ; nouveau routage en cours.
    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
    [buffers.kicad_sch, cha.kicad_pcb, cha.kicad_sch, fpga_c.kicad_sch, fpga_p.kicad_sch, fpga_sm.kicad_sch, fpga_v.kicad_sch, mcu.kicad_sch]
2026-10-15 Doc : fréquences des FPGA C et SM après regroupement des canaux de U7
    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
2026-10-15 Carte CHA entièrement routée
    Après regroupement des canaux de U7 : routage Freerouting en 12 passes
    puis raccordements aux plans, plus aucune liaison manquante. DRC :
    aucune violation d'isolement ni court-circuit (restent sérigraphie et
    bibliothèque non déclarée dans l'environnement). Les deux cartes sont
    routées.
    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
    [cha.kicad_pcb]
2026-10-15 Pico 2, microSD et bouton sur la carte PROG ; pistes d'alimentation larges
    - La carte PROG est côté avant de la cartouche, composants vers l'avant :
    lecteur microSD et bouton accessibles. Le câble PROG-CHA porte
    désormais le bus de liaison C/SM ; connecteur au même endroit sur les
    deux cartes (x = 172 mm), prêt pour un connecteur carte à carte.
    - Sous le Pico : ni piste ni via sur la face composants (pastilles de
    test nues sous le module).
    - Classes de réseaux écrites dans le .kicad_pro : +5V et VSYS en 0,5 mm,
    +1V2 en 0,3 mm.
    - Broches des FPGA réoptimisées ; contrôle Freerouting sans violation ;
    routage des deux cartes et vérification de timing en cours.
    Co-Author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
    [buffers.kicad_sch, cha.kicad_pcb, cha.kicad_sch, fpga_c.kicad_sch, fpga_p.kicad_sch, fpga_sm.kicad_sch, fpga_v.kicad_sch, mcu.kicad_sch]
2026-10-15 Doc : Pico 2, microSD et bouton sur la carte PROG
    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
2026-10-15 PCB : connecteur de bord biseauté déclaré dans l'empilement
    Empilement 4 couches 1,6 mm, finition ENIG, « edge_connector
    bevelled » (repris par KiCad dans le .gbrjob : EdgeConnectorBevelled)
    et note de fabrication sur Cmts.User. Appliqué à la génération
    (pcb.py) et après import du routage (route.py).
    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
2026-10-15 Makefile : 24 graines de placement-routage par défaut
    Le FPGA P, le plus chargé, ne tient 100 MHz qu'avec certaines graines
    (101,4 MHz trouvé entre les graines 9 et 24 après le déplacement du
    Pico) ; la boucle s'arrête à la première qui passe.
    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
2026-10-15 Carte PROG routée avec le Pico 2, la microSD et le bouton
    Routage Freerouting, raccordements aux plans et routeur de finition ;
    empilement et biseau du connecteur de bord ajoutés.
    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
    [prog.kicad_pcb]
2026-10-15 finish.py : pastilles traversantes, lissage des tracés
    Les pastilles traversantes du rapport DRC (sans couche) n'étaient pas
    reconnues ; les escaliers de la grille sont remplacés par des segments
    droits quand la vue est dégagée.
    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
2026-10-15 finish.py : cible = forme réelle de la pastille (HitTest)
    Une pastille ronde ne remplit pas son rectangle englobant : un tracé
    arrêté dans un coin restait sans contact (CRESET_N vers le câble).
    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
2026-10-15 finish.py : lissage sûr, meilleure carte jugée aussi sur les violations
    Segments droits vérifiés sur les obstacles grossis d'une cellule (une
    piste de CRESET_N passait à 0,115 mm d'un via). Le meilleur tour est
    celui qui minimise liaisons manquantes + violations de cuivre : une
    passe à marge réduite ne peut plus dégrader la carte.
    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
2026-10-15 Carte CHA : une seule liaison restante (+5V de U8, broche 31)
    Routeur de finition (grille 0,05 mm, pistes de 0,1 mm, marge 0,03) :
    CRESET_N et C_SD_DQ7 reliés, aucune violation de cuivre.
    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
    [cha.kicad_pcb]
2026-10-15 Carte CHA entièrement routée (dernière liaison : +5V de U8)
    Sous U8 (2 canaux utilisés sur 16), les vias de masse des entrées
    inutilisées enfermaient la broche 31 (+5V). La broche 32 (masse) est
    reliée à sa voisine 33 au lieu d'avoir son propre via, ce qui libère
    le passage ; +5V routé par le routeur de finition. DRC des deux cartes :
    aucune liaison manquante, aucune violation de cuivre.
    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
    [cha.kicad_pcb]
2026-10-15 Régulateur 3,3 V à découpage, horloge SDRAM adaptée côté FPGA, U8 en 74AHCT125
    - AP63203 (TSOT-23-6, sortie fixe 3,3 V, ~90 %) à la place de
    l'AMS1117 : ~0,15 W de pertes au lieu de ~0,75 W et moins de courant
    tiré sur le 5 V de la console ; L 4,7 µH, Cin 10 µF, Cout 2 x 22 µF.
    - Résistance série de 33 ohms de l'horloge SDRAM déclarée avec le FPGA :
    placée à 2,7 mm de sa broche (au lieu de ~30 mm, côté SDRAM).
    - CHA : U8 (16244 pour 2 canaux) remplacé par un 74AHCT125.
    Cartes replacées, contrôle Freerouting sans violation ; routage des
    deux cartes et vérification de timing en cours.
    Claude-Session: https://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
    [buffers.kicad_sch, cha.kicad_pcb, cha.kicad_sch, fpga_c.kicad_sch, fpga_p.kicad_sch, fpga_sm.kicad_sch, fpga_v.kicad_sch, mcu.kicad_sch]
2026-10-15 Doc : fréquences des FPGA avec les broches du dernier placement
    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
2026-10-15 Carte PROG routée (régulateur à découpage, horloges SDRAM adaptées côté FPGA)
    DRC : aucune liaison manquante, aucune violation de cuivre.
    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
    [prog.kicad_pcb]
2026-10-15 Carte CHA routée : une seule liaison restante (SDA4)
    Routage complet (régulateur à découpage, horloge SDRAM adaptée côté
    FPGA, U8 en 74AHCT125) puis routeur de finition. DRC : aucune
    violation de cuivre ; reste SDA4 (U14.37 -> U3.20).
    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
    [cha.kicad_pcb]
2026-10-16 CHA : canaux des tampons d'entrée groupés par FPGA de destination
    SM seul (bus Z80, PCK2B, 2H1) à gauche, bus P0-P15 au milieu, C seul à
    droite, chaque groupe dans l'ordre des contacts : le faisceau SDA entre
    le FPGA SM et U3 ne se croise plus avec les signaux du FPGA C (SDA4
    restait non routable). Carte CHA replacée, broches réoptimisées,
    contrôle Freerouting sans violation ; routage en cours.
    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
    [buffers.kicad_sch, cha.kicad_pcb, cha.kicad_sch, fpga_c.kicad_sch, fpga_p.kicad_sch, fpga_sm.kicad_sch, fpga_v.kicad_sch, mcu.kicad_sch]
2026-10-16 Carte CHA entièrement routée ; les deux cartes sont routées
    Après regroupement des canaux des tampons d'entrée : routage complet
    puis routeur de finition, aucune liaison manquante, aucune violation de
    cuivre. FPGA C 106,2 MHz, SM 112,4 MHz.
    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
    [cha.kicad_pcb]
2026-10-22 Menu : pied de page dans la zone visible, vidéo de démonstration
    Le menu écrivait le compteur, l'aide et les messages sur les lignes 30 à
    32 de la couche fixe, que la Neo Geo n'affiche pas (seules les lignes 2 à
    29 le sont) : 20 entrées par page au lieu de 24. Pendant le chargement
    d'un jeu, la liste laisse place au nom et à la barre de progression ;
    compteur « 17/30 » sans espaces. Tests de l'émulateur : lignes
    invisibles vides, message de chargement visible.
    tools/menu_demo.py filme le vrai menu dans l'émulateur (MP4).
    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
    [test_menu_emu.py]
2026-10-22 ROM de test SDAES et vidéo de démo jusqu'au jeu
    testrom/68k : petit jeu libre (couche fixe) à charger depuis la carte SD
    pour valider une cartouche : somme de la ROM P (inscrite en 0x13A par
    neotool romsum), test de la RAM de travail, barres de couleur, compteur
    d'images, manette 1, START/SELECT, texte défilant. make sdaes_test.neo.
    neotool : commande romsum, option font --solid (tuile pleine).
    Tests de l'émulateur : contrôles OK, ROM corrompue détectée ; garde
    contre un 68000 bloqué.
    menu_demo.py : rendu avec les vraies ROM S, couche fixe figée à chaque
    image ; après la bascule, reset et démarrage de la ROM de test.
    Cla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
    [test_menu_emu.py]
